Kubudak90/openduck-tr/docs/workflow/openduck-tr/review-komut.md

# Review: Spec eki K (sesli komut katmanı)

Codex MCP bu oturumda bağlı değil. İnceleme, ana spec incelemesindeki yöntemle aynı bağlam paketi kullanılarak üç
bağımsız inceleyiciyle yapıldı:
- donanım, elektrik, akustik ve BOM;
- RL ve simülasyon;
- kapsam, kabul ve firmware devri.

Format zorunluydu: `[SEV] itiraz + somut senaryo + öneri`. Ham itirazlar: `research/review-komut-r1.json`.

## Tur 1: 43 itiraz (2 critical, 30 major, 11 minor) → kararlar

| İtiraz | SEV | Özet | Karar | Ek v2'ye etkisi / gerekçe |
|---|---|---|---|---|
| R1 | critical | K6.1 adds the gestures to the HEAD_RANDOM sampling, so they become head_target and pass through the existing first-order head filter (filter_tau 0.5 s at 50 Hz: TASK.md main step 2, and the tr35 HEAD_RANDOM in the core config). Th… | **Kabul** | K6.1: filtreyi atlayan jest kanalı, yükseltilmiş kosinüs zarf, slew assert, rastgele hedef jestte 0. |
| R2 | major | K6.2 runs the supervisor inside main training, and main is trained on MJX/Brax (P7/P9). K5 defines rl/commands.py as a firmware-copied state machine (queue, timers, IMU yaw integral, random word and latency draws) with CPU-only un… | **Kabul** | K6.2: denetleyici bölümleri kaldırıldı; xp-genel komut atomları sample_segment içinde; commands.py numpy (eval/play/firmware). |
| R3 | major | S1 chains a seated stand-up, about 35 s of walking and turning, and a sit, yet it has the same threshold as one A5 transition (point ≥ 95 %, W-lower ≥ 90 %). S2 allows only 2 falls in 256 episodes of 20 random words. A policy that… | **Kabul** | K7: S1 eşiği bileşenlerden türetildi (nokta ≥ %85, W-alt ≥ %80). |
| R4 | major | "main kalkış/oturuş bitince" and "rampa bitince" are undefined. Read as the reference ramp (alpha reaching 0 or 1, h_ref reaching h_cmd), they finish on the command side in 2.83 s or 0.66 s whatever the body does. S1's "every step… | **Kabul** | K5 T1/T2: IMU ile fiziksel tamamlanma, A5 pencereleri, bir yeniden deneme, sonra DÜŞMÜŞ. |
| R5 | major | The fall detector ("same threshold as TERMINATION_MAX_GRAVITY_Z, from the IMU observation") is a third definition, next to C.SUPERVISOR (fall_gz −0.6, fall_steps 6 in tr35) and play.Supervisor. A6's handover is measured with play.… | **Kabul** | K5: play.Supervisor mantığı commands.py'ye; C.SUPERVISOR debounce; oturuşta duruşa göre eğim. |
| R6 | major | A10 needs the getup handover in the same rollout. The existing handover eval (tr35_handover) does this by running main on the getup model variant, where the EXTRA leg boxes collide with the floor (contype 0, conaffinity 1). main w… | **Kabul** | K6.4: A10 main varyantında, düşmede tr35_handover ile getup varyantına; EXTRA temas kararı P5b'de, P7'den önce. |
| R7 | major | The module's location and mass go into the MJCF. The addendum leaves placement to P2d without ordering it against G-CAD, P5b and P7, and it lets G-SES (a bench gate that runs after G-CAD) move the module ("first try placement and … | **Kabul** | K3/K9: P2d G-CAD'den önce; kütle şimdi kafaya yazılır; G-CAD sonrası yer değişmez. |
| R8 | minor | The claim is false. The main actor observation (53 values) holds only the head joint q/qd measured by the pots, not the targets. The beak is neither measured nor observed: sensors.py says "Gaga olculmez (gozlemde de yok)", and P5a… | **Kabul** | K6.1: gözlem değişmez; jest pot q/qd ve IMU ile hissedilir, gaga gözlenmez. |
| R9 | minor | The wake tick fires on every "ördek", and vak is allowed in every state except DÜŞMÜŞ. Training moves the beak only in stand and walk segments (K6.1), and getup never sees beak motion. | **Kabul** | K4/K5: uyanma işareti LED; vak M'de ≤ 15°, O/K/F'de red; gaga şablonu oturuş segmentlerinde de; A8 A10'a eklendi. |
| R10 | minor | "h changes with main's existing 2.83 s ramp" is wrong. 2.83 s is SIT/STAND_RAMP_S, the ramp for alpha. h_ref follows the command at H_RATE = 0.02 m/s, which tr35_constants does not rescale. One ΔH step is also about as large as th… | **Kabul** | K4: H_RATE ile; ΔH = (H_HOME − H_MIN_WALK)/2; S1 ölçütü ≥ 0.5·ΔH. |
| R11 | minor | A single p90 inside [0.7, 1.3] does not bound the low tail. The addendum also does not say when the turn error is measured, or whether "distance" means path length or displacement. | **Kabul** | K7: başlangıç yönünde yer değiştirme, p10 ≥ 0.7 ve p90 ≤ 1.3; dönüş hatası bitişten 1 s sonra. |
| R12 | minor | Recognition latency only shifts when a command is applied. The policy never observes it, and no A10 metric depends on it: gel is timed and the turn ends on the IMU, both from the moment of application. So the DR tests nothing, yet… | **Kabul** | K6.3: gecikme DR'ı yalnız eval; yeni ölçüm yeniden eğitim gerektirmez; dur duruş mesafesi ölçütü. |
| R13 | minor | The turn stops on the integral of the sensor-model gyro, whose bias is U(±0.01 rad/s) after power-on calibration. On the robot the IMU sits 1.8 mm in front of the buck (P2b) and warms up after boot, so the bias the sim validates i… | **Kabul** | K5: sıfır hız bias güncellemesi; A10 duyarlılık koşusu ±0.04 rad/s. |
| S1 | major | Jest şablonları 'HEAD_RANDOM örneklemesine' eklenirse kafa hedefi env'deki birinci derece filtreden geçer (spec 3.2.5 ve tr35_constants: filter_tau 0.5 s; env_cpu: head_offset += (target − offset)·CTRL_DT/τ). Ayrık filtrenin kazan… | **Kabul** | R1 ile aynı karar; gaga ayrı kanal. |
| S2 | major | Durum × komut tablosu eksik ve deterministik değil. - Kural 2 yalnız OTURMUŞ'u kapsıyor. OTURUYOR ve KALKIYOR'da gelen kalk, otur, gel, dön ve dur için davranış tanımsız: komut yok mu sayılır, kuyruğa mı girer, rampayı ters mi çev… | **Kabul** | K5: 8 durum × 13 olay tablosu; birim testler satır satır. |
| S3 | major | Düşme algılayıcısında dört sorun var.  1. **Ayrı ve debounce'suz tanım.** 'TERMINATION_MAX_GRAVITY_Z ile aynı eşik' deniyor, ama ardışık adım beklemesi (debounce) yok. Mevcut çalışma zamanı süpervizörü (play.py Supervisor, meta["s… | **Kabul** | K5: tek düşme kaynağı; getup 2 deneme sonra BEKLE; dur getup'ı keser. |
| S4 | major | S2'nin düşme eşiği (W-üst ≤ %3, N = 256) maruziyete göre A4 ve A5 ile çelişiyor. - **A4:** N = 512 ve 20 s'lik bölümlerde W-üst ≤ %3, en çok 7 düşmeye izin verir (bölüm başına %1.37). - **S2:** N = 256'da W-üst ≤ %3 ancak en çok 2… | **Kabul** | K7 S2: düşme 20 s maruziyete normalize; geçiş düşmeleri A5 eşiğiyle; ayrı devir kategorisi. |
| S5 | major | S1 ölçütleri test edilemez ya da tekrarlanamaz.  (a) **Zaman çizelgesi yok.** Kelimeler arası süre yazılmamış; yalnız 'gel (8 s)' var. Sonraki kelime önceki adım bitince mi, sabit aralıkla mı verilir? 8 s kelimeden mi, uygulamadan… | **Kabul** | K7: zaman çizelgesi (tamamlanmadan 1.0 s sonra), gel/dönüş tanımları. |
| S6 | major | commands.py hem eğitime hem firmware'e 'tek tanım' olacak, ama ikisi için de eksik tanımlanmış.  **Eğitim tarafı.** K6.2 denetleyiciyi main eğitimine sokuyor; P7/P9 eğitimi MJX + Brax PPO ile jit/vmap altında RunPod'da koşuyor. Py… | **Kısmen** | Altın izler ve yalnız firmware sinyalleri kabul. Denetleyici eğitime girmediği için (R2) xp-genel/MJX sürümü gerekmez. |
| S7 | major | **Ana spec ile çelişki.** Ana spec §2 'Kafa elektroniği (kamera, hoparlör, ToF)' öğesini kapsam dışı sayıyor. DF2301Q kafa kubbesine konursa kafa elektroniği olur, üstelik kartta bir hoparlör taşır. Ekin kendi kuralı 'Çelişki çıka… | **Kabul (kafa)** | §2 istisnası yazıldı. Varsayılan trunk önerisi H3 kanıtıyla reddedildi: trunk'ta yer yok. |
| S8 | major | **Robot kütlesinin sert sınırı hesaba katılmamış.** - P2c raporunda robot toplamı 1845.4 g (×1.05 = 1938 g). acik-konular.md'de 1847.9 g → 1940 g, 'sınırın 10 g altında'. - Modül 12 g, teller yaklaşık 2.5 g eklerse: (1845.4 + 14.5… | **Kabul** | K3.1: modül aşağıdan yukarı kütlede; G-CAD ≤ 1950 g, aşarsa merdiven. |
| S9 | major | G-SES denemesi gerçek kullanımı temsil etmiyor.  (a) **Yanlış servolar test ediliyor.** Yük testi '6 DS servo' ile yapılıyor. Oysa mikrofona en yakın gürültü kaynakları head linkindeki head_roll MG90S ve gaga SG90 ile head_turn'de… | **Kabul** | K8: gürültüde MG90S + SG90 + DS; protokol ördek → LED → komut; 1.3/1.8 m. |
| S10 | major | G-SES kapısının eşikleri istatistik olarak zayıf ve tehlikeli karışmaları görmüyor.  (a) **Kelime başına mı, havuzda mı?** '≥ %90' belirsiz. Havuzda 216/240 geçerken tek bir kelime 15/20 = %75'te kalabilir; bu kelime dur olabilir.… | **Kabul** | K8: kelime başına ve havuz eşikleri, karışma çiftleri, 30 dk uyanık test, Poisson sınırı. |
| S11 | major | Plan etkisinde sıra ve bağımlılık eksik.  (a) **P2d tamamlanmış P2c'yi yeniden açıyor.** P2c bitti (200.2 g, tests/cad 88/88, check.py 0); P2d kafa kubbesini yeniden açar. P2d hem G-CAD'deki kütle/COM dondurmasından hem P5b türetm… | **Kabul** | K9: P5k şimdi; P2d → P3 → G-CAD; ölçümler Adım 0 alımında. |
| S12 | major | Kullanıcıya dönük davranışta dört boşluk var.  (a) **Yok sayılan komut sessiz.** Hoparlör kapalı, modülün mavi LED'i kabuğun içinde. Kullanıcı OTURMUŞ'ta 'evet' ya da dönüşte 'eğil' dediğinde, komutun tanınmadığını mı yoksa redded… | **Kabul** | K5: red işareti (LED + çift tık), pencere bitişi LED; sim uyanma modeli; gel zaman aşımı 10 s. |
| S13 | minor | Kural 5'teki 'h, main'in mevcut 2.83 s rampasıyla değişir' ifadesi yanlış. 2.83 s, alpha'nın SIT_RAMP_S/STAND_RAMP_S rampası. h_ref ise h_cmd'yi H_RATE = 0.02 m/s hızıyla izler (posture_step); bu hız tr35'te ölçeklenmiyor. Stub de… | **Kabul** | R10 ile aynı. |
| S14 | minor | (a) **Jestler gereksiz yere walk'a ekleniyor.** K6.1 jestleri walk politikasına da ekliyor. Denetleyicinin çıktısı yalnız main / getup; walk sesli katmanda hiç kullanılmıyor. Bu değişiklik walk'ın A4 ölçütlerini, 'main takip ödülü… | **Kabul** | K6.1: jestler yalnız main; vak M'de ≤ 15°, gaga şablonu oturuşta; jaw çifti P5b listesinde. |
| S15 | minor | ID'ler K4'te sabit 5–16 olarak kabul ediliyor. Oysa DF2301Q ID'leri öğrenme sırasına göre veriyor. Yeniden öğrenme akışı ('önce sil') doğrulanmamış (voice-research 1.1). Sabit ID tablosu da cihaz cihaz değişmiş (DFRobot forum 4018… | **Kabul** | K4: kimlik tablosu yapılandırma dosyası, beyaz liste, doğrulama adımı. |
| H1 | critical | Ek 1.171,86 TL'lik yeni zorunlu satır ekliyor, ama bugünkü BOM toplamını ve kalan payı vermiyor. Son hesaplanan toplamlarla iki tavan da aşılıyor. "Bütçe tavanı değişmez, P3 yeniden hesaplar" ifadesi A2'nin düşmesini P3'e erteliyo… | **Kullanıcıya** | Bütçe kararı kullanıcının (K10). |
| H2 | major | Tercih edilen kafa yerleşiminin ilk koşulu ("kafa kütle bütçesi ... modülle birlikte tutmalı") yapısı gereği tutmaz. P2c kafası 202,0 g bütçeye karşı 200,2 g, yani pay 1,8 g. P2d tercih edilen yeri bir bütçe kaydı yüzünden reddede… | **Kabul** | K3.1: trunk'tan kafaya 20 g (202 → 222 g); MG90S ≤ 0.5·stall. |
| H3 | major | Yedek yer olan "trunk arka üstü" donmuş K_T içinde yok. K_T dışında ise kafanın süpürme bölgesinde kalıyor. K_T'yi değiştirmek bir arayüz değişikliğidir (ICR), P2d'nin kendi kararı değil. | **Kabul** | K3: trunk seçeneği kaldırıldı; tek yer kafa. |
| H4 | major | Kafa kubbesi "bacak servolarından uzak" olduğu için seçiliyor; oysa mikrofona en yakın gürültü kaynakları kafanın kendi servoları. Kabuk açıklığı için sızdırmazlık ve titreşim yalıtımı tanımlanmamış. | **Kabul** | K3.3: conta, beşik/gromet, köpük kart çevresine, mesafe raporu; G-SES'te kafa servoları. |
| H5 | major | G-SES Adım 0'da yürütülemez; yürütülse bile gerçek yerleşimi temsil etmez. "DF2301Q kalır" kararı, P2d CAD'inden önce ve temsil gücü olmayan bir testle verilmiş oluyor. | **Kısmen** | G-SES a/b ayrımı kabul. Hoparlörden kayıtlı gürültü yerine Adım 0'ın gerçek MG90S/SG90/DS'si kullanılır (daha temsilî). |
| H6 | major | Yanlış tetik ölçümü yalnız uyku durumunu kapsıyor; asıl tehlikeli olan, uyanık pencerede servo gürültüsünün ürettiği yanlış komut ölçülmüyor. ≤ 1/10 dk ölçütü istatistik olarak zayıf. Uyandırma + komut zinciri ve uzun süreli çalış… | **Kabul** | K8: uyanık pencerede 30 dk, zincir ölçütü, Poisson. Pil süresi koşusu G-SES-b'ye kaldı. |
| H7 | major | Öğrenilmiş Türkçe kelimelerde karışma riski en yüksek olan çiftler zıt hareketler. Kapı ölçütünün toplam mı kelime başına mı olduğu belli değil; karışma matrisi ve konuşmacı bağımlılığı ele alınmıyor; boş 5 slot kullanılmıyor. | **Kısmen** | Kelime başına ve karışma kabul; boş kimliklere ikinci şablon kabul. N kelime başına 20 (kullanıcı süresi ~1.5 sa); 40 yerine Wilson havuz eşiği. |
| H8 | major | Uyandırma akışının zamanlaması doğrulanmamış davranışlara dayanıyor. "ördek, gel" tek nefeste söylenirse komut modül uyanmadan gelir. Onay tıkı tam komut penceresinde gürültü üretir. 15 s pencerenin geçerli komutla yenilenip yenil… | **Kabul** | K4/K8: LED birincil işaret; aralıksız ve işaretli biçim; pencere yenilenmesi, NOTIFY ve kalıcılık ölçülür. |
| H9 | major | Modül kafadaysa 4 tel yalnız boyun geçişinden değil, dört eklem geçişinden geçer. Demet çapları donmuş arayüzdür; ek bunu P2d'nin yerel güncellemesi gibi yazıyor. | **Kabul** | K3.6: dört geçişin yeni çapları ICR olarak; 30 AWG, bükülü çift, burulma taraması. |
| H10 | major | Revizyon ve ölçüler doğrulanmadan CAD donuyor. P2d yerleşimi ve kabuk deliklerini P3'ten önce yapıyor, oysa ek kütle ve yüksekliğin "P3'te tartılıp ölçüleceğini" söylüyor. Delik deseni V1.1'e sabitlenmiş, yedek kaynağın görseli is… | **Kabul** | K3: modül şimdi alınır, ölçülür; beşik iki revizyona uygun; ölçü yoksa muhafazakâr zarf. |
| H11 | major | ID → komut haritası rl/commands.py'de sabit (5 = gel … 16 = vak). Oysa kimlikler öğrenme sırasıyla atanıyor ve tek bir kelime yeniden öğretilince hangi kimliği alacağı bilinmiyor. 12 komut dışındaki kimliklerin nasıl işleneceği de… | **Kabul** | K4: kimlik tablosu, beyaz liste, 200–208 uyarısı. |
| H12 | major | 3,3 V / 5 V kararı ölçüm yapılmadan P3'e bırakılmış ve 3,3 V ray bütçesi yazılmamış. 5 V için öngörülen TX bölücüsü, TX zaten 3,3 V ise bağlantıyı bozar. Modülün RX eşiği hiç ele alınmamış. "(hoparlör açık)" niteliği kaynakta yok. | **Kabul** | K3: 5 V ayrı dal; seviye ölçülen TX'e göre; akım ve RX ölçümü G-SES-a'da. |
| H13 | major | "ESP32-S3'ün boş bir UART'ı" pin atamasını vermiyor. Çevre birimi olarak UART1/2 boş, ama robot pin haritasında çakışmasız boş pin neredeyse yok ve kayış (strapping) pinleri dışlanmamış. | **Kısmen** | Kısıtlar kabul (kayış pinleri ve 43/44 yasak, 1 kΩ). Pin seçimi P6 ekinde pin haritasıyla birlikte; tezgâh aynı pinleri kullanır. |
| H14 | minor | Dönüş, gyro z integraliyle ölçülüyor. Simdeki gyro bias DR'ı, açılış kalibrasyonundan sonra ±0,01 rad/s; ama IMU buck'a 1,8 mm uzakta ve ısınıyor. Donanımdaki sapma simdekinin birkaç katı olabilir ve A10 S1 bunu göstermez. | **Kabul** | R13 ile aynı. |
| H15 | minor | Ana spec §2 "Kafa elektroniği (kamera, hoparlör, ToF)" maddesini kapsam dışı sayıyor. Ekin tercih ettiği yer, hoparlörü kartta kalan bir elektronik modülü kafaya koyuyor. Ekin kendi öncelik kuralına göre ("çelişki çıkarsa ana spec… | **Kabul** | S7 ile aynı. |

## Tur 2 (son tur): 27 itiraz (critical yok, 17 major, 10 minor) → kararlar

Yeni critical itiraz çıkmadığı için aşama bitti. Tur 1 kararlarından v2'de eksik uygulanmış bulunanlar v3'te
tamamlandı: LED, P6 eki ön koşulu, jaw çifti, G-SES-b, R1 sönümleme, R4 gerçek durum puanlaması, R5 eğitim
sonlandırması, R12 kelime bitişinden ölçüm, bias eşiği, Ö durumu ve B tanımı. Ham liste:
`research/review-komut-r2.json`.

Eksik uygulanan tur 1 kararları:
- R12 (Kabul: 'dur duruş mesafesi ölçütü'). K7 measures the dur stopping distance 'uygulamadan duruşa' (from application). R12 asked for 'from the end of the spoken word to standstill', so the latency is part of what is measured. Every other A10 metric (gel rati…
- S14 (Kabul: 'jaw çifti P5b listesinde'). The K9 P5b item only says 'P5k on the final MJCF; move A10 to the final model'. It does not add P2c's jaw–neck contact pair (the open ICR) to the P5b self-collision pair list. Meanwhile K5 still allows vak in OTURMUŞ (≤…
- R9 (Kabul: 'gaga şablonu oturuş segmentlerinde de'). K6.1 says this, but the same bullet list says 'Alpha kapısı rastgele ofsetle aynıdır' (alpha < ALPHA_STAND_MAX = 0.01). If that gate also covers the mouth channel, the beak is zeroed in every sit segment (al…
- S12 + H8 (R9'daki uyanma işareti de buna bağlı). Karar şuydu: red işareti LED + çift tık, pencere bitişi LED, LED birincil işaret (H8'in önerisi ESP32'nin sürdüğü bir LED idi). v2 K3.5 bunu modülün kendi mavi durum LED'iyle yapıyor ve 'ek parça gerekmez' diyor…
- H5 (kısmen) / S9. Karar, G-SES-a gürültüsünü Adım 0'ın gerçek MG90S + SG90 + DS'siyle üretmekti. tools/bench/bench/bench_main.cpp yalnız tek bir PCA kanalı sürüyor (C.ch). K9'daki P6 eki yalnız şunları ekliyor: UART okuma, kimlik zaman damgası, senkron tık ve …
- S14. Karar metni 'jaw çifti P5b listesinde' diyor. v2'de bunun karşılığı hiçbir yerde yok (K6, K9'daki P5b satırı): ne jaw–neck / jaw–trunk temas çifti (P2c ICR'si) ne de 'head_pitch > 50° iken mouth ≤ 25°' kilidi.…
- H6. Karar, pil süresi koşusunu ve koşu sonu canlılık kontrolünü G-SES-b'ye bıraktı. v2 K2, G-SES-b'yi yalnız 'robot üstünde son yerleşimle tanıma testi' olarak tanımlıyor. Ertelenen koşu ekte hiçbir yere yazılmamış, bu yüzden kaybolur.…
- R1: v2 still does not say how a running gesture stops without a position step. The table only says dur 'jest kesilir', and otur and a fall act through the alpha gate. This is the gap R1 raised. The S1 amplitude measure also lost R1's 'pot q peak-to-peak vs tem…
- R4: A10 scores each step with the controller's own IMU completion (K7: 'K5'in fiziksel ölçütleriyle'). R4 proposed A5's true-state success rules (standup_z, stand_gz, windows). The T2 condition gz_obs < seat_gz (−0.245 on the stub) is met by almost any pose th…
- R5: the note to P5b is missing. Main's training termination still uses the fixed gz > −0.6 rule. A seated stub has gz −0.643, and the seated bank's ±5° tilt crosses −0.6. v2 changes only the runtime detector.…
- R12: K7 measures the dur stopping distance from application. R12 proposed measuring from the end of the spoken word. The latency part that motivated R12 (up to 1.5 s × 0.136 m/s = 0.20 m) is therefore excluded, while the 0.3 m threshold stayed.…
- R13/H14: the zero-velocity bias update uses |gyro| < 0.02 rad/s, which equals sensors.IMU gyro_sigma (0.02 per axis, uniform ±0.035). It essentially never fires in sim, so the accepted fix does not work (see 2S5).…
- S2: the exact S2 case, a word arriving during the 'dur + 1.0 s' settle before sitting, still has no column. The O→M completion cell does not say what happens to a command queued in O (see 2S6).…
- S3: item 4 (commands that arrive during handoff_zero_cmd_s after the handover) is not addressed: F→A accepts them at once. BEKLE's output 'tut' is left undefined, although S3 asked for a defined hold (HOME hold or torque off) (see 2S9).…
- S11(e): K9 does not make the P6 bench-script addendum a prerequisite of Adım 0 / G-SES-a, although K8 needs it.…
- S14(c): the decision table says 'jaw çifti P5b listesinde', but v2 has no jaw–neck or jaw–trunk contact-pair item for P5b.…
- H6(c): v2 has no firmware liveness check for a silent module ('stops working after a few minutes'; begin() returns true with no module attached).…
- H8: H8 asked for an ESP32-driven LED visible through the shell. v2 (K3.5) uses the module's own status LED, which no known API lets the host blink. The K5 red blink and the 'LED durumu' output therefore cannot be implemented (see 2S8).…

| İtiraz | SEV | Özet | Karar ve ek v3'e etkisi |
|---|---|---|---|
| 2R1 | major | T1 (kalkış tamamlandı) cannot complete inside its own 3.4 s window. alpha reaches 0 only at the end of the stand ramp: tr35 STAND_RAMP_S = 2.5·√1.282 = 2.83 s, which is 142 control steps or 2.84 s bec… | Kabul: T1 ilk sağlanma ≤ 3.4 s + ready_hold_s, sert sınır ≈ 3.9 s; S1 otur/kalk A5 gerçek durum kurallarıyla. |
| 2R2 | major | The zero-velocity gyro-bias update is gated on '/gyro/ < 0.02 rad/s for ≥ 1 s'. That threshold is at or below the sensor model's own noise floor, so in simulation the update never fires. This is worst… | Kabul: bias güncellemesi dağılım ölçütüyle (std < 2σ, bacak qd, sıfır komut); gerçek sensör modeliyle test. |
| 2R3 | major | In KALKIYOR the new fall rule ('tilt > 35° from pitch_ref(alpha)') fires on the main stand-up failure mode, which R4 described as rocking back onto the seat. That happens before the timeout-and-retry … | Kabul: O/K/M'de düşme, hem pitch_ref hem oturuş pozundan > 35°; oturuşla uyumlu duruş başarısız kalkış. |
| 2R4 | major | The gesture channel has no smooth stop, and its gate is self-contradictory. K4/K5 say 'dur … jest kesilir' (immediately), and K6.1 gives gestures 'the same alpha gate as the random offset'. Because th… | Kabul: tek xp-genel jest fonksiyonu; kapı yalnız başlangıçta; 0.25 s sönümleme; hız toplam çıktıda. |
| 2R5 | major | 'Her oturuştan önce ≥ 1 s ayakta segment' makes every trained sit start from h = H_HOME. The stand segment sets h = H_HOME (TASK.md, sample_segment), and a sit keeps the previous h. The pre-v2 sampler… | Kabul: "tut" segmenti önceki h ile; çömel → otur korunur; otur A'da 1.0 s kuralını bekler; uniform kullanımı yazıldı. |
| 2R6 | minor | The S1 gesture and height criteria are not well defined. A raised-cosine envelope over the whole 2-cycle gesture means the commanded peaks are only 0.146, 0.854, 0.854 and 0.146 of the table amplitude… | Kabul: Tukey zarf; ölçüt ortadaki çevrimin tepeden tepeye oranı, p10; eğil/yüksel 1 s sonra, p10. |
| 2R7 | minor | A6's handover and A10's handover now run different contact setups. K5 says 'A6 devri bu IMU tabanlı algılayıcıyla yeniden koşulur'. But the existing tr35_handover (P5a deploy branch rl/eval_tasks.py ~… | Kabul: A6 devri A10 düzeneğinde yeniden; kopya anı EXTRA–zemin girişimi kaydı. |
| 2H1 | major | v2 kullanıcıya verilen bütün görsel geri bildirimi modülün kendi mavi LED'ine bağlıyor: uyanık pencere, red ve pencere bitişi. Ayrıca 'ek parça gerekmez' diyor. ESP32 bu LED'i süremez, çünkü DF2301Q'n… | Kabul: ESP32 sürümlü kafa LED'i (5. iletken); modül LED'i ikincil. |
| 2H2 | major | 30 dk'lık uyanık pencere yanlış komut testi, modülün gerçekten uyanık kaldığını ölçmüyor. 'Pencere 255' ayarı en çok 255 s sürer. Pencerenin yenilenmesi tek bir forum anekdotuna dayanıyor: UART'tan he… | Kabul: uyanık süre doğrulanır (NOTIFY ya da fototransistör), canlılık kontrolleri, "ölçülemedi" sonucu. |
| 2H3 | major | Hoparlör hem setMuteMode(1) ile hem de SPK anahtarıyla susturuluyor: anahtar SPK2'ye alınıyor ve oraya hoparlör bağlı değil. Ayrıca sökülmesinin kazancı tartılıyor. DF2301Q'da öğrenme ve silme akışı s… | Kabul: hoparlör kartta, SPK1 sabit, yazılımla susturma; öğrenme modu; istem duyulabilirliği testi. |
| 2H4 | major | ICR neck demetini d 5 → 6 mm yapıyor ama donmuş geçiş noktasını (33.33, −34.4, 41.54) değiştirmiyor. Bu durumda demet boyun U-link'inin A kolunun dış yüzüne 0 mm açıklıkla dayanır. P2c'de A kolunun dı… | Kabul: çap gerçek iletken listesinden, ≥ 0.4 mm açıklık, gerekirse geçiş noktası kaydırılır; P2d'ye dosya yetkisi. |
| 2H5 | minor | Mikrofon contası 'TPU' olarak tanımlanmış; projede kullanılan TPU 95A (spec §3.1). 95A TPU akustik frekanslarda neredeyse rijittir. Conta, kartı servoları taşıyan kabuğa tam kapsülün yanında bağlar ve… | Kabul: yumuşak conta (PORON / ≤ 40A silikon), beşik f_n ≤ 100 Hz. |
| 2H6 | minor | Trunk'tan aktarılan 20 g, v2'nin kendi eklediği parçalar sayılınca neredeyse sıfır paya iniyor. Ayrıca zarf, konnektör fişini ve kablo çıkışını içermiyor. | Kabul: aktarım 30 g (kafa 232 g); yan kalemler ayrı satır; fiş yer ayırma kutusu ya da doğrudan lehim. |
| 2H7 | minor | BOM satırı yalnız modülü ve kargoyu sayıyor. v2 yeni zorunlu kalemler ekliyor ama bunları listelemiyor: - 30 AWG silikon tel. Mevcut BOM'daki 30 AWG tel potlar için alınan Kynar wire-wrap'tır ve head_… | Kabul: BOM yan kalemleri K3 tablosunda; tam fark K10 tavanına sığmalı. |
| 2S1 | major | The controller, which firmware copies verbatim, itself drops commands outside '15 s after ördek, not renewed'. That rule is the sim's conservative model of the module. Placed in commands.py, it makes … | Kabul: pencere filtresi denetleyiciden çıkarıldı, yalnız A10 modül modelinde; dur asla düşmez. |
| 2S2 | major | T1 cannot finish inside its own window, and the retry does nothing. With tr35 constants the alpha ramp needs ceil(2.83/0.02) = 142 steps (2.84 s). T.hold_timer then needs 29 more steps for ready_hold_… | Kabul: T1/T2 yeniden tanımlandı; yeniden deneme gerçek eylem (oturuşa dönüş → yeniden kalk). |
| 2S3 | major | The recovery path that v2 introduces starts getup from seated and half-seated poses. Getup never trained on them, and neither A6 nor A10 measures them. The path is: a T1/T2 failure, or a tilt of more … | Kabul: geçiş hataları getup başlatmaz; oturuşa dönüş, sonra B ve red. |
| 2S4 | major | 'Alpha kapısı rastgele ofsetle aynıdır' works for the random offset only because that gate is applied before the τ = 0.5 s filter. The gesture skips the filter, so the same gate becomes a hard step. v… | Kabul: 2R4 ile aynı; gaga alpha = 1'de ≤ 15° ile izinli. |
| 2S5 | major | The stillness test (/gyro/ < 0.02 rad/s for at least 1 s) sits at the sensor model's own noise level, so the accepted bias update essentially never runs. sensors.IMU gyro_sigma is 0.02 rad/s per axis,… | Kabul: 2R2 ile aynı. |
| 2S6 | major | Two stateful gaps remain in the table. (a) Queue lifetime: a command queued in O is never consumed. O's completion cell is only '→M', M's is '—', and only dur clears the queue. So the command survives… | Kabul: Ö sütunu; O→M bekleyen kuralı; kuyruk temizleme olayları; değişmez. |
| 2S7 | major | Each S2 word comes U(1, 6) s after the previous command completes, so no word is ever spoken while a command is running. Every S2 word lands in A or M (or F/B after a fall), and gel always runs to its… | Kabul: S2 kelimeleri uygulamadan U(1,6) s; başlangıç 50/50; hücre kapsaması ≥ 20. |
| 2S8 | major | v2 dropped H8's ESP32-driven LED in favour of the module's own blue status LED ('ek parça gerekmez'). No known DF2301Q host API drives that LED; voice-research lists getCMDID, playByCMDID, setWakeTime… | Kabul: 2H1 ile aynı. |
| 2S9 | minor | The getup states lack entry and exit actions. (a) BEKLE's output 'tut' is undefined: last getup ctrl, HOME, tuck, or PWM off. (b) On F→A (devir) the controller does not reset its own h_cmd, sit or pen… | Kabul: B tanımlandı; F→A giriş eylemi; devir süresince kelimeler kuyrukta. |
| 2S10 | minor | The golden traces are 'olay dizisi → çıktı dizisi', but half of the transitions depend on per-step sensor inputs: T1/T2, the fall debounce, the gyro integral, the bias window and the timers. A trace o… | Kabul: adım adım altın izler, float32, ayrık birebir / sürekli 1e-6. |
| 2S11 | minor | A two-cycle raised-cosine gesture never reaches the table amplitude. Its trajectory peaks at 0.870·A (nod 0.174 of 0.2 rad, shake 0.348 of 0.4 rad), its full peak-to-peak is 1.74·A, and the 2nd-cycle … | Kabul: 2R6 ile aynı. |
| 2S12 | minor | 'Gerektiğinde ördek yeniden söylenir' gives no rule. In S1, 'dur' is spoken about 13.5–16 s after the first ördek is recognized (kalk latency + 3.42 s T1 + 1 s + gel latency + 8 s), right at the edge … | Kabul: yeniden uyandırma kuralı; dur öncesi uyanma; gel zaman aşımı 12 s. |
| 2S13 | minor | The ICR changes the frozen params.harness diameters that the finished P2b and P2c geometry and tests depend on, yet K9 gives P2d only the head dome. With neck d 5 → 6 mm, the neck entry tube reaches y… | Kabul: 2H4 ile aynı. |

## Kullanıcı kararı

H1 (bütçe): tavan yükseltildi, zorunlu ≤ 25.800 TL ve yedeklerle ≤ 28.800 TL (2026-10-24, ek K10).
