Kubudak90/openduck-tr/docs/workflow/openduck-tr/research/review-r2-objections.md

## Role: fresh

Overall: Son tur incelemesi: 10 itiraz çıktı (1 critical, 7 major, 2 minor). Kullanıcı kararlarına itiraz etmedim. Repoya dokunmadım. Hesap betikleri /private/tmp/claude-501/-Users-huseyinarslan-Desktop-ads-z-klas-r-2/8217cd75-2c54-4fa4-b47f-57c38ee96c2b/scratchpad/s10/final-reviewer/ klasöründe:
- bom_v2.py: iki DS adayı için BOM toplamı
- gate_v2.py: κ kapısı, kabul DR'ı, diz ısıl tahmini
- wilson.py: Wilson eşikleri
- stab.py: sert servo kararlılığı

**Sorun bulmadığım alanlar:**
- **κ kapısı:** Artık kendi içinde tutarlı. Blue 1.95 kg'da κ 0.5 için ω0 ≥ 4.98 istiyor, 5.72 geçiyor. Kapının sınırında kabul DR'ının (±%15) yalnız %0.3–0.4'ü u > 1 veriyor.
- **main zaman pencereleri:** 2.5 × 1.132 = 2.83 s rampa; pencereler 3.40 → 3.7 s ve 3.96 → 4.0 s.
- **hip_pitch sınırı:** −70…+90, bir diş ofsetiyle 5° payı koruyor.
- **Sert kp kararlılığı:** 5 ms adım ve örtük sönümle DR köşelerinde de kararlı.
- **Sigorta ve XT30 akımı:** ~10.7 A, sorun yok.

**Planı en çok tehdit eden üç nokta:**
1. **Diz ısıl ölçütü (F1):** Research'e göre A1'in izin verdiği her kütlede diz RMS 1.05–1.11 N·m, eşikler ise 0.78–1.02. İki aday da düşüyor. Listelenen çıkışlardan Red stokta doğrulanmadı; 'daha az büken HOME' ise donmuş CAD'i bozuyor. Kabul eğitiminden önce bunu yakalayan bir kapı yok.
2. **Kütle (F2):** Aşağıdan yukarı tahmin ≈ 2.0–2.1 kg, 1.95 sert sınırının üstünde. Sınır aşılırsa ne yapılacağı tanımlı değil; G-CAD bloke olur.
3. **Bütçe (F3):** Zorunlu toplam 23.835 TL (DS3225) / 23.971 TL (Direnc), 23.5k sınırının üstünde. Yedeklerle 26–27k. Yedek listesi ve Adım 0 hesabı tanımsız, birkaç satırın stok kaynağı yok.

**Kabul ölçütlerindeki diğer açıklar:**
- Wilson karşılaştırıcısı ve A5/A6 bölüm sayısı tanımsız (F4).
- Getup kapısı karar verilebilir değil (F5).
- Limit torku metriği boşluk eklemi ve build_spec'in range sıfırlamasıyla çakışıyor (F6).
- Eğitimde öz-çarpışma yok ama A8 ölçüyor (F7).
- Ray akımı modeli duty çarpanını atlıyor ve akımı fazla tahmin ediyor (F8).

**Minor:**
- A7'nin büyük aktör dalı tanım gereği düşüyor (F9).
- Gerekli aralık tablosunda hip_roll ve boyun eksik ya da belirsiz; hip_yaw içe dönme sınırı main ile çelişiyor (F10).

- [SEV: critical] **fresh/F1** (§6 A4 (diz ısıl), §6 A1 (kütle ≤ 1.95), §5.1, §7 karar tablosu (Isınma, Kazanan DS)) A4'teki 'diz τ_net RMS ≤ ısıl eşik (varsayılan stall/3)' maddesi, A1'in izin verdiği her kütlede ve iki DS adayının ikisinde de research sayılarına göre geçmiyor. Listelenen çıkış yolları ya stokta yok ya da donmuş CAD'i bozuyor, ve kabul eğitiminden önce bunu yakalayacak bir kontrol yok. Karar tablosu eşiği yalnız aşağı çekebiliyor (60 °C üstü → düşür); yukarı çekmeye izin veren bir satır yok.
  Somut senaryo: Diz RMS tahmini 0.30 N·m (27 cm walk-DR) × k, k = (m/0.676)·1.282. Bu, 1.85 kg'da 1.05 N·m, 1.95 kg'da 1.11 N·m eder. Eşikler (stall/3): DS3230 Blue 0.96, Direnc metni 1.02, Robocombo DS3225MG 0.90 (DSSERVO 2.69 N·m), Robocombo metni 0.78. Tork-gereksinim çalışmasında 'lean walk' diz RMS'ini 0.28'de bıraktı, yani tork cezası yükü düşürmüyor. Komut aralığı da RMS'i ancak 0.25→0.31 arasında oynatıyor. Adım 0 DS3225'i seçerse (en ucuzu, en çok stoklu ve κ 0.72 veren aday) A4 en az %17 farkla düşer. DS3230 seçilse de 1.85 kg'da %3–10 farkla düşer. Çıkışlardan 'DS3230 Red' Türkiye'de stokta doğrulanmadı (§4'ü çiğner). 'Dizi daha az büken HOME' ise stand keyframe'ini değiştirir. Bu hem 350 ± 5 mm kafa üstü (A1) koşulunu, hem de G-CAD'den türetilen H_HOME, F tablosu, SEAT ve poz bankalarını geçersiz kılar. Sonuç: walk, main ve getup kabul eğitimleri koşulur, A4 düşer, CAD yeniden dondurulur, üç eğitim baştan yapılır.
  Öneri: G-CAD ile kabul eğitimi arasına bir G-ISIL kapısı koyun. Boru hattı denemesindeki walk/main'in TR-35 diz τ_net RMS'ini ölçün; Adım 0'ın ölçtüğü τs ve gerçek CAD kütlesiyle ölçekleyin. Eşik aşılıyorsa HOME/H_HOME değişikliğini (A1 yükseklik toleransıyla birlikte) kabul eğitiminden önce yapın. Kazanan DS'yi kurala bağlayın: bir aday ancak ölçülen stall/3 ≥ tahmini diz RMS ise seçilebilsin. Eşik formülünü açık yazın: ısınma testi eşiği yukarı da aşağı da taşıyabilsin. Red'i stok doğrulanana kadar çıkış listesinden çıkarın.

- [SEV: major] **fresh/F2** (§4 Kütle, §6 A1, §3.3 G-CAD) 1.95 kg sert sınır, research'ün aşağıdan yukarı tahminiyle v2 eklerinin toplamının altında kalıyor. Sınır aşılırsa ne yapılacağı tanımlı değil; oysa G-CAD 'A1 geçer' şartına bağlı olduğundan RL tamamen kilitlenir. Ayrıca κ kapısı ve ısıl ölçütler 'ölçülen kütle' istiyor, ama bu turda robot üretilmiyor.
  Somut senaryo: R12'de toplam 1.75–1.89 kg; boyun o hesapta ES3054. v2 bunun üstüne şunları ekliyor: boyun DS (+45 g), DS beşik ve U-link braketleri (O6, eklem başına ~+20 g, toplam +180 g), iki hip_yaw döner tablası (4 × 608ZZ ≈ 48 g, mil ve yuvalarla birlikte +40–60 g), ikinci ADS1115, alarm, TVS ve kapasitörler (~15 g), kafa tamponu ve O5'in istediği büyümüş trunk (≈ 495 cm³). Toplam ≈ 2.0–2.1 kg. CAD 2.03 kg çıkar, A1 düşer, G-CAD geçmez. Spec'te önceden belirlenmiş bir kütle azaltma merdiveni ya da 'spec'e dön' kuralı yok. Uygulayıcı ya kütleyi sessizce gevşetir (F1 ısıl sorunu derinleşir: 2.05 kg'da diz RMS 1.17 N·m), ya da plan durur.
  Öneri: Gram değerleriyle bir kütle merdiveni yazın: sabit etli kabuklar, iskeletli U-link, uzatma yerine doğrudan lehim (−20 g), 608ZZ yerine ince kesitli 68xx, dolgu/et parametreleri. Merdivenden sonra hâlâ > 1.95 kg ise RL'den önce spec'e dönülsün. 'Kütle'yi bu tur için 'CAD aşağıdan yukarı kütle × (1 + pay)' olarak tanımlayın ve κ kapısı ile ısıl ölçütler bunu kullansın.

- [SEV: major] **fresh/F3** (§6 A2, §3.1 Güç/Mekanik, §4, §7 Alınacaklar) A2 spec'in kendi parça listesiyle iki DS adayında da tutmuyor ve bugünkü haliyle karara bağlanamıyor. Yedek listesi tanımsız, Adım 0 harcamasının ~25k tavana girip girmediği yazmıyor, birkaç zorunlu satırın da Türkiye'de doğrulanmış stoğu yok.
  Somut senaryo: Research fiyatlarıyla DS dışı zorunlu kalemler ≈ 14.556 TL. Bu toplamın içinde 2 × ADS1115 (619,54), alarm (115), iMAX B6AC (1.797), 9 × Motorobit 25T kol (682), 9 × F623ZZ (682), 4 döner tabla rulmanı (~300, doğrulanmadı) ve PLA (~650, doğrulanmadı) var. Robocombo DS3225MG ile zorunlu toplam 23.835 TL, Direnc DS3230 ile 23.971 TL; ikisi de 23.500 sınırının üstünde. Tipik bir yedek setiyle (1 DS + ES3054 + MG90S + SG90 + 2 kol + 1 rulman ≈ 2,2k) 26,0–26,1k TL çıkıyor; 25k sınırı aşılıyor. Adım 0'da kaybeden DS (~1.03k) hiçbir toplamda yok. Geçmek ancak spec'te yazmayan seçimlerle mümkün: Motorobit kolunu çıkarıp servodan çıkan alüminyum kolu kullanmak (Direnc kutusunun içeriği bilinmiyor) ya da daha ucuz bir şarj cihazı almak. Ayrıca TVS için power-electronics 'stokta bulunamadı' diyor, 16,8 V DC'ye uygun anahtarın (KCD1 12 V) ve 608ZZ'nin doğrulanmış kaynağı yok. Bu yüzden A2'nin 'her satırda mağaza ve stok' şartı da sağlanamıyor (hesap: scratchpad/s10/final-reviewer/bom_v2.py).
  Öneri: Yedek listesini adet adet spec'e yazın. Adım 0 harcamasının (kaybeden DS dahil) tavana girip girmediğini belirtin. Kesintileri önceden seçin: servodan çıkan Al kol; şarj cihazı seçeneği. TVS, anahtar ve döner tabla rulmanı için ya stokta doğrulanmış bir kaynak gösterin ya da alternatif yazın (örneğin zener + MOSFET kırpıcı).

- [SEV: major] **fresh/F4** (§6 A4, A5, A6 (Wilson)) Kabul eşiklerinin Wilson nokta tahminine mi, alt/üst sınıra mı uygulandığı yazmıyor. A5 ve A6 için bölüm sayısı da yok. Aynı politika için iki uygulayıcı zıt hüküm verebilir; ayrıca eşikler N'ye göre yapısal olarak değişiyor.
  Somut senaryo: A4, n = 256: 'Wilson üst ≤ %3' en fazla 2 düşmeye (%0,78) izin verir; 'nokta ≤ %3' ise 7 düşmeye. Arada 3,5 kat fark var. A6, N = 256 ve 27 cm bankasının mod payları (yüz %25, yan %40, sırt %35) ile: 'yüz Wilson alt ≥ %80' için p̂ ≥ 0,906, 'sırt alt ≥ %50' için p̂ ≥ 0,611 gerekir; nokta kuralında bunlar 0,80 ve 0,50. A5 '≥ %95' Wilson alt sınırla okunursa n = 256'da p̂ ≥ 0,98 ister. A4'teki 'dönüş ±%20' maddesinde wz komut değerleri ve ölçüm penceresi hâlâ yok (SC-2). Örnek: A6 getup yüz modunda %88 ile 'geçti' de denebilir, 'kaldı' da (hesap: scratchpad/s10/final-reviewer/wilson.py).
  Öneri: Her madde için karşılaştırılan sınırı açıkça yazın ('Wilson %95 üst ≤ x' ya da 'alt ≥ y'). A5 için N'yi ve A6 için mod başına N'yi verin (mod başına sabit sayıda tabakalı örnekleme). Dönüş için sabit komutlar (ör. wz ∈ {±0.5·wz_max}) ve kararlı durum penceresi tanımlayın.

- [SEV: major] **fresh/F5** (§3.4 Kalkma yapılabilirlik kapısı, §3.3 sıralama) Getup yapılabilirlik kapısı, en pahalı ve en riskli eğitimi koruyan tek adım olduğu hâlde karar verilebilir biçimde tanımlanmamış. 'Kısa koşu'nun bütçesi yok. Kısa koşunun sonucu, tam eğitim için konmuş taban (%50) ile karşılaştırılıyor. Yüz ve yan modları için karar yok. (i) ile (ii)'nin karşılaştırılmasından hangi kararın çıkacağı yazmıyor. Kapının G-BENCH'ten önce mi sonra mı koşulacağı da belli değil.
  Somut senaryo: Yeni strateji 27 cm'de bile hiç eğitilmedi. Örneğin %10 bütçeli bir kısa koşuda sırt %35 çıkar ('tabanın altında') ve spec'e dönülür. Oysa tam eğitim %55'e ulaşabilirdi; bu, yanlış bir durdurma olur. Tersi de mümkün: kapı Blue varsayılanlarıyla ve geniş DR ile G-BENCH'ten önce koşulur, Adım 0'da DS3225 seçilince sonuç geçersizleşir. Yüz modu kapıda %40 çıkar ama kural olmadığı için tam getup eğitimi koşulur ve A6'da düşer. Kafa sabit koşusu iyi, kafa serbest koşusu kötü çıkarsa tam eğitimin hangi konfigürasyonla yapılacağı yazmıyor.
  Öneri: Kapıyı sayılarla tanımlayın: adım bütçesi (ör. tam bütçenin %30'u), G-BENCH sonrası parametreler, mod başına eşik (ör. ≥ 0,6 × A6 tabanı ve öğrenme eğrisinin eğimi > 0). Karar kurallarını yazın: hangi mod düşerse ne yapılır; (i) ile (ii) arasında daha iyi olan tam eğitimin konfigürasyonu olur.

- [SEV: major] **fresh/F6** (§3.2.2 (range = ctrlrange + 3°), §3.2.3 (boşluk eklemi), §3.2.5 (limit cezası), §6 A4–A6 (limit torku p99 ≤ 0.1·τs)) Limit kısıt torku metriği ve cezası, spec'in kendi seçtiği iki mekanizmayla çakışıyor. (a) Kabul koşusunda açık olan seri boşluk ekleminin ±b/2 LIMIT_JOINT satırları, boşluk kapandığı her an iletilen torkun tamamını taşır. (b) rl/robot_model.py, main ve getup varyantlarında diz, boyun ve hip_yaw için eklem range'ini yeniden ctrlrange'e eşitliyor (_limit_knees, _limit_neck, _limit_hip_yaw, satır 31–68). Bu, '+3°' kuralını tam da getup için kritik eklemlerde siliyor.
  Somut senaryo: Uygulayıcı limit torkunu efc_type == LIMIT_JOINT satırlarının toplamı olarak yazar. Boşluk açıkken diz boşluk ekleminin limit kuvveti yürüyüşte ~1 N·m olur; A4'teki 'p99 ≤ 0.29 N·m' her politikada düşer, ödüldeki limit cezası da normal yük taşımayı cezalandırır ve walk eğitimi bozulur. Ayrıca main varyantında diz range'i KNEE_LIMIT'te ctrlrange'e eşit olduğu için oturma ya da derin çömelme pozunda küçük yükler bile limit satırına biner; A5 'limit ölçütleri burada da geçer' maddesinde düşer. getup'ta ise diz ve boyun sınırı yine sonsuz güçlü dayanak olur (O2 geri gelir).
  Öneri: Metriği yalnız aktüatörlü eklemin (rotor/pot tarafı) limit satırları olarak tanımlayın; boşluk eklemi satırlarını açıkça dışarıda bırakın. 'range = ctrlrange + 3°' kuralını build_spec'teki bütün varyant sınırlamalarından sonra uygulanan bir değişmez yapın ve bunun için test yazın. Pot gözleminin boşluk ekleminin hangi tarafını okuduğunu da belirtin.

- [SEV: major] **fresh/F7** (§3.2.5 getup, §6 A8, A6) Eğitim modelinde ayaklar arası çarpışma dışında öz-çarpışma yok. Getup'ın EXTRA_COLLISION kutuları yalnız zeminle çarpışıyor; trunk ve head kutuları (contype 0) bacak kutularıyla temas üretmiyor. Buna karşın A8, main ve getup rollout'larında görsel mesh girişimini ≤ 1 mm³ ile sınırlıyor. 'Güçlü boyun + bacaklar' stratejisi derin katlanmalarla öğreneceği için politika fiziksel olarak imkânsız içinden geçmeleri serbestçe kullanabilir.
  Somut senaryo: Yüzüstü kalkmada politika boynu −90°'ye, hip_pitch'i +90°'ye ve dizi tam büküme getirir. Sim'de bunu engelleyen bir temas yoksa uyluk trunk kabuğunun, gaga da shin'in içinden geçer. Kalkma simde %80'in üstünde başarılı görünür. Ardından eval_tasks, sim/collision_check ile cm³ mertebesinde girişim ölçer ve A8 düşer. Ücretli getup eğitimi boşa gider ve öz-çarpışma eklenip tekrarlanması gerekir. A1'in komşu eklem taraması bu komşu olmayan çiftleri (uyluk-trunk, kafa-shin, ayak-kafa) kapsamıyor.
  Öneri: getup ve main varyantlarına seçilmiş öz-çarpışma çiftleri ekleyin (MJCF <pair> ya da contype/conaffinity ile uyluk/shin ↔ trunk/head/jaw). Çiftlerin MJX maliyetini A3'te ölçün. Getup kapısının (§3.4) kısa koşularında A8'i de raporlayın.

- [SEV: major] **fresh/F8** (§3.2.3 paylaşımlı ray modeli, §6 A4 (Ray p99 ≤ 16 A), §3.2.8 sysID) Ray akımı modeli I_rail = Σ I_stall·|τ_net|/τs motor akımını veriyor, besleme akımını değil. PWM H-köprüsünde besleme akımı yaklaşık d·I_motor'dur (d = τ_act/τs). Bu yüzden model, kısmi duty'de akımı 1/d kat fazla tahmin ediyor. Bu tahmin hem cezayı, hem CC forcerange ölçeklemesini, hem de A4'ün ray ölçütünü belirliyor. sysID listesinde bu modeli Adım 0'daki INA226 logundan uyduracak bir adım yok.
  Somut senaryo: Dizin 1.0 N·m tuttuğunu düşünün (d ≈ 0.35, I_stall ≈ 3.63 A): model 1.26 A verir, gerçek besleme ≈ 0.44 A. 9 DS benzer duty'de çalışırken model yürüyüşte ~11–13 A, p99'da > 16 A gösterir; gerçek ~4–6 A'dır. Sonuçta sim yürüyüşte CC ölçeklemesine girer ve politika gereksiz yere zayıf servoyla eğitilir. A4'teki 'ray p99 ≤ 16 A, > 15 A süre ≤ %2' sahte biçimde düşer ve kimse 'bacak başı ayrı buck' donanım değişikliğine yönelir. Kalkmada (d ≈ 1) iki tahmin aynı olduğundan hata yalnız yürüyüş ve main'de ortaya çıkar.
  Öneri: Akımı I_supply ≈ I_stall·|τ_act|·|τ_net|/τs² (+ boşta akım) olarak modelleyin. Adım 0'da INA226 ile sabit yük, farklı duty ve hız noktalarında akımı ölçüp modeli uydurun; bu adımı tools/sysid'e ekleyin. A4 metriğinin ölçekleme öncesi talep akımı mı, ölçekleme sonrası mı olduğunu da yazın; ölçekleme sonrasıysa ≤ 16 A kendiliğinden sağlanır.

- [SEV: minor] **fresh/F9** (§3.2.6, §6 A7) A7 kendi geri dönüş yolunda kendisiyle çelişiyor. 'Aktör 256-128-64' kabul maddesi, ama §3.2.6 küçük aktör A4–A6'yı tutmazsa 512-256-128 + int8 tahmini kullanılacağını söylüyor. O dalda A7 tanım gereği düşer; yani hiçbir dalda tur kabul edilemez.
  Somut senaryo: Repodaki getup TaskSpec'i 512-256-128 ve eğitilmiş tek politika da 512-256-128. Getup 256-128-64 ile A6'da sırt modunda %45'te kalır, 512-256-128 ile %60'a çıkar. A6 geçer ama A7'nin ilk maddesi düşer. 'Gerekirse büyük aktör + int8 tahmini' ise yalnız bir rapor maddesi; geçme koşulu yok. rl-map'e göre 512-256-128 float32 PSRAM'den 9–19 ms sürüyor, < 2 ms hedefini aşıyor.
  Öneri: A7'yi iki dallı yazın. Ya 256-128-64 ve ≤ 1e-5 eşitlik; ya da büyük aktör veya damıtılmış öğrenci için int8 dışa aktarma, int8 ile float arasında A4–A6 farkı ≤ x ve tahmini süre < 2 ms. Damıtmaya (RL-9) açıkça izin verin.

- [SEV: minor] **fresh/F10** (§3.1 Görevlerin gerektirdiği eklem aralıkları, §6 A1, A4 (main takip)) Gerekli aralık tablosu A1'i kısmen test edilemez bırakıyor. hip_roll tabloda hiç yok. Boyun için 'ileri −90'a kadar istenir, servo aralığı izin verdiği kadar' sayısal değil. hip_yaw'ın −21° (sol işaretinde içe dönme) ihtiyacı, main/getup varyantındaki içe dönme sınırıyla (HIP_YAW_INWARD_MAX, 27 cm'de 8°, rl/robot_model.py) çelişiyor.
  Somut senaryo: CAD taraması hip_roll'u ±12°'ye kısar. A1 yine geçer, çünkü hip_roll için gerekli aralık yazılmamış. Ama getup'ın yana dönme hareketi ve geniş duruşta tek ayak desteği bu aralığa ihtiyaç duyar; sorun ancak A6'da ortaya çıkar. Boyun CAD'de −60°'de kafa-trunk çakışmasıyla sınırlanır; '−90 isteniyor' cümlesine göre A1 hem 'geçti' hem 'kaldı' okunabilir. main, hip_yaw içe dönmesi 8° ile sınırlıyken walk 21° kullanır; 'main takip ≥ walk'ın %90'ı' ve dönüş ±%20 main'de yapısal olarak zorlaşır. 27 cm'de o sınırı doğuran bacak-bacak çakışmasını A1'in komşu eklem taraması yakalamaz.
  Öneri: hip_roll ve boyun için sayısal gerekli aralık yazın; boyun için örneğin −90…+40 ve buna göre seçilmiş bir diş ofseti. TR-35'te HIP_YAW_INWARD_MAX'ın CAD'den yeniden türetileceğini ve ≥ 21° olması gerektiğini yazın, ya da walk komut aralığını buna göre daraltın. Bacak-bacak çiftini A1 taramasına ekleyin.

## Role: resolution

Overall: Rol: çözüm denetçisi. review.md'de Kabul ya da Kısmen kabul işaretli bütün tur-1 itirazlarını spec v2 ile tek tek karşılaştırdım.

**Kontrol edilen ID'ler:**
- mekanik/elektrik/BOM: O1–O12
- RL/sim: RL-1…RL-10
- kapsam/kabul: SC-1…SC-12 (SC-1/2/3/5/10/11 kendi eşlerine bağlı)

**Tutarlı uygulananlar:**
- O3: I_CC 16 A §3.1, §3.2.3 ve A4'te aynı (metrik tanımı için R2-7'ye bakın).
- O4, O5, O6 (kütle sınırları §4 ve A1'de aynı), O7 (tezgâh tarafında açık var, R2-5), O8 (hip_pitch −70…+90; 5° pay ve +3° range servo aralığına sığıyor), O11, O12.
- RL-1a/c: κ = 0,5 → 1,10 Hz. Kapının ±%15 dar DR'da sağlam olduğunu da kontrol ettim; u > 1 oranı yalnız %0,3–0,4.
- RL-2, RL-3 (kapı eşiği için R2-7), RL-5, RL-6, RL-7 (rampa 2,83 s ve otur 4,0 s tutarlı), RL-9, SC-8, SC-9, SC-10, SC-11, SC-12.
- ADC sayıları tutarlı: ADC1'de 10 kanal, ADS1115 #1'de boyun + 3 kafa = 4 kanal, ADS1115 #2'de 2 NTC + 2 boş. 15 eklemin 14'ü ölçülüyor; I2C adresleri çakışmıyor.

**Açık kalanlar ve yeni çelişkiler:**
- O1/SC-1 (R2-1): BOM'un yeniden hesabı yapılmamış. v2'nin eklediği kalemlerle zorunlu toplam ≈ 24,2k TL, yedeklerle ≈ 27,4k TL.
- RL-4 × O2 (R2-2): seri boşluk eklemi yükü kendi limit kısıtından taşıdığı için limit torku ölçütüyle çelişiyor.
- O2 (R2-3): +3° kuralı yalnız dışa aktarımda; robot_model main/getup limitleyicileri onu eziyor ve §3.1 gerekli aralıkların altında kesiyor.
- SC-4 (R2-4): ısıl kalibrasyon tek yönlü; DS3230 Red'in Türkiye kaynağı yok; en ucuz aday DS3225'in eşiği 0,78–0,90 N·m, diz RMS tahmini ise 1,05–1,11 N·m.
- O7 × SC-6 (R2-5): şöntsüz INA226 ile tezgâhta stall akımı ölçülemiyor.
- SC-11/RL-8 (R2-6): HEAD_RANDOM daraltılmamış; kafa için limit istisnası düşmüş.
- RL-8/RL-3/SC-2 (R2-7): Wilson yönü ve N tanımsız, ray metriği kendiliğinden sağlanabiliyor, dönüş komutu tanımsız.
- O9 (R2-8), SC-6/O10/RL-10 (R2-9), RL-7/SC-7 (R2-10): küçük eksikler.

**Hesap betikleri** (/private/tmp/claude-501/-Users-huseyinarslan-Desktop-ads-z-klas-r-2/8217cd75-2c54-4fa4-b47f-57c38ee96c2b/scratchpad/s10/resolution/):
- bom_v2.py: BOM toplamı
- wilson.py: kabul istatistikleri
- gate_dr.py: dar DR'da κ kapısı ve diz ısıl tahmini

Repoya dokunulmadı.

- [SEV: critical] **resolution/R2-1** (§6 A2, §1, §7 (Alınacaklar)) O1/SC-1 kararında "BOM satır satır yeniden hesaplanır" deniyordu, ama bu hesap spec v2'ye taşınmamış. A2 eşikleri (zorunlu ≤ 23.500 TL, yedeklerle ≤ 25.000 TL) research fiyatlarıyla tutmuyor. Üstelik v2'nin kendi kararları, hiçbir toplamda yer almayan yeni zorunlu kalemler ekledi.
  Somut senaryo: DS'ler en ucuz kaynaktan alındığında tur-1 BOM betiği (scratchpad/s9/mech-power-bom/bom.py) zorunlu toplamı 23.397 TL (Direnc DS3230) ve 23.261 TL (Robocombo DS3225) veriyor. Yani 23.500 sınırına yalnız 100–240 TL pay kalıyor. v2'nin eklediği ve hiçbir toplamda bulunmayan kalemler: ikinci ADS1115 (309,77 TL), LiPo voltaj alarmı (~115 TL), döner tabla rulmanları (R14: 407–758 TL, hâlâ dahil değil), KCD1 (18 TL) yerine 16,8 V DC'ye uygun anahtar, TVS ve ek kapasitör, alüminyum 25T kol (stok ve fiyatı doğrulanmadı). Bu kalemler alt sınırlarıyla alınsa bile zorunlu toplam ≈ 24,2–24,3k TL, yani > 23,5k. Tur-1 yedek seti (2 DS, ES3054, MG90S, SG90, kol, rulman ≈ 3,2k TL) eklenince toplam ≈ 27,4–27,5k TL oluyor. Şarj cihazı çıkarılsa bile ≈ 25,6k TL, yani > 25k. Sonuç: A2 ilk BOM dışa aktarımında düşer ve kullanıcının ~25k tavanı yedekli konfigürasyonda aşılır. Ayrıca §7'deki Adım 0 alımının (research fiyatlarıyla ≈ 3,74k TL, spec "~3,6k" diyor) tavana dahil olup olmadığı belirsiz, ve kaybeden DS adayı (~1,03k TL) robotta kullanılmıyor. Hesap: scratchpad/s10/resolution/bom_v2.py.
  Öneri: Spec'e her iki DS adayı için satır satır zorunlu toplamı yaz. Yedek setini tavana sığacak kadar daralt (ör. 1 DS + 1 MG90S) ya da tavanın yedekleri kapsayıp kapsamadığını kullanıcıyla netleştir. Adım 0 harcamasının ve kaybeden DS'nin tavana dahil olup olmadığını yaz. Kullanıcıda şarj cihazı varsa onu opsiyonel satır yap.

- [SEV: major] **resolution/R2-2** (§3.2.3 (boşluk), §3.2.5 (cezalar), §6 A4–A6 (limit torku)) RL-4 kararı (seri boşluk eklemi, ±b/2) ile O2 kararı (limit kısıt torku ölçütü ve cezası) birbirini bozuyor. Sınırlı aralıklı bir seri boşluk ekleminde yük, tam olarak o eklemin limit kısıtı üzerinden iletilir. Spec, limit torku metriğinin ve cezasının hangi eklemlerin limit satırlarından hesaplanacağını söylemiyor.
  Somut senaryo: A4 "boşluk açık" koşulur. Diz ~1,0 N·m RMS taşırken boşluk eklemi sürekli ±b/2 dayanağında durur. Bu eklemdeki efc_force (LIMIT_JOINT) ≈ |τ_net| ≈ 1–2,5 N·m olur; bu, 0,1·τs = 0,29 N·m sınırının 3–8 katı. Metrik bütün limit satırlarını toplarsa A4, A5 ve A6 her politikada düşer. Ceza da yük taşımanın kendisini cezalandırır; politika çift destekte dizi boşaltmayı öğrenebilir. Spec'te üç şey daha eksik: (1) pot gözleminin boşluğun hangi tarafını okuduğu (servo mili mi, link mi); (2) boşluk ara gövdesinin kütle ve armature değeri (MJX'te ataleti ~0 olan ara gövde iki dayanak arasında çırpar); (3) kararda geçen 0–1° DR aralığı (§4'teki DR listesinde boşluk yok).
  Öneri: Limit metriği ve cezası yalnız ana eklemlerin (ctrlrange + 3° sınırı) LIMIT_JOINT satırlarından hesaplansın; boşluk eklemleri açıkça hariç tutulsun. Pot gözlemi servo tarafındaki açı olarak tanımlansın (pot çıkış milinde). Ara gövdeye armature ve solref değeri verilsin. 0–1° boşluk DR'ı §4'e eklensin.

- [SEV: major] **resolution/R2-3** (§3.2.2, §3.2.5, §3.1 (gerekli aralıklar), §6 A1) O2'nin "eklem range = ctrlrange + 3°" kuralı yalnız MJCF dışa aktarımına (§3.2.2) yazılmış. Oysa main ve getup modellerinde rl/robot_model.py'deki _limit_knees, _limit_neck ve _limit_hip_yaw, range'i ve ctrlrange'i aynı değere yeniden yazıyor. Bu yüzden kural tam da sınır dayanağının önemli olduğu görevlerde (çömelme, kalkma) eziliyor. Aynı limitleyiciler eklemleri §3.1'deki gerekli aralıkların altında kesiyor ve A1 bunları kontrol etmiyor.
  Somut senaryo: robot_model.py:31–68 main ve getup'ta şu değerleri hem j.range hem a.ctrlrange olarak yazıyor: sol diz üst sınırı KNEE_LIMIT_DEG = 65; neck_pitch NECK_PITCH_MAX_DEG = 36; sol hip_yaw alt sınırı −HIP_YAW_INWARD_MAX_DEG = −8. Derin çömelmede (gerekli diz açısı +62°) diz 65°'te simülasyonun dayanağına yaslanır. O2'nin "dizin sınırda çömelmesinde yükü sim taşır" senaryosu main ve getup'ta aynen sürüyor. Ayrıca §3.1 hip_yaw için −21…+4°, neck için 1…40° gerekli diyor; main varyantı bunları −8° ve 36°'de kesiyor. A1 yalnız CAD sınırlarına baktığı için yine geçer. Ama hip_yaw iç dönmesi 8°'de kesildiği için main'in yürüme ve dönüş takibi (A4: walk'ın ≥ %90'ı, dönüş ±%20) walk'ın sistematik olarak gerisinde kalabilir.
  Öneri: +3° kuralını robot_model.build_spec'e taşı; limitleyiciler dahil bütün varyantlarda range = yeni ctrlrange + 3° olsun. KNEE_LIMIT, NECK_PITCH_MAX ve HIP_YAW_INWARD'ı TR-35 için yeniden türetilen sabitler listesine ekle. A1 ya da A3'e "varyant sınırları ⊇ §3.1 gerekli aralıklar" kontrolü koy.

- [SEV: major] **resolution/R2-4** (§5.1, §7 karar tablosu (Isınma), §6 A4, §4) SC-4'ün çözümü tek yönlü ve çıkış yollarından biri tedarik edilemiyor. Isınma testi yalnız stall/3 yükünde yapılıyor ve karar tablosu eşiği yalnız düşürebiliyor. Spec'in kendi tahminine göre A1'in izin verdiği her kütlede diz τ_net RMS varsayılan eşiğin üstünde kalıyor. Kütle tavanı 1,90'dan 1,95 kg'a çıkınca açık daha da büyüdü.
  Somut senaryo: Research ölçeğiyle (0,30 N·m × k(m)) diz RMS 1,85 / 1,90 / 1,95 kg'da 1,05 / 1,08 / 1,11 N·m çıkıyor. Eşikler: Blue 0,96; DS3225 (DSSERVO, 6,5 V) 0,90; DS3225 (Robocombo metni) 0,78 N·m. Bütçe en ucuz adaya, Robocombo DS3225'e dayanıyor; o kazanırsa açık %17–42 olur. Isınma testi stall/3'te örneğin 52 °C verirse tablo hiçbir eylem tanımlamıyor; eşik 0,96'da kalır ve A4'ün diz kriteri düşer. Çıkış yolu olarak yazılan DS3230 Red'in research'te Türkiye kaynağı yok: R3 yalnız 180° DS3230MG'yi doğruladı, Motorobit ve Direnc'in sattığı varyant belirsiz (servo-mechanics'te açık soru). A2'de Red için bir toplam yok ve bu seçenek §4'teki "bütün parçalar Türkiye'de stokta" kuralına aykırı. Kalan iki yol (dizi daha az büken HOME, diz tork cezası) kanıtsız; research diz RMS'inin kütleyle belirlendiğini söylüyor. Ayrıca bu turda robot basılmadığı için §4'teki ve RL-1a'daki "ölçülen kütle" tanımsız.
  Öneri: Isınma testini 2–3 yük seviyesinde yap (ör. 0,9 / 1,05 / 1,15 N·m RMS). Eşik, kasa sıcaklığını ortam payıyla ≤ 60 °C tutan en yüksek RMS olsun; böylece eşik yukarı da çıkabilsin. Red'i Türkiye kaynağı ve fiyatıyla doğrula ya da çıkış listesinden kaldır. DS seçim satırına "diz RMS tahmini ≤ eşik" koşulunu ekle. "Ölçülen kütle" yerine "G-CAD kütlesi (aşağıdan yukarı)" yaz.

- [SEV: major] **resolution/R2-5** (§3.1 Elektronik (INA226 yalnız VBUS), §7 Ölçümler, §3.2.3 (ray modeli), §3.2.8) O7 kararıyla INA226 şöntsüz, yalnız VBUS ölçen bir sensör olarak tanımlandı. Oysa §7'deki tezgâh testi stall akımını INA ile kaydediyor ve ray modelinin I_stall katsayısı bu ölçümden geliyor. Tezgâhta akımın hangi yolla (hangi şöntle) ölçüleceği tanımsız.
  Somut senaryo: Hazır INA226 modülleri R100 (0,1 Ω) şöntle gelir. INA226'nın şönt girişi ±81,92 mV olduğu için tam ölçek 0,82 A'dır. DS3230'un 6,5 V'taki stall akımı ≈ 3,63 A; ölçüm 0,82 A'da doyar. Şönt 0,36 V düşürür; servo 6,14 V görür ve τs ~%5 düşük ölçülür. Şönt de 1,3 W ile ısınır. Sonuçta tools/sysid I_stall'ı 0,82 A bulur. Ray modeli (I_rail = Σ I_stall·|τ_net|/τs) akımı ~4,4 kat düşük tahmin eder, CC ölçeklemesi hiç devreye girmez ve A4–A6'nın ray ölçütleri yanlış biçimde geçer.
  Öneri: Tezgâh için şönt değerini yaz: ör. 2–10 mΩ 2512 direnç ya da power-electronics'teki 16 AWG dönüş şöntü (kalibrasyonla). Alternatif olarak akımı laboratuvar güç kaynağından oku. sysID'de I_stall'ın kaynağını ve bir doğrulama ölçütünü belirt (ör. iki yöntem arasındaki fark ≤ %10).

- [SEV: major] **resolution/R2-6** (§3.2.5, §6 A4/A6, §3.1 Mekanik (kafa tamponu)) SC-11 ve RL-8 ile eklenen MG90S tork ölçütleri walk ve main'de politikanın değil, env'in kafa hareketinin sonucu olacak, çünkü HEAD_RANDOM daraltılmamış. Review'daki kafa için limit istisnası (≤ MG90S stall) spec'e geçmemiş. Tamponun yük yolunun simde temsil edilmesi (boyun gövdesinde bir çarpışma geomu) de zorunlu tutulmamış.
  Somut senaryo: config.py:94'teki HEAD_RANDOM (prob 0,5; head_pitch 0,3 rad; head_yaw 0,6 rad; filtre 0,3 s) değişmeden kalırsa rl-map'e göre kafa tepe torku 0,33 N·m olur, yani MG90S stall'ının 1,5 katı. Kafa eklemleri aksiyon uzayında olmadığından A4'ün "MG90S p99 ≤ 1,0, RMS ≤ stall/3 (0,072 N·m)" ölçütü her walk ve main politikasında düşer. A4'ün limit torku eşiği (p99 ≤ 0,1·τs) kafa için 0,022 N·m ediyor. Env kafayı ctrlrange ucuna sürerken stall'ın %48'i kadar yerçekimi yükü ve 1–8° P-bandı 0,5–3,8° sapma verir; 3°'lik payı aşan örneklerde kafa limite dayanır. A6'da kafa-zemin teması kafa gövdesindeki head_collision geomuna düşerse yük yine kafa eklemlerinden geçer ve 0,1·τs eşiği her temas anında aşılır. CAD'deki tampon simde yoksa ölçüt yanlış yük yolunu ölçer.
  Öneri: HEAD_RANDOM'un aralığını ve dönüş hızını MG90S'e göre yeniden türet (rl-map daraltmayı ve slew sınırını zorunlu sayıyor) ve spec'e yaz. A4'ün MG90S ölçütlerini bu kafa hareketi profili altında tanımla. Kafa için limit eşiğini review kararıyla hizala (≤ MG90S stall) ya da 0,1·τs'yi gerekçesiyle bilerek seç. Çene/alın tamponunu MJCF'de boyun gövdesine bağlı bir çarpışma geomu olarak zorunlu kıl.

- [SEV: major] **resolution/R2-7** (§6 A4–A6, §3.4) Kabul istatistikleri hâlâ aynı politika için iki uygulayıcıya zıt hüküm verdirebilir. Eksikler: (1) "Wilson %95" ifadesinin yönü (üst sınır mı, alt sınır mı, yoksa nokta tahmini artı aralık raporu mu); (2) A5, A6 ve devir senaryosu için bölüm sayısı; (3) ray ölçütünün forcerange ölçeklemesinden önce mi sonra mı hesaplandığı; (4) §3.4'teki kısa koşuların geçme eşiği; (5) SC-2'nin istediği dönüş komutları ve ölçüm penceresi.
  Somut senaryo: A4, 256 bölümde: "Wilson üst sınırı ≤ %3" okunursa en fazla 2 düşmeye (p̂ = %0,8) izin verir; nokta tahmini ≤ %3 okunursa 7 düşmeye. A6 bankası (yüz %25, yan %40, sırt %35) 256 bölümle koşulursa yüz modunda n ≈ 64 olur: nokta tahmini ≥ %80 için 52 başarı, Wilson alt sınırı ≥ %80 için 58 başarı (%90,6) gerekir; sırtta bu sayılar 45'e karşı 55. A5'in "≥ %95" ölçütü Wilson alt sınırı olarak okunursa 64 bölümde hiç sağlanamaz, 256 bölümde 251 başarı ister. Ray: forcerange I_CC/I_rail ile ölçeklendikten sonra hesaplanan I_rail ~16 A'yı aşamaz, dolayısıyla "p99 ≤ 16 A" kendiliğinden sağlanır; ölçekleme öncesi talep ise anlamlı bir ölçüttür. §3.4: kısa koşudaki sırt başarısının A6 tabanıyla (%50) mı karşılaştırılacağı, hangi koşunun (i ya da ii) esas alınacağı ve kaç adım koşulacağı yazmıyor. Kısa bir koşu tam eğitimin gerisinde kalacağı için "spec'e dön" yanlışlıkla tetiklenebilir. Hesap: scratchpad/s10/resolution/wilson.py.
  Öneri: Her oran ölçütü için N'yi ve kuralı yaz: ör. "düşme: Wilson üst ≤ %3, N = 512"; "mod başarısı: Wilson alt ≥ taban, mod başına N ≥ 128"; A5 ve devir senaryosu için de N ve kural. I_rail metriğini ölçekleme öncesi talep olarak tanımla. §3.4 kapısına adım bütçesi ve eşik koy (ör. kısa koşuda sırt ≥ %30). Dönüş ölçütü için sabit wz komutları (ör. ±0,3 / ±0,5 rad/s) ve kararlı durum penceresi tanımla.

- [SEV: minor] **resolution/R2-8** (§3.1 Geri bildirim, §3.2.1 (işaret kuralı), §3.2.4) O9 kararı ("ADS1115 yolu, işaret kuralı ve BOM satırı spec'te") eksik uygulanmış. ADS1115 girişlerinin bölücüsü ve VDD'si, ayrıca ADS yolunun RC değeri yok. Boyun servosunun gövdesi trunk'a alındığında işaretin nasıl korunacağı da yazmıyor.
  Somut senaryo: Boyun potu 6,5 V raydan, kafa potları 6,0 V raydan beslenirse wiper gerilimi ~6 V'a çıkar. ADS1115'in analog giriş sınırı VDD + 0,3 V'tur (VDD 3,3 V ise 3,6 V). Bölücü yazılmadığı için BOM ve CAD bölücüsüz çıkar; girişler ESD diyotlarından akım çeker, okumalar kırpılır ya da çip bozulur. Sensör modelinde ADC1 yolu için RC 3,2 ms tanımlı, ADS yolu için yok; firmware'in birebir kopyalayacağı tanım eksik kalıyor. Mikroda boyun servosunun gövdesi child link'teydi. Gövde trunk'a alınıp horn yönü korunursa servo işareti −1 olur; "işaret kuralı korunur" iddiası boyun için kendiliğinden doğru değil.
  Öneri: ADS1115'in VDD'sini (3,3 V) ve kanal başına bölücüyü yaz; ADC1 ile aynı 100k/47k + 100 nF kullanılırsa τ 3,2 ms olur. PGA aralığını belirt. CAD'de boyun horn'unun yönünü sabitle (−y) ve bir işaret testini A9 birim testlerine ekle.

- [SEV: minor] **resolution/R2-9** (§7 (ölçümler ve karar tablosu)) SC-6 kararı her ölçüm için "eşik → eylem" istiyordu. §7'de ölçülen birkaç kalemin karar satırı yok ve bazı ölçüm koşulları ray gerilimleriyle tutarsız.
  Somut senaryo: (a) Yavaşlamada ray aşımı ölçülüyor, ama ≤ 6,8 V kapısı ve aşılırsa yapılacak eylem (kırpıcı ya da fren direnci, bkz. O10) yok. (b) PCA9685'in 3,3 V darbelerini servo reddederse ne yapılacağı yok (seviye çevirici gerekir; BOM ve CAD değişir). (c) Pot raydan besleniyorsa ortak-mod hatanın büyüklüğü ve düzeltmesi (oranlı okuma, boş ADS kanalı) için satır yok. (d) ES3054 300 Hz'i kabul ederse hip_yaw'ı 0x40 kartına taşıma satırı yok (gecikme U{0..4}'ten U{0..2}'ye iner). (e) Ölçümler "6,5 V; MG90S 6,0 V" diyor; ama ES3054 robotta 6,0 V rayında çalışıyor. 6,5 V'ta ölçülürse τs ve ω0 robottakinden yüksek çıkar, üretici aralığı da aşılabilir. (f) RL-10 kararı MG90S ve SG90'ın 50 Hz davranışının test edilmesini istiyor; oysa SG90 Alınacaklar listesinde yok ve MG90S için yük altında tutma testi açıkça listelenmemiş.
  Öneri: Bu kalemler için eşik ve eylem satırları ekle. ES3054'ü 6,0 V'ta ölç. Alınacaklar'a SG90 ekle ya da kararı yalnız MG90S ile sınırla.

- [SEV: minor] **resolution/R2-10** (§3.2.5 (main pencereleri), §3.1 (gerekli aralıklar), §6 A1/A5) Küçük sayısal ve tablo tutarsızlıkları var. (1) Kalkış penceresi 3,7 s, §3.2.5'te iddia edilen λ_t = √s türetmesiyle uyuşmuyor: 3,0 × 1,132 = 3,40 s (rl-map de 3,4 s diyor). (2) Gerekli aralıklar tablosunda hip_roll ve head_roll yok. (3) Neck için "−90'a kadar istenir, servo aralığı izin verdiği kadar" gibi yumuşak bir girdi var; bu, A1'in "⊆" kontrolünü belirsiz bırakıyor. SC-7 kararı görev başına bir tablo istiyordu.
  Somut senaryo: Kodlayıcı standup_window_s = 3,0·√s = 3,40 yazar, A5 ise ≤ 3,7 s ile ölçer (ya da tersi); ödül penceresi ile kabul eşiği birbirinden ayrılır. A1 kontrolcüsü hip_roll için gerekli aralık bulamaz; oysa RL-3'e göre ±20° kalkmada kritik. Neck alt sınırını −60°'ta bırakan bir CAD de "servo izin verdiği kadar" diye geçer; ardından sırttan kalkma kapısı bu yüzden düşer.
  Öneri: 3,7 s'yi açıkça "3,40 + 0,3 pay" olarak yaz ya da 3,4 s'ye çek. Tabloyu görev başına (walk/main/getup) ve 15 eklemin hepsi için ver. Neck için sayısal bir hedef koy (ör. −90…+40°, nötr −25°; servo-mechanics).
