Kubudak90/openduck-tr/docs/workflow/openduck-tr/research/review-r1-objections.md

## Lens: mech-elec-bom

Overall: Durum: spec'i mekanik, elektronik, güç ve BOM açısından inceledim; 12 itiraz çıktı: 2 critical, 5 major, 5 minor. Kullanıcı kararlarına itiraz etmedim.

En önemli iki sorun:
- A2 bütçesi (≤ 20.000 TL) spec'in kendi seçimleriyle tutmuyor. Servolar tek başına 19,3k TL. Zorunlu toplam DS'ler Motorobit'ten alınırsa ≈ 31,4k TL, en ucuz kaynak Direnc'ten alınırsa ≈ 23,4k TL. Bütçe sınırı kullanıcıya yeniden sorulmalı ya da kaynak stratejisi değişmeli.
- Simdeki eklem sınırları sonsuz güçlü dayanak gibi çalışıyor. Bu yüzden güçlü boyunlu kalkma, yükü üç MG90S'lik kafa zincirine bindirerek simde başarılı görünebilir. Gerçek robotta kafa zinciri ~2–4 N taşıyabilir; dişliler kırılır.

Major itirazlar:
- 9 DS aynı anda doyduğunda bacak rayı 20 A'yı aşıyor; sim bunu modellemiyor.
- ES3054 hip_yaw'ın yapısal yük yolu (eğilme ve eksenel yük) tanımsız.
- Gövde içine konacak parçalar ≈ 495 cm³, ölçeklenmiş torso iç hacmi ≈ 371 cm³; hava akışı bütçesi de yok.
- Braketlerle birlikte tahmini kütle ≈ 1,98 kg, A1'deki 1,90 kg sınırının üstünde.
- BMS'siz LiPo için bu turda donanımsal düşük gerilim koruması yok.

Sorun bulmadığım alanlar:
- PCA9685 frekans planı (0x40'ta 9 DS ≈ 300 Hz, 0x41'de 50 Hz).
- ADC1'deki GPIO1–10 ataması (GPIO3 strapping pini, varsayılan eFuse'larla sorun değil).
- 15 A sigorta: 20 A bacak + 5 A yardımcı rayda batarya akımı en fazla ≈ 12,8 A.
- 256 mm tabla.
- Stok: Motorobit'te 48 DS var. ADS1115 Direnc'te 317 adet stokta.

Hesaplar ve kanıtlar:
- /private/tmp/claude-501/-Users-huseyinarslan-Desktop-ads-z-klas-r-2/8217cd75-2c54-4fa4-b47f-57c38ee96c2b/scratchpad/s9/mech-power-bom/calc.py: paketleme, ray akımı, hip_yaw momenti, kafa kaldıracı.
- /private/tmp/claude-501/-Users-huseyinarslan-Desktop-ads-z-klas-r-2/8217cd75-2c54-4fa4-b47f-57c38ee96c2b/scratchpad/s9/mech-power-bom/bom.py: BOM toplamı.
- Direnc ADS1115 ve 608ZZ arama çıktıları ile Motorobit LiPo alarm sayfası aynı klasörde.

Repoya dokunmadım.

- [SEV: critical] **mech-elec-bom/O1** (§6 A2, §4 (Motorobit varsayılan kaynak)) A2 bütçesi (zorunlu ≤ 20.000 TL, yedeklerle ≤ 24.000 TL) spec'in kendi kaynak seçimiyle hiçbir şekilde tutmuyor. R14'teki 18.65k toplamı 8 DS'nin Direnc fiyatından (1.046 TL) ve kaynaklı 4S1P paketten hesaplanmıştı. Spec bu toplamı Motorobit DS + 9. DS + hazır LiPo varsayımıyla yeniden hesaplamadan aynen almış.
  Somut senaryo: Motorobit DS3230MG 1.939,20 TL × 9 = 17.452,80 TL. Bunun üstüne 2 × ES3054 1.471 TL, 3 × MG90S 324 TL ve SG90 54 TL eklenince servolar tek başına 19.301,80 TL ediyor; bu, 20k sınırının %96'sı. Araştırma dosyalarındaki fiyatlarla kalan zorunlu kalemler şunlar: Profuse LiPo 2.528,23; şarj cihazı 1.797,09; ESP32 + 2 × PCA9685 + MPU6500 1.032,97; güç ve geri besleme hattı ~2.080; PETG 600 + CR-TPU 1.072,50 + kabuk PLA'sı ~650 (hiçbir BOM'da yok); M3 seti 469,50; 11 × F623ZZ 833,25; 9 × 25T kol 681,75; ADS1115 309,77 (Direnc, 317 stok); XT60→XT30 adaptör 54. Zorunlu toplam ≈ 31.435 TL, yedeklerle ≈ 36.400 TL. DS'ler en ucuz kaynaktan (Direnc) alınsa bile ≈ 23.400 TL tutuyor; şarj cihazı çıkarılsa da ≈ 21.600 TL. Yani A2 her durumda başarısız (hesap: scratchpad/s9/mech-power-bom/bom.py).
  Öneri: BOM toplamını spec içinde satır satır yeniden hesapla ve A2 eşiğini kullanıcıya yeniden onaylat (Motorobit ile ≈31k, Direnc ile ≈23k). Ya da kaynak stratejisini açıkça değiştir: örneğin 9 DS Direnc'ten, yedekler Motorobit'ten. DS3225 (Robocombo, 1.031 TL) seçilirse actuators.py varsayılanları ve κ kapısı da değişir; bunu da yaz.

- [SEV: critical] **mech-elec-bom/O2** (§3.2.3 / §5.4 / §6 A6; CAD eklem sınırları; kafa zinciri) Simülasyonda eklem sınırları sonsuz güçlü bir dayanak gibi davranıyor: robot_model eklem range = ctrlrange yapıyor ve MuJoCo limit kısıtı sınırsız tork veriyor. Donanımda ise sınırı yalnız servo tutuyor; CAD'de baskı mekanik dayanak yok, çünkü sınırlar 'servo aralığı ∩ çarpışmasız tarama'dan geliyor. En kötü durum güçlü boyunla kalkmada ortaya çıkıyor: kafa-zemin teması üç MG90S'lik kafa zincirinden geçiyor ve sim bu yükü bedavaya taşıyor.
  Somut senaryo: A6'da yüzüstü yatan robot, DS boyunla kafayı yere bastırıp gövdeyi kaldırmayı öğrenir (güçlü boyun kararının amacı da budur). Bu sırada head_pitch −30° sınırına dayanır ve yükü MuJoCo'nun limit kısıtı taşır. Gerçek yük yolu ise trunk → neck_pitch (DS) → head_pitch → head_yaw → head_roll; son üçü MG90S (0,216 N·m, plastik iç dişli). 50–100 mm kaldıraçta bu zincir yalnız 2,2–4,3 N temas kuvveti taşır. Gövdenin önünü kaldırmak ise ~9 N ister (robot ağırlığı 18,6 N). Sonuç: MG90S geri sürülür, dişliler sıyrılır. A6 simde '%80 başarı' ile geçer ama bu hatayı göremez. Aynı açık DS eklemlerinde de var: örneğin dizin sınırda çömelmesinde yükü sim taşır, gerçekte servo taşır.
  Öneri: (a) A4–A6'ya limit kısıt torku ölçütü ekle (efc_force'un limit satırlarından): eklem başına p99 ≤ 0,1·τs, kafa eklemlerinde ≤ MG90S stall. Ödülde de cezalandır. (b) CAD'de kafa temasını boyun U-link'ine aktaran bir alın/çene tamponu tasarla, böylece kafa eklemleri yük yolunun dışında kalır. Gerekli yerlerde baskı mekanik dayanak koy. MJCF eklem range'ini ctrlrange'ten ~3° dışarı al ki politika sınırı 'bedava destek' olarak kullanamasın.

- [SEV: major] **mech-elec-bom/O3** (§3.1 Güç (a), §3.2.3 aktüatör modeli, §6 A6) 9 DS'lik bacak rayının akım bütçesi yeniden hesaplanmamış ve CC ayarı yazılmamış. Simülasyon her DS'e aynı anda tam τs veriyor; ama 9 DS tek bir 20 A buck'ı paylaşıyor.
  Somut senaryo: Araştırmanın ~18 A tepe tahmini 8 DS ve yürüme içindi. DS3230 stall akımı 6,5 V'ta ≈ 3,63 A. Kalkmada diz, bilek, hip_pitch ve boyun birlikte doyar (torque-needs: back get-up'ta knee/ankle/neck aynı anda clip'te). 5 DS doyarsa 18,2 A çekilir (modülün önerilen değeri 15 A), 6 DS'de 21,8 A (20 A maksimumun üstü), 9 DS'de 32,7 A. CC devreye girince ray çöker; 9 DS birden tork kaybeder ya da 4,8 V altında MCU'ları resetlenir ve robot kalkmanın ortasında düşer. Sim forcerange'i sabit tuttuğu için politika elektriksel olarak imkânsız çok eklemli doymalar öğrenir.
  Öneri: env'e paylaşımlı ray modeli ekle: I_rail = Σ I_stall,i·|τ_i|/τs,i (+ boşta akım). I_rail, I_CC'yi (≈16 A) aşarsa tüm DS forcerange'lerini I_CC/I_rail oranıyla ölçekle. A4–A6'da p99 I_rail ve 15 A üstünde geçen süreyi raporla ve eşik koy. CC set noktasını spec'e yaz. Tutmazsa bacak başına ayrı buck seçeneğini aç.

- [SEV: major] **mech-elec-bom/O4** (§3.1 tablo hip_yaw 'idler + baskı halkası (G3)'; §6 A1) hip_yaw'ın yapısal yük yolu tanımsız: bütün bacak 17–20 g'lık ES3054'e asılı. A1'de yapısal kontrol yok; A4'teki 0,11 N·m RMS sınırı yalnız torku kapsıyor, eğilme ve eksenel yükü değil.
  Somut senaryo: Tek ayak desteğinde 1,90 kg·g'lik zemin tepkisi, ayak merkezinden hip_yaw eksenine 56–64 mm yanal kolla etki eder (geniş duruş dahil). Bu, 1,0–1,2 N·m statik roll momenti demek; adım darbesinde 2–3 katı. 'Idler' 31 mm'lik servo gövdesini saran bir U-link ise ES3054'ün tek çıkış rulmanı ve 23T Ø5,9 mili 33–47 N statik, ~100 N dinamik radyal yük alır. Plastik kasalı uçak servosu bunun için tasarlanmamıştır: kasa çatlar, dişli kaçırır, yaw'da boşluk büyür. Düşüşlerde ilk kırılan parça bu olur.
  Öneri: Yük yolunu servodan ayır. Kalça braketi gövdeye ≥ 20 mm aralıklı iki rulmanla oturan bir döner tablaya bağlansın (örneğin M8 mil üstünde 2 × 608ZZ ya da ince kesitli 68xx; 608ZZ Direnc'te stokta yok, başka mağazada doğrulanmalı). ES3054 pim/yarık kaplinle yalnız tork iletsin. A1'e 'servo miline eğilme/eksenel yük aktarılmaz' kuralını ve buna dair bir el hesabını ekle.

- [SEV: major] **mech-elec-bom/O5** (§3.1 Mekanik / Elektronik; §6 A1) Gövde için paketleme ve hava akışı bütçesi yok. Ölçeklenmiş torso hacmi elektroniği, LiPo'yu, boyun DS'ini ve hip_yaw'ları almıyor; A1 bunu yakalamayabilir.
  Somut senaryo: Mikro torso kutusu s = 1,282 ile 103,7 × 82,6 × 53,5 mm oluyor; 2,5 mm et kalınlığıyla iç hacim ≈ 371 cm³. Sığması gerekenler: LiPo 78×40×30 (94 cm³), 300 W buck 60×53×27 (86), boyun DS + beşik + idler (~80), 2 × ES3054 + idler (~49), DevKitC (24), 2 × PCA9685 (38), 70×90 hub (~95), XL4015 (21), INA226/ADS1115/IMU (~9). Toplam ≈ 495 cm³, kablolar ve hava payı hariç. Trunk büyümek zorunda. MJCF'te trunk_collision tüm trunk öğelerinin AABB'si olduğu için kalkma dinamiği, COM ve atalet değişir; poz bankaları ve eğitim bundan önce yapılırsa tekrarlanması gerekir. Buna ek olarak buck 6 A'da 4–5 W, kalkmada daha fazla ısı üretiyor ve kabuklar PLA (~55–60 °C'de yumuşar).
  Öneri: Satın alınan her elektronik parçayı CAD'de gerçek zarfıyla katı olarak modelle; A1'deki 'aynı link içi 0 çakışma' kontrolü bunları da kapsasın. Spec'e trunk iç hacim bütçesi, buck için havalandırma alanı, PETG montaj ve PLA'ya ≥ 5 mm hava boşluğu kuralı ekle. MJCF ve poz bankasını trunk boyutları dondurulduktan sonra üret.

- [SEV: major] **mech-elec-bom/O6** (§4 kütle bütçesi; §6 A1, A4) 'Baskı ~500 g' tahmini düşük kalıyor: mikro baskı setinin s² ile ölçeklenmiş hali (288 g × 1,64 = 474 g). DS beşik ve U-link braketlerinin XL330 braketlerinden çok daha ağır olduğu hesaba katılmamış. 1,90 kg sınırına ancak ~96 g pay kalıyor.
  Somut senaryo: Mikro braketler eklem başına ~6,4 g. Bir DS eklemi için beşik (40,3×20,3 cep, 3 mm duvar, idler yuvalı 5 mm taban) ve U-link (4 mm bacaklar, ~60 mm açıklık) ≈ 29 cm³, yani PETG'de ≈ 30 g. Ölçeklenmiş mikro braketin üstüne eklem başına ~+20 g; 9 eklemde ≈ +180 g. Trunk büyümesi (O5) bunun üstüne ekleniyor. Toplam ≈ 1,80 + 0,18 ≈ 1,98 kg, A1'deki 1,90 kg sınırının üstünde. A4'teki diz termal ölçütü (RMS ≤ stall/3 = 0,96 N·m, Blue) kütleyle doğrusal artıyor; R12'ye göre eski politika 1,80 kg'da zaten 1,02 N·m veriyor.
  Öneri: Eklem başına braket kütlesini servo zarfından aşağıdan yukarı hesapla. Baskı ayarlarını (duvar sayısı, dolgu → efektif yoğunluk) config parametresi yap. Kütle azaltma seçeneklerini önceden listele: uzatma kablosu yerine doğrudan lehim (−20 g), iskeletli U-link, ince kabuk.

- [SEV: major] **mech-elec-bom/O7** (§3.1 Güç (LiPo, sigorta, anahtar, INA226, LVC)) BMS'siz RC LiPo kullanılıyor ve düşük gerilim kesmesi firmware turuna bırakılmış. Bu turda donanımsal hiçbir koruma yok.
  Somut senaryo: Profuse 4S paket BMS içermiyor; 4S1P tasarımındaki 2,5 V BMS de artık yok. Bu turda firmware yok, kullanıcı Adım 0'ı paralel yürütüyor. Anahtar açık unutulursa ESP32 (~50–100 mA), buck'ların boşta akımı, 9 DS (4–5 mA'şar) ve MG90S'ler sürekli akım çeker; OE'yi high yapmak bunu kesmez. 1500 mAh paket bir gecede 3,0 V/hücrenin altına iner: şişme ve sonraki şarjda yangın riski. Ek tuzaklar: hazır INA226 modülleri genelde 0,1 Ω şönt taşır; 'INA226 (pil)' ana hatta seri bağlanırsa 10 A'da 1 V düşüm ve 10 W ısı çıkar. KCD1 anahtar 12 V/20 A için derecelendirilmiş ama 16,8 V ve kapasitif yük altında arklanır.
  Öneri: BOM'a denge soketine takılan bir LiPo voltaj alarmı ekle (Motorobit 'Lipo Seviye Ölçer ve Alarm Modülü', 95,95 TL + KDV, 100+ stok). INA226'yı yalnız VBUS ölçümü (ya da harici 2 mΩ şönt) olarak spec'le. Firmware'in gücü gerçekten kesebileceği bir MOSFET/latch için CAD'de yer ayır. Ana kesme için XT30 bağlantısını ikinci yol olarak belirt.

- [SEV: minor] **mech-elec-bom/O8** (§3.1 Mekanik (hip_pitch −75…+90), §4 (5° pay)) hip_pitch'in −75° alt sınırı spec'in kendi '5° pay' kuralını çiğniyor.
  Somut senaryo: Bir diş (+14,4°) kaydırılmış 180°'lik servo −75,6…+104,4° aralığını kapsar; −75° bu ucun yalnız 0,6° içinde. cad-map'in önerdiği `_joint` iddiası ([lower, upper] ⊂ nötr ± travel/2 ∓ 5°) build'i durdurur. Durdurmazsa, birim farkıyla hareket aralığı ~175° olan bir servo −75 komutunda iç dayanağa sürülür ve sürekli stall'da ısınır; özellikle kalkma tüm aralığı kullanabilir.
  Öneri: Sınırı −70/+90 yap (sağ bacakta aynalı). Yürüyüşün −52°'si ve oturmanın +90°'si yine bu aralıkta kalır. Spec'e eklem başına nötr açı ve diş ofseti tablosu ekle; diz −90 gerekiyorsa onun için de bir diş kaydırma gerekir.

- [SEV: minor] **mech-elec-bom/O9** (§3.1 Geri bildirim (ADS1115), §3.2.1 işaret kuralı, §3.2.4 sensör modeli) Boyun DS'inin entegrasyonunda üç açık uç var: ölçüm yolu, işaret kuralı ve BOM.
  Somut senaryo: (a) Boyun q'su ADS1115'ten geliyor: 16 bit, 8–860 SPS, multiplex, I2C hattı PCA9685 yazmalarıyla paylaşılıyor. Oysa tek sensör tanımı '12 bit, RC 3,2 ms, 1 alt-adım gecikme' diyor, dolayısıyla firmware bu tanımı birebir kopyalayamaz. Silecek gerilimi (6,5 V) ADS1115'in VDD+0,3 V sınırını aşıyor ve bölücü belirtilmemiş. (b) Mikroda neck_pitch servo gövdesi child link'teydi (neck). Gövde trunk'a alınıp horn yönü korunursa servo işareti −1 olur; 'işaret kuralı micro ile aynı' ifadesi ve eksen/horn iddiası bozulur. (c) ADS1115 ve NTC'ler doğrulanmış hiçbir BOM satırında yok (Direnc'te ADS1115 309,77 TL, 317 stok buldum).
  Öneri: sensors.py'de kaynak kanal başına parametrelensin (esp_adc1 / ads1115). Boyun için bölücüyü ve SPS'i spec'e yaz. ADS1115'in boş 4. kanalıyla boyunu diferansiyel oku (silecek − pot-low); toprak düşümü hatası ortadan kalkar. CAD'de boyun horn'unu −y yönüne sabitle. ADS1115 ve NTC'yi BOM'a ekle.

- [SEV: minor] **mech-elec-bom/O10** (§3.1 Güç (kapasitör), §7 Adım 0) Bacak rayında rejeneratif aşım payı çok dar ve Adım 0'da ölçülmüyor.
  Somut senaryo: 300 W modül muhtemelen senkron değil (araştırmada açık soru), yani geri gelen akımı ememez. DS'ler hızlı ters dönüşte enerjiyi raya geri basar. Set noktası 6,50 V, DSSERVO maksimumu 6,8 V: pay 0,3 V. Spec 'her rayda 2200 µF' diyor; araştırma ise bacak barasına 2 × 2200 µF önermiş, TVS de stokta yok. Adım 0 listesinde ray aşımı ölçümü yok. Bu yüzden aşım ilk kez 9 servolu robotta, düşüş ya da kalkma sırasında görülür.
  Öneri: Bacak barası için ≥ 2 × 2200 µF dağıtık, düşük ESR kapasitans yaz. Adım 0'a 'hızlı ters dönüşte ray tepe gerilimi' ölçümünü ekle ve ≤ 6,8 V'u kapı yap. Aşarsa zener+MOSFET kırpıcı ya da fren direnci kullan.

- [SEV: minor] **mech-elec-bom/O11** (§5.3 ve §5.6 (kablo kanalları, yıldız toprak)) İletken planı seçilmemiş. Yıldız toprak, eklemlerden kalın bir demet geçmesi demek; demet çapı ve bükülme yarıçapı CAD parametresi değil.
  Somut senaryo: Yıldız topraklama her DS için ayrı 20 AWG +/− ister. hip_yaw ve hip_roll geçişinden bacak başına 8 × 20 AWG (OD 1,8 mm), 4 sinyal, 4 silecek ve 2 NTC teli geçer: ≈ 25 mm², yaklaşık Ø7,3 mm demet; diz geçişinde ≈ Ø5,2 mm. 165°'lik hip_pitch'te servis halkası ≥ ~20 mm bükülme yarıçapı ister. Kanallar statik modellenirse çarpışma taraması demetin süpürdüğü hacmi görmez; gerçekte demet eklemi frenler ve teller yorulur.
  Öneri: Spec bir plan seçsin: ya yıldız toprak (demet çapı CAD parametresi olur), ya bacak başına ortak 16 AWG güç ve servo başına ince bir pot-low duyu teli. Demetin süpürülen hacmini minimum bükülme yarıçapıyla çarpışma taramasına ekle.

- [SEV: minor] **mech-elec-bom/O12** (§3.1 Mekanik (25T kol)) Spec '25T alüminyum/plastik kol' diyerek 3 N·m'lik eklemlerde plastik horn'a izin veriyor.
  Somut senaryo: Motorobit'in 25T kol sayfası malzemeyi belirtmiyor ('MG995, MG946R, MG996R, MG945, S3003 ile uyumlu servo kolu', 75,75 TL, 100+ stok). Dizde stall'a yakın yükte (~2,9 N·m) plastik kol kayar ya da sünerek boşluk üretir. Pot servo milinde olduğu için bu boşluk ölçülmez ve DR'deki 0–1,5° boşluğun üstüne biner.
  Öneri: DS eklemlerinde yalnız metal 25T kol kullanılsın; malzemeyi satıcıdan doğrula ya da DS kutusundan çıkan alüminyum kolu kullan. BOM satırında 'alüminyum: doğrulandı/doğrulanmadı' işaretini zorunlu tut.

## Lens: rl-sim

Overall: Durum (RL/sim lensi): Spec'in iskeleti doğru, ama kabul ölçütleri kendi varsayılanlarıyla tutmuyor. Eğitim parasından önce bunların düzeltilmesi gerekiyor. 10 itiraz var: 1 kritik, 7 büyük, 2 küçük.

Sağlam olan kısımlar:
- Aktüatör modeli fiziksel olarak tutarlı: sınıf başına position aktüatörü, kp = τs/P-bandı, forcerange = τs, b = τs/ω0. Gerçekte duty·τs − bω DC motor modeline denk.
- MJX maliyeti ve kararlılığı sorun değil. Alt-adım ctrl şekillendirme ve sensör durumu ucuz. walk-mjx-v2 200M adımı ~239k sps ile 17.5 dakikada eğitti. Sert kp, implicitfast'ın örtük sönümüyle kararlı (rl-map taraması). Bu alanda itirazım yok.

Asıl sorunlar:
1. A4 (yürüme), κ ve DR ile çelişiyor (kritik):
   - Varsayılan Blue servo (ω0 5.72) spec'in kendi κ 0.6 kapısını geçmiyor; kapı 1.80 kg ile hesaplanmış, oysa bütçe 1.90 kg.
   - DR kutusunun ~%20'sinde u > 1, yani servo gaiti takip edemiyor.
   - Diz RMS ≤ stall/3 nominalde bile kalıyor (1.08 vs 0.96). §5.1'deki çareler (κ'yı düşürmek, DS3225) bunu düzeltmiyor.
2. 'Tork' tanımı belirsiz (actuator_force mı τ_net mi; b·qd stall'ın %87'sine kadar fark yaratıyor). Kodda kalan 0.864 N·m skaler doygunluk eşiği, dört servo sınıfıyla anlamsız hale geliyor.
3. Getup'ın yapılabilirliğine dair kanıt yok:
   - main/getup 27 cm robotta bile hiç eğitilmemiş.
   - MG90S head_pitch, güçlü boynun arkasında seri bağlı. Gövde yatayken stall'ının %48–69'unu tutuyor, eski strateji ailesinin istediği torkun ancak 0.32–0.45 katını verebiliyor.
   - A6 'genel ≥ %80' ölçütü, sırt başarısı %43'te kalsa bile geçiyor (bankada sırt payı %35).
4. Sensör modeli üç yerde eksik:
   - IMU / tutum filtresi hiç modellenmemiş.
   - Boşluk, dinamik yerine gözlem gürültüsü olarak konmuş.
   - Pot modelinde ray çökmesinden gelen ortak-mod hata, ADC beyaz gürültüsü ve boyunun ADS1115 yolu yok.
5. Ölçülebilirlik:
   - κ main'e de uygulanırsa A5 pencereleri referans rampasından kısa kalıyor.
   - A4–A6'yı ölçmek için yeni eval kodu gerekiyor ama §4 bunu kapsam dışında bırakıyor.
   - 64 bölümde 'düşme ≤ %3' bir yazı-tura kadar güvenilir.

Önerilen sıra:
1. A4/A5/A6 tanımlarını ve tork alanlarını düzelt.
2. Kapıyı (τs, ω0, kütle) ile yeniden kur, gait frekansını gözleme ekle.
3. Sensör modelini tamamla: IMU, boşluk, ray/gürültü.
4. Getup'tan önce ucuz bir yapılabilirlik kapısı koy ve main'i önce eğit.

Hesap betikleri: /private/tmp/claude-501/-Users-huseyinarslan-Desktop-ads-z-klas-r-2/8217cd75-2c54-4fa4-b47f-57c38ee96c2b/scratchpad/s9/rl/
- gate.py: u-fit, DR oranları, b·qd
- head.py, hold.py: kafa alt ağacı ve MG90S tutma torku
- bank.py: düşmüş bankada mod payları
- acc.py: MJX accelerometer kontrolü

Repo değişmedi. bank.py çalışırken -I bayrağı yüzünden yanlışlıkla bir rl/__pycache__ oluştu; onu sildim. Önceden var olan cad/__pycache__ yerinde duruyor, git status temiz.

- [SEV: critical] **rl-sim/RL-1** (§3.2.5 (κ), §4 (DR), §5.1, §6 A4, §7 (kapı)) A4 yürüme kabulü spec'in kendi varsayılanlarıyla çelişiyor. Varsayılan servo κ=0.6 kapısını geçmiyor. Geniş DR kutusunun yaklaşık beşte birinde diz servosu gaiti fiziksel olarak takip edemiyor. 'Diz RMS ≤ stall/3' ölçütü nominal değerlerde bile kalıyor, §5.1'de önerilen çareler (κ'yı düşürmek, DS3225) de bunu düzeltmiyor.
  Somut senaryo: D1 varsayılanı DS3230MG Blue, ω0 = 5.72 rad/s. §7 kapısı κ 0.6 için ≥ 5.87 rad/s istiyor; kapı 1.80 kg ile hesaplanmış, spec'in 1.90 kg bütçesinde eşikler 7.13/5.94/4.95. Yani kapı κ=0.5 diyor, eğitim ise κ=0.6 ile başlıyor. parts-research u-fit'iyle (κ 0.6, 1.90 kg, nominal) u = 0.876; bu p99.9 değeri A4'ün 'diz p99 ≤ 0.85' sınırının zaten üstünde. Spec'in DR'ı (tork ×0.7–1.15, ω0 ×0.75–1.4, kütle ×0.9–1.15) ile 200k örnekte u > 0.85 oranı %54.5, u > 1.0 (servo gaiti hiç takip edemiyor) oranı %19.6; κ 0.5'te bu oranlar %30.9 ve %0.9. A4 'DR + itme, düşme ≤ %3' bu dağılımla ölçülürse politika servo hızını gözleyemez; zayıf köşede ya düşer ya da faz saatini bozar. Termal: eski politikada diz RMS 0.30 N·m × k(1.90) = 1.08 N·m, Blue stall/3 ise 0.96 (§5.1 bunu kabul ediyor). Komut 0'dan 0.30 m/s ve 1 rad/s'ye çıkarken RMS yalnız 0.25 → 0.31 değişiyor (torque-needs tablosu); yani κ'yı düşürmek RMS'i belirgin indirmez. §5.1'deki DS3225 alternatifinde stall/3 = 0.90, yani daha kötü. RMS bölüm başına örneklenen stall'a göre ölçülürse DR bölümlerinin %85–93'ü sınırı aşıyor. Hesaplar: scratchpad/s9/rl/gate.py (u-fit eski politikanın izlerinden türetildi; kanıt değil, gösterge).
  Öneri: (a) Kapıyı yalnız ω0 ile değil, ölçülen (τs, ω0, kütle) üçlüsüyle u ≤ 0.85 olarak tanımla ve 1.90 kg'da yeniden hesapla. Varsayılan Blue olduğu sürece κ=0.5 ile başla. (b) Gait frekansını bölüm başına örnekleyip gözleme ekle (ya da DR'da örneklenen ω0'ı kapı fonksiyonuyla κ'ya bağla). Böylece tek bir eğitim Adım 0'ın her sonucunu kapsar ve 'yavaş servo + hızlı gait' köşesi oluşmaz. (c) A4'ü Adım 0 sonrası daraltılmış DR ile ölç. Termal ölçütü τ_net RMS / nominal stall olarak tanımla. Tutmazsa tek yükseltme yolu olarak DS3230 Red'i (stall/3 = 1.10) yaz, DS3225'i listeden çıkar.

- [SEV: major] **rl-sim/RL-2** (§3.2.3, §3.2.5 (tork cezası), §6 A4/A5/A6) 'Tork' tanımı belirsiz: ceza ve A4 eşikleri actuator_force (≈ duty·τs) üzerinden mi, yoksa τ_net = actuator_force − b·qd (≈ motor akımı) üzerinden mi? Stall nominal mi, bölüm başına DR'dan örneklenen mi? Kodda 0.96 N·m'lik skaler sınır dört ayrı yerde duruyor.
  Somut senaryo: env_mjx.py:188 ve env_cpu s['torque'] alanına yalnız actuator_force koyuyor. b = τs/ω0 = 0.50 iken dizde 3–5 rad/s hızda b·qd = 1.5–2.5 N·m, yani stall'ın %52–87'si. Aynı yürüyüşte 'diz |τ|/stall p99 ≤ 0.85', actuator_force ile ölçülürse fiilen bir hız (duty) sınırı, τ_net ile ölçülürse bir akım sınırı olur; iki ölçüm stall'ın %87'sine kadar farklı çıkar. Ceza actuator_force² üzerine kurulursa politika ısınmayı değil hızı cezalandırmayı öğrenir. SAT = 0.9·0.96 = 0.864 N·m (eval_tasks.py:60, task_math.py:509/654, play TORQUE_LIMIT): DS diz servosunun normal ~1 N·m yükünde her adım 'doygun' sayılır. Bu yüzden tork-doygunluğu < %1 kontrolü kendiliğinden kalır, getup'taki torque_sat ödülü de DS eklemlerini stall'ın %30'unda cezalandırır. MG90S/SG90/ES3054 ise (forcerange 0.216/0.177/0.343 N·m) hiçbir zaman doygun sayılmaz. Ceza 14 OBS ekleminin hepsi üzerinden toplandığı için walk'ta ortamın kendi sürdüğü kafa eklemleri de normalize cezaya giriyor.
  Öneri: Durum sözlüğüne iki ayrı alan koy: torque_act (duty·τs) ve torque_net. Termal ceza ve RMS ölçütleri τ_net/τs_nominal ile, doygunluk |actuator_force|/forcerange_bölüm ile hesaplansın. torque_sat ve SAT eklem başına (0.9·forcerange) olsun. Ceza yalnız aksiyon eklemlerinden toplansın. Bunları rl/TASK.md sözleşmesine yaz.

- [SEV: major] **rl-sim/RL-3** (§3.2.5 getup, §3.2.4 (kafa q = komut), §6 A6) Yeni kalkma stratejisinin yapılabilir olduğuna dair ne bir kanıt ne de bir ara kapı var. A6 ölçütü sırt düşüşünü fiilen kapsamıyor. Güçlü DS boyun, MG90S head_pitch ile seri bağlı; kafa q'nun 'komut edilen' olarak gözlenmesi tam da kalkma sırasında yanlış oluyor.
  Somut senaryo: (1) Repoda main ve getup için hiç eğitilmiş politika yok: runs/ altında yalnız walk-mjx-v1/v2 var, sit-stand-getup plan.md'deki S5 eğitim adımı koşulmamış. RL ile kalkma 27 cm/XL330'da bile gösterilmedi. Tek kanıt betikli keyframe kalkmaları (DR ile %85/85/75); bunlar head_yaw'ı ±170° savuruyor (artık ±80°) ve hip_pitch −90° kullanıyor (artık −75°). Sırtüstü düşüşten yana dönmeyi sağlayan mekanizma ortadan kalkıyor: hip_roll ±20°, hip_yaw ES3054 0.343 N·m. (2) head_tilt alt ağacı 0.21 kg, kütle merkezi head_pitch ekseninden 37.7 mm uzakta (27 cm). 35 cm'de bu yaklaşık 0.22 kg × 48 mm eder. Gövde yatayken ve kafa yerden kalkıkken head_pitch tutma torku ~0.103 N·m: MG90S stall'ının %48'i, DR ×0.7'de %69'u, stall/3'ün 1.4 katı (scratchpad/s9/rl/hold.py). torque-needs'e göre eski kalkma ailesi kafa grubunda 0.35 N·m (27 cm) × k_head 1.37–1.91 = 0.48–0.67 N·m istiyor; MG90S bunun ancak 0.32–0.45 katını veriyor. Boyun hızlı savrulduğunda head_pitch geri sürülüyor; bu anlarda 'kafa q = komut' gözlemi yanlış oluyor ve plastik iç dişliler darbe alıyor. (3) 27 cm modelden üretilen düşmüş bankada (n=512) sırt %35, yüz %25, yan %40 (scratchpad/s9/rl/bank.py). Diğer modlar %100 olsa, sırt başarısı %43'te kalsa bile A6 'genel ≥ %80' geçiyor. Eski eval mod başına ≥ %85 istiyordu; spec bunu kaldırıyor.
  Öneri: Tam eğitimden önce ucuz bir yapılabilirlik kapısı koy: (a) Kafa eklemleri sabit, toplanmış pozda (aksiyon dışı) iken, kafa torku sınırlı ve sınırsız iki kısa getup koşusu yap; başarıyı mod başına raporla. (b) A6'yı mod başına raporla (Wilson %95). Sırt için ya ayrı bir taban koy ya da açıkça 'v1'de sırttan kalkma yok' kararı yaz. (c) A6'ya MG90S |τ|/stall p95 ve doygun adım oranını ekle. (d) head_pitch MG90S wiper'ını ADS1115'in boş 4. kanalına alıp pot olarak gözleme koy, ya da getup'ta kafa eklemlerini aksiyon uzayından çıkar. (e) main'i getup'tan önce eğit; onun da bir referans sonucu yok.

- [SEV: major] **rl-sim/RL-4** (§3.2.3 (boşluk), §3.2.4 (bias)) Boşluk (0–1.5°) 'konum gürültüsü' olarak modellenmiş. Oysa fiziksel etkisi dinamikte: yük yön değiştirdiğinde eklemin sertliği sıfır olan bir bant oluşur. Pot ise çıkış milini ölçer. Komut→açı eşleme hatası da yalnız bir gözlem biası olarak temsil ediliyor.
  Somut senaryo: Gürültü adım başına bağımsız ±0.75° ise, 200 Hz fark + IIR(α 0.47) sonrası σ_qd ≈ 1.18 rad/s yapay hız gürültüsü çıkar (mevcut OBS_NOISE joint_vel ±0.5'in ~4 katı). Gerçek pot çıkış milinde olduğu için gerçekte böyle bir gürültü yok; politika qd'yi yok saymayı öğrenir. Gürültü bölüm başına sabitse ±1.5° pot biasının kopyası olur. Her iki durumda da yük dönüşümünde (diz: basma↔salınım geçişi; hip_roll'da çift destekte ~0 yük) eklemin serbest kaldığı bant simde yok. Seçilen montaj (25T kol, 0.2 mm boşluklu baskı cebinde, r = 20 mm) tek başına pot dışında 0.57° boşluk veriyor. Komut tarafında: firmware kalibrasyonu pot okumasını doğru kabul ettiği için gerçekte gözlem = komut, gerçek açı = komut − bias. Simde ise gerçek açı = komut, gözlem = komut + bias. Politika 'gözlem tutarlı ama poz yanlış' durumunu hiç görmüyor. Potsuz kafa eklemlerinde (MG90S birim başına kalibre ediliyor) 'gerçek açı ≠ komut = gözlem' durumu hiç modellenmiyor.
  Öneri: (a) İç dişli boşluğunu mevcut ölü bant şekillendirmesine ekle: e' = sign(e)·max(|e| − (db + bl_in)/2, 0). MJX'te ek maliyeti yok, play eklemine gerek kalmaz. (b) Pot dışındaki horn/link boşluğunu tork yönüne bağlı bir gözlem ofseti olarak ekle: q_obs = q + (bl_out/2)·tanh(τ_net/τ0). Bağımsız konum gürültüsünü kaldır. (c) Pot biasından bağımsız, eklem başına bir komut ofseti DR'ı (bacak ±1°, kafa ±3°) gerçek hedefe uygula. (d) Adım 0'da 100 mm kolla iki yönlü boşluk ölçümü zaten listede; sonucu bl_in/bl_out değerlerine yaz.

- [SEV: major] **rl-sim/RL-5** (§3.2.4 sensör modeli, §2) Sensör modeli IMU'yu ve tutum filtresini kapsamıyor; politika gerçek kuaterniyon artı bağımsız gürültüyle eğitiliyor. 'sensors.py firmware'in birebir kopyalayacağı tek tanım' iddiası IMU olmadan eksik kalıyor.
  Somut senaryo: Spec'te IMU ya da tutum modeli için tek satır yok; yalnız §2 'gömülü uygulamayı' kapsam dışı bırakıyor. Gerçek robotta izdüşümlü yerçekimi bir Mahony veya tamamlayıcı filtreden gelecek. 0.1 s'lik 0.25 m/s itme yaklaşık 2.5 m/s² yatay ivme demek; ivmeölçerde atan(2.5/9.81) ≈ 14° eğim hatası doğar, filtre sonrası bu birkaç derece ve yüzlerce ms süren ilişkili bir hataya dönüşür. Düşme ve kalkma darbelerinde ivme 2–5 g'ye çıkar. Sim yalnız ±0.05 (±2.9°) beyaz gürültü veriyor. Getup'ın düşme modunu anlaması ve süpervizör geçişi (gz > −0.6, 5 adım) aynı tahmine dayanıyor. Filtre bir sonraki turda tanımlandığında tüm politikalar yeniden eğitilmek zorunda kalır.
  Öneri: sensors.py'ye sabit kazançlı bir Mahony filtresini şimdi ekle. MJCF'de gyro ve accelerometer zaten var (openduck.xml:270–271); MJX accelerometer'ı C ile aynı hesaplıyor (scratchpad/s9/rl/acc.py). Filtre durumunu 200 Hz alt adımda taşı. DR: gyro bias ±0.01 rad/s, montaj hatası ±2°, ivme gürültüsü. Filtre kazançlarını policy_meta'ya yaz.

- [SEV: major] **rl-sim/RL-6** (§3.2.4 (pot modeli), §7 Adım 0) Pot modelinde üç şey eksik: ray çökmesinden gelen ortak-mod hata, ADC beyaz gürültüsü ve boyunun ADS1115 yolunun farklı dinamiği.
  Somut senaryo: (a) Pot servo rayından besleniyorsa okunan wiper = x·V_servo olur. 9 DS'nin paylaştığı 6.5 V rayda 18 A tepe / 6.2 A RMS akımla 50–150 mV çökme, orta konumda (x≈0.5) ve 19.4 mV/° ile 1.3–3.9° hata verir. Bu hata tüm bacak ve boyun potlarında aynı anda, konuma ve öbür eklemlerin akımına bağlı olarak oluşur. Spec'in eklem başına 'toprak düşümü biası' bunu temsil edemez; hata ±1.5° bias bütçesini de aşar. Adım 0 yalnız wiper aralığını ve monotonluğu ölçüyor; pot beslemesinin raydan mı iç regülatörden mi geldiğini ölçmüyor. (b) Güç raporu ham ADC gürültüsünü 2–6 LSB RMS (motor PWM kuplajı hariç) tahmin ediyor; spec'te yalnız 12-bit kuantalama var. Bu durumda simde σ_qd ~0.1 rad/s, gerçekte ~0.6 rad/s'ye kadar çıkabilir. (c) Boyun potu ADS1115 üzerinden okunuyor (16-bit, 860 SPS'yi 2 NTC ile paylaşıyor, I²C dönüşüm ve okuma gecikmesi var), ama spec ona da ESP32 ADC modelini (12-bit, RC 3.2 ms, 1 alt adım) uyguluyor.
  Öneri: Adım 0'a 'sabit açıda wiper gerilimini 6.0/6.5/6.8 V'ta ölç' adımını ekle. Pot raydan besleniyorsa ray gerilimini boş ADS1115 kanalına (ya da 0x49'da ikinci bir ADS1115'e) al, firmware'de oranlı düzeltme yap ve sensör modeline toplam akıma bağlı ortak-mod terimiyle DR ekle. Beyaz gürültü N(0, σ) ekle; σ'yı Adım 0'da yüklü servodan kaydedilen ham ADC verisinden al. Boyun için ayrı bir kanal modeli kur (çözünürlük, örnekleme anı, gecikme).

- [SEV: major] **rl-sim/RL-7** (§3.2.5 (zaman ölçekleri), §6 A5) 'Zaman ölçekleri Froude (√s) × κ' kuralı main görevine de uygulanırsa A5 pencereleri yapısal olarak tutmaz; spec kuralın main için geçerli olup olmadığını söylemiyor.
  Somut senaryo: Bugün STAND_RAMP_S = SIT_RAMP_S = 2.5 s, kalkış penceresi 3.0 s, oturuş penceresi 3.5 s. ×√s/κ ile: κ 0.6'da rampa 4.72 s, pencereler 5.66/6.60 s; κ 0.5'te rampa 5.66 s. A5'in 'kalk ≤ 4.0 s' sınırı referans rampanın kendisinden kısa kalıyor; politika rampadan hızlı kalkmadıkça başarı %0 olur. κ = 1 ile (rl-map önerisi) rampa 2.83 s, pencereler 3.40/3.96 s çıkıyor ve A5 ile uyumlu.
  Öneri: κ'nın yalnız yürüyüş için (GAIT_FREQ, komut aralıkları, AIR_TIME_TARGET) geçerli olduğunu, main rampaları ve pencereleri için λ_t = √s (κ=1) kullanıldığını açıkça yaz. A5 eşiklerini bu türetmeden ver; örneğin kalkış için 3.4 s artı bir pay.

- [SEV: major] **rl-sim/RL-8** (§4 ('değişiklikler sabit/model/aktüatör/sensör katmanında'), §6 A4–A6) A4–A6 mevcut eval_tasks ile ölçülemiyor, eval değişiklikleri de iş planında yok. A4'ün istatistiği de zayıf.
  Somut senaryo: eval_tasks.py'de şunlar yok: dönüş takibi (±%20) metriği; eklem başına τ RMS/p99 (yalnız max|τ| > 0.864 N·m olan adımların oranı var); hip_yaw RMS. Getup değerlendirme süresi A4_S = 6.0 s olarak sabit, A6 ise 12 s istiyor. A4'ün hangi politikayla (walk mı, robotta koşacak main mi) ölçüleceği belirsiz; eski A1 main'in yürüyüşünü walk'a karşı ölçüyordu. §4 ise değişikliklerin sabit/model/aktüatör/sensör katmanıyla sınırlı olduğunu söylüyor, yani eval kodu planlanmamış. İstatistik: 64 bölümde 'düşme ≤ %3' en fazla 1 düşme demek. Gerçek düşme oranı %3 olan bir politika %42, %5 olan %16 olasılıkla geçer; %1 olan ise %13.5 olasılıkla kalır. A5'in ≥ %95 eşiği için bölüm sayısı hiç verilmemiş.
  Öneri: İş listesine eval_tasks için A4/A5/A6 bölümlerini ekle: dönüş oranı, eklem sınıfı başına τ_net ve duty istatistikleri, hip_yaw RMS, 12 s getup, mod başına oranlar. Düşme için ≥ 512 bölüm kullan ve kabulü Wilson üst sınırı ≤ %3 olarak tanımla (wilson() kodda hazır). A4'ü main politikasının yürüyüş segmentinde de koş. A5 için N'yi yaz.

- [SEV: minor] **rl-sim/RL-9** (§3.2.6, §6 A7) 256-128-64 aktör her görev için zorunlu tutulmuş, ama bunun yeteceğine dair kanıt yok. Repoda eğitilmiş tek politika 512-256-128 swish ile eğitildi; getup TaskSpec'i de (512, 256, 128).
  Somut senaryo: Getup ya da main 256-128-64 ile A5/A6'yı tutturamazsa sorunun ağ kapasitesinden mi fizikten mi kaynaklandığı ayrılamaz. A6'nın 'neden + tek donanım değişikliği' raporu da yanlışlıkla donanımı suçlayabilir.
  Öneri: Ayrıcalıklı bir 512-256-128 öğretmenden 256-128-64 öğrenciye damıtmaya (DAgger/BC) izin ver; A7 öğrenciye uygulansın. Ucuz bir karşılaştırma da yap: walk-mjx-v2 logu 200M adımın ~239k sps ile 17.5 dakikada bittiğini gösteriyor, yani 27 cm walk'ı 256-128-64 ile koşmak yaklaşık 20 dakika sürer.

- [SEV: minor] **rl-sim/RL-10** (§3.2.3 (ölü bant), §4 DR, §7) 'Ölü bant 3–10 µs' bütün sınıflar için tek aralık olarak verilmiş. Analog MG90S/SG90'ın 50 Hz'deki davranışı DS ile aynı P-band modeliyle temsil ediliyor ve Adım 0'da test edilmiyor; oysa kafa gözlemi tamamen bu modele bağlı.
  Somut senaryo: 3–10 µs; DS için 0.27–0.9°, MG90S/SG90 için (1000–2000 µs = 180° varsayımıyla 0.18°/µs) 0.54–1.8° eder. Analog servolar 50 Hz'de motoru darbe başına sürer (Pololu), bu yüzden küçük hatadaki torkları P-band modelinin verdiğinden düşüktür. Etkin ölü bant 1.8° ve P-bandı 8° iken %48'lik yerçekimi yükü kafayı komuttan 4–6° saptırır ve bu sapma gözlemde görünmez. Adım 0 yalnız DS3230, DS3225 ve ES3054'ü kapsıyor.
  Öneri: Ölü bandı sınıf başına µs × °/µs olarak ver. Analog sınıflar için P-band DR'ını 15°'ye kadar genişlet. Adım 0'a bir MG90S için basamak ve yük altında tutma testi ekle (pot, kalibrasyon için geçici olarak okunabilir).

## Lens: scope-acceptance

Overall: Spec'i kapsam, sıralama ve kabul kriterleri açısından inceledim: 1 kritik, 10 major ve 1 minor itiraz çıktı. Kabul kriterlerinin birkaçı spec'in kendi varsayılanlarıyla ve research sayılarıyla tutarsız; bunlar düzeltilmeden tur kabul edilemez ya da ilk RunPod eğitimi boşa gider.

En önemli bulgular:
- **A2 (bütçe):** Varsayılan DS kaynağı Motorobit olduğu için 20k TL tavanı yapısal olarak aşılıyor. Zorunlu liste yaklaşık 29.9k TL tutuyor; yalnız servolar, kartlar ve LiPo bile 22.9k TL.
- **A4 (tork metriği):** τ'nun actuator_force mu τ_net mi olduğu tanımsız. Harfiyen okunursa P-bandı 3° olan servoda p99 ≈ 1.0 çıkar ve kriter iyi bir politikada bile düşer.
- **κ başlangıcı:** Spec eğitime κ 0.6 ile başlıyor; kendi kapısı varsayılan Blue servo (5.72 rad/s) için κ 0.5 diyor. Geniş DR köşesinde u = 1.18.
- **A1 kütle ile A4 ısıl kriteri:** 1.80–1.90 kg'da diz RMS'i 1.02–1.08 N·m, Blue için stall/3 ise 0.96. Spec'in önerdiği çıkış yolları (κ'yı düşürmek, DS3225) ısıl sorunu çözmüyor.
- **A6 (kalkma):** Kafa servolarına binen yük sınırlanmıyor. Simde bu yükü eklem-sınırı kısıtı taşıyor; güçlü boyunlu strateji MG90S'leri stall'larının birkaç katıyla yükleyebilir ve böyle bir politika yine de geçer.
- **Adım 0:** Ölçümler varsayılanları çürütürse izlenecek yol yazılmamış (ω0 < 4.89, pot başarısız, 300 Hz ya da 3.3 V reddi, DS3225 seçimi). sysID aracı kapsamda değil ve kabul eğitiminin Adım-0 öncesi mi sonrası mı olduğu belirsiz.
- **A1 eklem sınırları:** Kriter totolojik; görev aralıklarını kapsama şartı yok. hip_pitch'in −75° alt sınırı servo ucuna yalnız 0.6° pay bırakıyor, §4'teki 5° kuralıyla çelişiyor.
- **Sıralama:** CAD ile RL arasında dondurma kapısı tanımlı değil. §4 RL değişikliklerini yalnız sabit, model, aktüatör ve sensör katmanında gösteriyor; oysa iş backend alt-adım döngülerine dokunuyor.
- **XL330 profilinin kaldırılması:** Refactor'u doğrulayacak golden snapshot ve walk regresyon testleri kayboluyor.
- **Tutum filtresi:** sensors.py'de yok, gravity gözlemi bir sonraki turun firmware kararına sessizce bağlanıyor.
- **Eksik kriterler:** main'in yürümesi, MG90S torku, getup'ta mod başına başarı ve görev devri ölçülmüyor; önceki spec'teki bazı kriterler sessizce düşmüş.

Spec'teki hiçbir kabul kriteri gerçek robot gerektirmiyor; sorun test edilebilirlik değil, tanım belirsizliği ve sayıların tutarsızlığı.

Hesap betikleri şu klasörde: /private/tmp/claude-501/-Users-huseyinarslan-Desktop-ads-z-klas-r-2/8217cd75-2c54-4fa4-b47f-57c38ee96c2b/scratchpad/s9/scope/
- calc.py: u kapısı, DR köşesi ve diz ısıl hesabı.
- bom.py: zorunlu BOM toplamı.

Repo'ya dokunulmadı.

- [SEV: critical] **scope-acceptance/SC-1** (§4 (kaynak seçimi) + §6 A2) A2'deki bütçe tavanı, spec'in kendi seçtiği varsayılan kaynakla tutturulamıyor. §4, DS servolar için varsayılan kaynağı Motorobit yapıyor (1.939,20 TL/adet, KDV dahil, 48 stok). A2 ise zorunlu toplamın ≤ 20.000 TL, yedeklerle ≤ 24.000 TL olmasını istiyor. Yalnız 9 DS 17.452,80 TL tutuyor. Buna ES3054×2, MG90S×3 ve SG90 (1.849 TL), ESP32-S3 + 2×PCA9685 + MPU6500 (1.032,97 TL) ve Profuse LiPo (2.528,23 TL) eklenince 22.863 TL oluyor. Bu rakama şarj cihazı, güç ve kablo hattı, filament, F623ZZ rulmanlar ve ADS1115 dahil değil. Research fiyatlarıyla tam zorunlu liste yaklaşık 29.860 TL (şarj cihazı hariç 28.064 TL), yedeklerle yaklaşık 33.740 TL. Direnc ile (1.046,12 TL, yalnız 15 stok) bile yaklaşık 21.823 TL ediyor. Hesap: scratchpad/s9/scope/bom.py.
  Somut senaryo: export.py BOM'u spec'teki kaynakla üretir ve A2 kontrolü ilk build'de yaklaşık 10k TL farkla düşer. Sonrasında ya kriter sessizce gevşetilir ya da BOM Direnc'e çevrilir. Direnc'e geçmek §4'ün Motorobit'i seçme gerekçesini bozar: stok 15, marka ve sürüm belirsiz, 180°/270° bilgisi yok.
  Öneri: Tavanı research toplamından türetin (ör. zorunlu ≤ 31k, yedeklerle ≤ 35k TL) ya da kullanıcıdan açık bir tavan alın. BOM'da DS için iki kaynak sütunu ve her kaynağa göre ayrı toplam olsun.

- [SEV: major] **scope-acceptance/SC-2** (§3.2.5, §3.2.3, §6 A4) A4'teki tork metrikleri tanımlı değil ve harfiyen okunursa sert P-bantlı servoda sağlanamaz. 'diz |τ|/stall p99 ≤ 0.85' ve 'RMS ≤ stall/3' maddelerinde τ'nun actuator_force mu, yoksa rl-map'in τ_net = actuator_force − b·qd tanımı mı (akımla orantılı gerçek motor torku) olduğu yazmıyor. 'stall'ın nominal mi DR-örneklenmiş mi olduğu da yazmıyor. kp = τs/3° olduğundan 3°'yi aşan her izleme hatası actuator_force'u kırpılma sınırına götürür. 1.32 Hz yürüyüşte diz 40–60°'yi yaklaşık 0.3 s'de katediyor; hedefler de adım başına birkaç derece sıçrıyor. Bu yüzden hata rutin olarak 3°'yi aşar ve actuator_force p99/τs ≈ 1.0 olur. Oran DR-örneklenmiş forcerange'e bölünürse yapısal olarak ≤ 1 kalır ve doygunluk 1.0'da birikir. 'Dönüş komutunu ±%20 izler' maddesinde de hangi wz değerlerinin ve hangi ölçüm penceresinin kullanılacağı belli değil.
  Somut senaryo: eval_tasks'ta A4 actuator_force ile yazılırsa iyi bir politikada bile p99 = 1.00 raporlanır ve kriter düşer. τ_net ile yazılırsa geçer. İki uygulayıcı aynı politika için zıt hüküm verir, kabul kararı uygulama ayrıntısına kalır.
  Öneri: Metriği τ_net (akım vekili) ve nominal τs üzerinden tanımlayın. p99 yerine 'doygun adım oranı < %x' koyun ya da kontak darbelerini hariç tutun. Dönüş için sabit komutlar (ör. wz ∈ {±0.3, ±0.5} rad/s) ve kararlı durum penceresi belirtin.

- [SEV: major] **scope-acceptance/SC-3** (§3.2.5, §4 (DR), §7 kapı, §6 A4) Başlangıç κ değeri spec'in kendi Adım-0 kapısıyla çelişiyor; kabulde hangi DR'nin kullanılacağı da belirsiz. Varsayılan servo DSSERVO Blue, ω0 = 5.72 rad/s. §7 kapısında bu değer < 5.87 olduğu için κ 0.5 satırına düşer, oysa spec eğitime κ 0.6 ile başlıyor. Kapının formülüyle (u ≤ 0.85, 2.88 N·m) Blue ve κ 0.6 için u = 0.867 (1.80 kg) ile 0.876 (1.90 kg) arasında çıkıyor. Kapı eşikleri 1.80 kg için hesaplanmış, A1 ise 1.90 kg'a izin veriyor; aynı eşikler 1.90 kg'da u = 0.858 verir. §4'teki DR'nin köşesinde (tork ×0.7 ile ω0 ×0.75 aynı anda) u = 1.18: diz komutu fiziksel olarak takip edemez. A4 'DR + itme açık' diyor ama Adım-0 öncesi geniş DR mi, sysID sonrası dar DR mi kastedildiği yazmıyor. Hesap: scratchpad/s9/scope/calc.py.
  Somut senaryo: walk ve main RunPod'da κ 0.6 ile eğitilir. A4 geniş DR ile ölçülür, köşe örneklerde diz doygun kalır, düşme > %3 ve p99 > 0.85 çıkar. Adım 0 Blue hızını doğrularsa kapı κ 0.5 der ve ilk eğitim turunun tamamı (GPU maliyeti dahil) boşa gider.
  Öneri: Varsayılanı kapıyla tutarlı yapın: Blue için κ 0.5, ya da kapı eşiklerini 1.90 kg için yeniden hesaplayın. Kabul için ayrı bir DR tablosu tanımlayın (ör. sysID sonrası ±%15). Geniş Adım-0 öncesi DR yalnız sağlamlık raporu olsun.

- [SEV: major] **scope-acceptance/SC-4** (§4 kütle bütçesi, §5.1, §6 A1/A4) Research sayılarına göre A1'in kütle tavanı ile A4'ün diz ısıl kriteri birlikte sağlanamıyor; spec'in önerdiği çıkış yolları da yanlış. R12 ve torque-needs, yürüyüş-DR'de diz RMS'ini 0.30 N·m × k ile ölçekliyor: 1.80 / 1.85 / 1.90 kg için 1.02 / 1.05 / 1.08 N·m. Blue için stall/3 = 0.96 N·m olduğundan A4'ün 'RMS ≤ stall/3' maddesi A1'in izin verdiği her kütlede düşüyor. Critic 1.85 kg tasarım hedefi ve k = 3.5 önermişti; spec tavanı 1.90 kg'a çıkarmış. §5.1'deki çıkış yolları şunlar: (a) κ'yı düşürmek. Ancak research dizin hızla sınırlı olduğunu, RMS'in kütleye bağlı olduğunu ve 'lean walk'ta RMS'in değişmediğini söylüyor. (b) DS3225'e geçmek. Onun stall/3 değeri 0.90, yani daha kötü; R12'ye göre 1.65 kg'da bile düşüyor. Yalnız DS3230 Red (1.10) 1.90 kg'da sınırda geçiyor.
  Somut senaryo: CAD 1.88 kg çıkar ve A1 geçer. Tork cezasına rağmen walk politikası dizde yaklaşık 1.0 N·m RMS verir ve A4 düşer. Spec'in dediği gibi κ düşürülüp yeniden eğitilir, RMS neredeyse değişmez. DS3225'e geçilirse kriter daha da uzaklaşır.
  Öneri: A1 tavanını 1.80–1.85 kg'a çekin ya da ısıl kriteri kütleye bağlayın. §5.1'deki çıkış yollarını düzeltin: dizi daha az büken bir HOME/H_HOME, DS3230 Red, diz tork cezasının ağırlığı. DS3225'i ısıl yedek listesinden çıkarın.

- [SEV: major] **scope-acceptance/SC-5** (§3.2.5 getup, §5.5, §6 A6) A6, kafa servolarına binen yükü sınırlamıyor; simde bu yükü eklem-sınırı kısıtı taşıyor. Yeni kalkma stratejisi 'güçlü boyun + bacaklar'. Temas noktası kafa olduğunda boyun DS'in torku, MG90S head_pitch, head_roll ve head_yaw eklemleri üzerinden akar (stall 0.216 N·m, iç dişliler plastik). Kaba geometri şöyle: head_pitch ekseni neck_pitch'in yaklaşık 64 mm üstünde, kafa ucu ya da gaga head_pitch'ten yaklaşık 90 mm uzakta. Bu durumda head_pitch'e binen moment ≈ 0.58·τ_neck; τ_neck = 1 N·m'de bu yaklaşık 0.58 N·m, yani MG90S stall'ının 2.7 katı. Politika head_pitch'i sınırına komutlarsa ctrl = sınır olur, aktüatör kuvveti ≈ 0 kalır ve torque_sat cezası çıkmaz; yükü MuJoCo'nun eklem-sınırı kısıtı taşır. Gerçek robotta aynı yük MG90S dişlisine biner. A6 kafa-zemin kuvvetinin yalnız medyanını 'raporluyor', eşik koymuyor; önceki spec < 20 N istiyordu.
  Somut senaryo: Getup politikası kafayı sınırda kilitleyip üçüncü bir bacak gibi kullanmayı öğrenir ve %85 başarıyla A6'yı geçer. Sonraki turda ilk gerçek kalkmada head_pitch MG90S'in dişlisi sıyrılır.
  Öneri: A6'ya şu kriteri ekleyin: MG90S ve ES3054 eklemlerinde |aktüatör torku + qfrc_constraint (sınır)| p99 ≤ 1.0·τs. Kafa-zemin tepe kuvvetine de bir eşik koyun (ölçekli yaklaşık 49 N ya da daha düşük). Ödüle sınır-kısıtı kuvveti için ceza terimi ekleyin.

- [SEV: major] **scope-acceptance/SC-6** (§7, §3.2.3, §3.2.4, §3.3) Adım 0 varsayılanları çürütürse ne yapılacağı tanımlı değil; bench verisini parametreye çevirecek sysID yolu da kapsamda yok. Ayrıntılar: (1) Kapı yalnız ω0'ı kapsıyor, < 4.89 rad/s için satırı yok. (2) Pot yoksa, monoton değilse ya da 1 V'tan dar çıkarsa B2 sensör modeli geçersiz kalıyor, ama ne yapılacağı yazmıyor. (3) §7'nin ölçüm listesinde 300 Hz çerçeve kabulü, 3.3 V darbe kabulü, pot beslemesi (ray mı iç regülatör mü; 0.9 ile 2.7°/A arası fark) ve stall torku yok (yalnız akım ölçülüyor). Hâlbuki aktüatör ve sensör modeli 300 Hz, 0.8 µs çözünürlük, U{0..2} gecikme ve toprak-düşümü eğimini sabit kabul ediyor. (4) DS3225 de tezgâhta ve kazanırsa 2.88 N·m için hesaplanmış kapı geçersiz olur, ısıl durum da kötüleşir. (5) 'Sonuçlar actuators.py'ye işlenir' deniyor ama P-bandı, armatür ve frictionloss'u log'dan çıkaracak tools/sysid kapsamda değil (rl-map D5'te 3–5 gün). (6) Kabul eğitiminin Adım-0 öncesi mi sonrası mı olduğu yazmıyor.
  Somut senaryo: Tezgâhta DS3230 300 Hz'i reddeder ve bacak kartı 50 Hz'e iner. Gecikme U{0..4} alt-adıma, çözünürlük 4.88 µs'ye çıkar. walk, main ve getup politikalarının üçü de yanlış gecikme ve çözünürlük modeliyle eğitilmiş olur, ama tur kabul edilmiş görünür.
  Öneri: §7'ye bir karar tablosu ekleyin: her ölçüm için eşik → parametre güncelle / yeniden eğit / spec'e dön. Eksik ölçümleri listeye ekleyin. ω0 < 4.89 ve pot başarısızlığı için 'dur, spec'e dön' yazın. tools/sysid'i kapsama alın ya da elle parametre uydurma prosedürünü tanımlayın. Turun A4–A6'sının Adım-0 parametreleriyle mi yoksa varsayılanlarla mı koşulacağını açıkça seçin.

- [SEV: major] **scope-acceptance/SC-7** (§3.1 Mekanik, §3.2.2, §4, §6 A1) A1'in eklem-sınırı kriteri totolojik, görev aralıklarını kapsama şartı yok; hip_pitch alt sınırı da §4'teki pay kuralını ihlal ediyor. Eklem sınırları 'servo aralığı ∩ çarpışmasız tarama' diye tanımlandığı için 'sınırlar içinde 0 çarpışma' kendiliğinden sağlanır. Asıl gereken, türetilen sınırların görev aralıklarını kapsamasıdır. R3'e göre bunlar: walk-DR'de hip_pitch −52; sit/stand'de +90 (SEAT_DEG 87.5°, crouch +81°); knee −37…+62; ankle −45…+57; neck 1…40. Yaklaşık 60 mm'lik DS yığını tarama sonucunda hip_pitch üst sınırını ör. +78°'ye düşürürse oturma pozuna ulaşılamaz, A1 yine de geçer. Ayrıca §3.1 hip_pitch için −75…+90 diyor. Bir diş (+14.4°) kaydırılmış 180° servo −75.6…+104.4 aralığını kapsar; alt uçta yalnız 0.6° pay kalır. Bu, §4'ün '5° pay' kuralıyla çelişir. cad-map'in önerdiği _joint assert'i ya build'i düşürür ya da sınırı sessizce −70.6°'ye çeker.
  Somut senaryo: check.py hip_pitch'i +80°'de LiPo ya da gövde kabuğuyla çakıştırır ve sınır +79° olur. crouch_family aracı farklı bir oturuş üretir ya da hiç bulamaz. Sorun ancak A5'te ya da pose bank üretiminde ortaya çıkar; o sırada CAD çoktan kabul edilmiştir.
  Öneri: A1'e 'türetilen sınırlar ⊇ gerekli aralık tablosu (+5° pay)' kriterini ekleyin ve tabloyu spec'e yazın. hip_pitch için ya eklem başına istisna tanımlayın ya da sınırı −70…+90 yapın; walk'un −52 ihtiyacına yeter.

- [SEV: major] **scope-acceptance/SC-8** (§3.2, §3.3, §4 ('değişiklikler sabit, model, aktüatör ve sensör katmanında')) Spec'te CAD ile RL arasında bir sıralama kapısı yok ve değişiklik kapsamı olduğundan küçük gösteriliyor. RL sabitleri son CAD'in kütlesine, COM'una ve geometrisine bağlı: H_HOME, crouch F tablosu ('COM ayak tabanı üstünde' kısıtıyla), SEAT/HEAD_SIT, EXTRA_COLLISION, FEET_MIN_DISTANCE ve pose bankları. Spec bir 'CAD dondurma' ölçütü tanımlamıyor. Efor tahminleri: cad-map 12–16.5 gün, rl-map 27–38 gün. cad-map tahmini DS boynu, G3 hip_yaw itme halkasını, G5 kablo kanallarını ve yaklaşık 550 sabit mm literalinin tam parametrik üreteçlere çevrilmesini içermiyor. §4 değişikliklerin yalnız 'sabit, model, aktüatör ve sensör katmanında' olduğunu söylüyor. Oysa env_mjx'teki fori_loop gövdesinin ve env_cpu'daki mj_step(m,d,4) çağrısının Python alt-adım döngüsüne dönüşmesi backend değişikliğidir (rl-map'e göre 7 gün + parity). TASK.md'nin '512 ortamda ≥ 12.000 env-step/s' CPU hedefi de bu döngüyle tehlikeye giriyor ve spec bunu ele almıyor.
  Somut senaryo: RL, pose banklarını ve crouch tablosunu CAD v1'den üretir ve eğitim başlar. Ardından kablo kanalları ve LiPo yeri için gövde değişir, COM 5–8 mm kayar. Tablolar ve banklar bayatlar, testler düşer, üç görev RunPod'da baştan eğitilir.
  Öneri: Spec'e üç kapı ekleyin. (a) CAD dondurma: kütle ±%3, COM ±3 mm, HOME z ve ayak kutusu sabit. (b) RL altyapısı geçici bir MJCF üzerinde (ölçekli micro + DS kütleleri) geliştirilir. (c) Kabul eğitimi yalnız (a) ve Adım-0 kapısından sonra koşulur. CPU throughput hedefini yeniden belirleyin.

- [SEV: major] **scope-acceptance/SC-9** (§2 (27 cm XL330 profili), §6 A3/A9) XL330 profilinin kaldırılması, refactor'u doğrulayacak tek regresyon referansını siliyor. cad-map'in P0/P1 güvenlik ağı, per-type servo refactor'unun xl330 config'iyle eski MJCF'yi, summary.json'u ve interference.txt'yi bayt-bayt yeniden üretmesiydi. RL tarafında test_walk_regression ve test_walk_meta_unchanged eski formüllerle bit-düzeyinde karşılaştırma yapıyor. Spec ikisini de kaldırıyor ve A9'u 'test takımları geçer' diye bırakıyor. Yeni testler yeni koda göre yazılacağı için bu kriter kendine referanslı olur. A3'teki 'CPU–MJX adım adım tutarlılık' için tolerans ve ufuk da tanımlı değil. Ölü bant ve µs kuantalaması (sign/max/round) float32 ile float64 arasındaki farkı eşik noktalarında büyütecek.
  Somut senaryo: _servo_canon ve SERVO_FRAMES yeniden yazılırken sağ bacakta hip_pitch horn ofsetinin işareti ya da bir inertia çerçevesi ters çevrilir. MJCF geçerli görünür ve A1–A3 geçer. Hata ancak eğitimde asimetrik bir yürüyüş olarak ortaya çıkar, yeniden eğitim günleri harcanır; kıyaslanacak bir referans model yoktur.
  Öneri: Profil kalıcı olmak zorunda değil. Ancak refactor'un ilk aşaması etiketli bir commit olsun: eski 27 cm config, yeni özellikler kapalıyken golden eşitliği geçsin (MJCF bayt-eşit, walk gözlem ve ödülleri bit-eşit). Ardından TR-35'e geçin. A3 parity için tolerans yazın (ör. aynı durumdan tek adım, atol 1e-5, N adım ufku).

- [SEV: major] **scope-acceptance/SC-10** (§2 (tutum filtresi kapsam dışı), §3.2.4) Tutum tahmini (gravity gözlemi) sensör modelinde yok; politikalar sessizce bir sonraki turun firmware kararına bağlanıyor. sensors.py 'firmware'in birebir kopyalayacağı tek tanım' olarak sunuluyor ama yalnız pot, qd, kafa komutu ve gecikmeyi içeriyor. Politika gözleminin ilk 3 elemanı projected gravity. Bunun için filtre (Mahony ya da tamamlayıcı; kazançlar, ivmeölçer reddi), IMU montaj hatası ve gyro biası tanımlı değil (critic G2, rl-map D3). Simde gerçek quaternion + gürültü kalıyor; filtrenin gömülü uygulaması ise bir sonraki tura bırakılmış.
  Somut senaryo: Getup ve SUPERVISOR'ın düşme algılaması (gz > −0.6, 5 adım) çarpmalarda birkaç g'lik ivme altında çalışır. Tamamlayıcı filtre yüzlerce milisaniye boyunca onlarca derece sapar; getup politikası yan yattığı hâlde sırtüstü düştüğünü sanır. Bu turda eğitilen üç politika, firmware turunda filtre eklenince yeniden eğitilmek zorunda kalır.
  Öneri: sensors.py'ye IMU ve tutum filtresini ekleyin (xp-generic, firmware ile aynı kazançlarla); gravity gözlemini filtre çıktısından üretin ve kazançları policy_meta'ya yazın. Bu yapılmayacaksa kapsam notu ekleyin: 'bu turun politikaları filtre eklenince yeniden eğitilecek'.

- [SEV: major] **scope-acceptance/SC-11** (§6 A4–A6 (önceki sit-stand-getup spec'i A1/A3/A4 ile karşılaştırma)) Robotta gerçekten çalışacak davranış için kabul kriterlerinde boşluklar var: main'in yürümesi, kafa servo torku, getup'ta mod başına başarı ve görev devri. A4 yalnız walk görevini ölçüyor; robotta çalışacak olan ise main (yürü + boy + otur), getup ve aradaki SUPERVISOR devri. Önceki spec'teki şu kriterler sessizce düşmüş: 'main takip ödülü ≥ walk'ın %90'ı', 'geçişlerde düşme < %5', 'tork satürasyonu < %1', 'getup her mod ≥ %85', 'kafa kuvveti medyanı < 20 N'. MG90S kafa servoları için hiç tork kriteri yok. rl-map'e göre rastgele-kafa DR'de kafa tepe torku MG90S stall'ının 1.5 katı. Derin çömelmede statik kafa torku yaklaşık 0.11 N·m (stall'ın ~0.5'i), bu da stall/3 = 0.072'nin üstünde. A5'in süreleri (otur 4.5 s, kalk 4.0 s) ne rl-map'in ölçekli pencerelerine (sitdown 4.0 s, standup 3.4 s) ne de config'teki MAIN pencerelerine bağlanmış. Boy RMS tavanı da ölçekli 1.3 cm yerine 1.5 cm.
  Somut senaryo: Getup genel %81 ile geçer: sırt ve yan %95, yüzüstü %40 (4 mod eşit ağırlıkta). main politikası yürürken diz RMS'i walk'tan yüksek çıkar ama bu ölçülmez. Kafa MG90S'leri uzun çömelmelerde ısınır.
  Öneri: A4'ün tork ve takip maddelerini main için de (h = H_HOME, sit = 0) uygulayın. MG90S ve ES3054 için RMS ≤ stall/3 ve p99 ≤ 1.0 kriterleri ekleyin. A6'ya mod başına alt sınır (≥ %60–70) ve tork doygunluk oranı ekleyin. Simde main→getup→main devri için bir senaryo testi yazın. A5 pencerelerini config sabitlerine bağlayın.

- [SEV: minor] **scope-acceptance/SC-12** (§3.1 Geri bildirim, §3.2.4) Boyun potu ADS1115 üzerinden okunuyor ama sensör modeli onu bacaklarla aynı sayıyor; bu, firmware zamanlamasına sessiz bir bağımlılık. §3.1'e göre neck_pitch potu ve iki diz NTC'si tek bir ADS1115'te. ADS1115 en fazla 860 SPS örnekliyor, kanallar mux'lı ve aynı I2C hattında 2×PCA9685 ile INA226 da var. §3.2.4 ise 'bacak + boyun' için tek model veriyor: 12-bit kuantalama, RC τ 3.2 ms, 200 Hz, 1 alt-adım gecikme. ADS1115 16-bit; kendi dönüşüm gecikmesi (1/DR) ve tarama sırası var. 3 kanal sırayla okunursa kanal başına yaklaşık 3.5 ms sürer; PCA yazımlarıyla çakışınca jitter oluşur. Bunların hepsi G1'deki firmware görev düzenine (200 Hz sensör, 50 Hz politika, I2C sırası) bağlı, ama spec bu düzeni sabit kabul ediyor.
  Somut senaryo: Firmware turunda ADS1115 ile PCA yazımları I2C'de çakışır ve boyun okuması 2–3 alt-adım gecikir. Boyun getup'ın ana aktüatörü ve bu turda 1 alt-adım gecikmeyle eğitilmiş olduğundan kalkma salınımlı olur; yeniden eğitim gerekir.
  Öneri: Boyun için ayrı bir sensör sınıfı tanımlayın: ADS1115 kuantalaması, dönüşüm gecikmesi, U{1..3} gecikme DR'si. Bunu policy_meta'ya yazın. '200 Hz örnekleme ve ADS tarama sırası' gereğini spec'e firmware arayüz sözleşmesi olarak not edin.
