Kubudak90/openduck-tr/docs/workflow/sit-stand-getup/research/phys-sit.md

# Can OpenDuck crouch, sit on the floor and stand back up within its servo limits?

Yes. Torque is not what limits these motions; balance and the robot's geometry are. Every path tested here, scripted with position control on the training model, stayed at or below 48% of the 0.96 N·m limit when stand-up took 2 s or more. Two results matter most for the spec:

1. **Getting up from a flat sit needs the head moved back.** If the robot sits with its trunk flat on the floor and the head stays at HOME, it cannot stand up. It always tips forward onto its head. Moving the head back fixes this.
2. **The current setup can't express these poses yet.** The policy's action range, the height termination and the height/orientation rewards all block them (§4).

Everything below comes from scripted position-control runs, not a trained policy. Low-height walking was checked kinematically only.

## 0. The model as measured (`rl.robot_model.build_model()`)

- **Timing and mass:** physics step 5 ms. Total mass 0.6746 kg; the neck subtree is 0.2454 kg (36.4%).
- **Actuators (all 15):** `openduck.xml:7-8` gives kp 1.100, no velocity gain, torque limit ±0.96 N·m. Joint damping is 0.053, armature 0.0018, friction 0.0048. There is no speed-dependent torque limit; damping is the only back-EMF model, so 4 rad/s costs 0.21 N·m. The torque limit is hit at 0.873 rad tracking error; steady sag is 5.2° per 0.1 N·m.
- **HOME:**
  - Geometry: the trunk origin is 0.1183 m above the sole and the trunk box clears the floor by 76.3 mm. The centre of mass (COM) sits 20 mm inside the foot support area (soles span x −20…+34 mm; COM x +0.2 mm).
  - Static torques: hip_roll 0.101 N·m (the largest static load in every standing pose) and knee 0.050.
  - In simulation, raw HOME targets settle at z 0.116, pitched 6–7° nose-down (knee sags about 4°).
- **Sign conventions (left leg):** positive hip_pitch moves the sole backward (−17 mm per +10°). Positive knee moves it forward and up (+10.5 / +5.3 mm). Feet stay flat when trunk pitch + hip_pitch − knee + ankle = −0.01°; positive trunk pitch is nose-down.
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
