Kubudak90/openduck-tr/build/docs/sheet_01_chassis.png

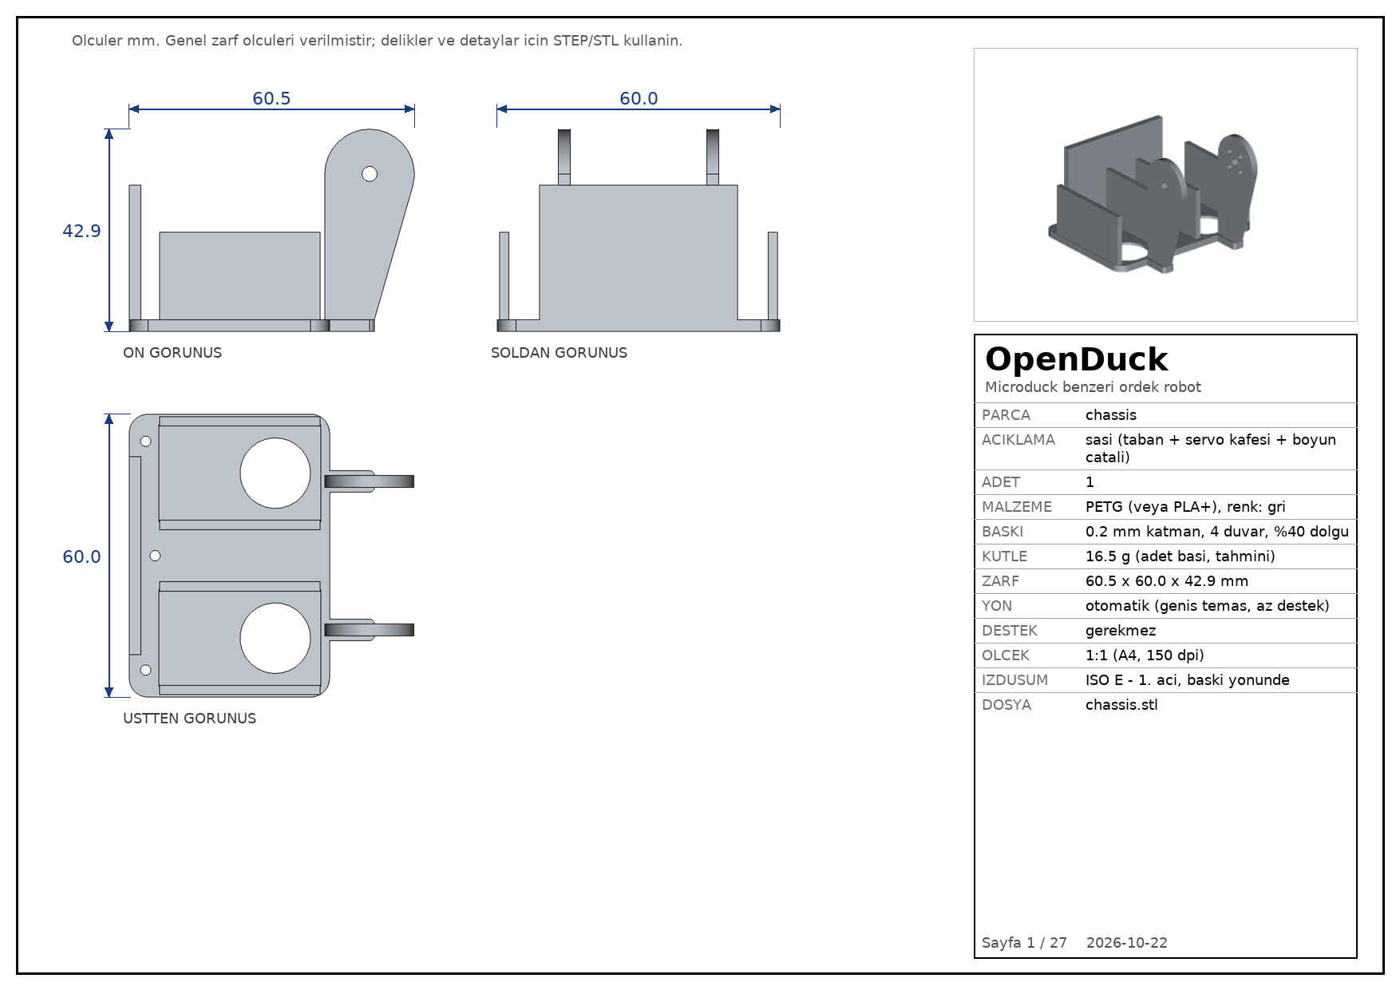
build/docs/sheet_01_chassis.png
