Kubudak90/openduck-tr/build/docs/parts_catalog_2.png

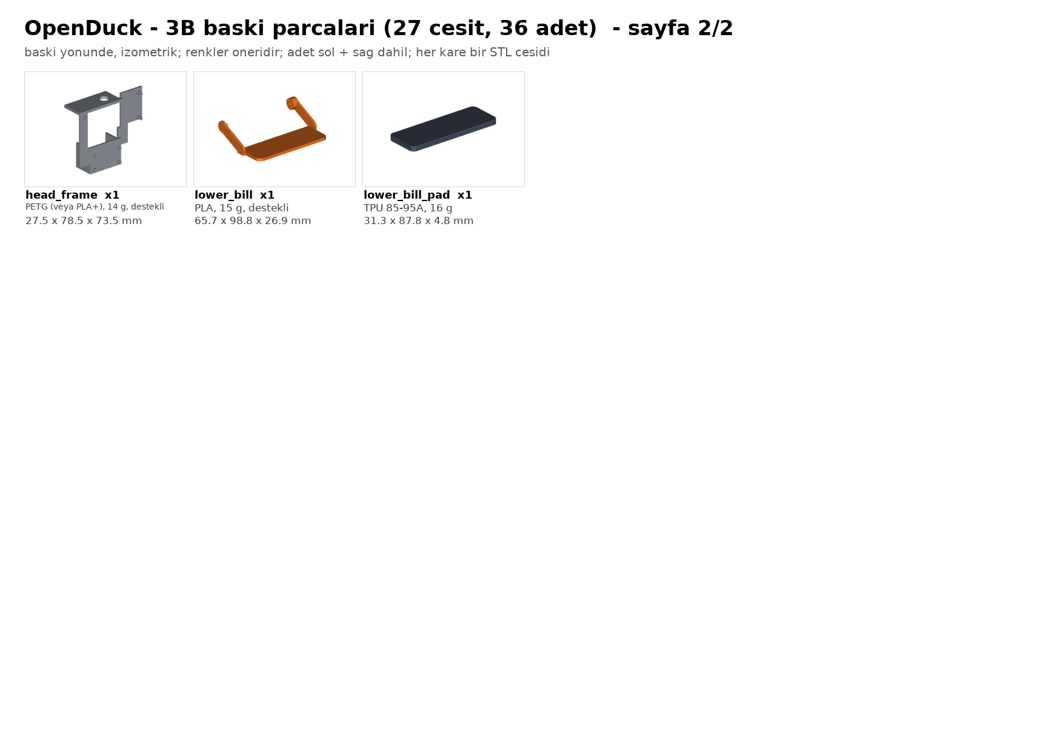
build/docs/parts_catalog_2.png
