Kubudak90/openduck-tr/build/sim/meshes/main_board.stl

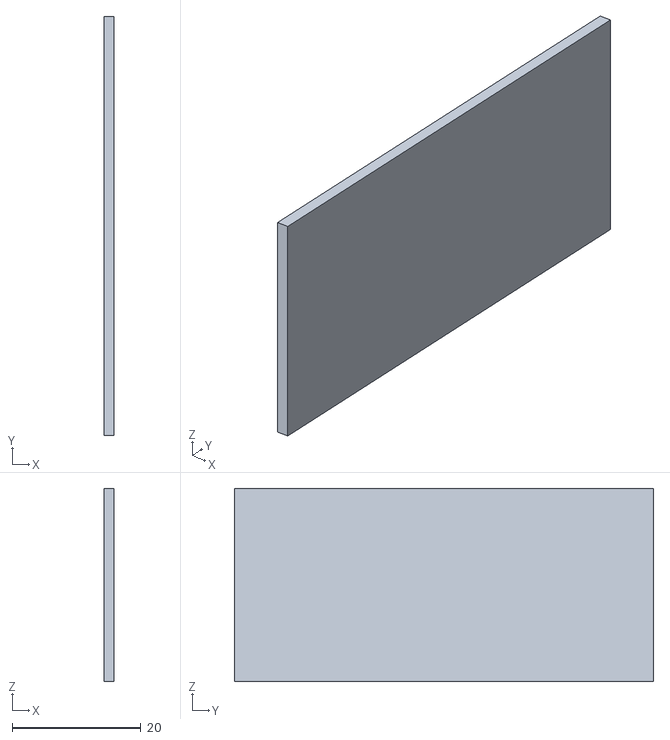
[picture p9: CAD file, 2026-10-23]
build/sim/meshes/main_board.stl
1.60 x 65.0 x 30.0
