Kubudak90/openduck-tr/build/tr35_b2/sim/meshes/main_switch.stl

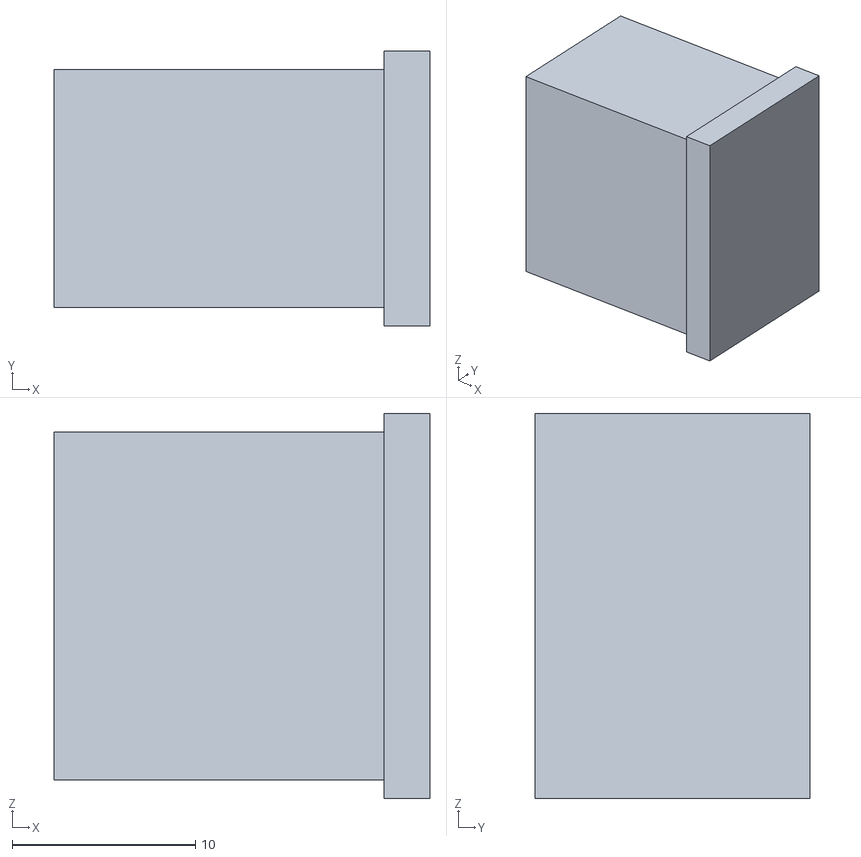
[picture p10: CAD file, 2026-10-24]
build/tr35_b2/sim/meshes/main_switch.stl
20.5 x 15.0 x 21.0
