Kubudak90/openduck-tr/build/openduck.step

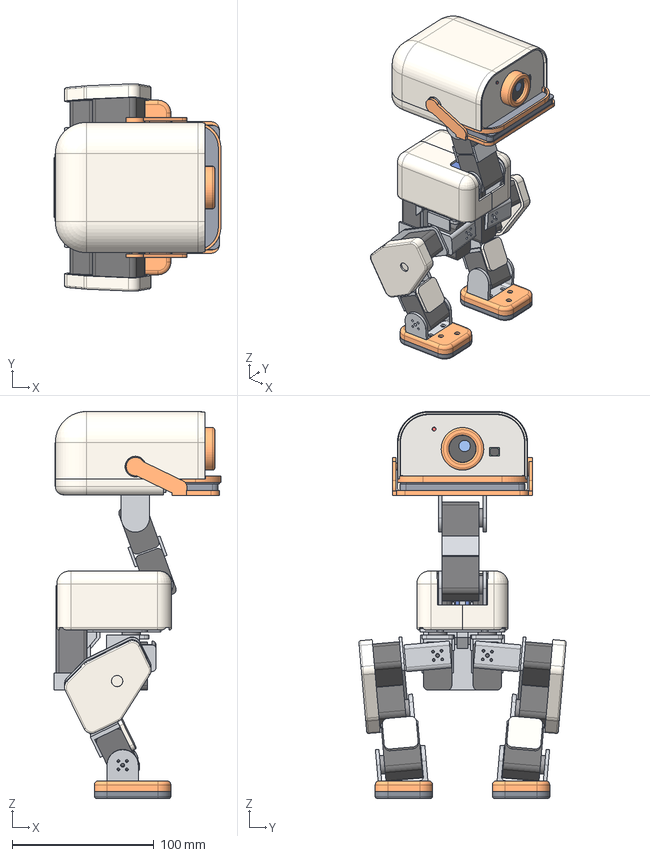
[picture p11: CAD file, 2026-10-23]
build/openduck.step
117.5 x 146.0 x 272.7 mm
chassis
battery_tray
torso_shell_left
torso_shell_right
battery_np_f550
imu_board
imu_chip
power_board
left_hip_yaw_servo
right_hip_yaw_servo
neck_pitch_horn
left_hip_yaw_horn
left_hip_bracket
left_hip_roll_servo
left_hip_roll_horn
left_hip_cradle_bracket
left_hip_pitch_servo
left_knee_servo
left_thigh_inner_plate
left_thigh_wing
left_knee_horn
left_shin_bracket
left_shin_pad
left_ankle_servo
left_ankle_horn
left_ankle_bracket
left_foot_body
left_sole
right_hip_yaw_horn
right_hip_bracket
right_hip_roll_servo
right_hip_roll_horn
right_hip_cradle_bracket
right_hip_pitch_servo
right_knee_servo
right_thigh_inner_plate
right_thigh_wing
right_knee_horn
right_shin_bracket
right_shin_pad
right_ankle_servo
right_ankle_horn
right_ankle_bracket
right_foot_body
right_sole
neck_pitch_servo
head_pitch_servo
neck_splice
head_pitch_horn
head_tilt_bracket
head_yaw_horn
head_yaw_servo
head_turn_bracket
head_roll_horn
head_hood
head_bottom_shell
upper_bill
upper_bill_pad
face_plate
eye_ring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
