Kubudak90/openduck-tr/build/print/stl/left_shin_pad.stl

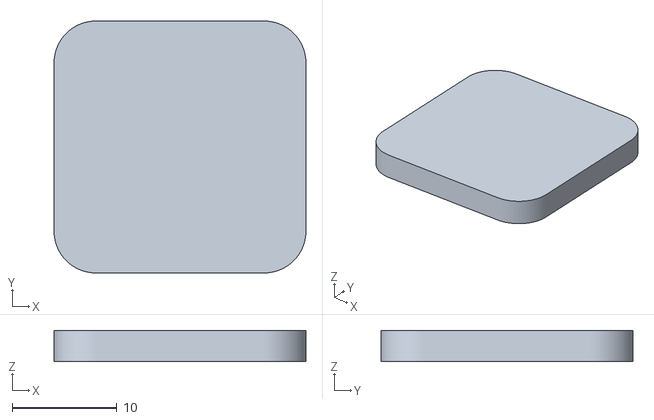
[picture p12: CAD file, 2026-10-23]
build/print/stl/left_shin_pad.stl
24.0 x 24.0 x 3.00
