Kubudak90/openduck-tr/build/sim/meshes/left_hip_roll_servo.stl

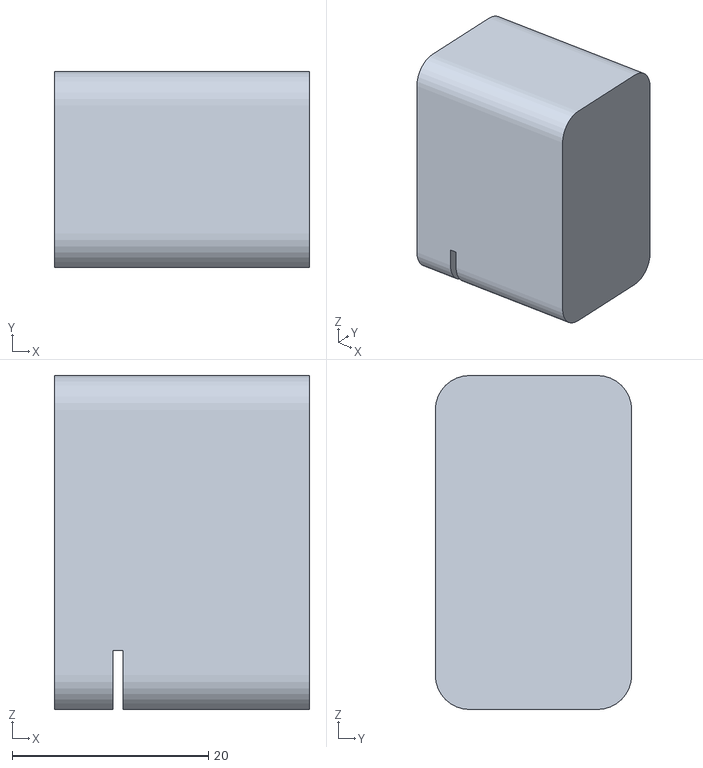
[picture p13: CAD file, 2026-10-23]
build/sim/meshes/left_hip_roll_servo.stl
26.0 x 20.0 x 34.0
