Kubudak90/openduck-tr/build/stl/head_turn_bracket.stl

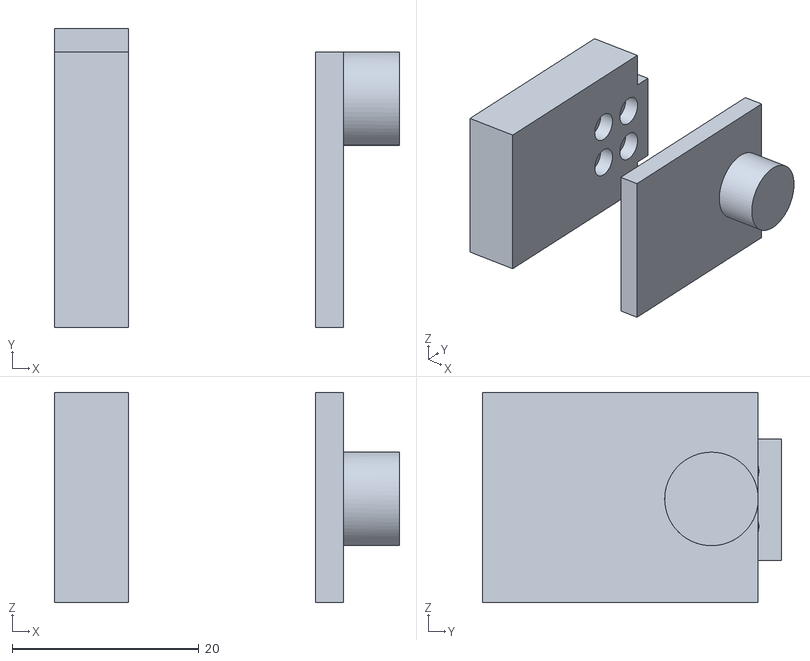
[picture p14: CAD file, 2026-10-23]
build/stl/head_turn_bracket.stl
36.9 x 32.0 x 22.5
