Kubudak90/openduck-tr/build/tr35_b2/sim/meshes/head_roll_servo.stl

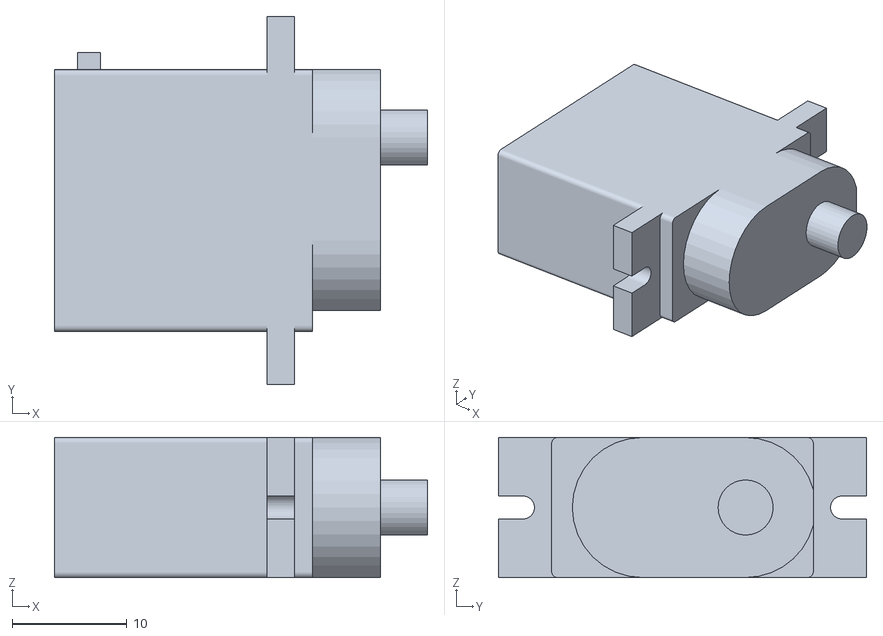
[picture p15: CAD file, 2026-10-24]
build/tr35_b2/sim/meshes/head_roll_servo.stl
32.5 x 32.1 x 12.2
