Kubudak90/openduck-tr/build/print/stl/head_frame.stl

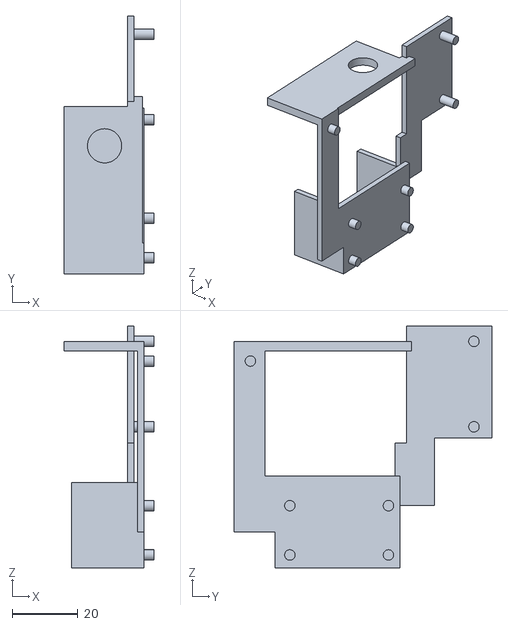
[picture p16: CAD file, 2026-10-23]
build/print/stl/head_frame.stl
27.5 x 78.5 x 73.5
