Kubudak90/openduck-tr/build/stl/neck_splice.stl

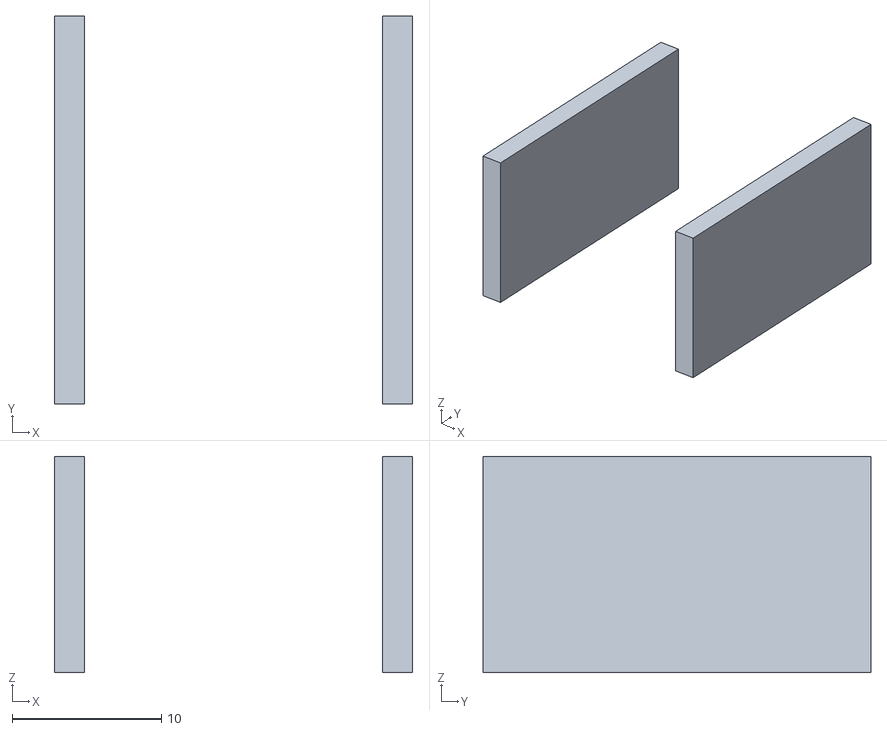
[picture p17: CAD file, 2026-10-23]
build/stl/neck_splice.stl
24.0 x 26.0 x 14.5
