Kubudak90/openduck-tr/build/print/stl/right_hip_cradle_bracket.stl

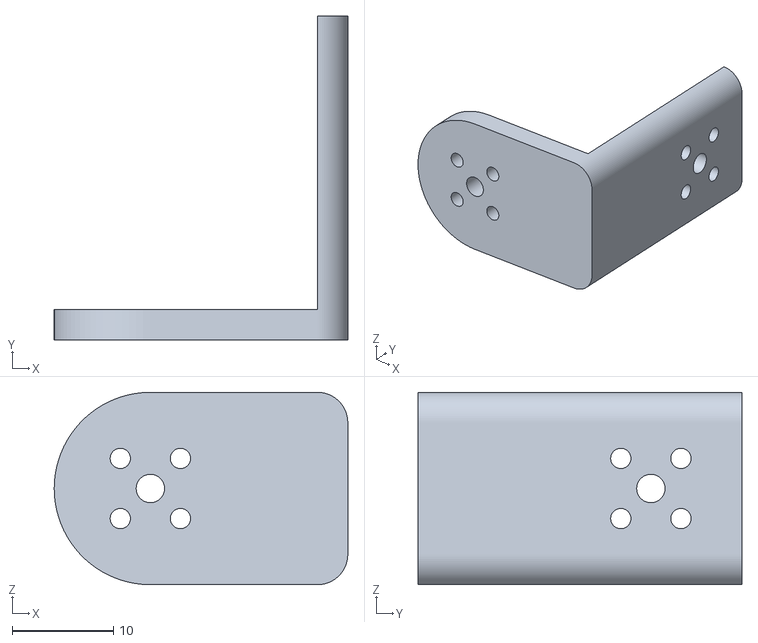
[picture p18: CAD file, 2026-10-23]
build/print/stl/right_hip_cradle_bracket.stl
29.0 x 32.0 x 19.0
