Kubudak90/openduck-tr/build/sim/meshes/head_bottom_shell.stl

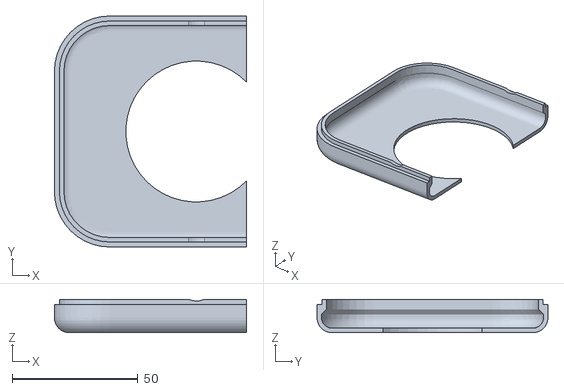
[picture p19: CAD file, 2026-10-23]
build/sim/meshes/head_bottom_shell.stl
76.4 x 91.8 x 13.3
