Kubudak90/openduck-tr/build/tr35_b2/sim/meshes/right_knee_idler_pin.stl

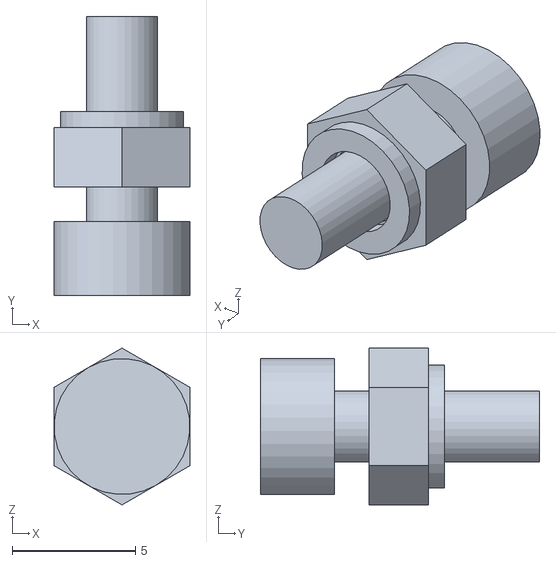
[picture p20: CAD file, 2026-10-24]
build/tr35_b2/sim/meshes/right_knee_idler_pin.stl
5.50 x 11.3 x 6.35
