Kubudak90/openduck-tr/build/print/stl/upper_bill.stl

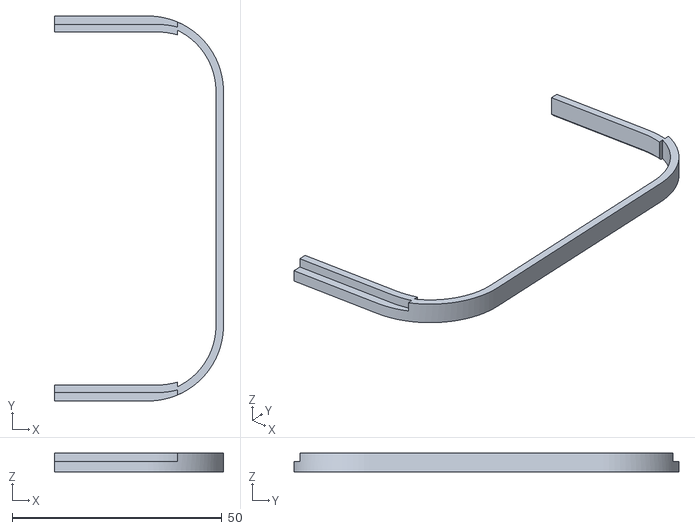
[picture p21: CAD file, 2026-10-23]
build/print/stl/upper_bill.stl
40.3 x 91.8 x 4.50
