Kubudak90/openduck-tr/build/tr35_b2/sim/meshes/neck_pitch_idler_bearing.stl

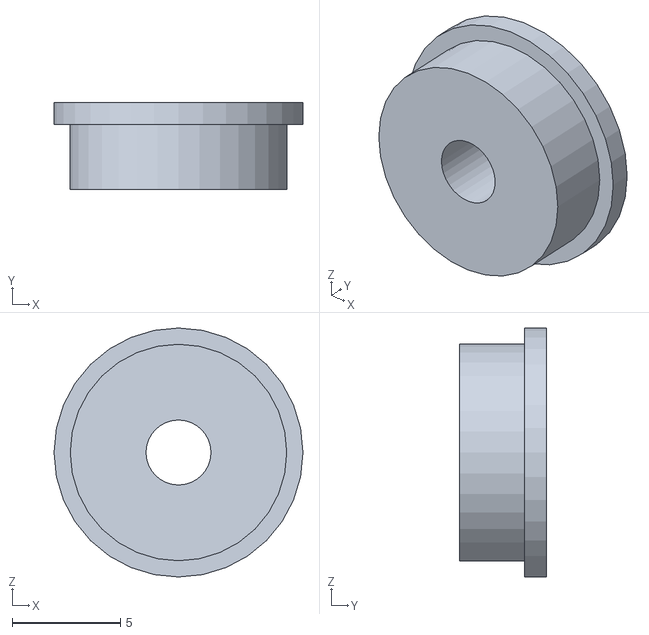
[picture p22: CAD file, 2026-10-24]
build/tr35_b2/sim/meshes/neck_pitch_idler_bearing.stl
11.5 x 4.00 x 11.5
