Kubudak90/openduck-tr/build/print/stl/neck_splice_2.stl

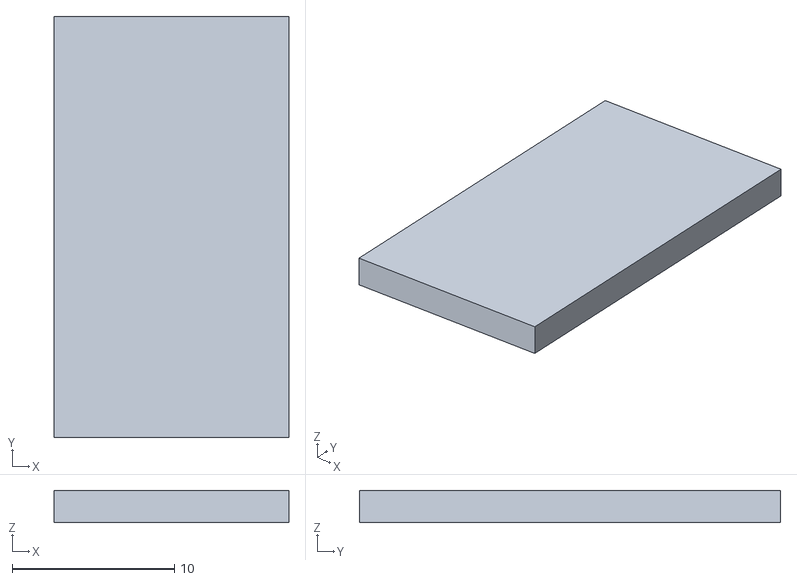
[picture p23: CAD file, 2026-10-23]
build/print/stl/neck_splice_2.stl
14.5 x 26.0 x 2.00
