Kubudak90/openduck-tr/build/sim/meshes/tof_sensor.stl

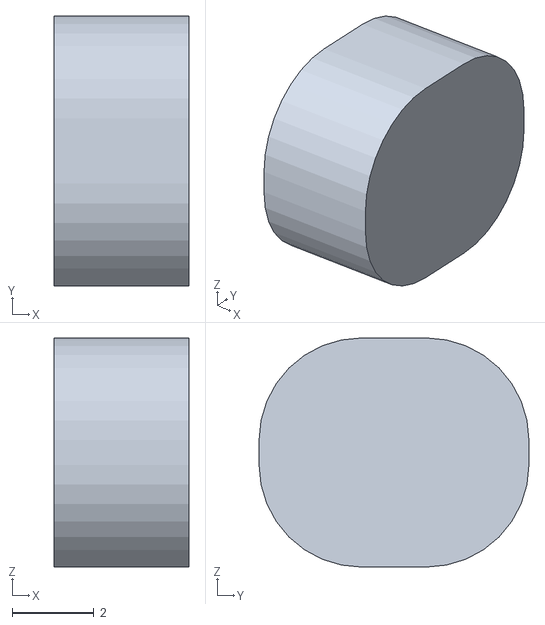
[picture p24: CAD file, 2026-10-23]
build/sim/meshes/tof_sensor.stl
3.30 x 6.60 x 5.60
