Kubudak90/openduck-tr/build/tr35_b2/sim/meshes/right_foot_bracket.stl

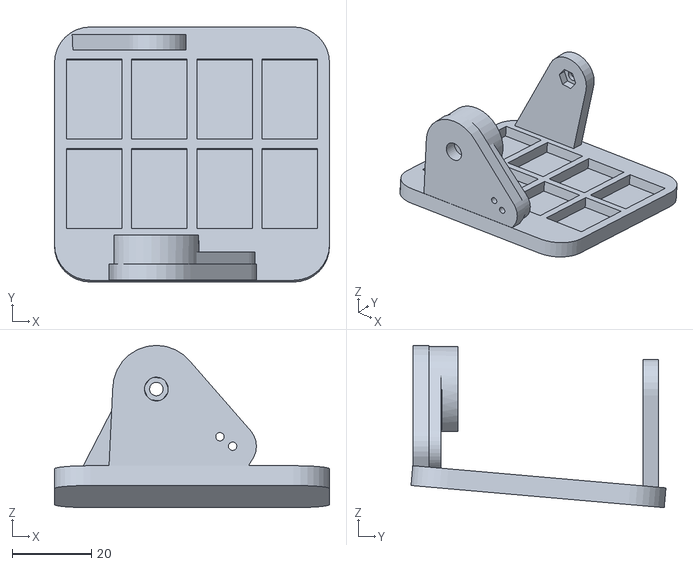
[picture p25: CAD file, 2026-10-24]
build/tr35_b2/sim/meshes/right_foot_bracket.stl
69.2 x 64.2 x 40.9
