Kubudak90/openduck-tr/build/print/stl/battery_tray.stl

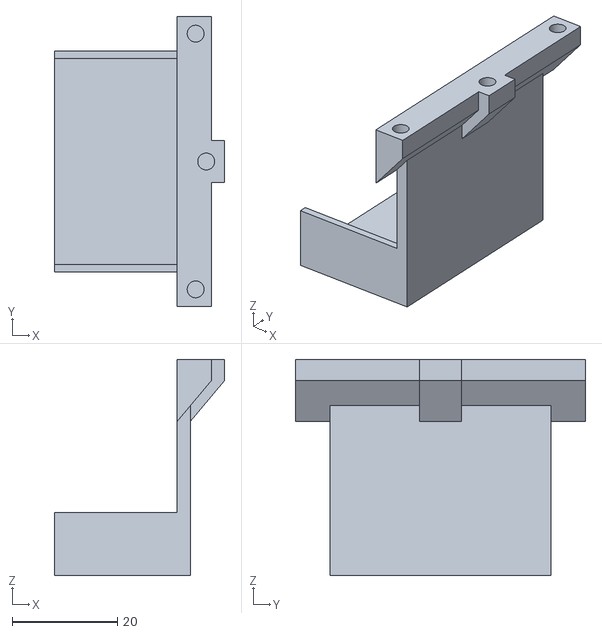
[picture p26: CAD file, 2026-10-23]
build/print/stl/battery_tray.stl
32.3 x 55.0 x 41.0
