Kubudak90/openduck-tr/build/sim/meshes/left_foot_body.stl

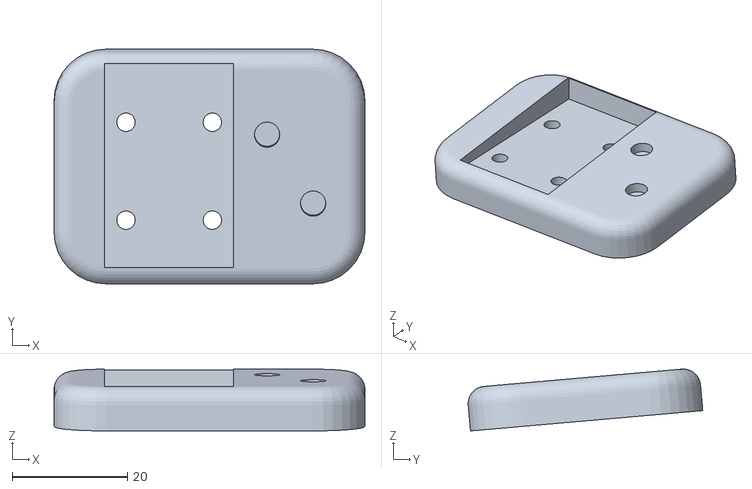
[picture p27: CAD file, 2026-10-23]
build/sim/meshes/left_foot_body.stl
54.0 x 40.7 x 10.7
