Kubudak90/openduck-tr/build/tr35_b2/sim/meshes/left_hip_yaw_servo.stl

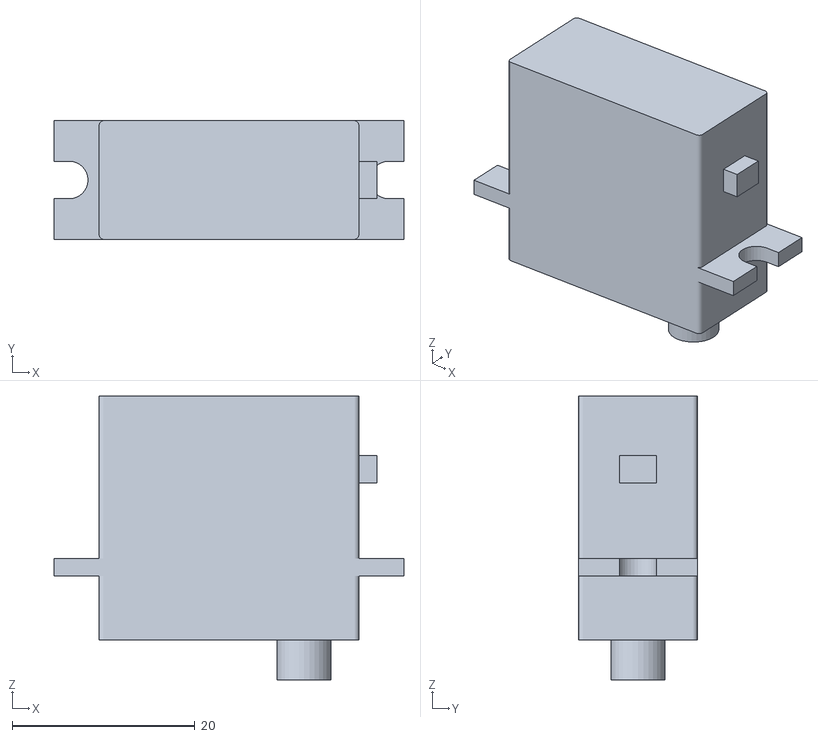
[picture p28: CAD file, 2026-10-24]
build/tr35_b2/sim/meshes/left_hip_yaw_servo.stl
38.4 x 13.0 x 31.1
