Kubudak90/openduck-tr/build/print/stl/eye_ring.stl

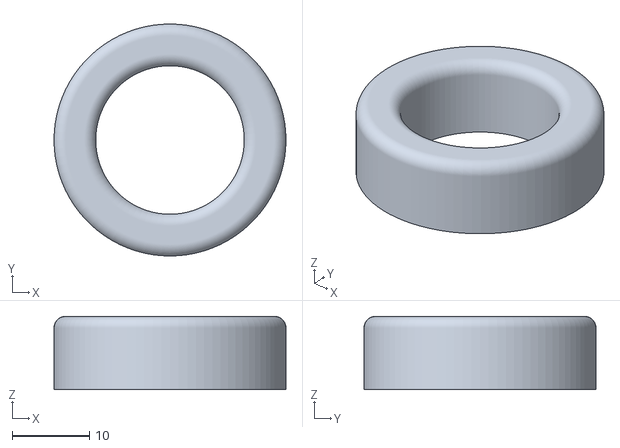
[picture p29: CAD file, 2026-10-23]
build/print/stl/eye_ring.stl
30.0 x 30.0 x 9.50
