Kubudak90/openduck-tr/build/sim/meshes/right_thigh_wing.stl

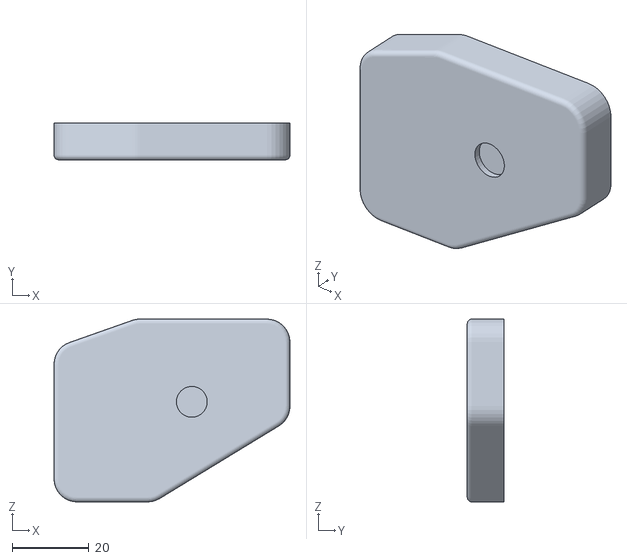
[picture p30: CAD file, 2026-10-23]
build/sim/meshes/right_thigh_wing.stl
61.3 x 9.50 x 47.5
