Kubudak90/openduck-tr/build/tr35_b2/sim/meshes/right_ankle_idler_pin.stl

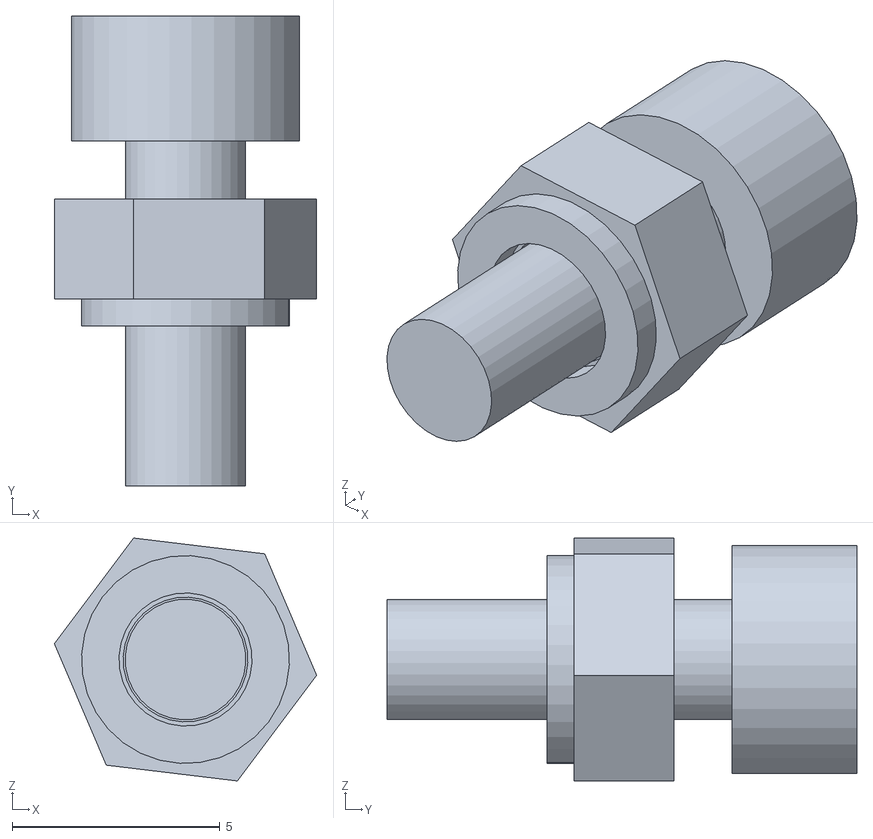
[picture p31: CAD file, 2026-10-24]
build/tr35_b2/sim/meshes/right_ankle_idler_pin.stl
6.31 x 11.3 x 5.84
