Kubudak90/openduck-tr/build/print/stl/right_hip_bracket.stl

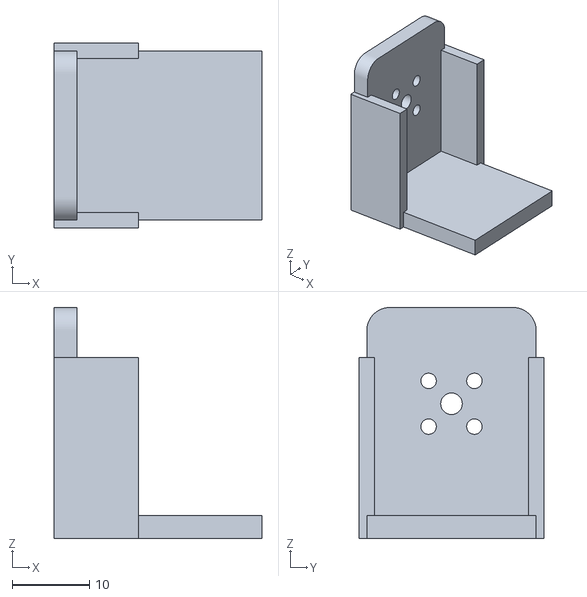
[picture p32: CAD file, 2026-10-23]
build/print/stl/right_hip_bracket.stl
27.0 x 24.0 x 30.0
