Kubudak90/openduck-tr/build/tr35_b2/sim/meshes/right_hip_cradle_bracket.stl

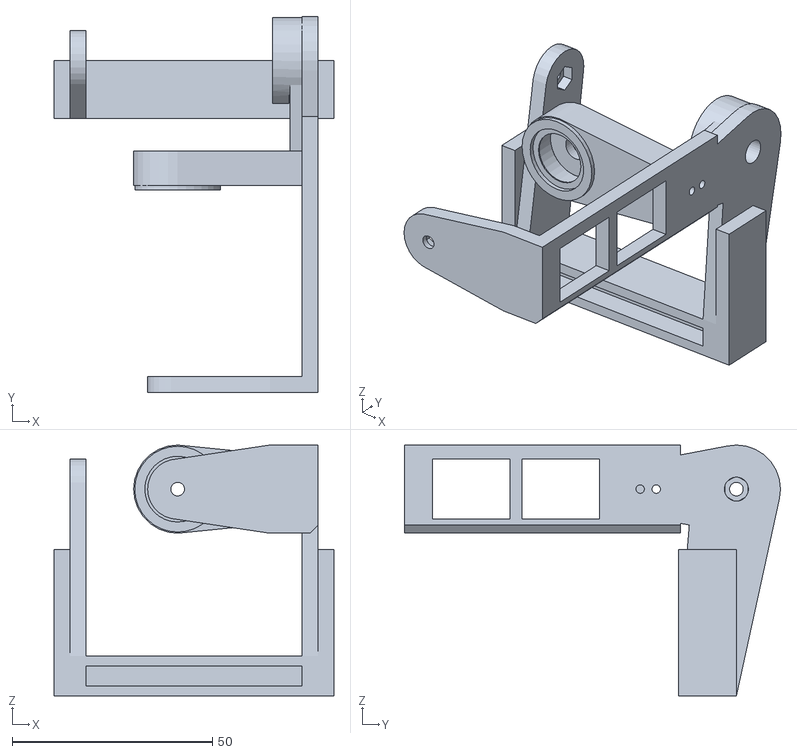
[picture p33: CAD file, 2026-10-24]
build/tr35_b2/sim/meshes/right_hip_cradle_bracket.stl
69.8 x 93.8 x 62.6
