Kubudak90/openduck-tr/build/print/stl/left_sole.stl

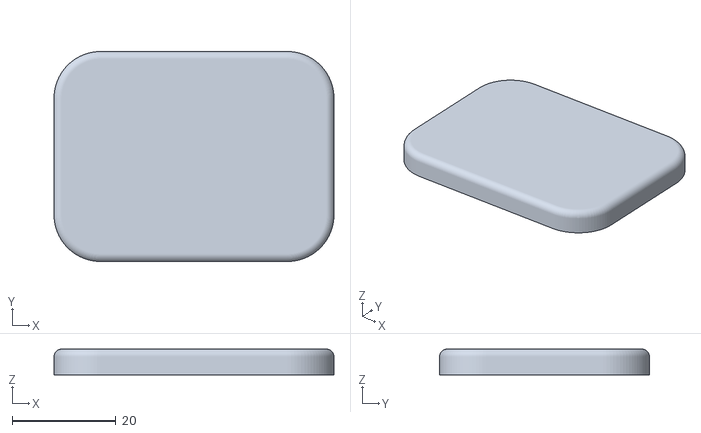
[picture p34: CAD file, 2026-10-23]
build/print/stl/left_sole.stl
54.0 x 40.5 x 5.00
