Kubudak90/openduck-tr/build/sim/meshes/head_hood.stl

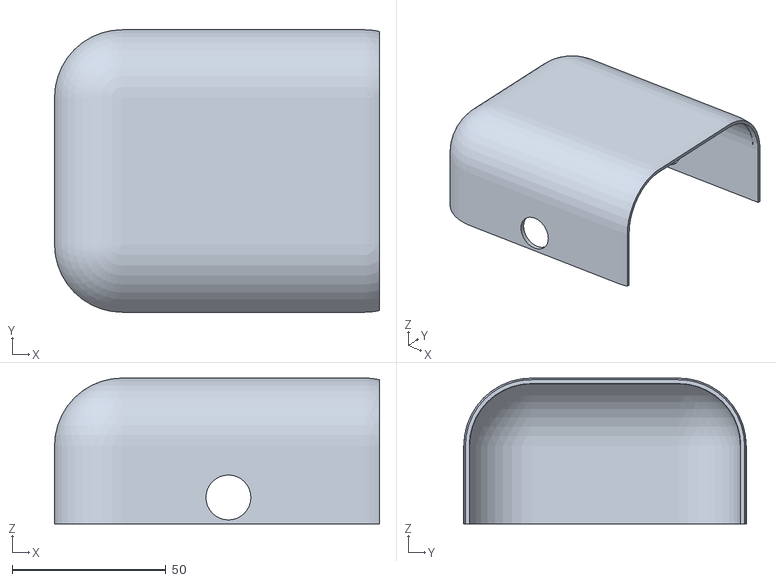
[picture p35: CAD file, 2026-10-23]
build/sim/meshes/head_hood.stl
105.6 x 91.8 x 47.4
