Kubudak90/openduck-tr/build/tr35_b2/sim/meshes/left_hip_yaw_bearing_hi.stl

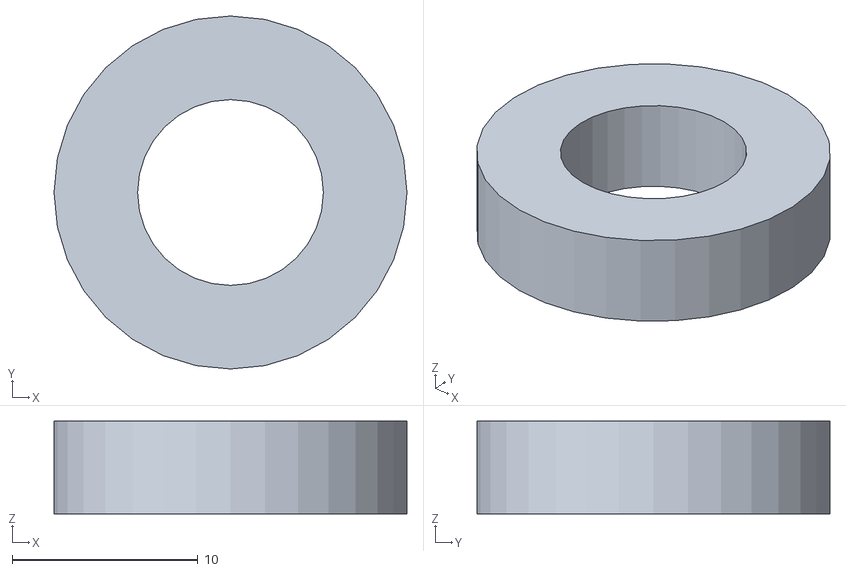
[picture p36: CAD file, 2026-10-24]
build/tr35_b2/sim/meshes/left_hip_yaw_bearing_hi.stl
19.0 x 19.0 x 5.00
