Kubudak90/openduck-tr/build/print/stl/upper_bill_pad.stl

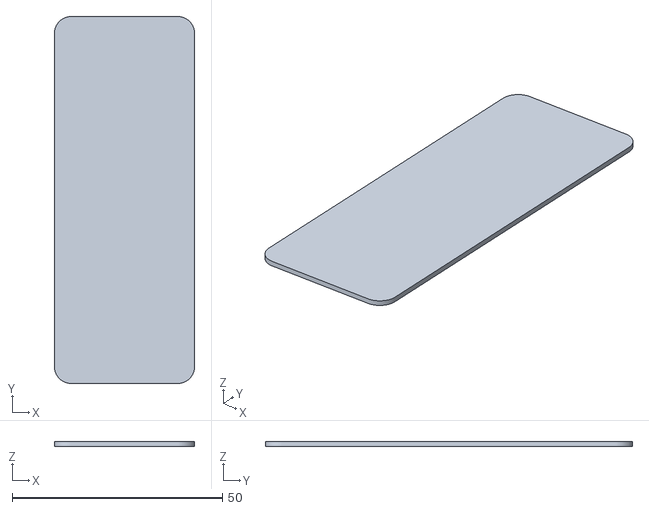
[picture p37: CAD file, 2026-10-23]
build/print/stl/upper_bill_pad.stl
33.3 x 87.2 x 1.10
