Kubudak90/openduck-tr/build/sim/meshes/right_thigh_inner_plate.stl

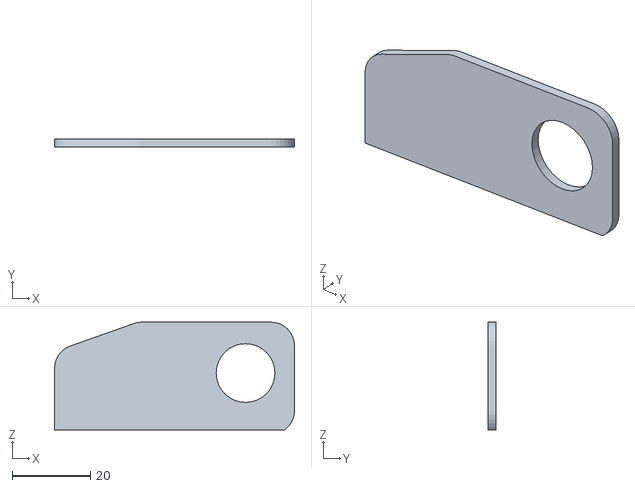
[picture p38: CAD file, 2026-10-23]
build/sim/meshes/right_thigh_inner_plate.stl
61.3 x 2.00 x 27.5
