Kubudak90/openduck-tr/build/tr35_b2/sim/meshes/leg_bus_cap_1.stl

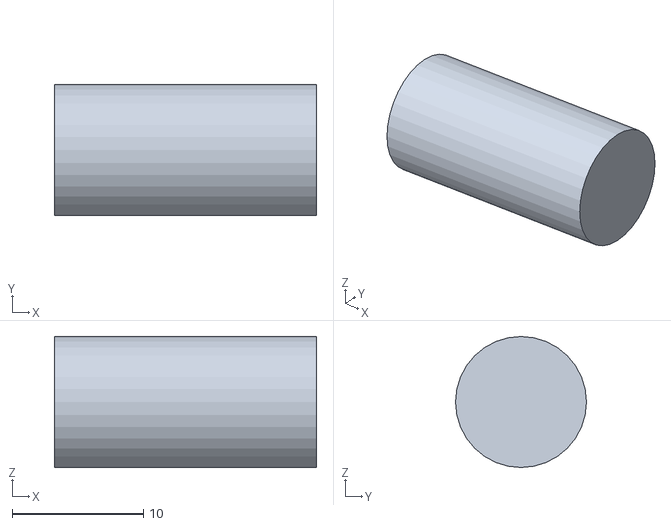
[picture p39: CAD file, 2026-10-24]
build/tr35_b2/sim/meshes/leg_bus_cap_1.stl
20.0 x 10.0 x 10.0
