Kubudak90/openduck-tr/build/print/stl/right_foot_body.stl

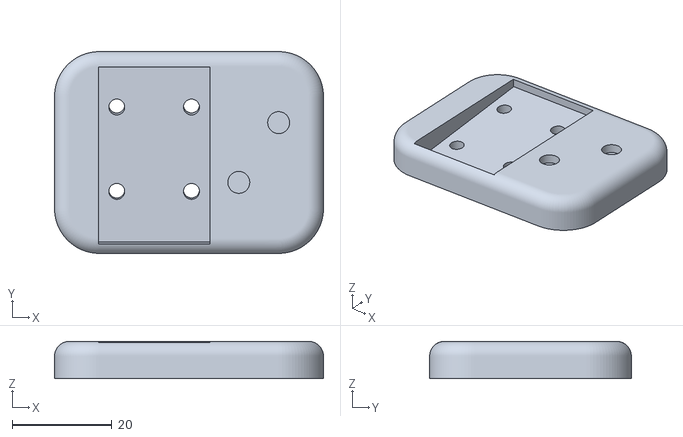
[picture p40: CAD file, 2026-10-23]
build/print/stl/right_foot_body.stl
54.0 x 40.5 x 7.50
