Kubudak90/openduck-tr/build/tr35_b2/sim/meshes/pca9685_2.stl

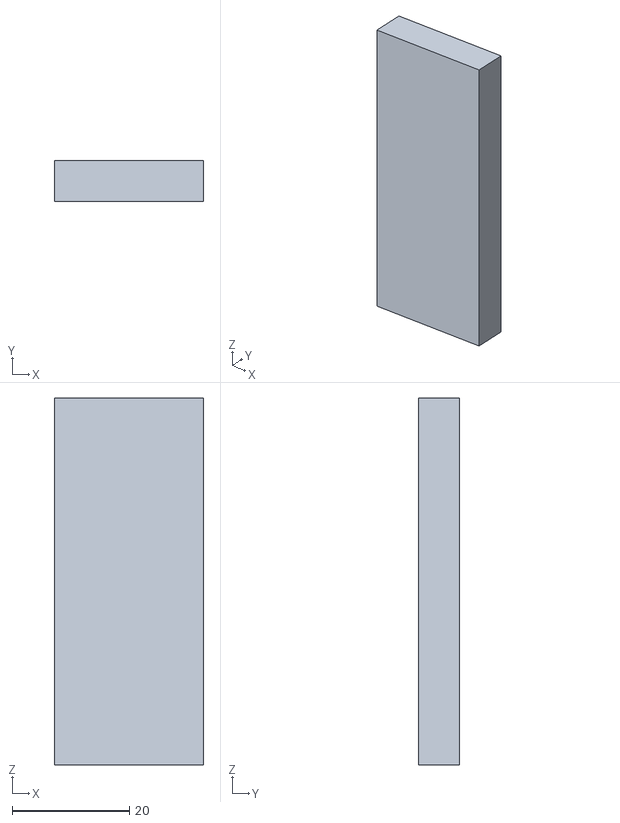
[picture p41: CAD file, 2026-10-24]
build/tr35_b2/sim/meshes/pca9685_2.stl
25.4 x 7.00 x 62.5
