Kubudak90/openduck-tr/build/tr35_b2/sim/meshes/left_hip_roll_idler_bearing.stl

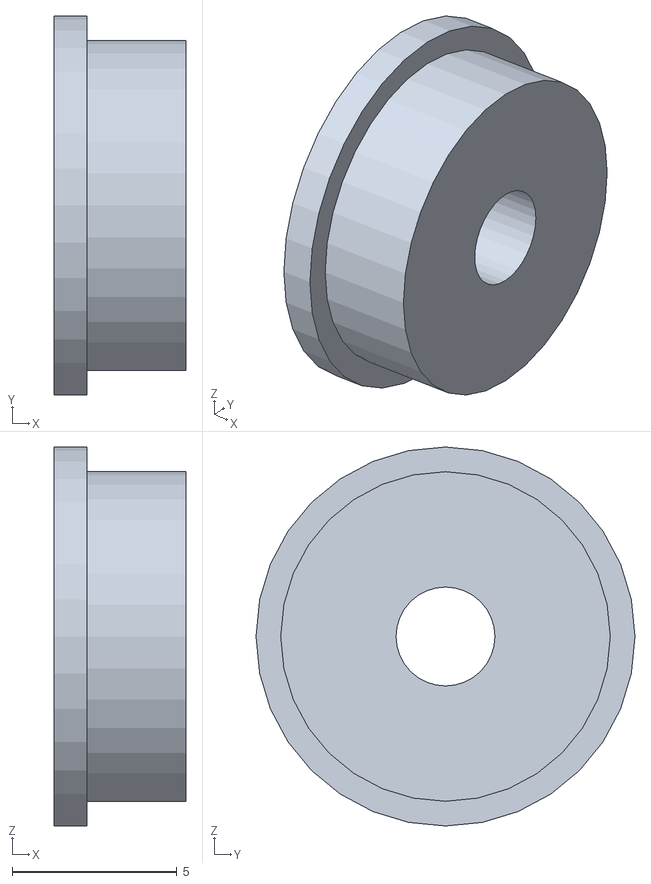
[picture p42: CAD file, 2026-10-24]
build/tr35_b2/sim/meshes/left_hip_roll_idler_bearing.stl
4.00 x 11.5 x 11.5
