Kubudak90/openduck-tr/build/sim/meshes/head_tilt_bracket.stl

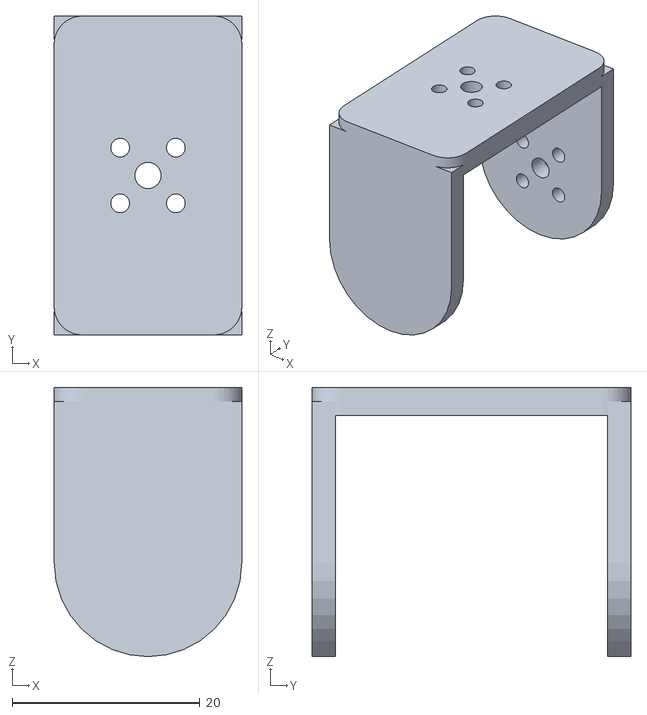
[picture p43: CAD file, 2026-10-23]
build/sim/meshes/head_tilt_bracket.stl
20.0 x 34.0 x 28.7
