Kubudak90/openduck-tr/build/tr35_b2/sim/meshes/ads1115_1.stl

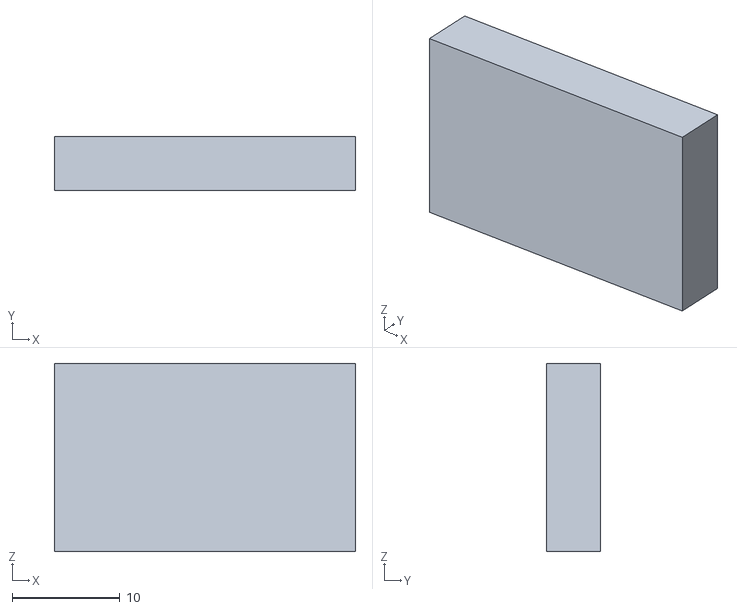
[picture p44: CAD file, 2026-10-24]
build/tr35_b2/sim/meshes/ads1115_1.stl
28.0 x 5.00 x 17.5
