Kubudak90/openduck-tr/build/print/stl/right_ankle_bracket.stl

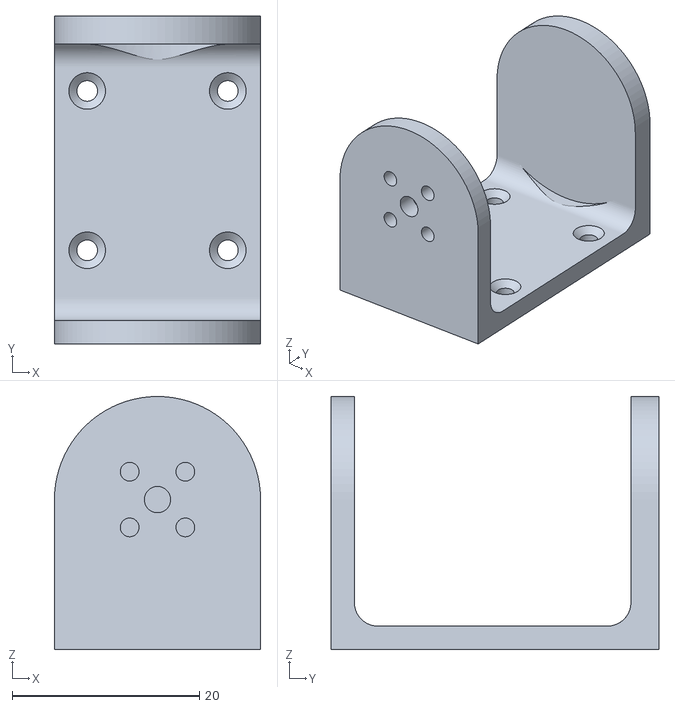
[picture p45: CAD file, 2026-10-23]
build/print/stl/right_ankle_bracket.stl
22.0 x 35.0 x 27.0
