Kubudak90/openduck-tr/build/sim/meshes/head_yaw_horn.stl

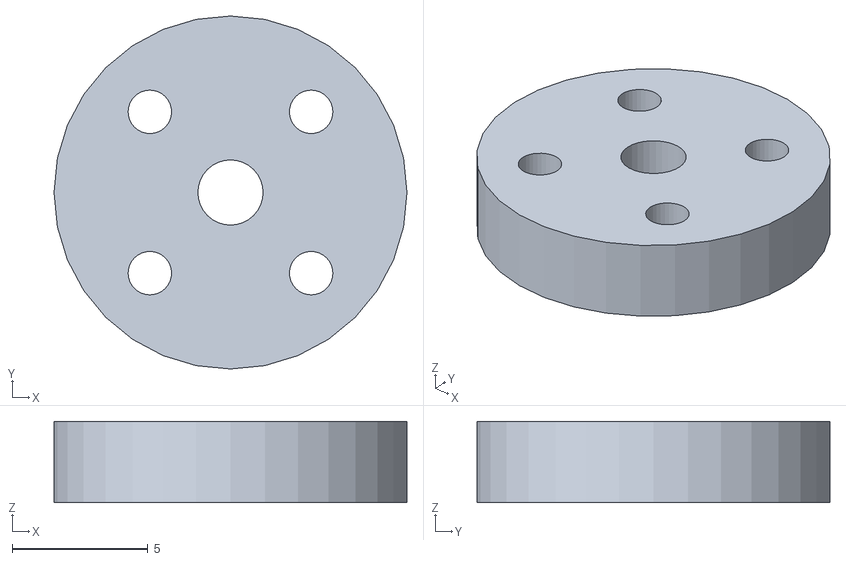
[picture p46: CAD file, 2026-10-23]
build/sim/meshes/head_yaw_horn.stl
13.0 x 13.0 x 3.00
