Kubudak90/openduck-tr/build/tr35_b2/sim/meshes/head_yaw_retainer_right.stl

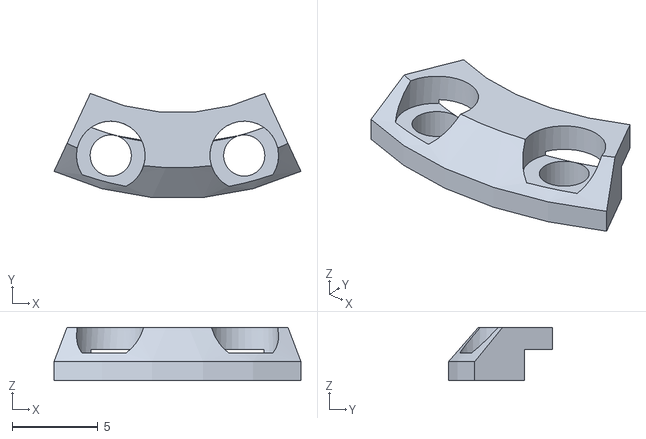
[picture p47: CAD file, 2026-10-24]
build/tr35_b2/sim/meshes/head_yaw_retainer_right.stl
14.4 x 6.06 x 3.10
