Kubudak90/openduck-tr/build/print/stl/head_turn_bracket_2.stl

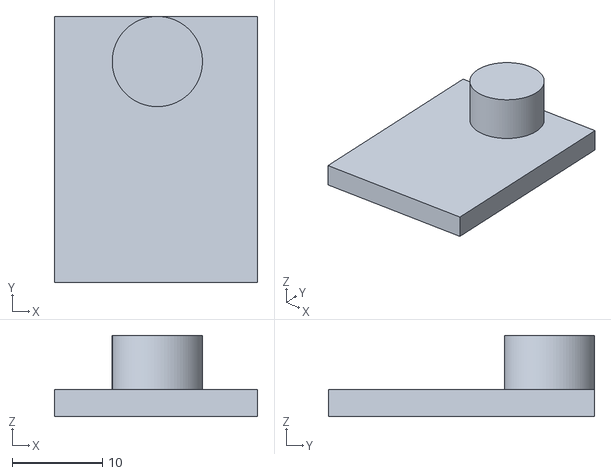
[picture p48: CAD file, 2026-10-23]
build/print/stl/head_turn_bracket_2.stl
22.5 x 29.5 x 9.00
