Kubudak90/openduck-tr/build/tr35_b2/sim/meshes/head_pitch_thrust_in.stl

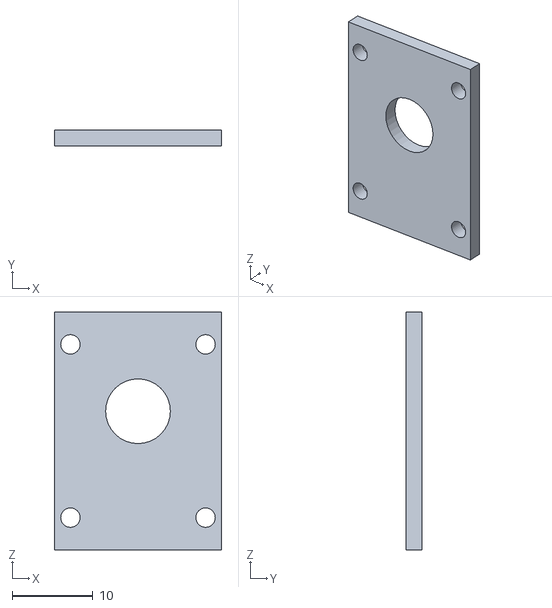
[picture p49: CAD file, 2026-10-24]
build/tr35_b2/sim/meshes/head_pitch_thrust_in.stl
20.7 x 2.00 x 29.4
