Kubudak90/openduck-tr/build/print/stl/chassis.stl

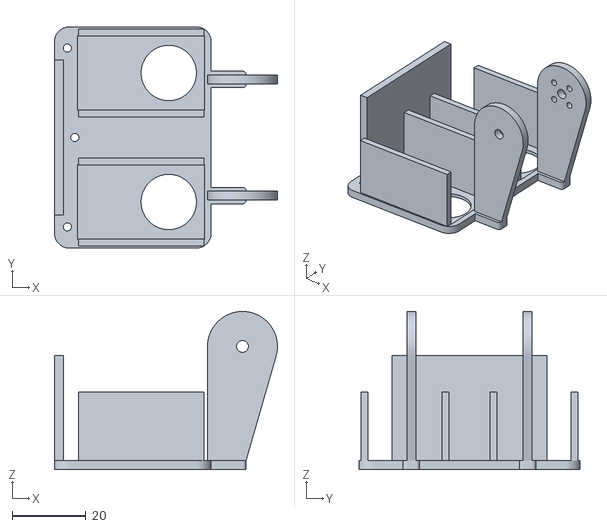
[picture p50: CAD file, 2026-10-23]
build/print/stl/chassis.stl
60.5 x 60.0 x 42.9
