Kubudak90/openduck-tr/build/sim/meshes/battery_np_f550.stl

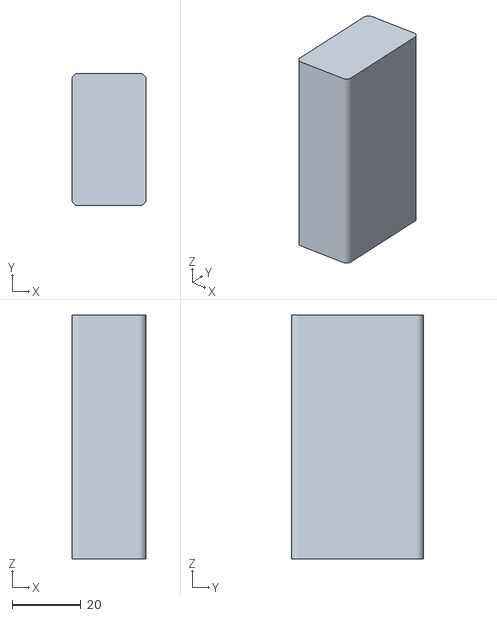
[picture p51: CAD file, 2026-10-23]
build/sim/meshes/battery_np_f550.stl
21.7 x 38.6 x 71.1
