Kubudak90/openduck-tr/build/tr35_b2/sim/meshes/head_roll_harness_in.stl

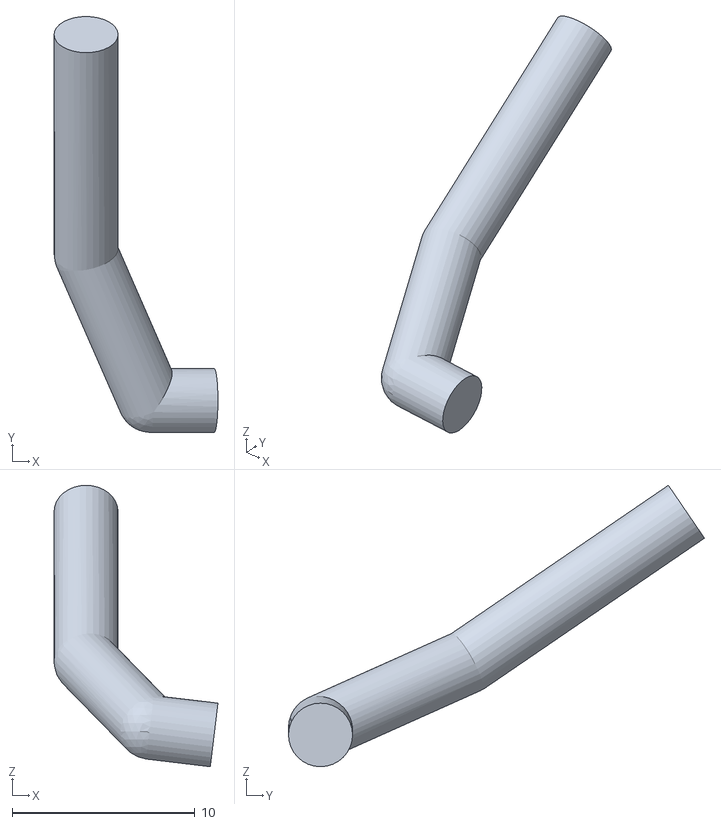
[picture p52: CAD file, 2026-10-24]
build/tr35_b2/sim/meshes/head_roll_harness_in.stl
8.96 x 22.7 x 15.4
