Kubudak90/openduck-tr/build/tr35_b2/sim/meshes/left_hip_pitch_horn.stl

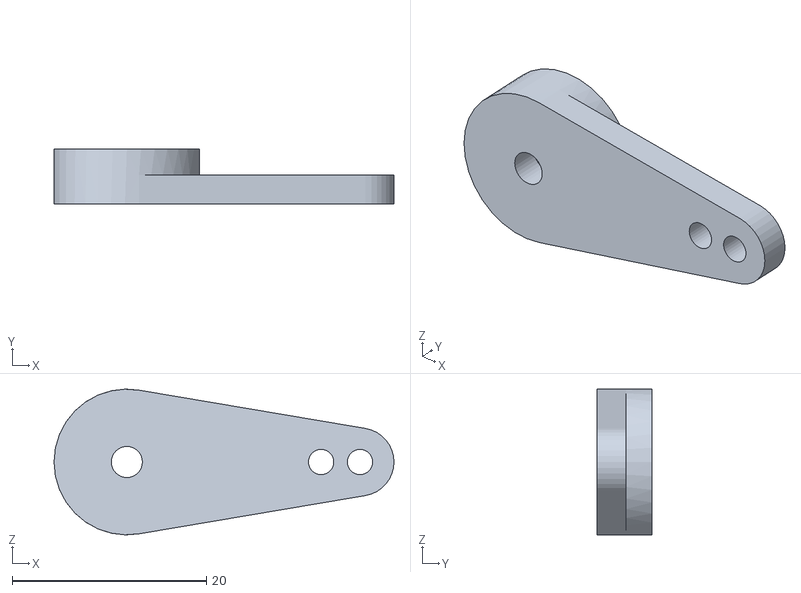
[picture p53: CAD file, 2026-10-24]
build/tr35_b2/sim/meshes/left_hip_pitch_horn.stl
35.0 x 5.70 x 15.0
