Kubudak90/openduck-tr/build/print/stl/lower_bill_pad.stl

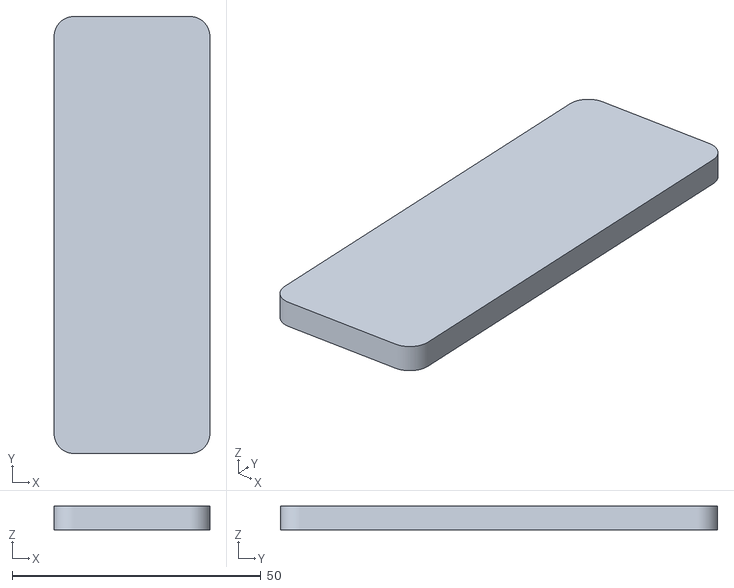
[picture p54: CAD file, 2026-10-23]
build/print/stl/lower_bill_pad.stl
31.3 x 87.8 x 4.80
