Kubudak90/openduck-tr/build/tr35_b2/sim/meshes/neck_power_wiring.stl

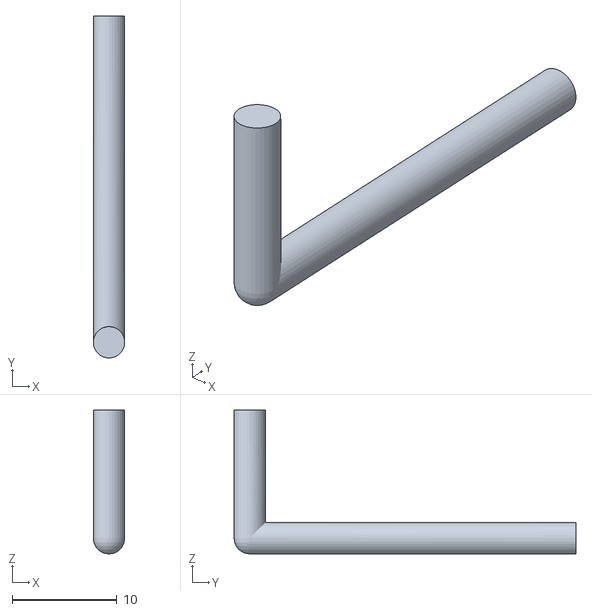
[picture p55: CAD file, 2026-10-24]
build/tr35_b2/sim/meshes/neck_power_wiring.stl
3.00 x 32.7 x 13.8
