Kubudak90/openduck-tr/build/sim/meshes/speaker.stl

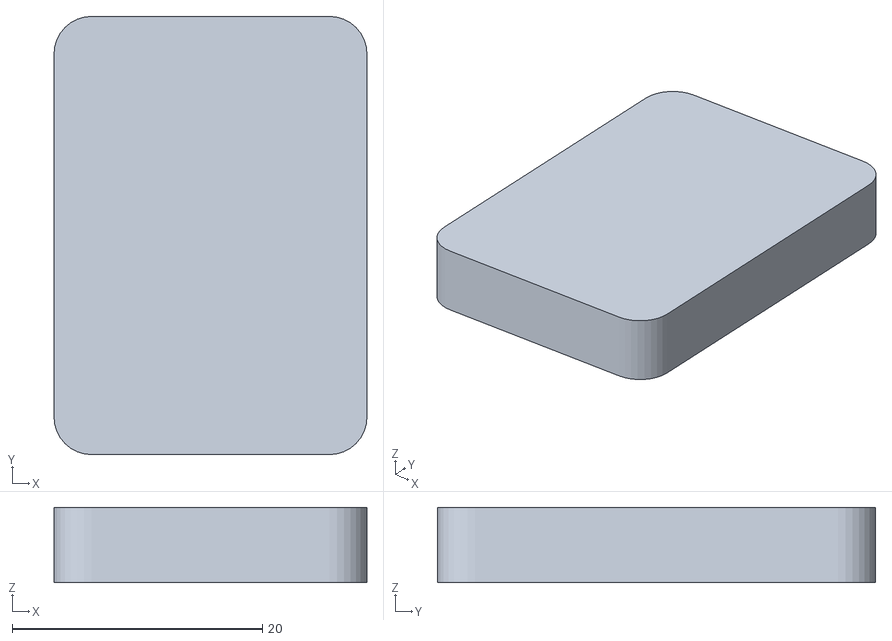
[picture p56: CAD file, 2026-10-23]
build/sim/meshes/speaker.stl
25.0 x 35.0 x 6.00
