Kubudak90/openduck-tr/build/tr35_b2/sim/meshes/power_latch.stl

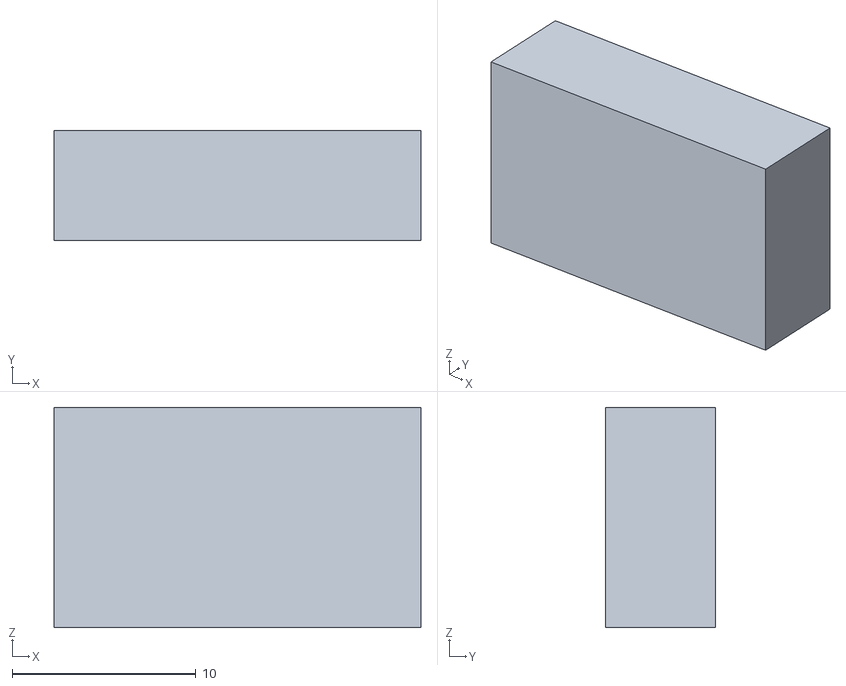
[picture p57: CAD file, 2026-10-24]
build/tr35_b2/sim/meshes/power_latch.stl
20.0 x 6.00 x 12.0
