Kubudak90/openduck-tr/build/print/stl/face_plate.stl

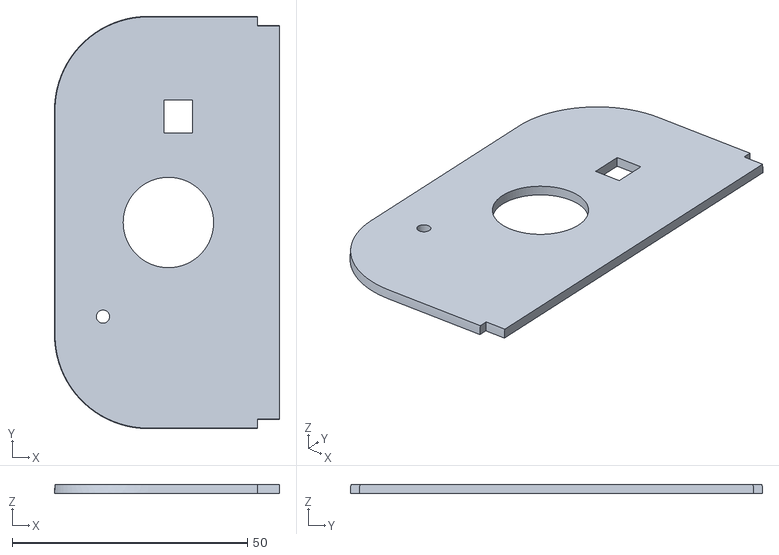
[picture p58: CAD file, 2026-10-23]
build/print/stl/face_plate.stl
47.8 x 87.6 x 2.00
