Kubudak90/openduck-tr/build/sim/meshes/left_sole.stl

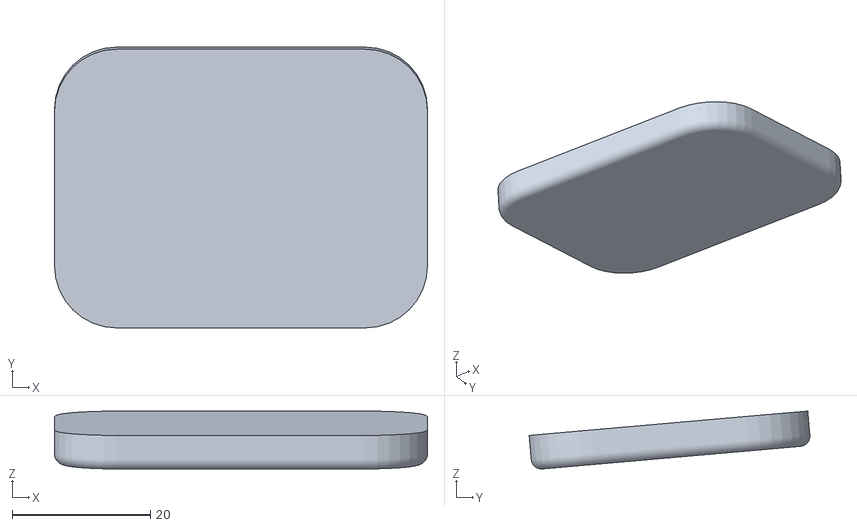
[picture p59: CAD file, 2026-10-23]
build/sim/meshes/left_sole.stl
54.0 x 40.7 x 8.38
