Kubudak90/openduck-tr/build/tr35_b2/sim/meshes/head_turn_bracket.stl

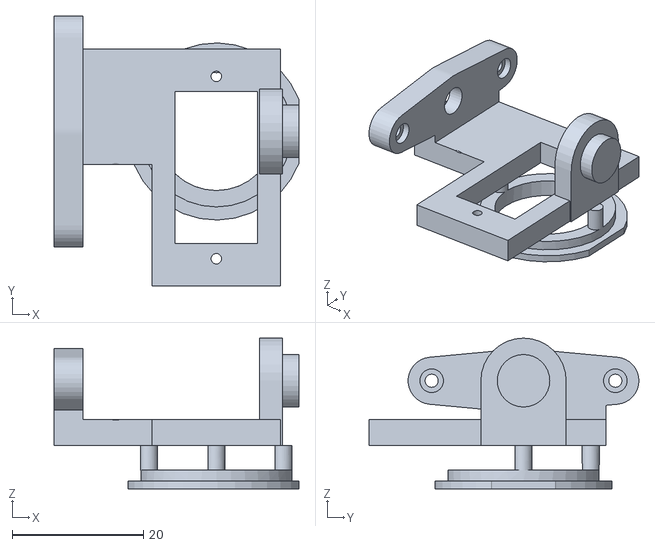
[picture p60: CAD file, 2026-10-24]
build/tr35_b2/sim/meshes/head_turn_bracket.stl
37.3 x 41.1 x 23.0
