Kubudak90/openduck-tr/build/print/stl/right_shin_bracket.stl

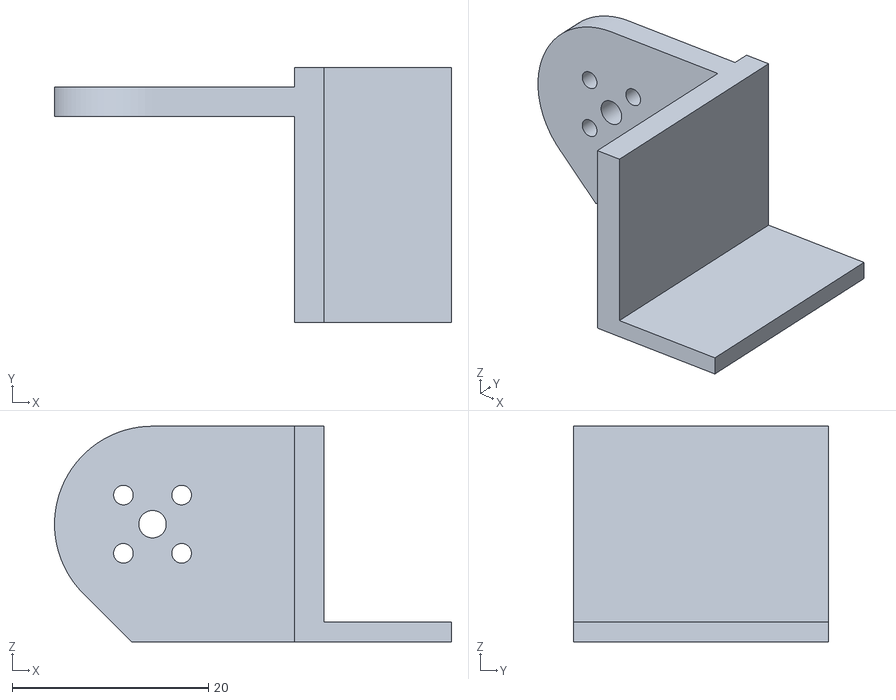
[picture p61: CAD file, 2026-10-23]
build/print/stl/right_shin_bracket.stl
40.5 x 26.0 x 22.0
