Kubudak90/openduck-tr/build/tr35_b2/sim/meshes/neck_signal_wiring.stl

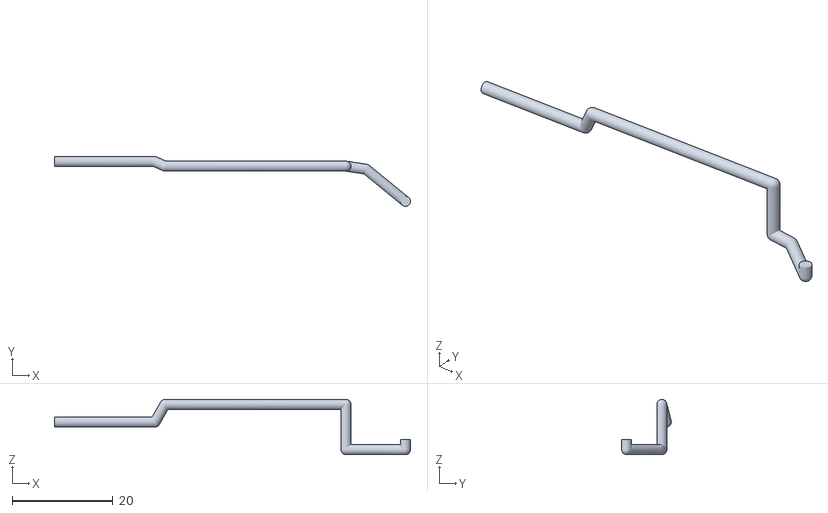
[picture p62: CAD file, 2026-10-24]
build/tr35_b2/sim/meshes/neck_signal_wiring.stl
70.8 x 9.90 x 11.0
