Kubudak90/openduck-tr/build/print/stl/lower_bill.stl

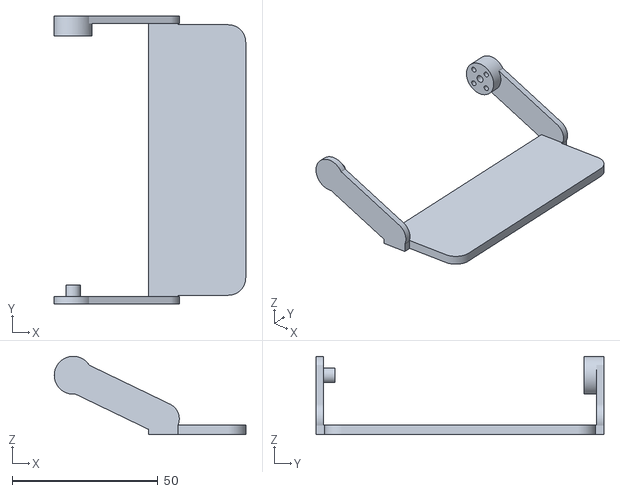
[picture p63: CAD file, 2026-10-23]
build/print/stl/lower_bill.stl
65.7 x 98.8 x 26.9
