Kubudak90/openduck-tr/build/tr35_b2/sim/meshes/battery_strap.stl

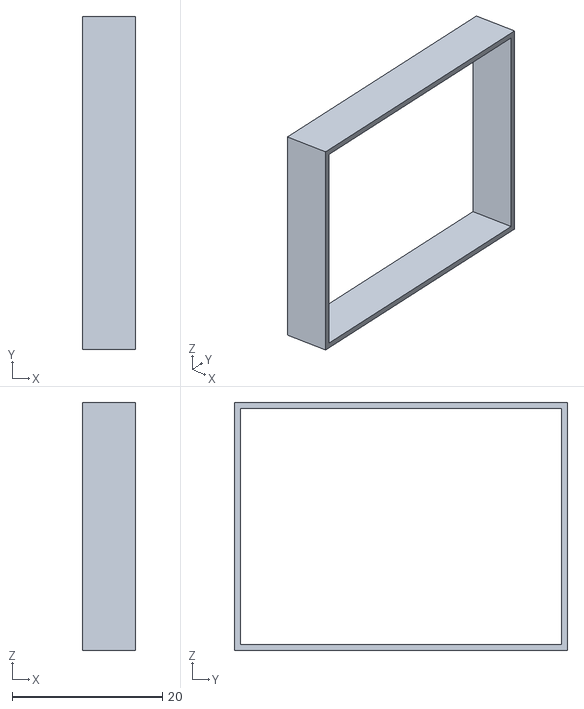
[picture p64: CAD file, 2026-10-24]
build/tr35_b2/sim/meshes/battery_strap.stl
7.00 x 44.4 x 33.1
