Kubudak90/openduck-tr/build/print/stl/torso_shell_left.stl

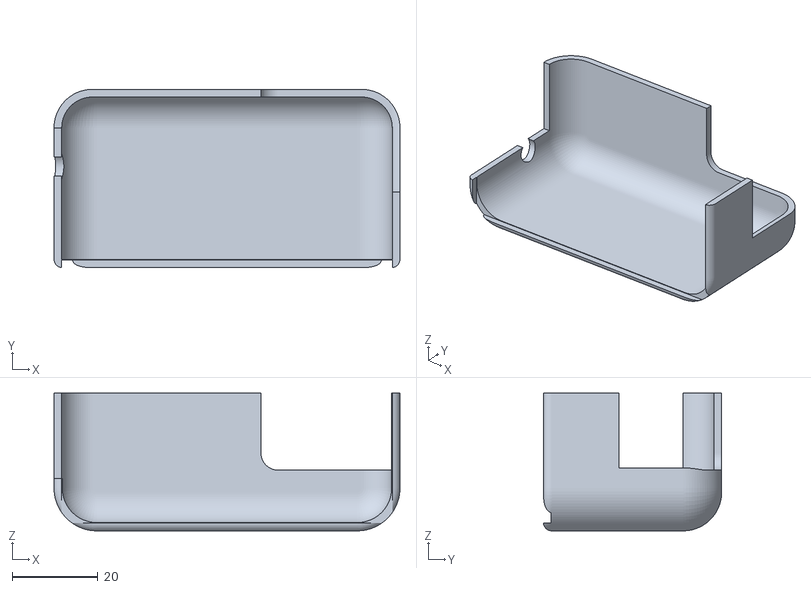
[picture p65: CAD file, 2026-10-23]
build/print/stl/torso_shell_left.stl
80.9 x 41.7 x 32.2
