Kubudak90/openduck-tr/build/tr35_b2/sim/meshes/head_yaw_horn.stl

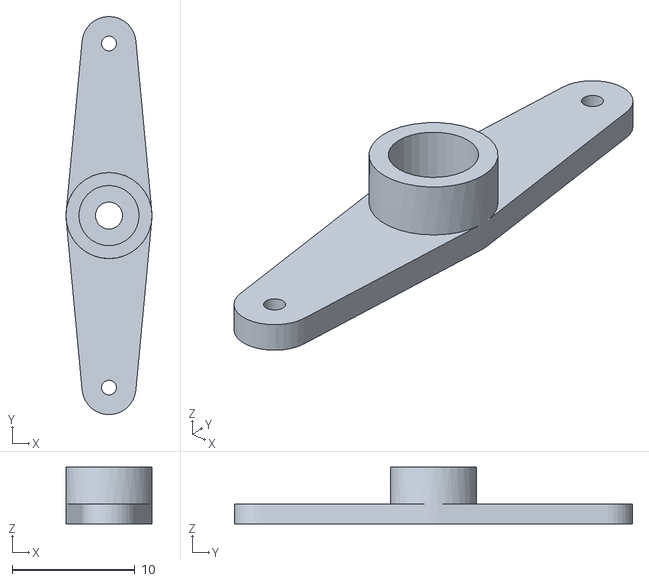
[picture p66: CAD file, 2026-10-24]
build/tr35_b2/sim/meshes/head_yaw_horn.stl
7.00 x 32.4 x 4.60
