Kubudak90/openduck-tr/build/sim/meshes/power_board.stl

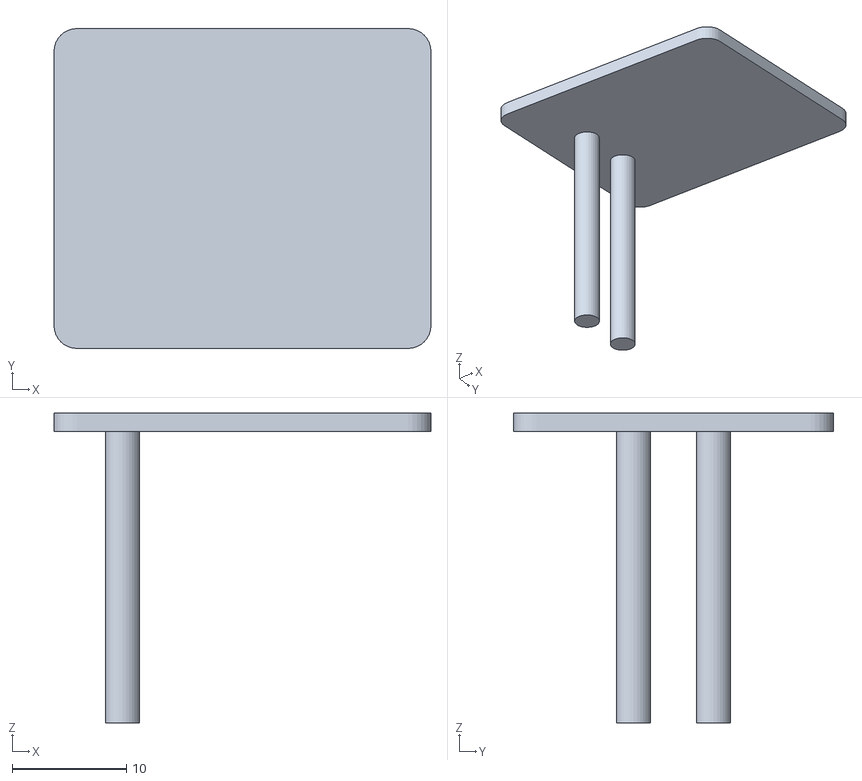
[picture p67: CAD file, 2026-10-23]
build/sim/meshes/power_board.stl
33.0 x 28.0 x 27.1
