Kubudak90/openduck-tr/build/tr35_b2/sim/meshes/left_ankle_horn.stl

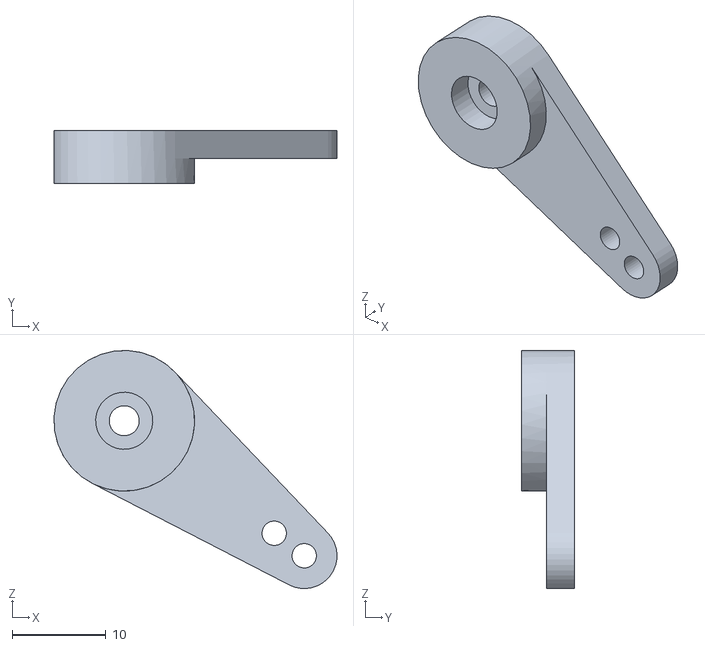
[picture p68: CAD file, 2026-10-24]
build/tr35_b2/sim/meshes/left_ankle_horn.stl
30.2 x 5.70 x 25.4
