Kubudak90/openduck-tr/build/print/stl/head_turn_bracket_1.stl

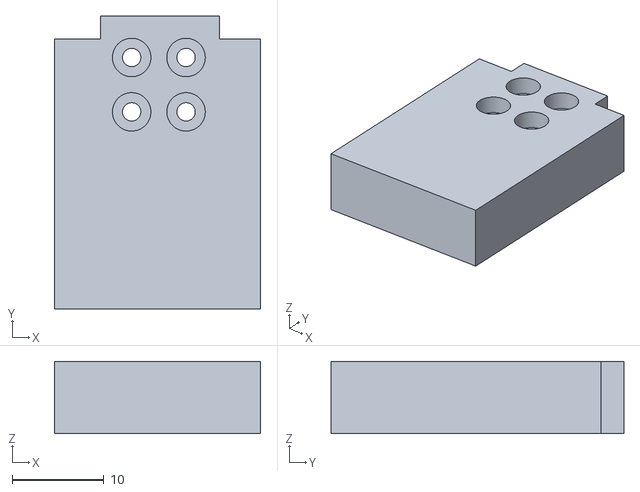
[picture p69: CAD file, 2026-10-23]
build/print/stl/head_turn_bracket_1.stl
22.5 x 32.0 x 7.90
