Kubudak90/openduck-tr/build/tr35_b2/sim/meshes/divider_board.stl

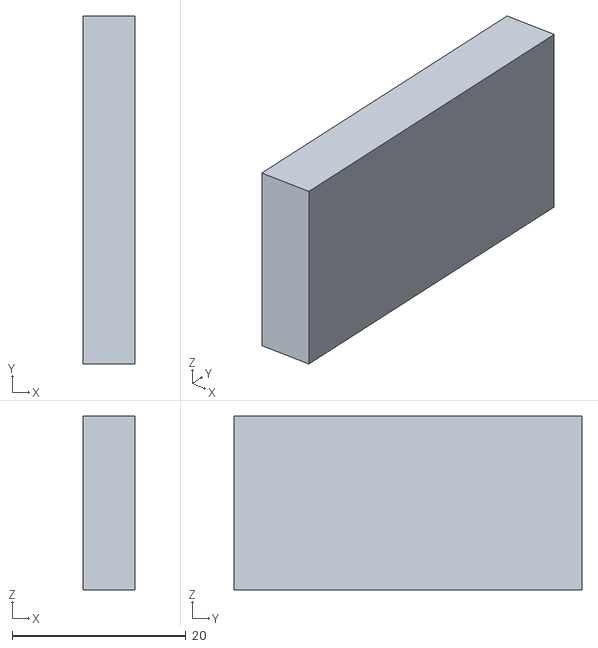
[picture p70: CAD file, 2026-10-24]
build/tr35_b2/sim/meshes/divider_board.stl
6.00 x 40.0 x 20.0
