Kubudak90/openduck-tr/build/tr35_b2/sim/meshes/battery_4s_lipo.stl

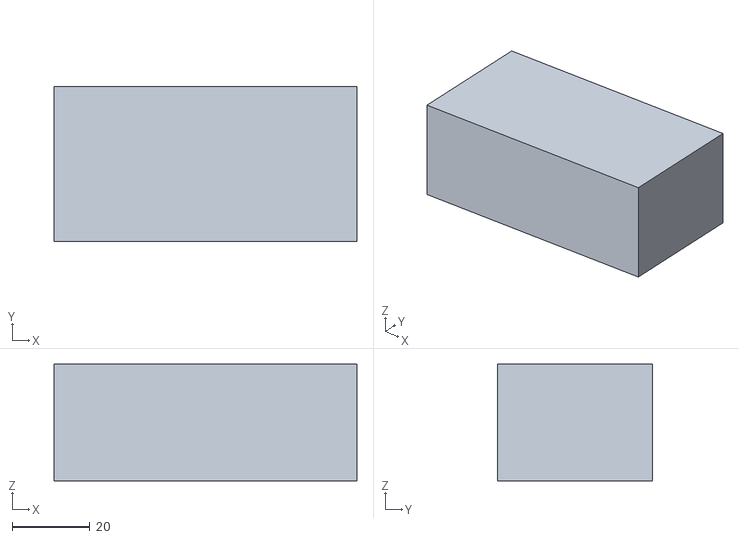
[picture p71: CAD file, 2026-10-24]
build/tr35_b2/sim/meshes/battery_4s_lipo.stl
78.0 x 40.0 x 30.0
