Kubudak90/openduck-tr/build/tr35_b2/sim/meshes/right_hip_roll_harness_in.stl

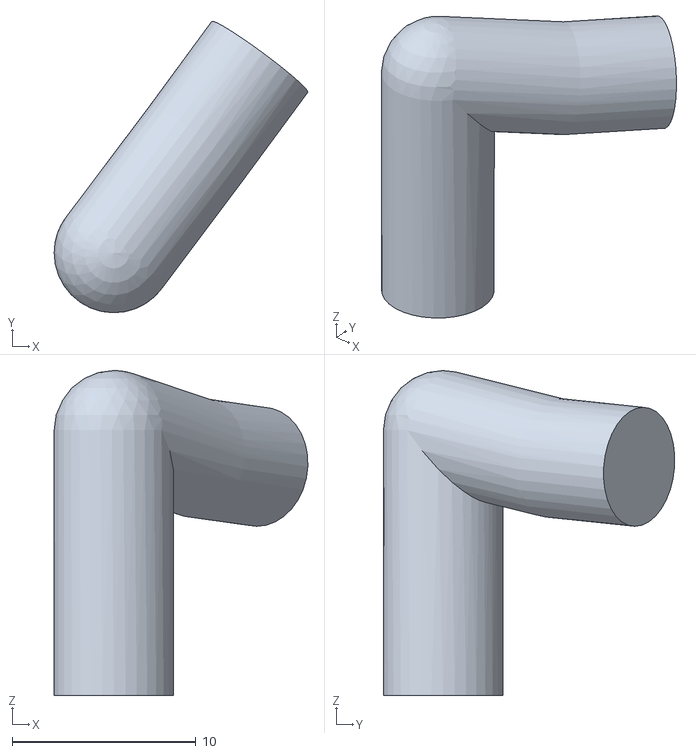
[picture p72: CAD file, 2026-10-24]
build/tr35_b2/sim/meshes/right_hip_roll_harness_in.stl
13.8 x 15.9 x 17.7
