Kubudak90/openduck-tr/build/tr35_b2/sim/meshes/neck_link.stl

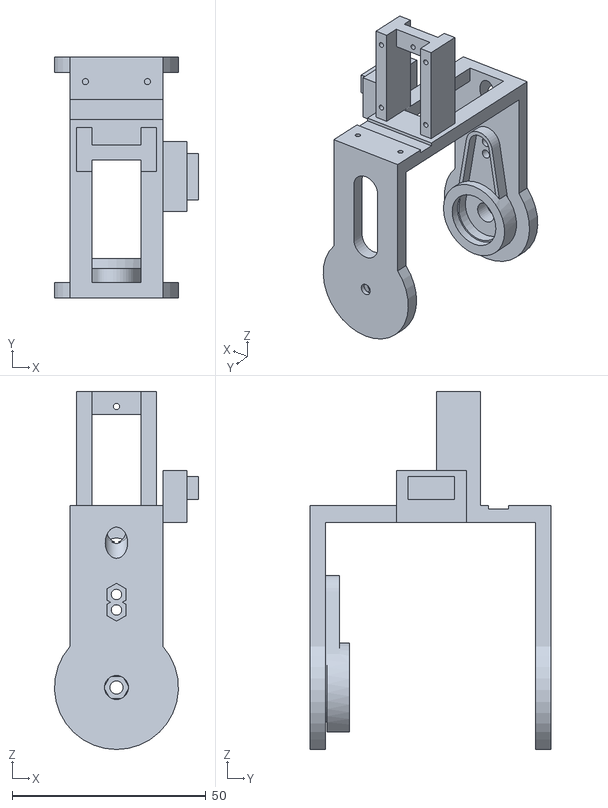
[picture p73: CAD file, 2026-10-24]
build/tr35_b2/sim/meshes/neck_link.stl
37.2 x 62.3 x 92.4
