Kubudak90/openduck-tr/build/sim/meshes/right_ankle_bearing.stl

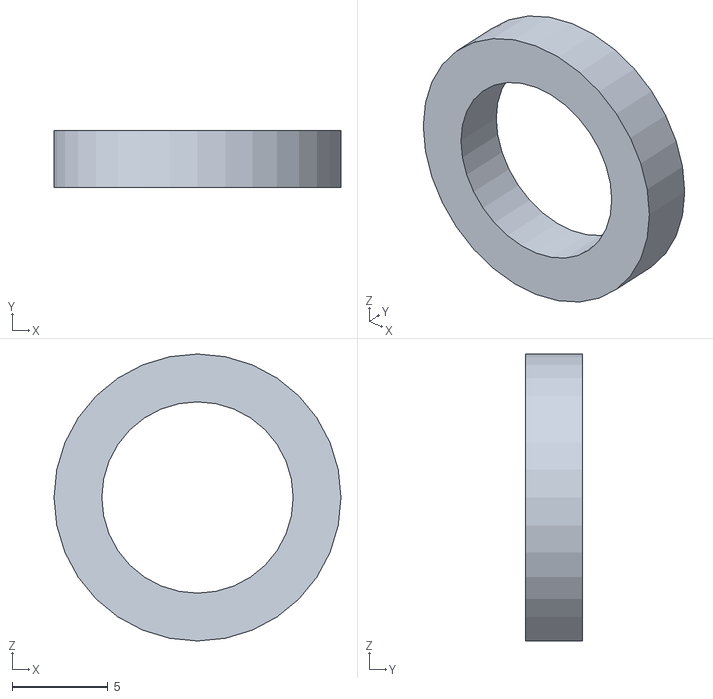
[picture p74: CAD file, 2026-10-23]
build/sim/meshes/right_ankle_bearing.stl
15.0 x 3.00 x 15.0
