Kubudak90/openduck-tr/build/tr35_b2/sim/meshes/torso_shell_left.stl

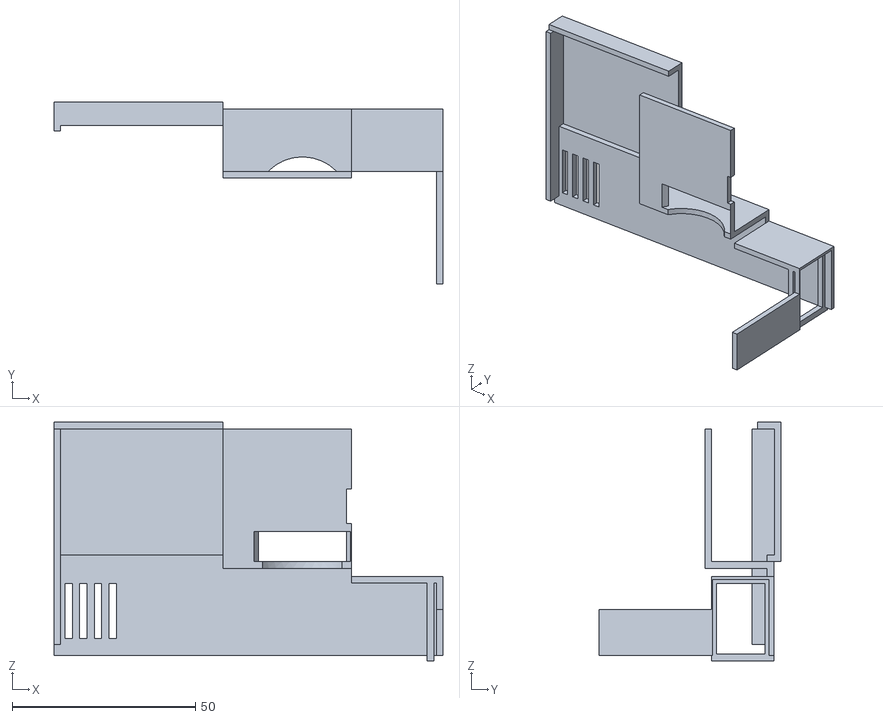
[picture p75: CAD file, 2026-10-24]
build/tr35_b2/sim/meshes/torso_shell_left.stl
106.0 x 49.7 x 65.0
