Kubudak90/openduck-tr/build/tr35_b2/sim/meshes/torso_top.stl

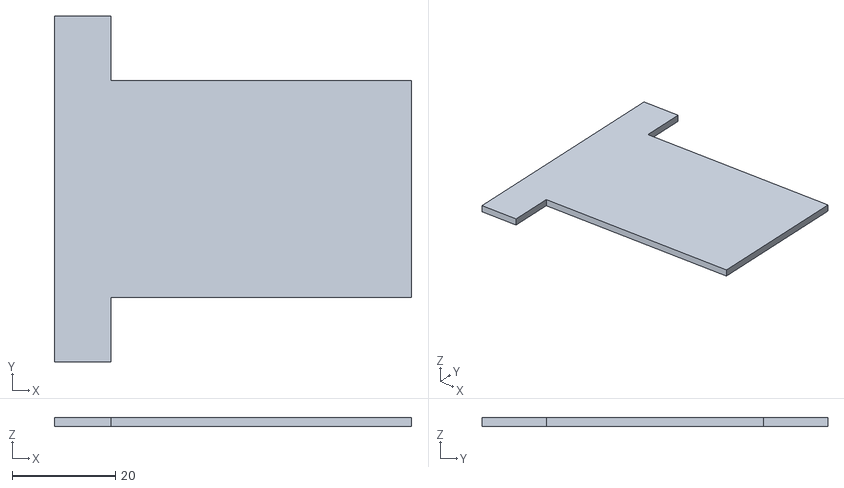
[picture p76: CAD file, 2026-10-24]
build/tr35_b2/sim/meshes/torso_top.stl
69.2 x 67.0 x 1.80
