Kubudak90/openduck-tr/build/tr35_b2/sim/meshes/left_knee_servo.stl

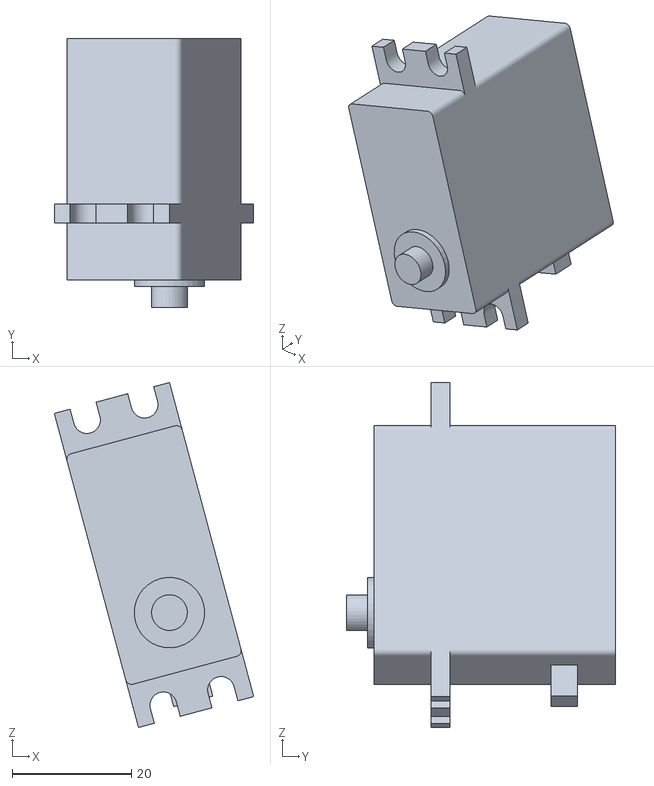
[picture p77: CAD file, 2026-10-24]
build/tr35_b2/sim/meshes/left_knee_servo.stl
33.4 x 45.0 x 57.8
