Kubudak90/openduck-tr/build/tr35_b2/sim/meshes/ina226.stl

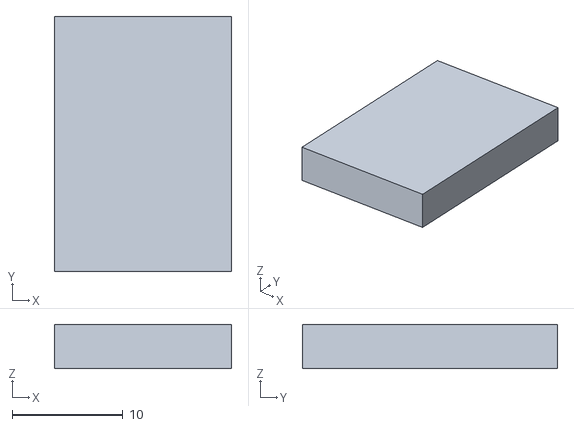
[picture p78: CAD file, 2026-10-24]
build/tr35_b2/sim/meshes/ina226.stl
16.0 x 23.0 x 4.00
