Kubudak90/openduck-tr/build/tr35_b2/sim/meshes/right_hip_yaw_shaft.stl

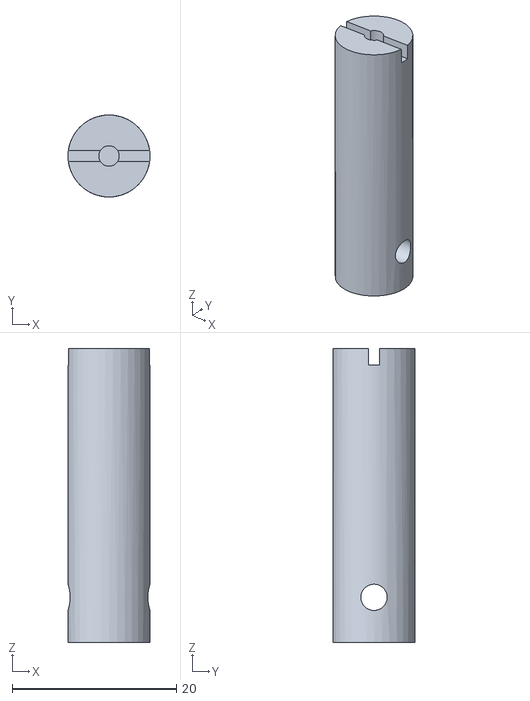
[picture p79: CAD file, 2026-10-24]
build/tr35_b2/sim/meshes/right_hip_yaw_shaft.stl
10.0 x 10.0 x 35.8
