Kubudak90/openduck-tr/build/tr35_b2/sim/meshes/left_hip_yaw_coupler.stl

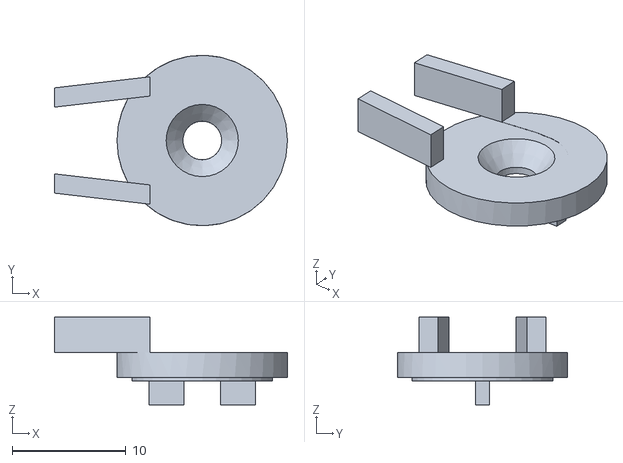
[picture p80: CAD file, 2026-10-24]
build/tr35_b2/sim/meshes/left_hip_yaw_coupler.stl
20.5 x 15.0 x 7.70
