Kubudak90/openduck-tr/build/sim/meshes/camera_holder.stl

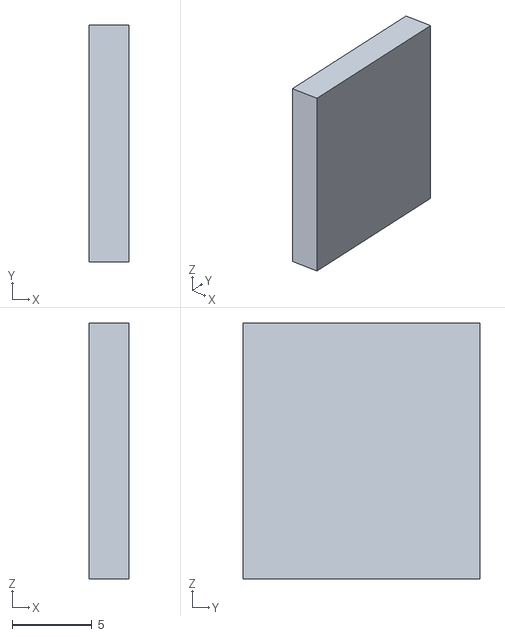
[picture p81: CAD file, 2026-10-23]
build/sim/meshes/camera_holder.stl
2.50 x 14.8 x 16.0
