Kubudak90/openduck-tr/build/tr35_b2/sim/meshes/xt30_pair.stl

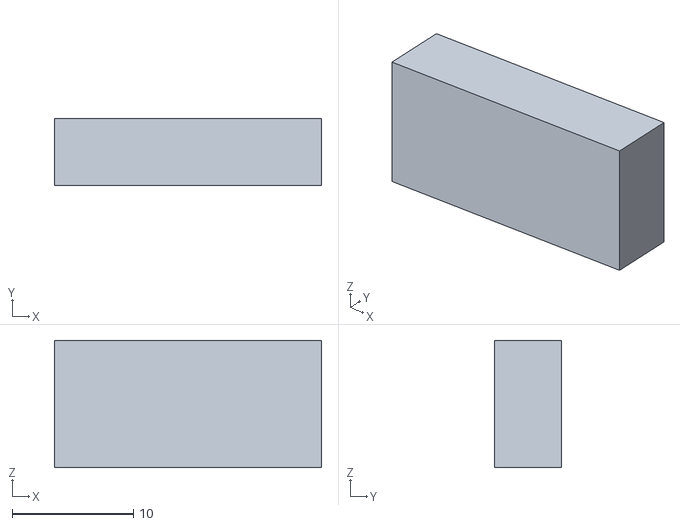
[picture p82: CAD file, 2026-10-24]
build/tr35_b2/sim/meshes/xt30_pair.stl
22.0 x 5.50 x 10.5
