Kubudak90/openduck-tr/build/sim/meshes/camera_glass.stl

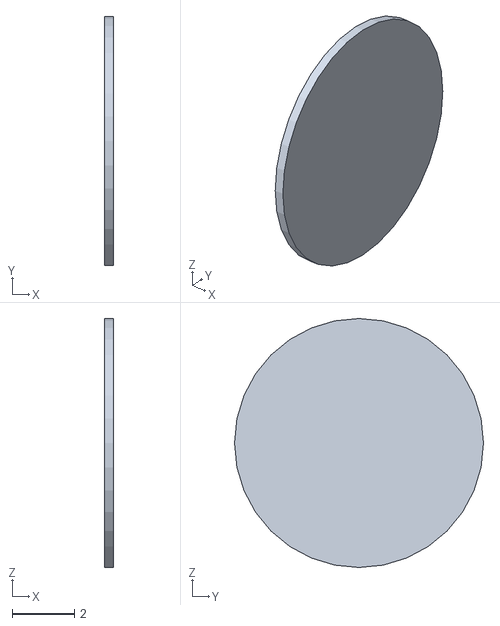
[picture p83: CAD file, 2026-10-23]
build/sim/meshes/camera_glass.stl
0.3 x 8.00 x 8.00
