Kubudak90/openduck-tr/build/tr35_b2/sim/meshes/servo_hub.stl

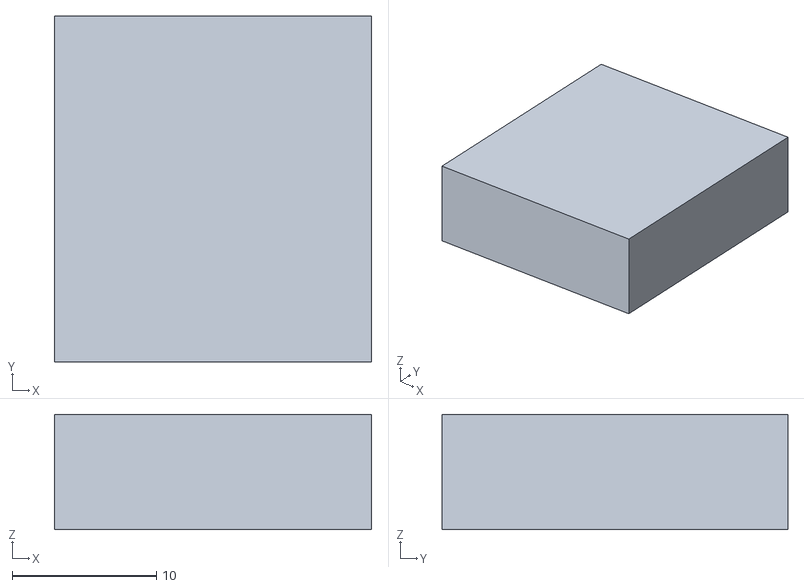
[picture p84: CAD file, 2026-10-24]
build/tr35_b2/sim/meshes/servo_hub.stl
22.0 x 24.0 x 8.00
