Kubudak90/openduck-tr/build/tr35_b2/sim/meshes/buck_hood.stl

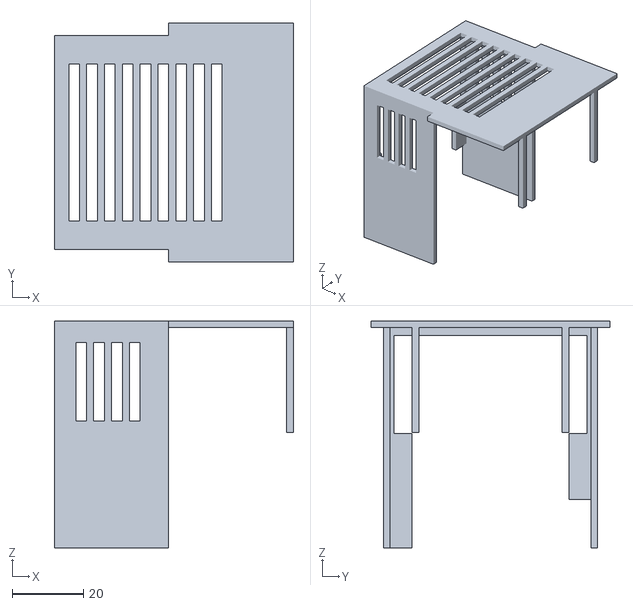
[picture p85: CAD file, 2026-10-24]
build/tr35_b2/sim/meshes/buck_hood.stl
67.0 x 67.0 x 63.5
