Kubudak90/openduck-tr/build/tr35_b2/sim/meshes/left_hip_pitch_harness_in.stl

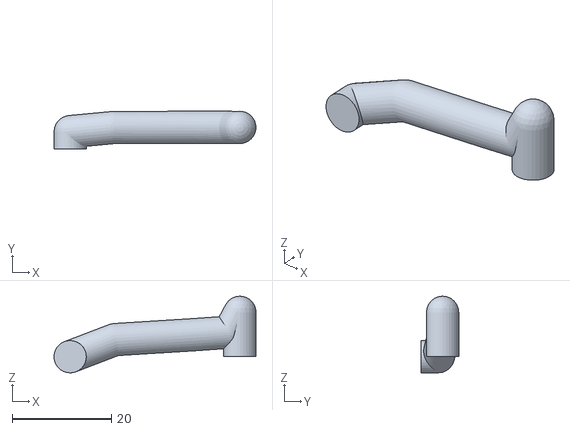
[picture p86: CAD file, 2026-10-24]
build/tr35_b2/sim/meshes/left_hip_pitch_harness_in.stl
40.6 x 7.55 x 15.4
