Kubudak90/openduck-tr/build/tr35_b2/sim/meshes/left_knee_harness_out.stl

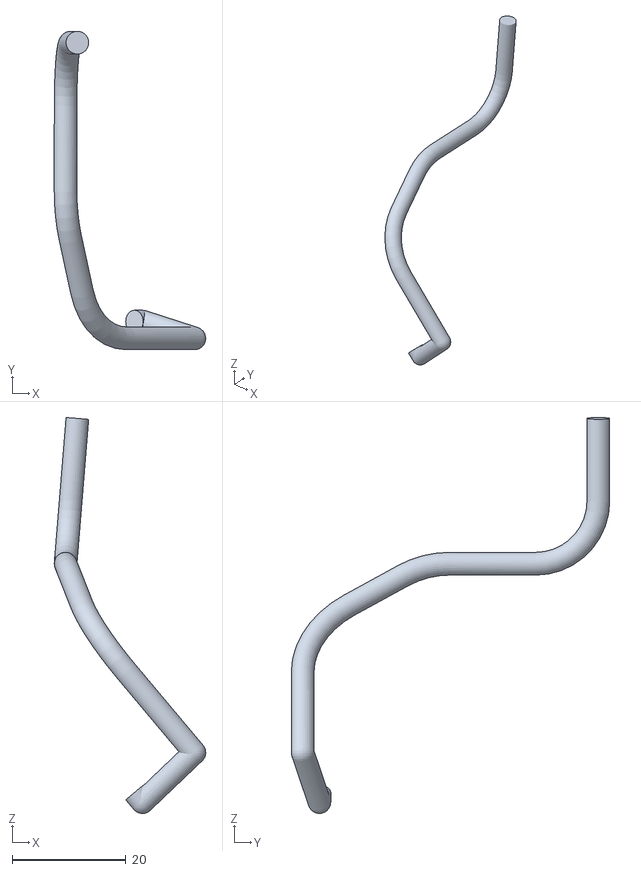
[picture p87: CAD file, 2026-10-24]
build/tr35_b2/sim/meshes/left_knee_harness_out.stl
26.7 x 56.0 x 69.6
