Kubudak90/openduck-tr/build/sim/meshes/camera_lens.stl

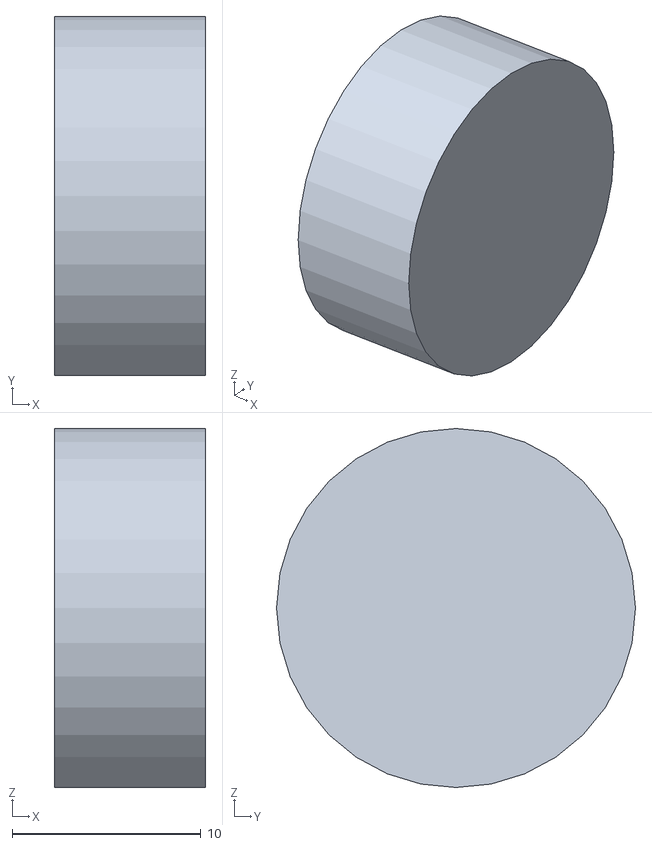
[picture p88: CAD file, 2026-10-23]
build/sim/meshes/camera_lens.stl
8.00 x 19.0 x 19.0
