Kubudak90/openduck-tr/build/tr35_b2/sim/meshes/battery_door.stl

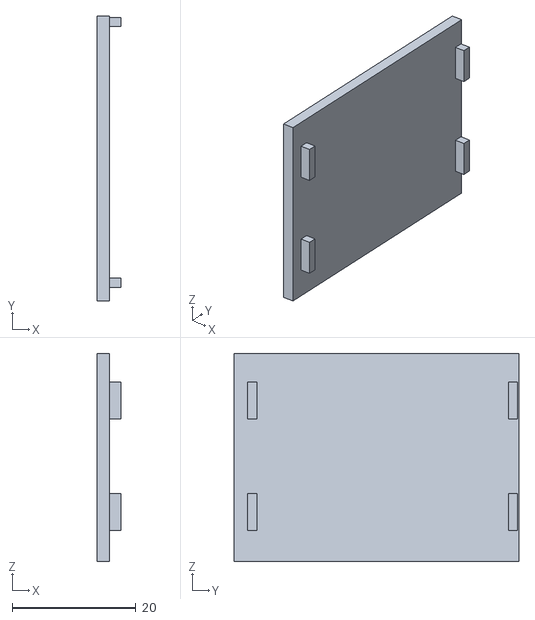
[picture p89: CAD file, 2026-10-24]
build/tr35_b2/sim/meshes/battery_door.stl
3.80 x 46.0 x 33.6
