Kubudak90/openduck-tr/build/tr35_b2/sim/meshes/left_ankle_servo.stl

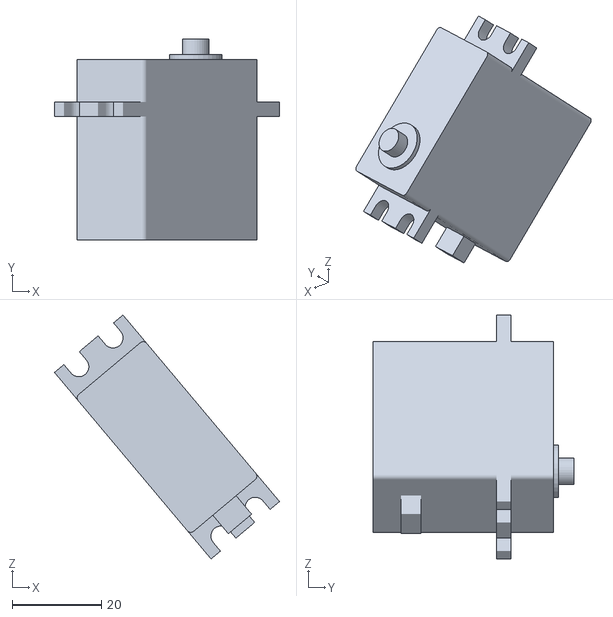
[picture p90: CAD file, 2026-10-24]
build/tr35_b2/sim/meshes/left_ankle_servo.stl
50.4 x 45.0 x 54.6
