Kubudak90/openduck-tr/build/tr35_b2/sim/meshes/jaw_hub.stl

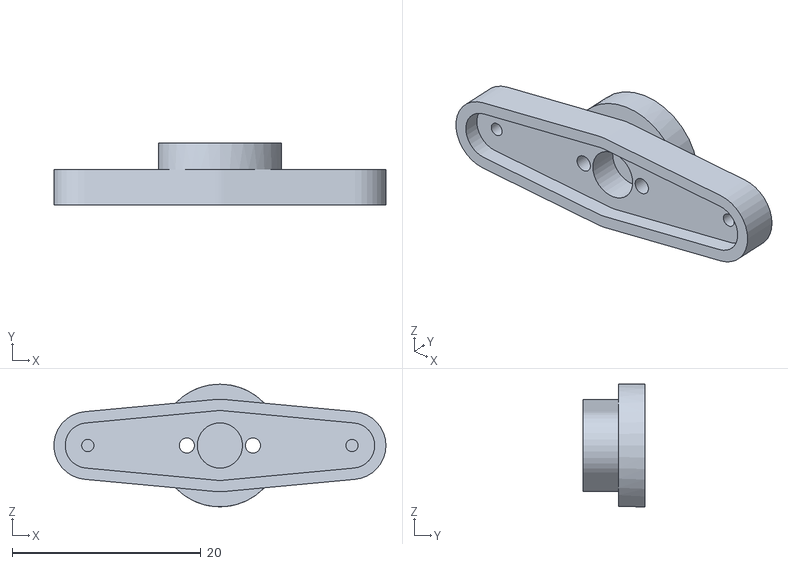
[picture p91: CAD file, 2026-10-24]
build/tr35_b2/sim/meshes/jaw_hub.stl
35.2 x 6.56 x 13.0
