Kubudak90/openduck-tr/build/sim/meshes/imu_chip.stl

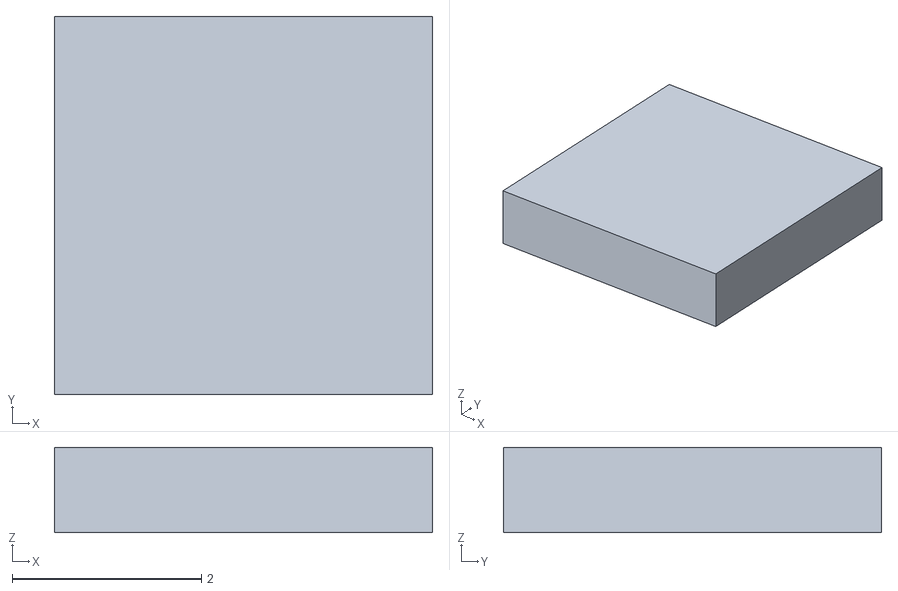
[picture p92: CAD file, 2026-10-23]
build/sim/meshes/imu_chip.stl
4.00 x 4.00 x 0.9
