Kubudak90/openduck-tr/build/tr35_b2/sim/meshes/left_knee_idler_bearing.stl

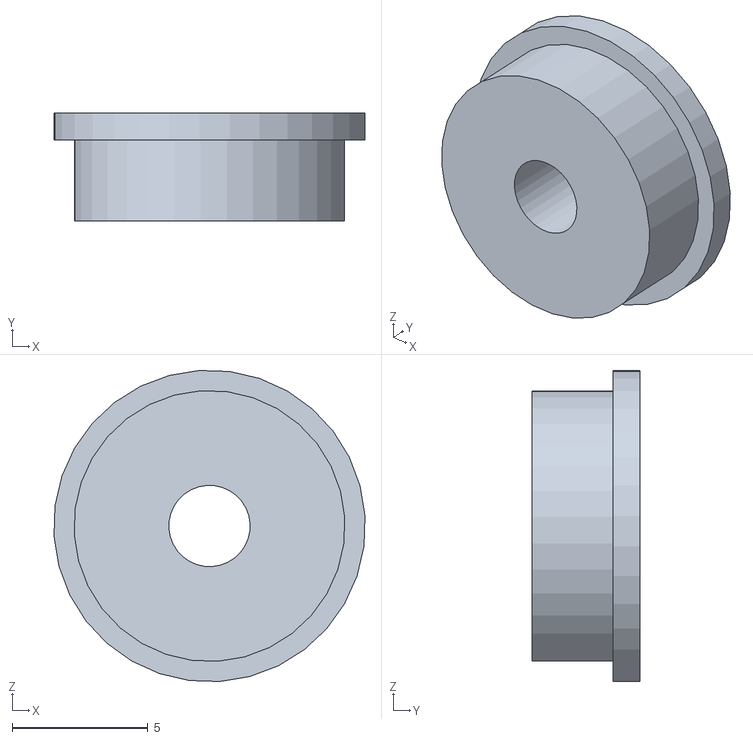
[picture p93: CAD file, 2026-10-24]
build/tr35_b2/sim/meshes/left_knee_idler_bearing.stl
11.5 x 4.00 x 11.5
