Kubudak90/openduck-tr/build/tr35_b2/sim/meshes/head_pitch_harness_in.stl

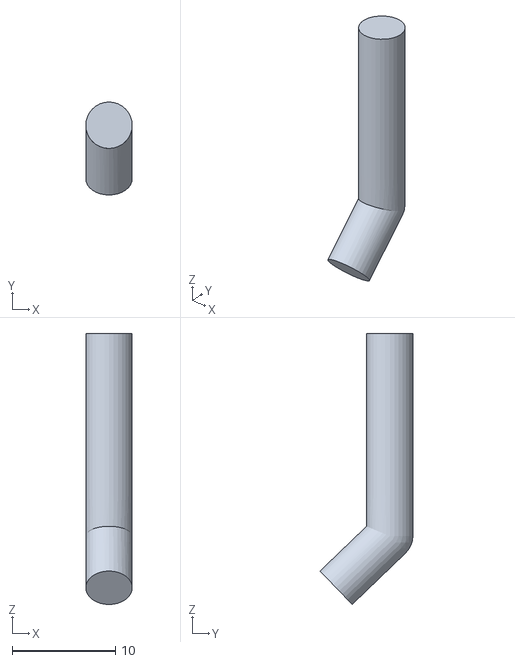
[picture p94: CAD file, 2026-10-24]
build/tr35_b2/sim/meshes/head_pitch_harness_in.stl
4.50 x 9.01 x 26.3
