Kubudak90/openduck-tr/build/tr35_b2/sim/meshes/right_hip_signal_wiring.stl

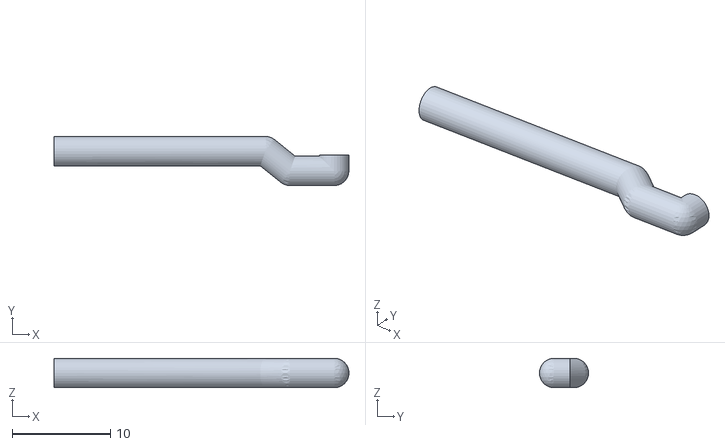
[picture p95: CAD file, 2026-10-24]
build/tr35_b2/sim/meshes/right_hip_signal_wiring.stl
30.0 x 5.00 x 3.00
