Kubudak90/openduck-tr/(list of files, cad)

Other CAD files:
build/sim/meshes/head_pitch_servo.stl
build/sim/meshes/head_frame.stl
build/sim/meshes/right_knee_servo.stl
build/tr35_b2/sim/meshes/left_foot_bracket.stl
build/print/stl/right_thigh_wing.stl
build/sim/meshes/left_hip_yaw_servo.stl
build/sim/meshes/upper_bill_pad.stl
build/print/stl/left_foot_body.stl
build/print/stl/neck_splice_1.stl
build/sim/meshes/head_roll_horn.stl
build/print/stl/left_hip_bracket.stl
build/sim/meshes/upper_bill.stl
build/print/stl/left_thigh_inner_plate.stl
build/sim/meshes/neck_pitch_horn.stl
build/print/stl/right_sole.stl
build/sim/meshes/robot_hat.stl
build/sim/meshes/right_hip_roll_horn.stl
build/sim/meshes/left_ankle_horn.stl
build/print/stl/head_bottom_shell.stl
build/print/stl/torso_shell_right.stl
build/sim/meshes/right_hip_pitch_servo.stl
build/sim/meshes/head_roll_servo.stl
build/print/stl/right_shin_pad.stl
build/sim/meshes/right_knee_horn.stl
build/print/stl/right_thigh_inner_plate.stl
build/sim/meshes/torso_shell_right.stl
build/print/stl/head_tilt_bracket.stl
build/sim/meshes/right_foot_body.stl
build/print/stl/left_hip_cradle_bracket.stl
build/sim/meshes/left_hip_cradle_bracket.stl
build/tr35_b2/sim/meshes/right_hip_pitch_idler_pin.stl
build/print/stl/left_ankle_bracket.stl
build/sim/meshes/right_hip_bracket.stl
build/print/stl/head_hood.stl
build/sim/meshes/right_sole.stl
build/print/stl/left_shin_bracket.stl
build/print/stl/left_thigh_wing.stl
build/sim/meshes/mouth_servo.stl
build/sim/meshes/left_thigh_inner_plate.stl
build/sim/meshes/right_ankle_horn.stl
build/sim/meshes/chassis.stl
build/sim/meshes/head_yaw_servo.stl
build/sim/meshes/left_hip_yaw_horn.stl
build/sim/meshes/left_thigh_wing.stl
build/tr35_b2/sim/meshes/right_ankle_horn.stl
build/sim/meshes/neck_pitch_servo.stl
build/tr35_b2/sim/meshes/neck_pitch_horn.stl
build/sim/meshes/left_hip_bracket.stl
build/sim/meshes/left_knee_horn.stl
build/sim/meshes/torso_shell_left.stl
build/sim/meshes/left_knee_servo.stl
build/tr35_b2/sim/meshes/left_hip_roll_horn.stl
build/sim/meshes/right_hip_yaw_servo.stl
build/tr35_b2/sim/meshes/left_hip_yaw_bearing_lo.stl
build/sim/meshes/right_hip_cradle_bracket.stl
build/sim/meshes/left_shin_pad.stl
build/sim/meshes/right_shin_pad.stl
build/sim/meshes/head_turn_bracket.stl
build/tr35_b2/sim/meshes/neck_pitch_idler_pin.stl
build/sim/meshes/left_ankle_bracket.stl
build/tr35_b2/sim/meshes/right_hip_pitch_idler_bearing.stl
build/sim/meshes/right_shin_bracket.stl
build/openduck.FCStd
build/sim/meshes/battery_tray.stl
build/sim/meshes/eye_ring.stl
build/sim/meshes/face_plate.stl
build/sim/meshes/head_pitch_horn.stl
build/sim/meshes/imu_board.stl
build/sim/meshes/left_ankle_bearing.stl
build/sim/meshes/left_ankle_servo.stl
build/sim/meshes/left_hip_pitch_servo.stl
build/sim/meshes/left_hip_roll_horn.stl
build/sim/meshes/left_shin_bracket.stl
build/sim/meshes/lower_bill.stl
build/sim/meshes/lower_bill_pad.stl
build/sim/meshes/mouth_horn.stl
build/sim/meshes/rec_led.stl
build/sim/meshes/right_ankle_bracket.stl
build/sim/meshes/right_ankle_servo.stl
build/sim/meshes/right_hip_roll_servo.stl
build/sim/meshes/right_hip_yaw_horn.stl
build/stl/battery_tray.stl
build/stl/chassis.stl
build/stl/eye_ring.stl
build/stl/face_plate.stl
build/stl/head_bottom_shell.stl
build/stl/head_frame.stl
build/stl/head_hood.stl
build/stl/head_tilt_bracket.stl
build/stl/left_ankle_bracket.stl
build/stl/left_foot_body.stl
build/stl/left_hip_bracket.stl
build/stl/left_hip_cradle_bracket.stl
build/stl/left_shin_bracket.stl
build/stl/left_shin_pad.stl
build/stl/left_sole.stl
build/stl/left_thigh_inner_plate.stl
build/stl/left_thigh_wing.stl
build/stl/lower_bill.stl
build/stl/lower_bill_pad.stl
build/stl/right_ankle_bracket.stl
build/stl/right_foot_body.stl
build/stl/right_hip_bracket.stl
build/stl/right_hip_cradle_bracket.stl
build/stl/right_shin_bracket.stl
build/stl/right_shin_pad.stl
build/stl/right_sole.stl
build/stl/right_thigh_inner_plate.stl
build/stl/right_thigh_wing.stl
build/stl/torso_shell_left.stl
build/stl/torso_shell_right.stl
build/stl/upper_bill.stl
build/stl/upper_bill_pad.stl
build/tr35_b2/sim/meshes/ads1115_2.stl
build/tr35_b2/sim/meshes/aux_bus_cap.stl
build/tr35_b2/sim/meshes/battery_lead_wiring.stl
build/tr35_b2/sim/meshes/belly_duct.stl
build/tr35_b2/sim/meshes/buck_20a.stl
build/tr35_b2/sim/meshes/deck_cover.stl
build/tr35_b2/sim/meshes/esp32_s3_devkitc.stl
build/tr35_b2/sim/meshes/fuse_15a.stl
build/tr35_b2/sim/meshes/head_frame.stl
build/tr35_b2/sim/meshes/head_frame_screws_left.stl
build/tr35_b2/sim/meshes/head_frame_screws_right.stl
build/tr35_b2/sim/meshes/head_hood.stl
build/tr35_b2/sim/meshes/head_pitch_harness_out.stl
build/tr35_b2/sim/meshes/head_pitch_horn.stl
build/tr35_b2/sim/meshes/head_pitch_servo.stl
build/tr35_b2/sim/meshes/head_pitch_tab_screws.stl
build/tr35_b2/sim/meshes/head_pitch_thrust_out.stl
build/tr35_b2/sim/meshes/head_pitch_thrust_out_screws.stl
build/tr35_b2/sim/meshes/head_pitch_thrust_screws.stl
build/tr35_b2/sim/meshes/head_roll_harness_out.stl
build/tr35_b2/sim/meshes/head_roll_horn.stl
build/tr35_b2/sim/meshes/head_tilt_bracket.stl
build/tr35_b2/sim/meshes/head_yaw_harness_in.stl
build/tr35_b2/sim/meshes/head_yaw_harness_out.stl
build/tr35_b2/sim/meshes/head_yaw_retainer_left.stl
build/tr35_b2/sim/meshes/head_yaw_retainer_screws.stl
build/tr35_b2/sim/meshes/head_yaw_servo.stl
build/tr35_b2/sim/meshes/imu_mpu6500.stl
build/tr35_b2/sim/meshes/jaw_hub_screws.stl
build/tr35_b2/sim/meshes/jaw_pin_bushing.stl
build/tr35_b2/sim/meshes/jaw_pin_bushing_screws.stl
build/tr35_b2/sim/meshes/left_ankle_idler_bearing.stl
build/tr35_b2/sim/meshes/left_ankle_idler_pin.stl
build/tr35_b2/sim/meshes/left_ankle_tab_screws.stl
build/tr35_b2/sim/meshes/left_hip_bracket.stl
build/tr35_b2/sim/meshes/left_hip_cradle_bracket.stl
build/tr35_b2/sim/meshes/left_hip_pitch_harness_out.stl
build/tr35_b2/sim/meshes/left_hip_pitch_idler_bearing.stl
build/tr35_b2/sim/meshes/left_hip_pitch_idler_pin.stl
build/tr35_b2/sim/meshes/left_hip_pitch_servo.stl
build/tr35_b2/sim/meshes/left_hip_pitch_tab_screws.stl
build/tr35_b2/sim/meshes/left_hip_power_wiring.stl
build/tr35_b2/sim/meshes/left_hip_roll_harness_in.stl
build/tr35_b2/sim/meshes/left_hip_roll_harness_out.stl
build/tr35_b2/sim/meshes/left_hip_roll_idler_pin.stl
build/tr35_b2/sim/meshes/left_hip_roll_servo.stl
build/tr35_b2/sim/meshes/left_hip_roll_tab_screws.stl
build/tr35_b2/sim/meshes/left_hip_signal_wiring.stl
build/tr35_b2/sim/meshes/left_hip_trunk_wiring.stl
build/tr35_b2/sim/meshes/left_hip_yaw_harness_in.stl
build/tr35_b2/sim/meshes/left_hip_yaw_harness_out.stl
build/tr35_b2/sim/meshes/left_hip_yaw_horn.stl
build/tr35_b2/sim/meshes/left_hip_yaw_screws.stl
build/tr35_b2/sim/meshes/left_hip_yaw_shaft.stl
build/tr35_b2/sim/meshes/left_knee_harness_in.stl
build/tr35_b2/sim/meshes/left_knee_horn.stl
build/tr35_b2/sim/meshes/left_knee_idler_pin.stl
build/tr35_b2/sim/meshes/left_knee_tab_screws.stl
build/tr35_b2/sim/meshes/left_shin_bracket.stl
build/tr35_b2/sim/meshes/left_sole.stl
build/tr35_b2/sim/meshes/left_thigh_bracket.stl
build/tr35_b2/sim/meshes/leg_bus_cap_2.stl
build/tr35_b2/sim/meshes/lipo_alarm.stl
build/tr35_b2/sim/meshes/lower_bill.stl
build/tr35_b2/sim/meshes/mouth_horn.stl
build/tr35_b2/sim/meshes/mouth_servo.stl
build/tr35_b2/sim/meshes/mp1584.stl
build/tr35_b2/sim/meshes/neck_arm_screws.stl
build/tr35_b2/sim/meshes/neck_bumper.stl
build/tr35_b2/sim/meshes/neck_pitch_harness_in.stl
build/tr35_b2/sim/meshes/neck_pitch_harness_out.stl
build/tr35_b2/sim/meshes/neck_pitch_idler_seat.stl
build/tr35_b2/sim/meshes/neck_pitch_servo.stl
build/tr35_b2/sim/meshes/neck_trunk_wiring.stl
build/tr35_b2/sim/meshes/overshoot_clamp.stl
build/tr35_b2/sim/meshes/pca9685_1.stl
build/tr35_b2/sim/meshes/right_ankle_idler_bearing.stl
build/tr35_b2/sim/meshes/right_ankle_servo.stl
build/tr35_b2/sim/meshes/right_ankle_tab_screws.stl
build/tr35_b2/sim/meshes/right_hip_bracket.stl
build/tr35_b2/sim/meshes/right_hip_pitch_harness_in.stl
build/tr35_b2/sim/meshes/right_hip_pitch_harness_out.stl
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
