Kubudak90/openduck-tr/build/docs/exploded_head_iso.png

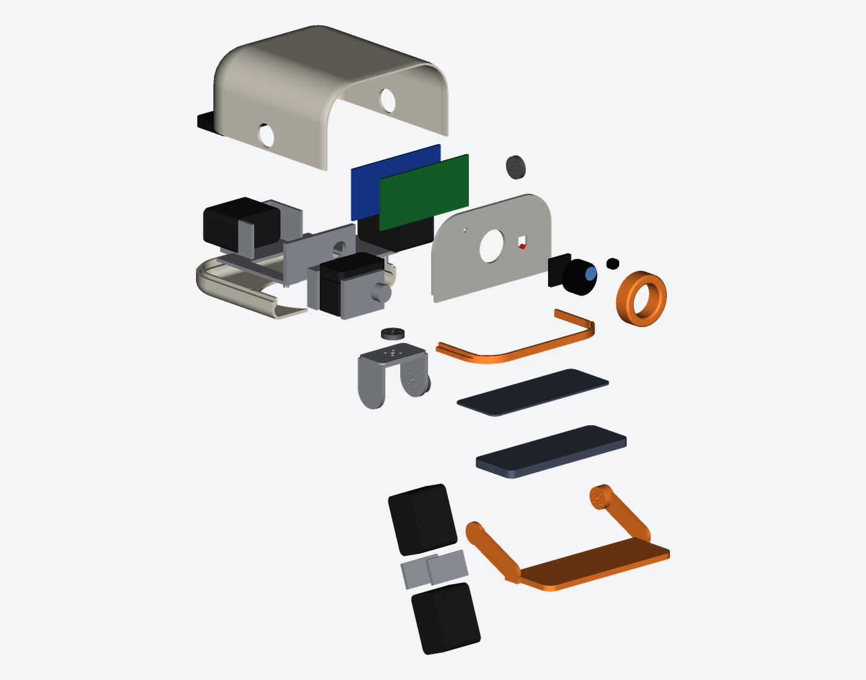
build/docs/exploded_head_iso.png
