Kubudak90/openduck-tr/build/docs/exploded_leg_iso.png

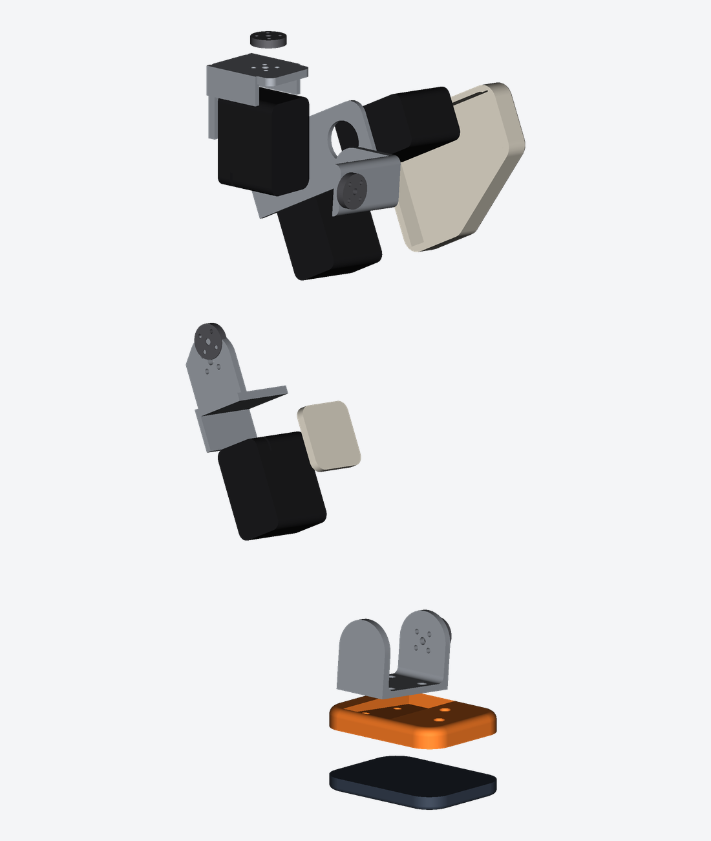
build/docs/exploded_leg_iso.png
