Kubudak90/openduck-tr/build/docs/exploded_side.png

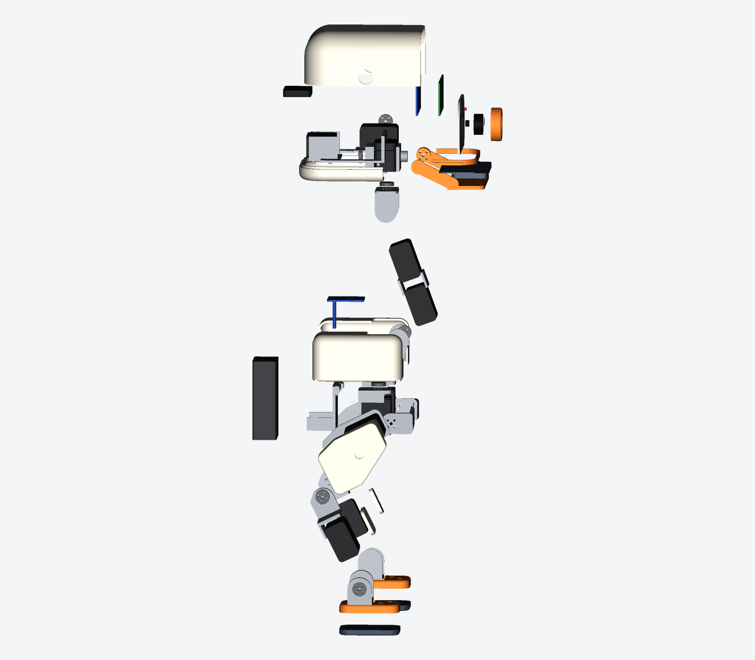
build/docs/exploded_side.png
