Kubudak90/openduck-tr/build/docs/sheet_02_battery_tray.png

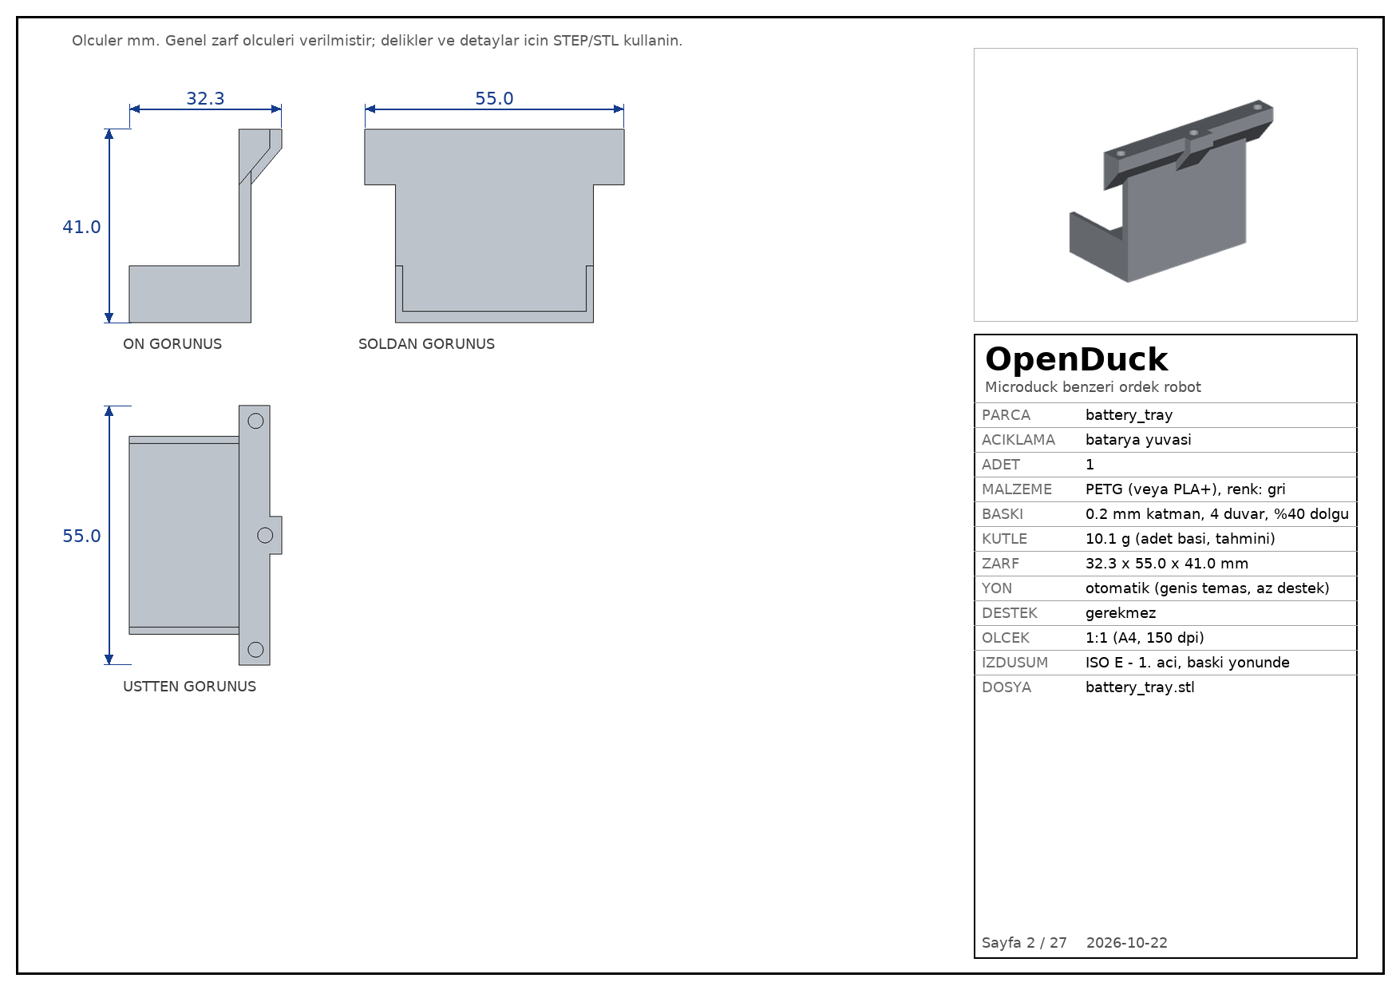
build/docs/sheet_02_battery_tray.png
