Kubudak90/openduck-tr/build/docs/sheet_03_torso_shell_left.png

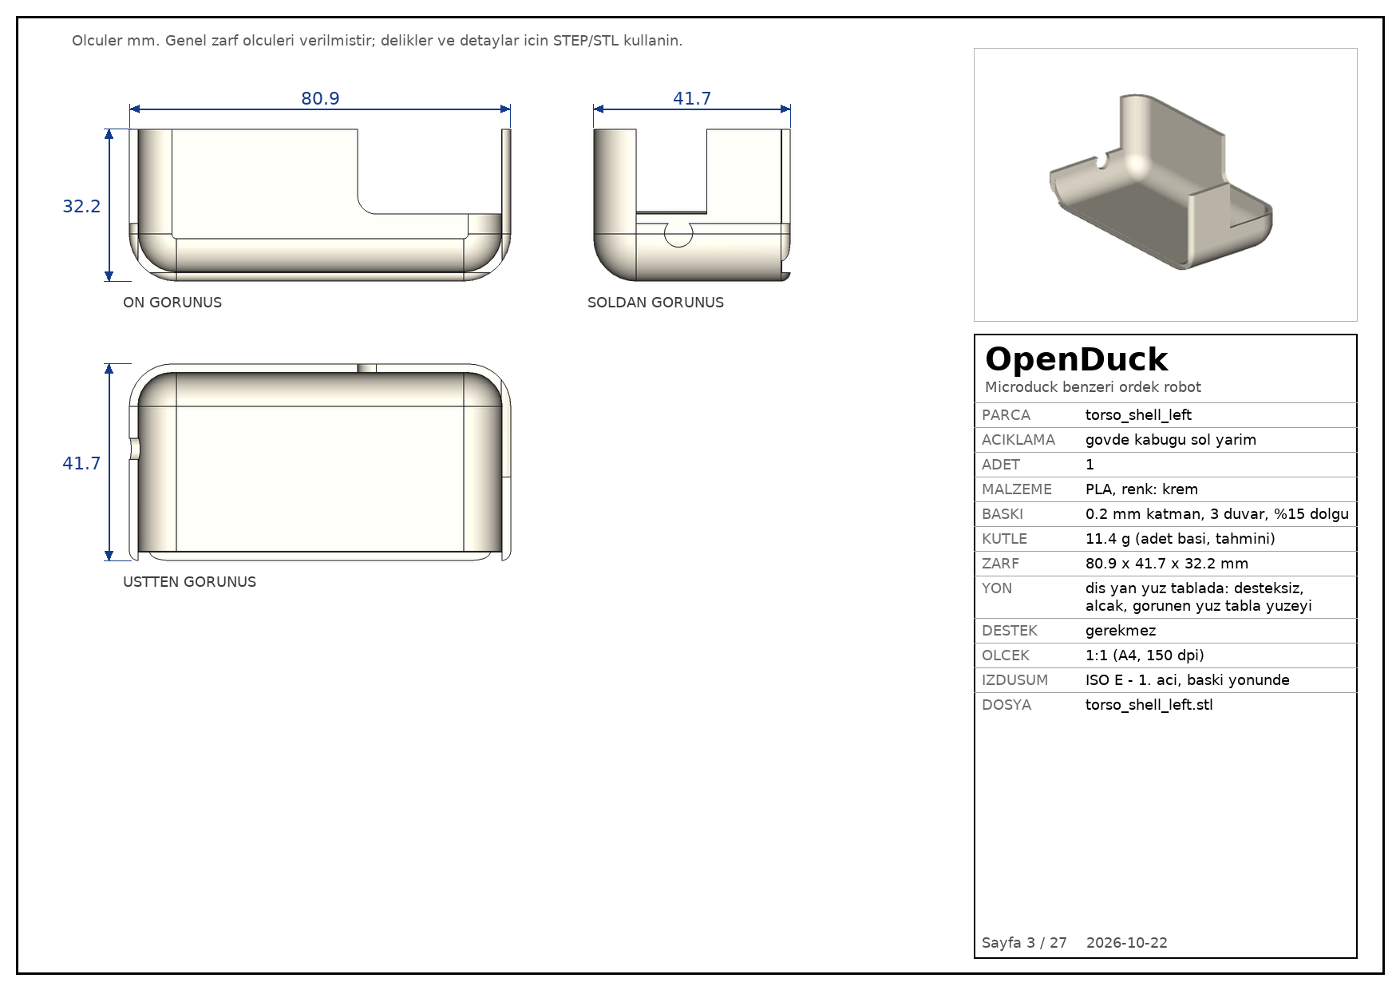
build/docs/sheet_03_torso_shell_left.png
