Kubudak90/openduck-tr/build/docs/sheet_04_torso_shell_right.png

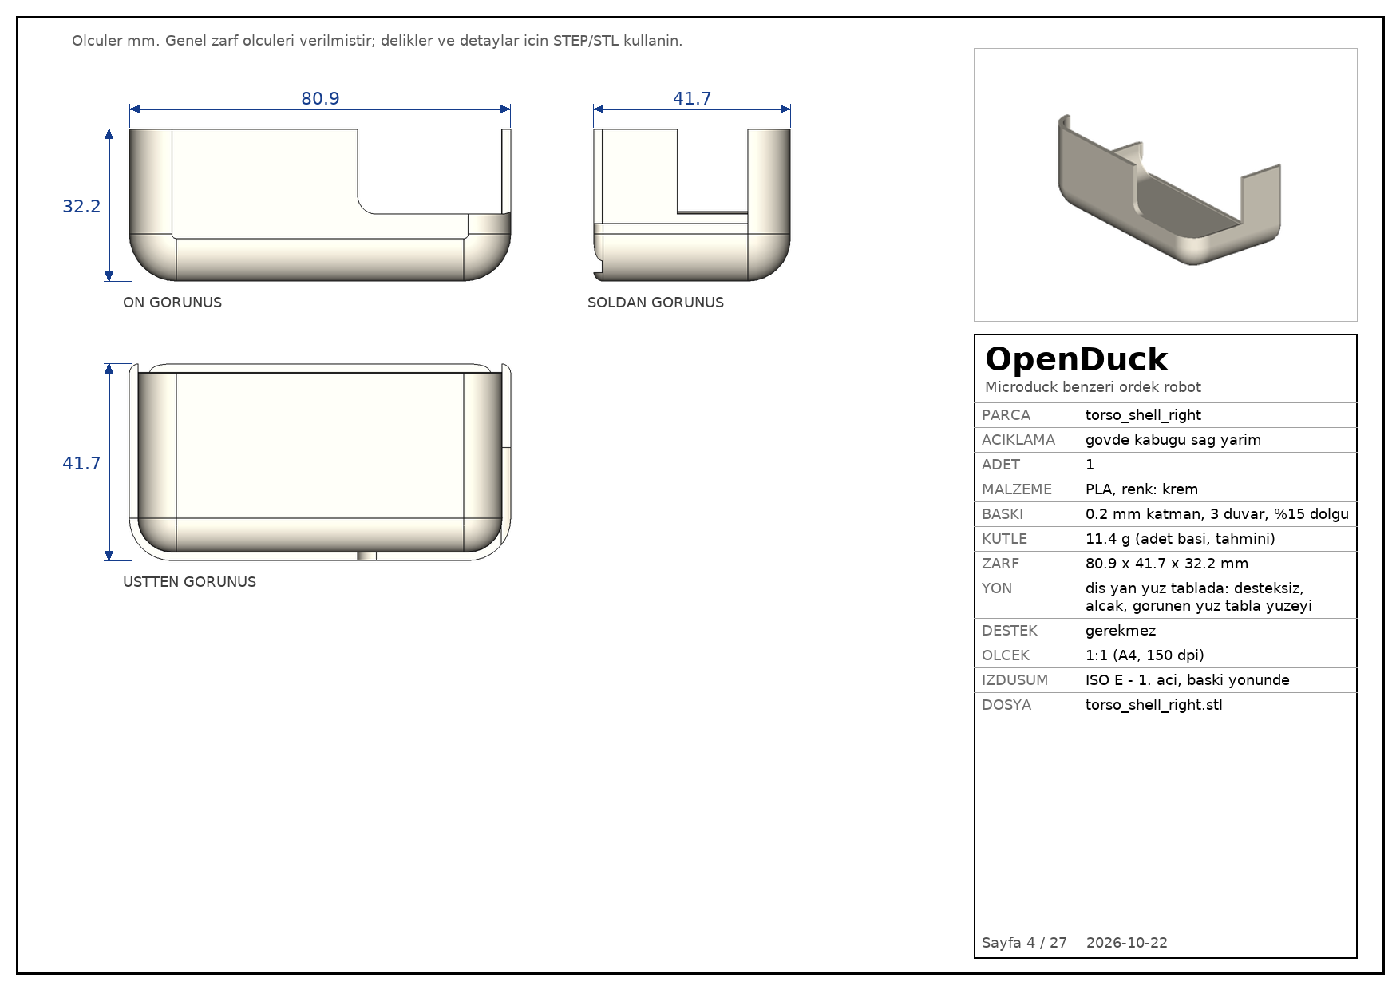
build/docs/sheet_04_torso_shell_right.png
