Kubudak90/openduck-tr/build/docs/sheet_05_hip_bracket.png

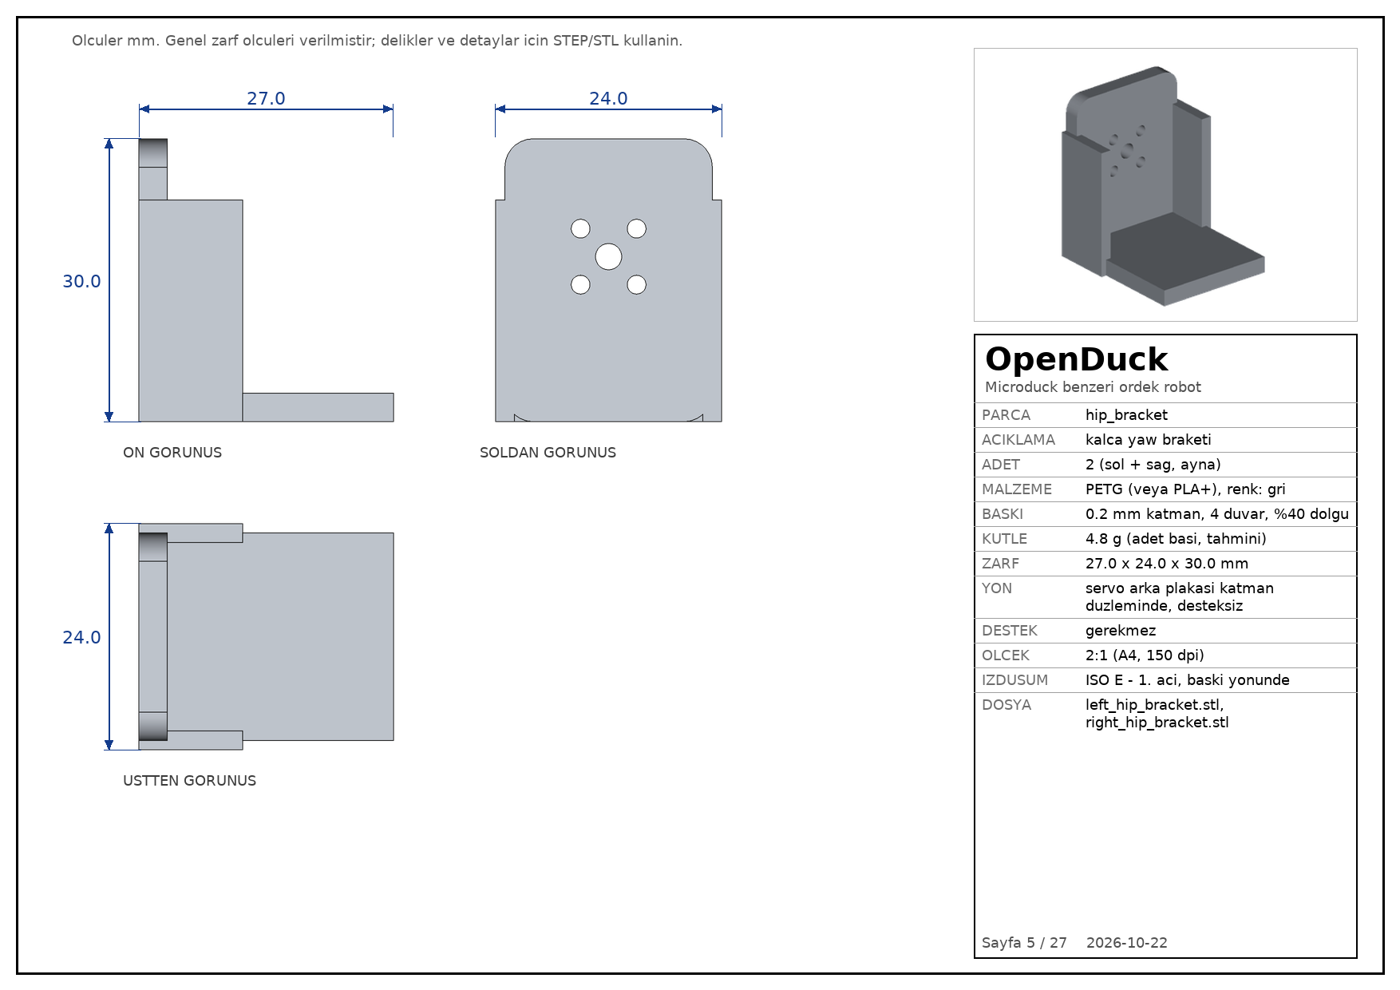
build/docs/sheet_05_hip_bracket.png
