Kubudak90/openduck-tr/build/docs/sheet_06_hip_cradle_bracket.png

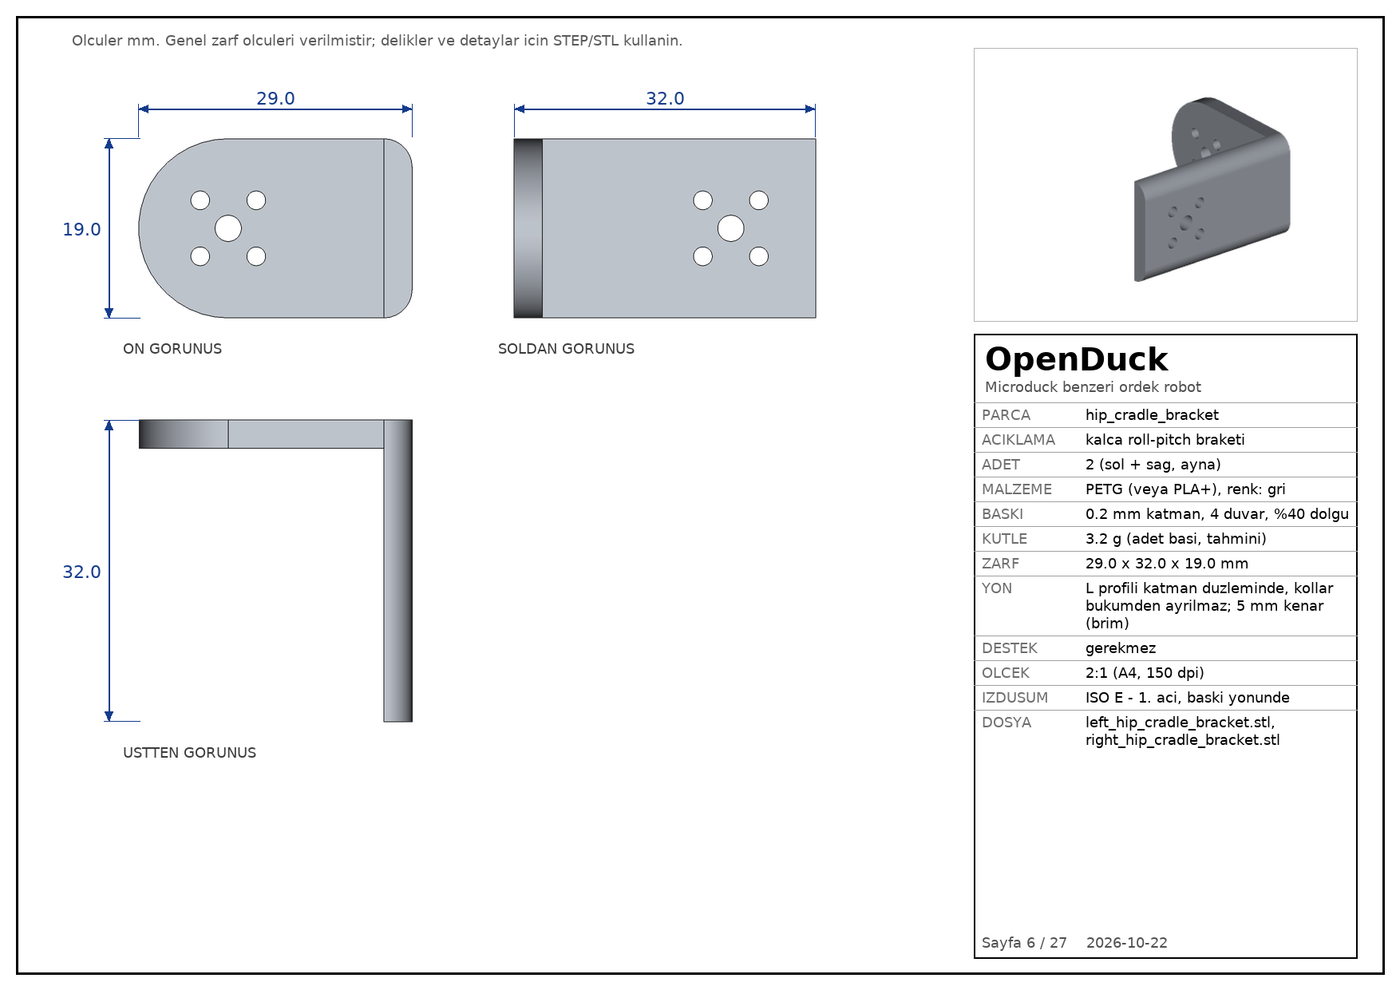
build/docs/sheet_06_hip_cradle_bracket.png
