Kubudak90/openduck-tr/build/docs/sheet_07_thigh_inner_plate.png

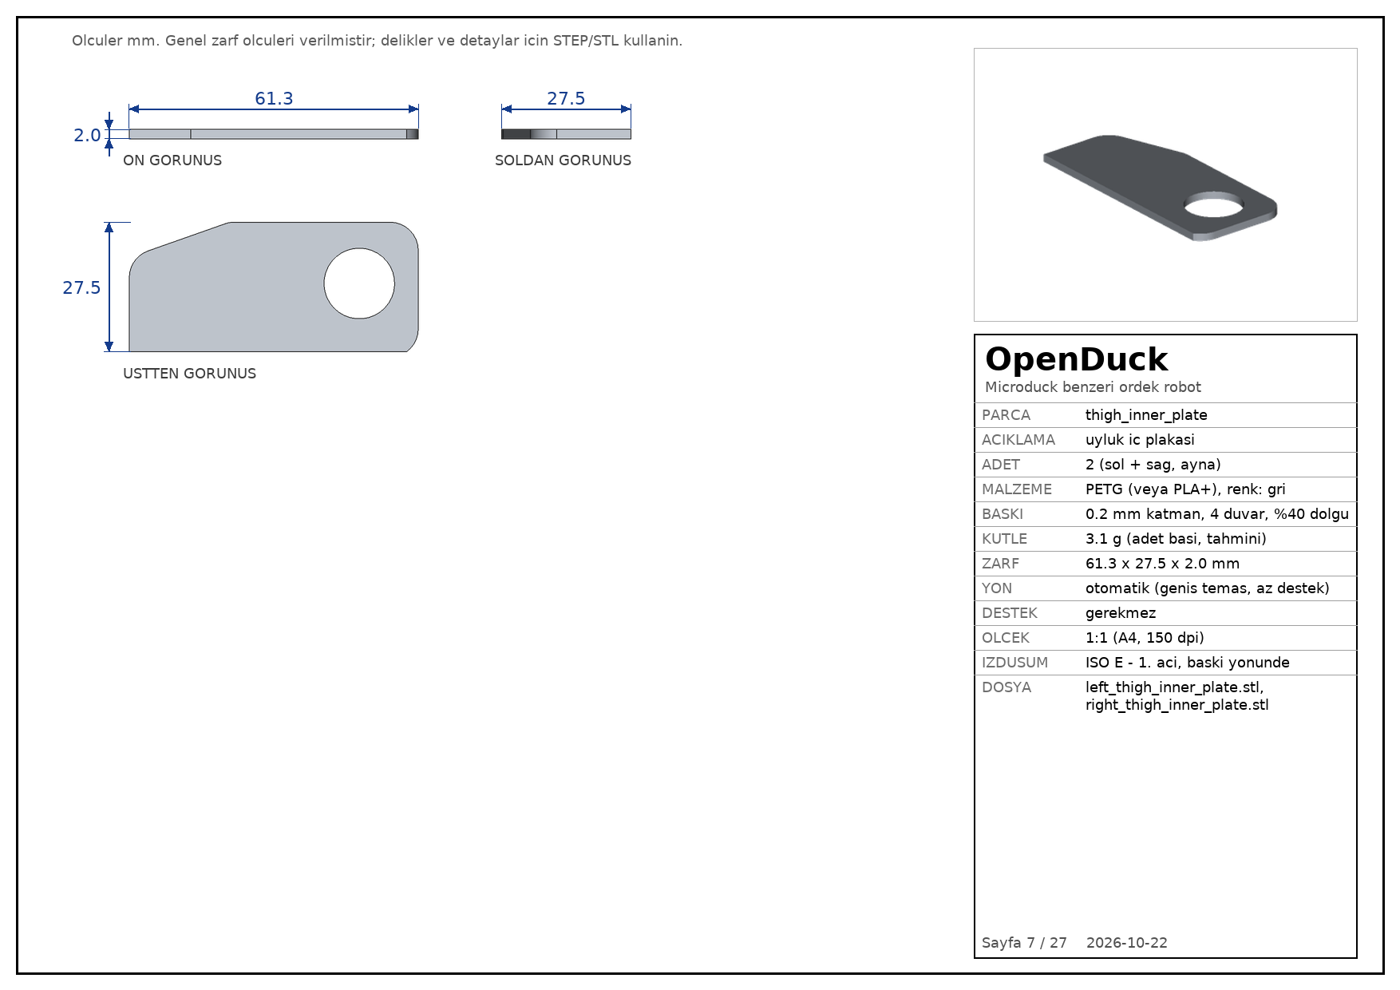
build/docs/sheet_07_thigh_inner_plate.png
