Kubudak90/openduck-tr/build/docs/sheet_08_thigh_wing.png

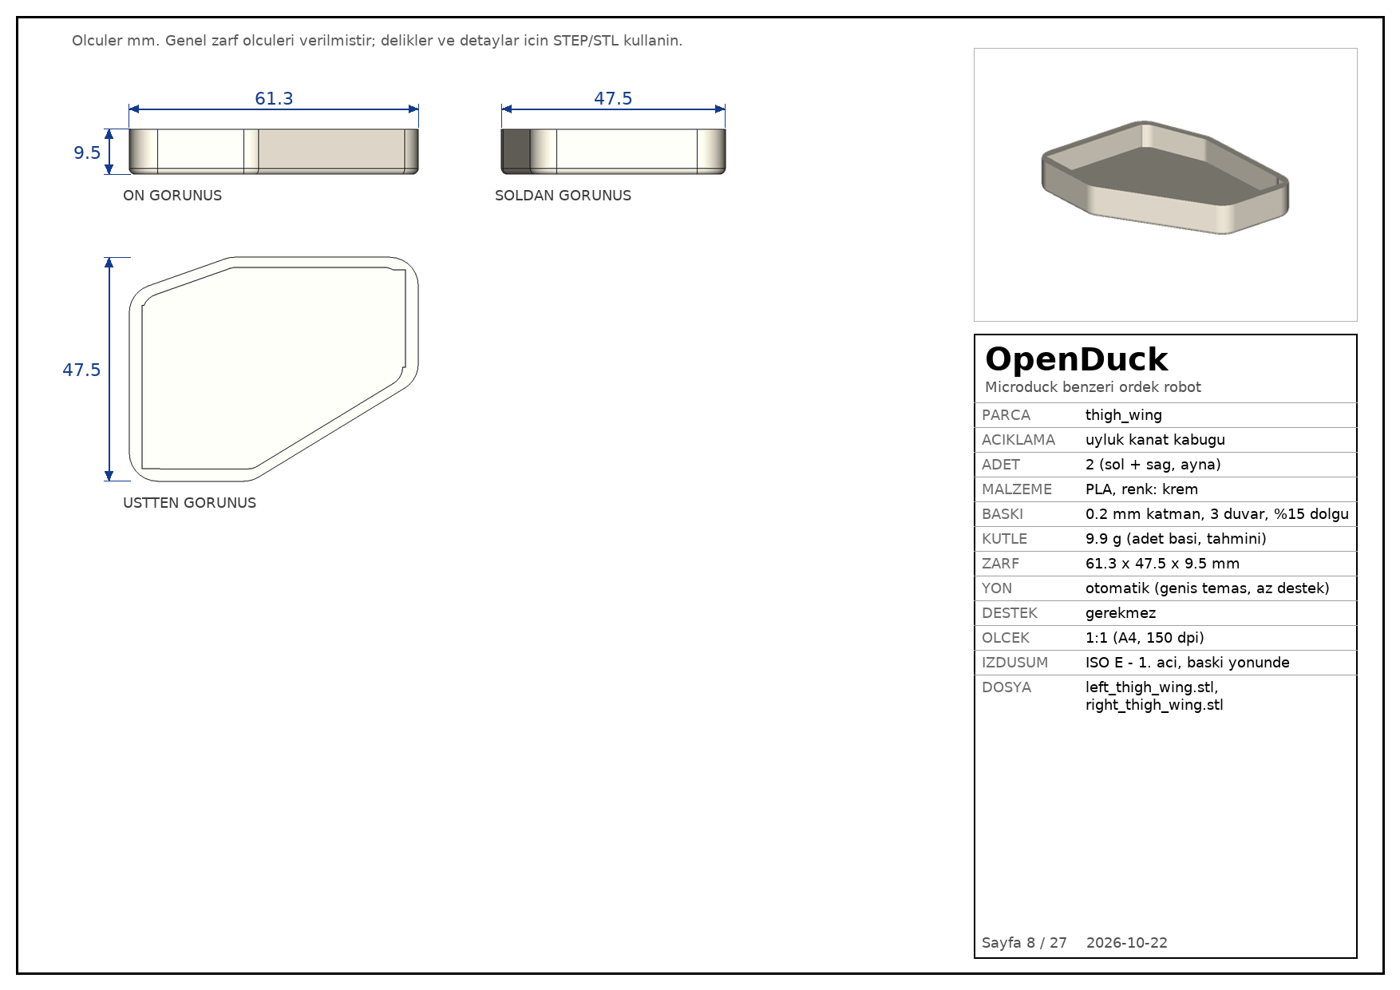
build/docs/sheet_08_thigh_wing.png
