Kubudak90/openduck-tr/build/docs/sheet_09_shin_bracket.png

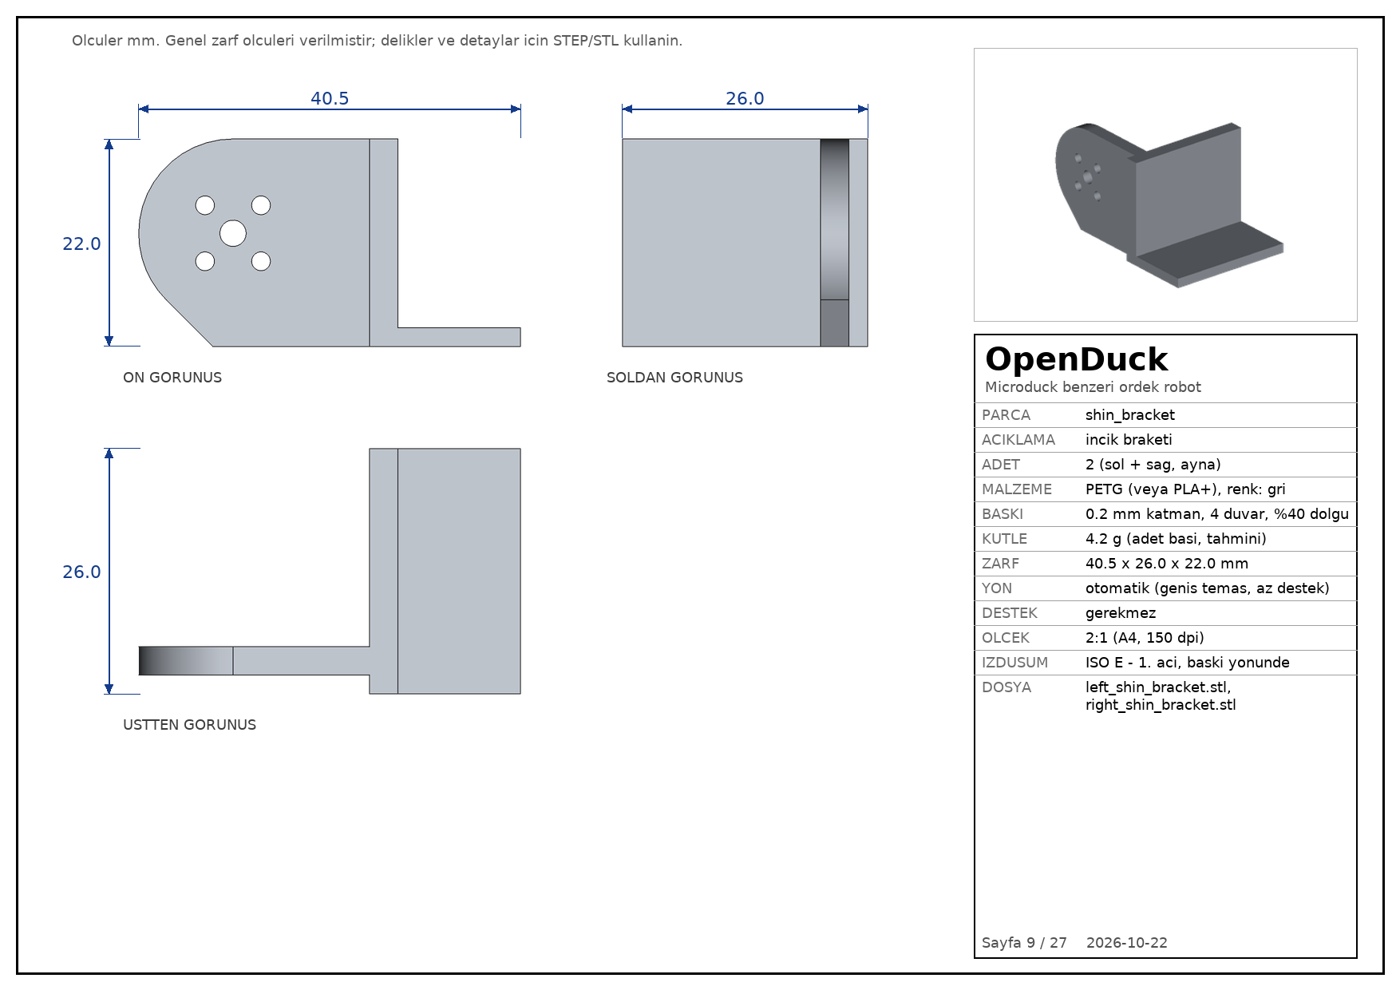
build/docs/sheet_09_shin_bracket.png
