Kubudak90/openduck-tr/build/docs/sheet_10_shin_pad.png

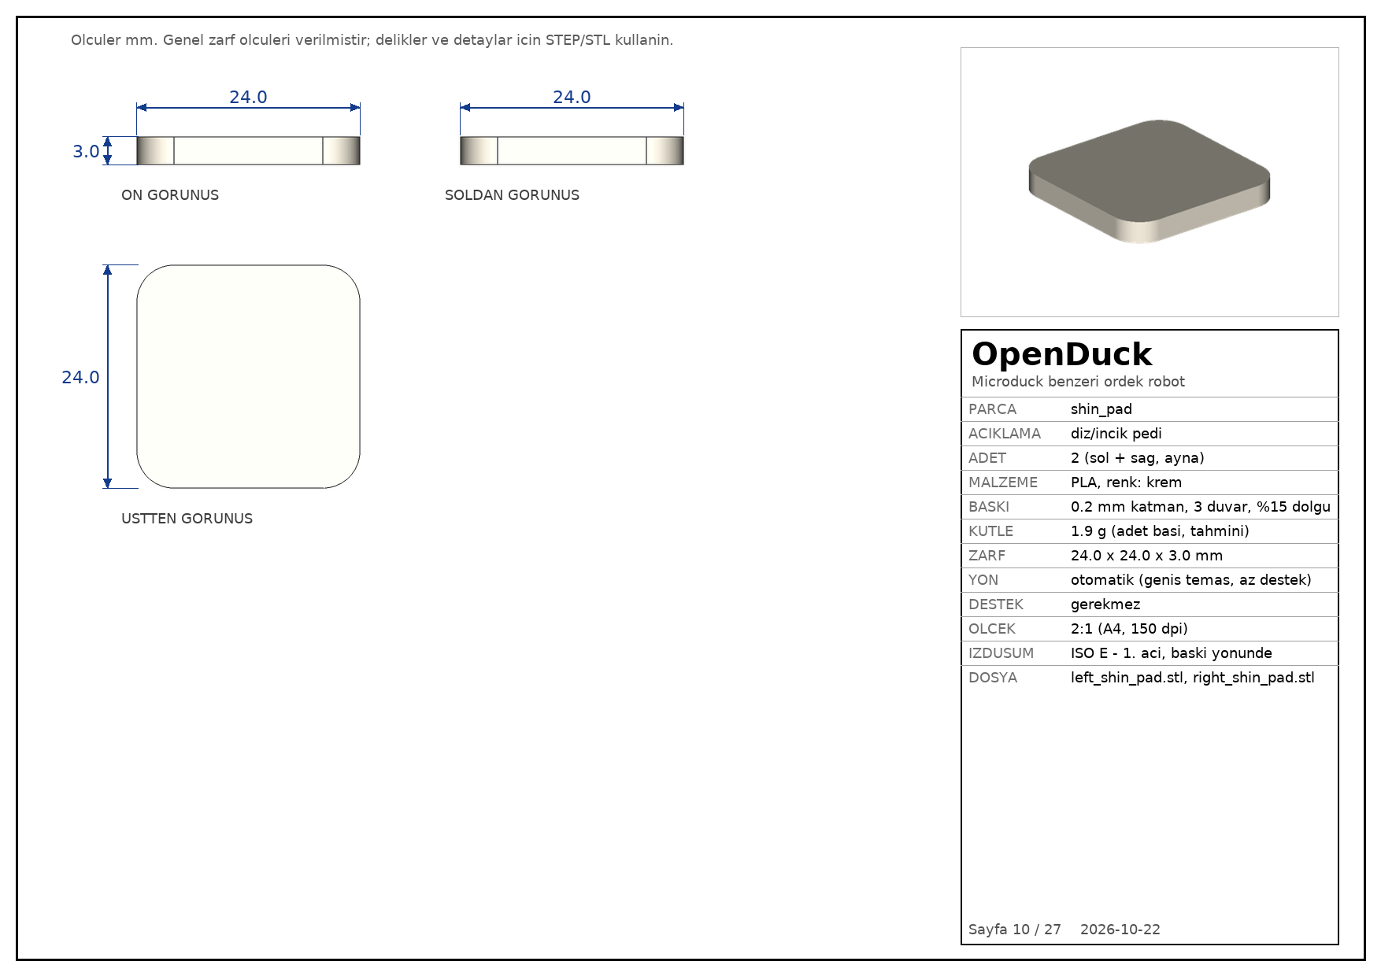
build/docs/sheet_10_shin_pad.png
