Kubudak90/openduck-tr/build/docs/sheet_11_ankle_bracket.png

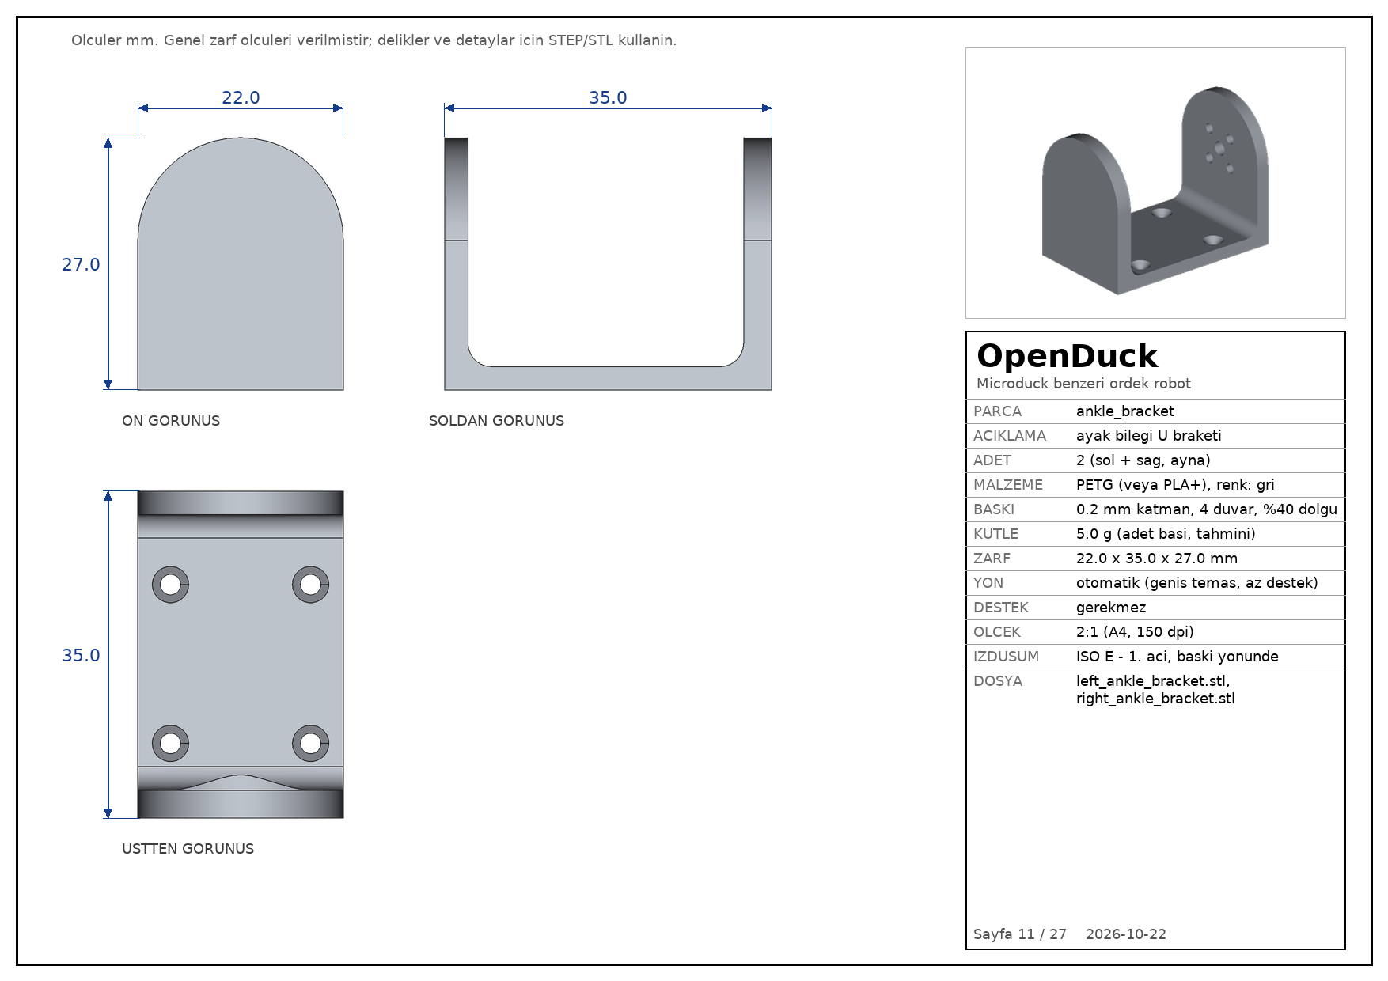
build/docs/sheet_11_ankle_bracket.png
