Kubudak90/openduck-tr/build/docs/sheet_14_neck_splice_1.png

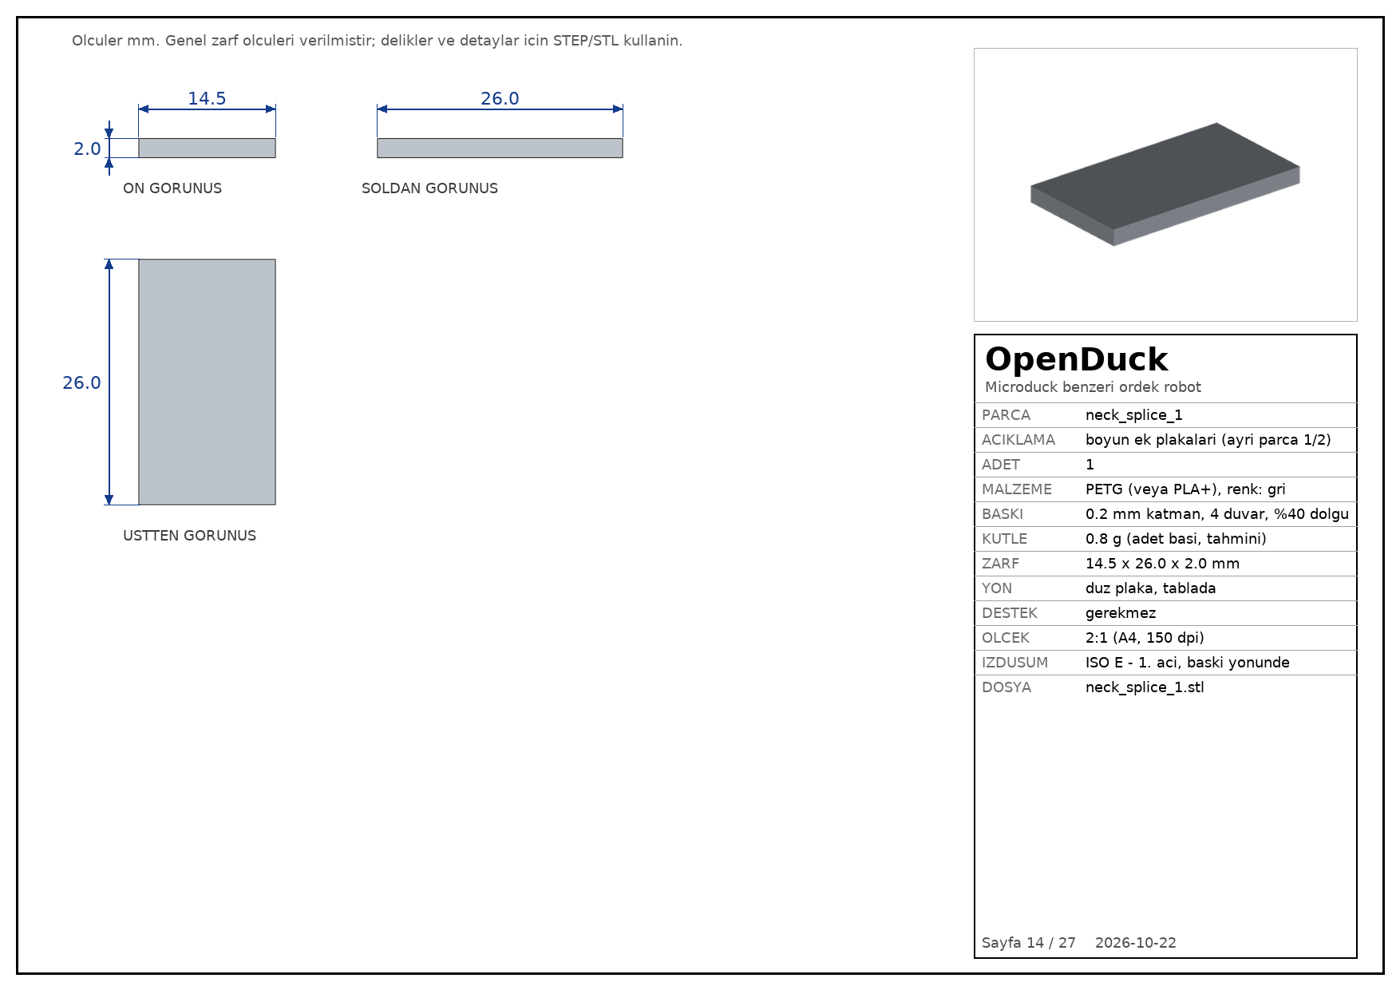
build/docs/sheet_14_neck_splice_1.png
