Kubudak90/openduck-tr/build/docs/sheet_16_head_tilt_bracket.png

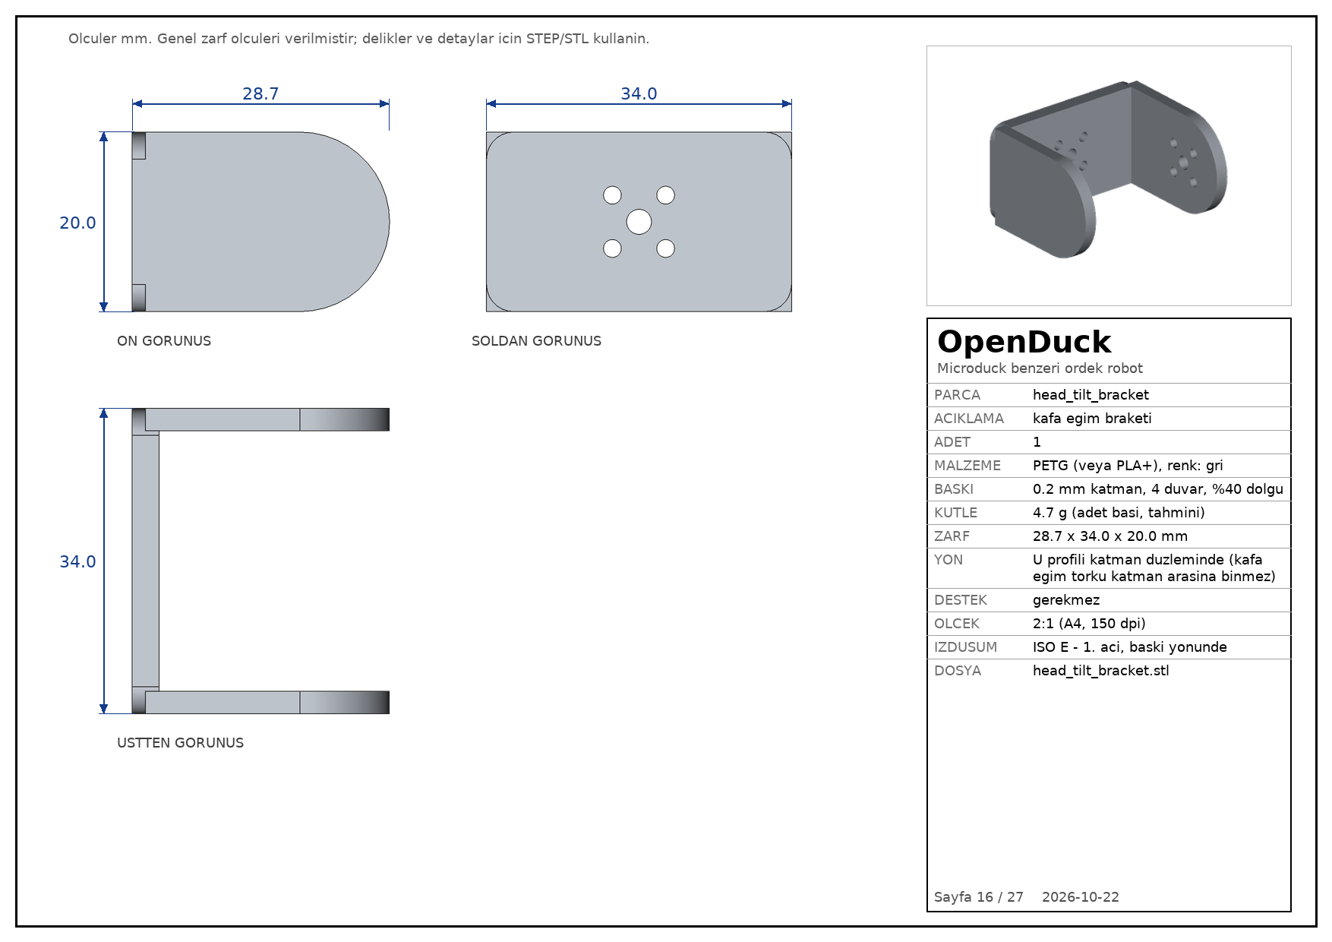
build/docs/sheet_16_head_tilt_bracket.png
