Kubudak90/openduck-tr/build/docs/sheet_17_head_turn_bracket_1.png

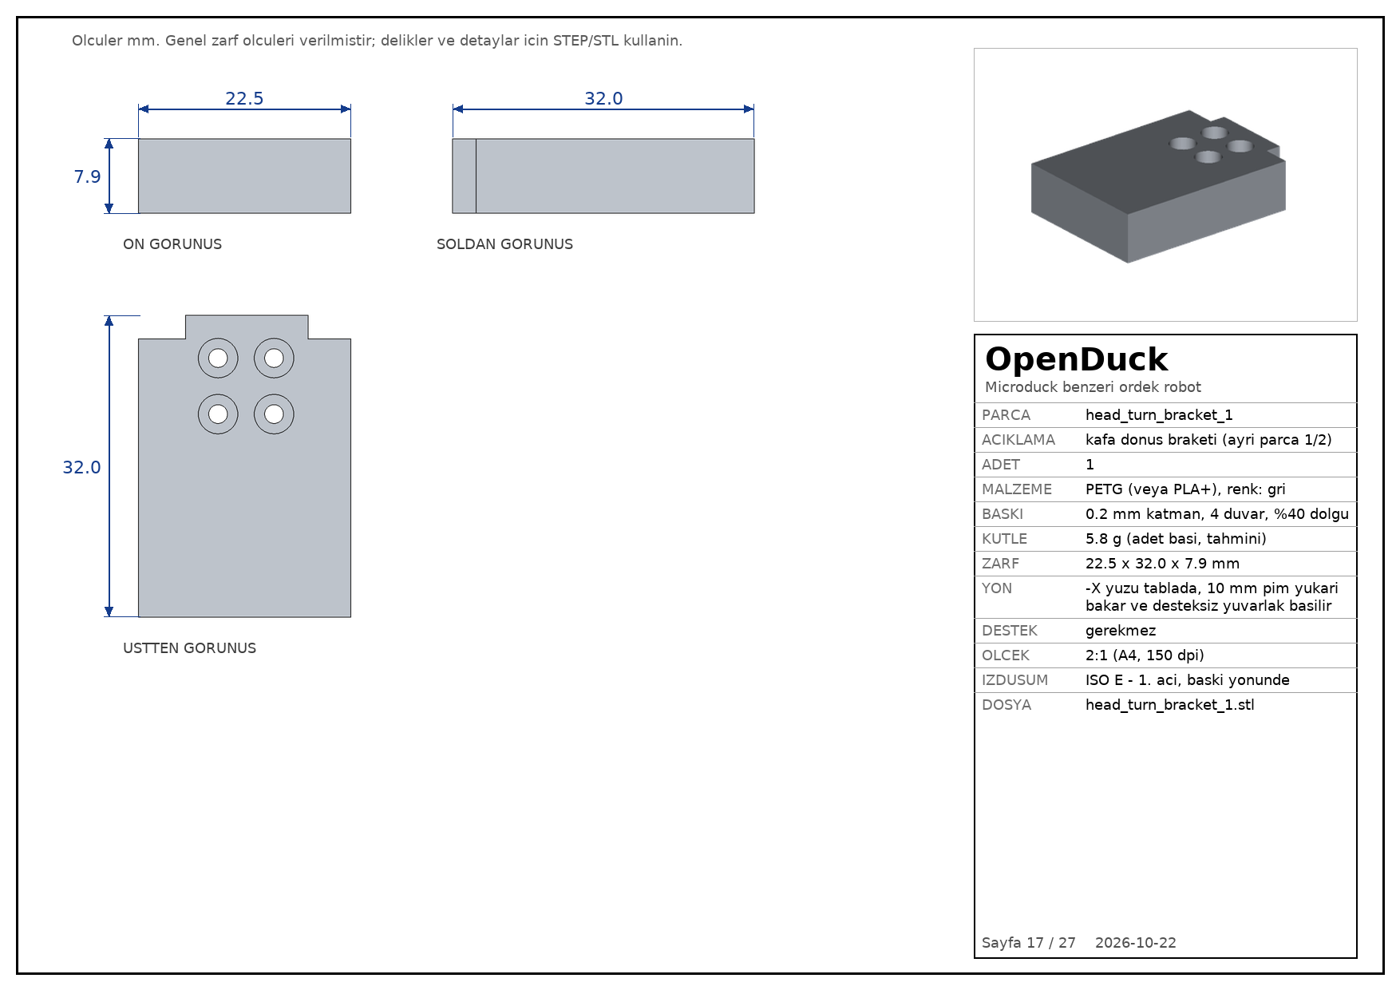
build/docs/sheet_17_head_turn_bracket_1.png
