Kubudak90/openduck-tr/build/docs/sheet_19_head_hood.png

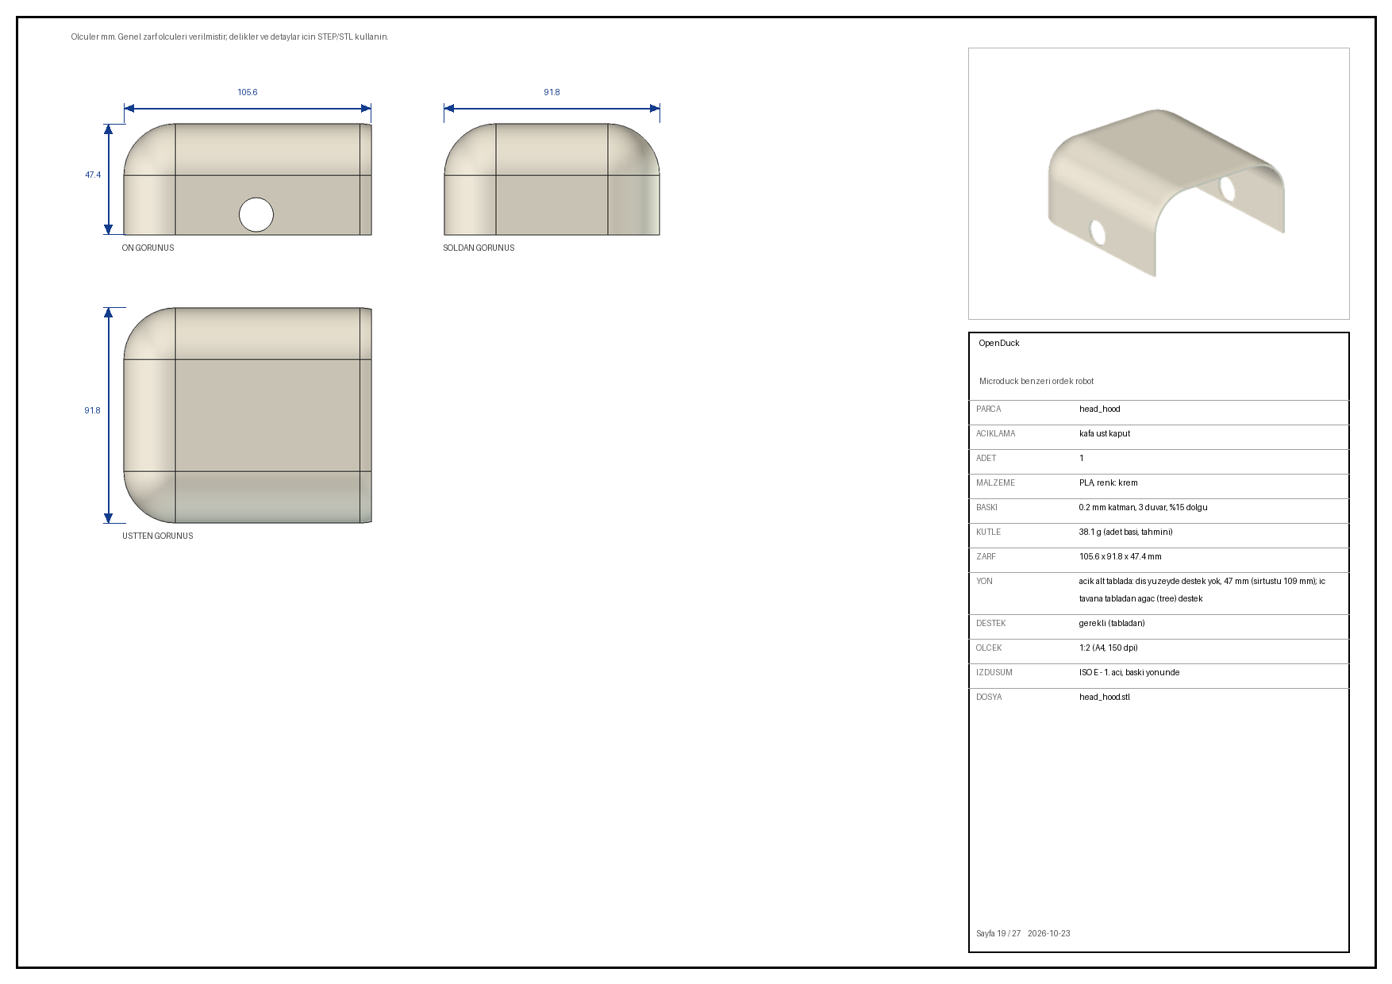
build/docs/sheet_19_head_hood.png
