Kubudak90/openduck-tr/build/docs/sheet_20_head_bottom_shell.png

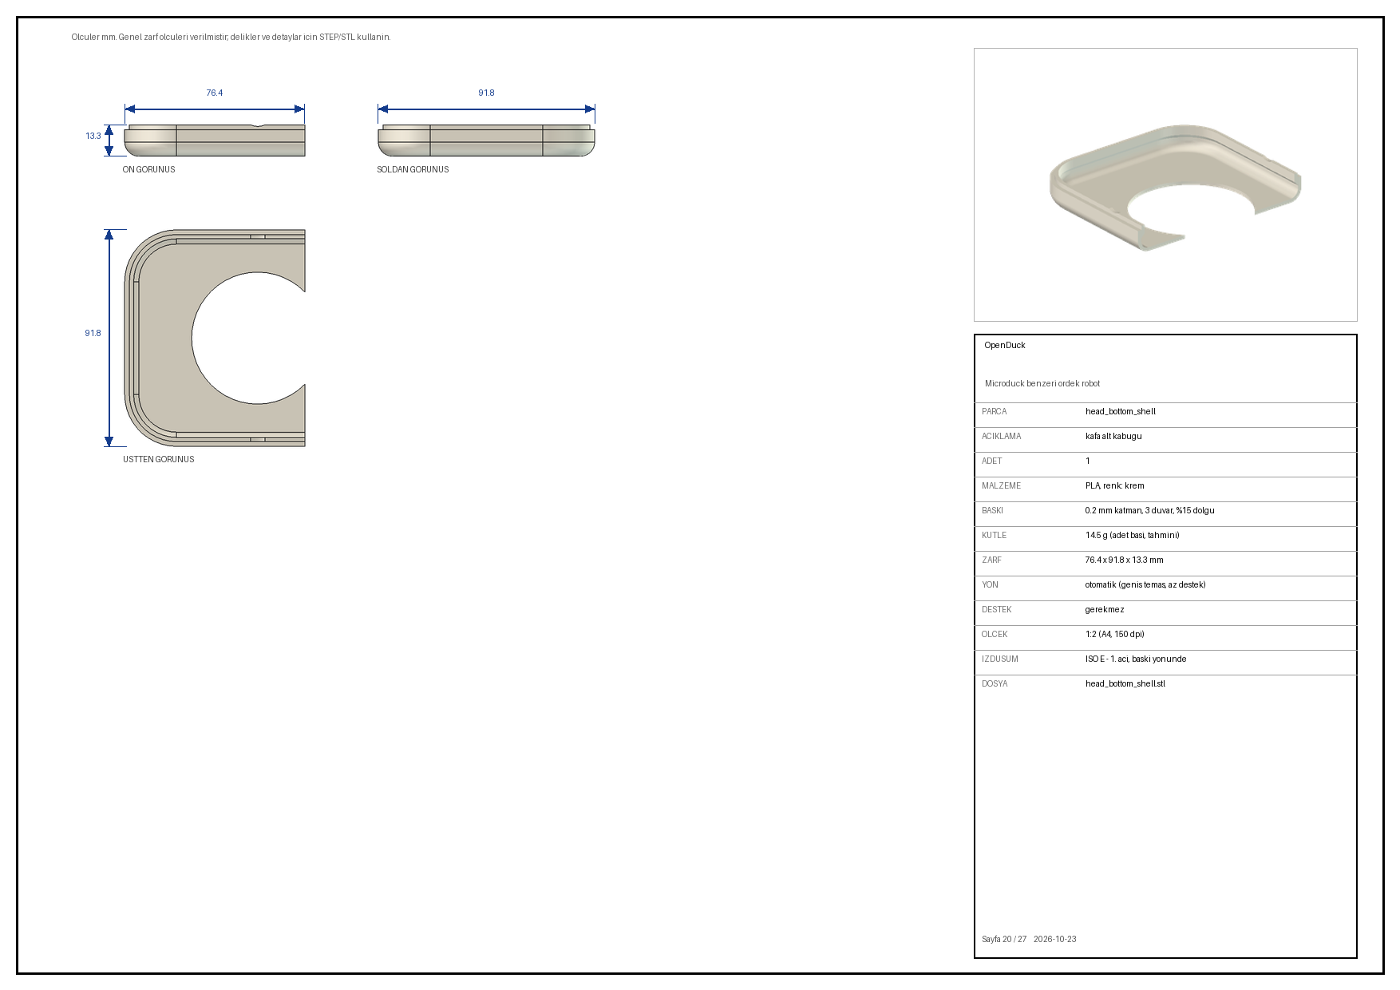
build/docs/sheet_20_head_bottom_shell.png
