Kubudak90/openduck-tr/build/docs/sheet_21_upper_bill.png

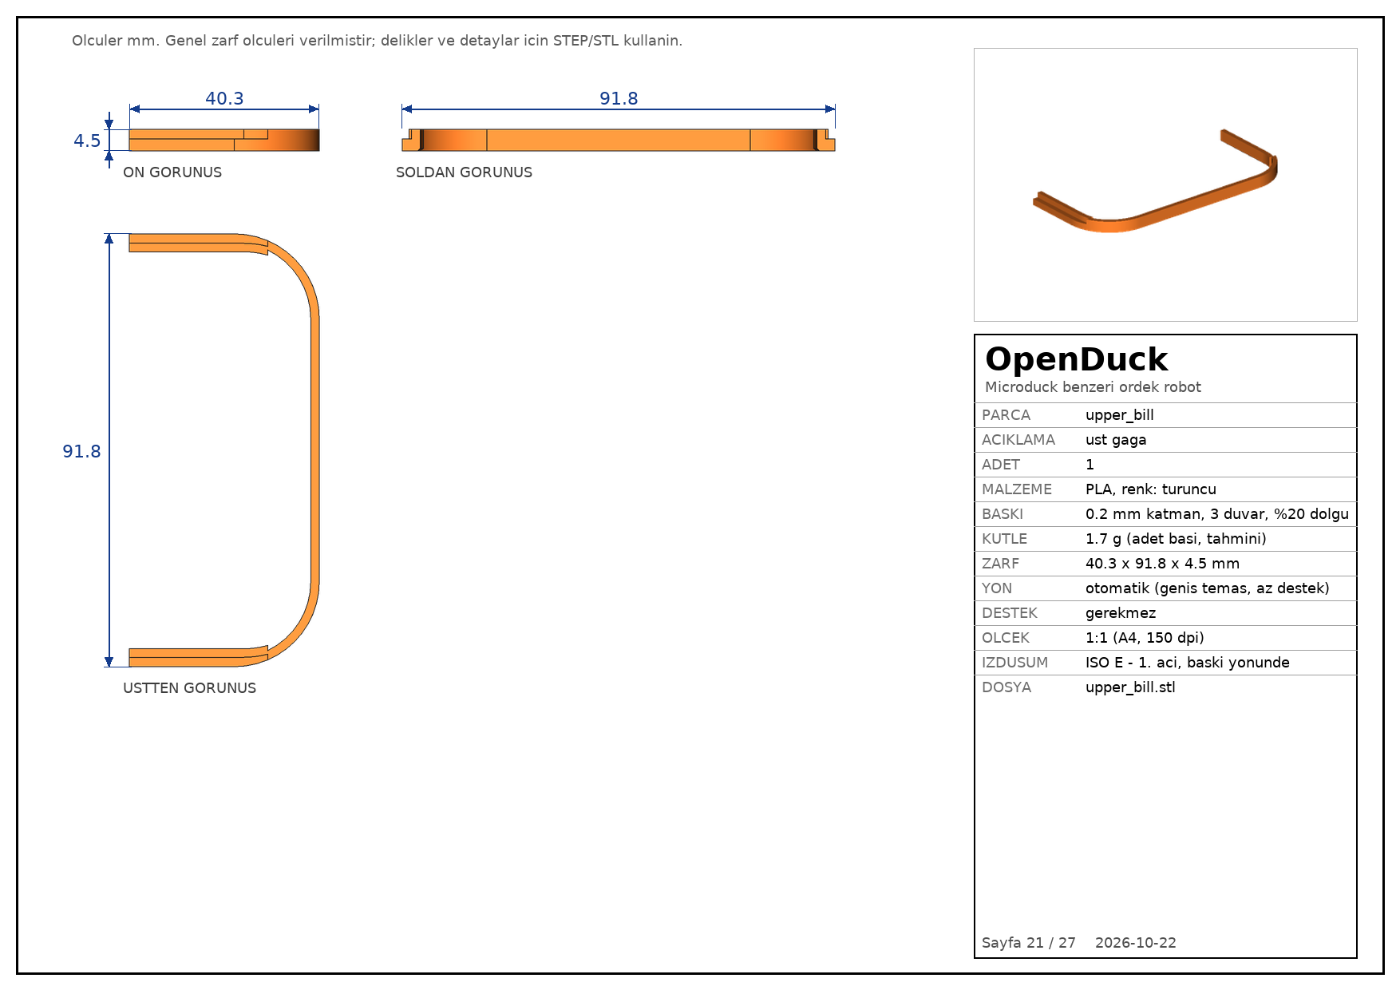
build/docs/sheet_21_upper_bill.png
