Kubudak90/openduck-tr/build/docs/sheet_23_face_plate.png

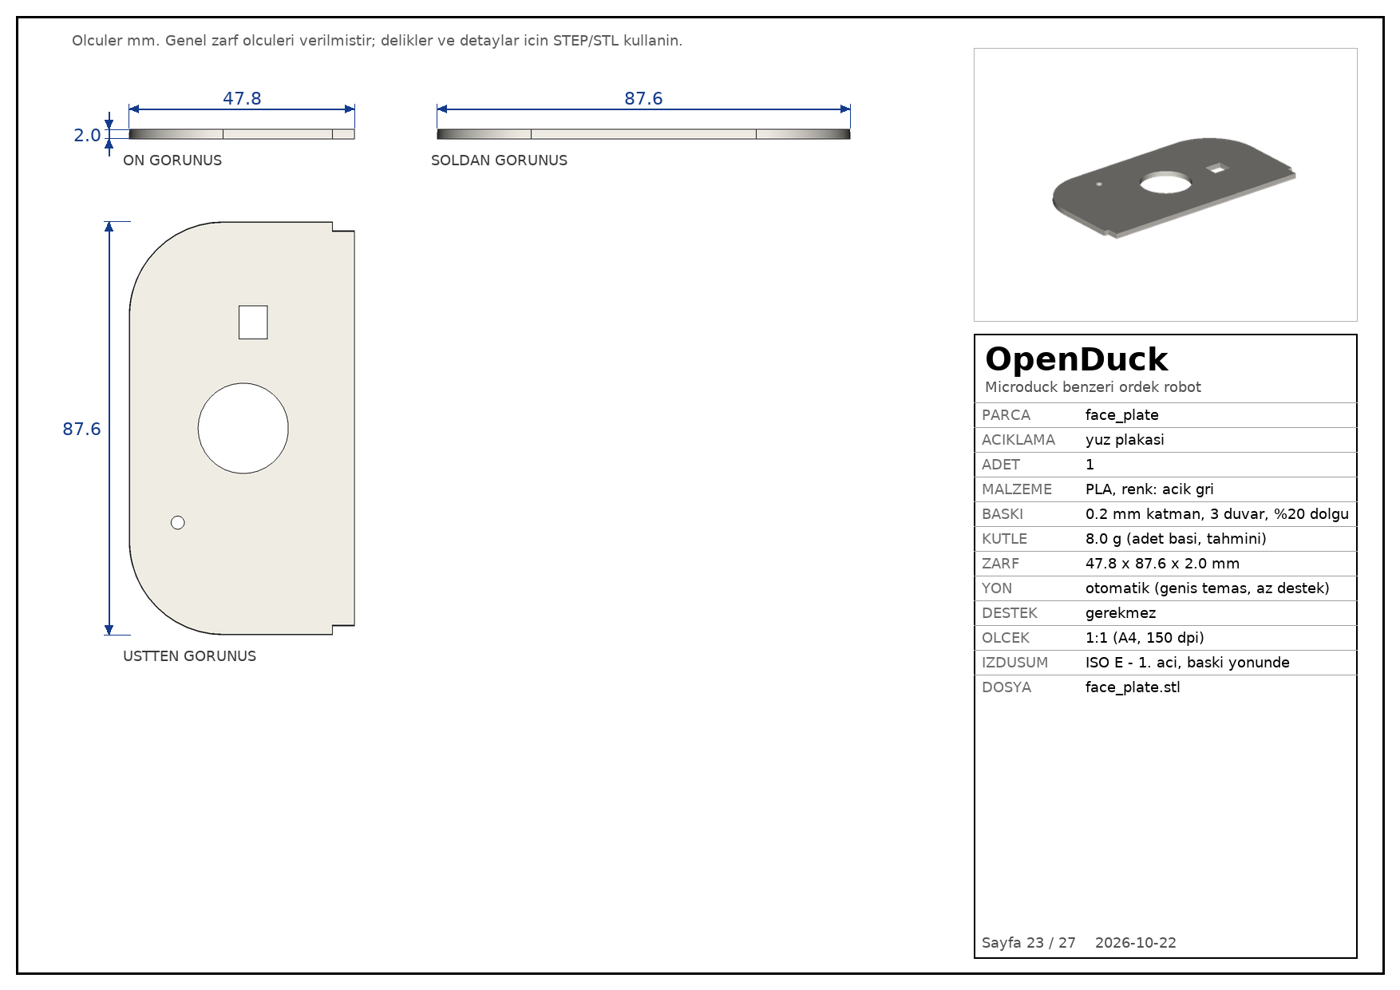
build/docs/sheet_23_face_plate.png
