Kubudak90/openduck-tr/build/docs/sheet_24_eye_ring.png

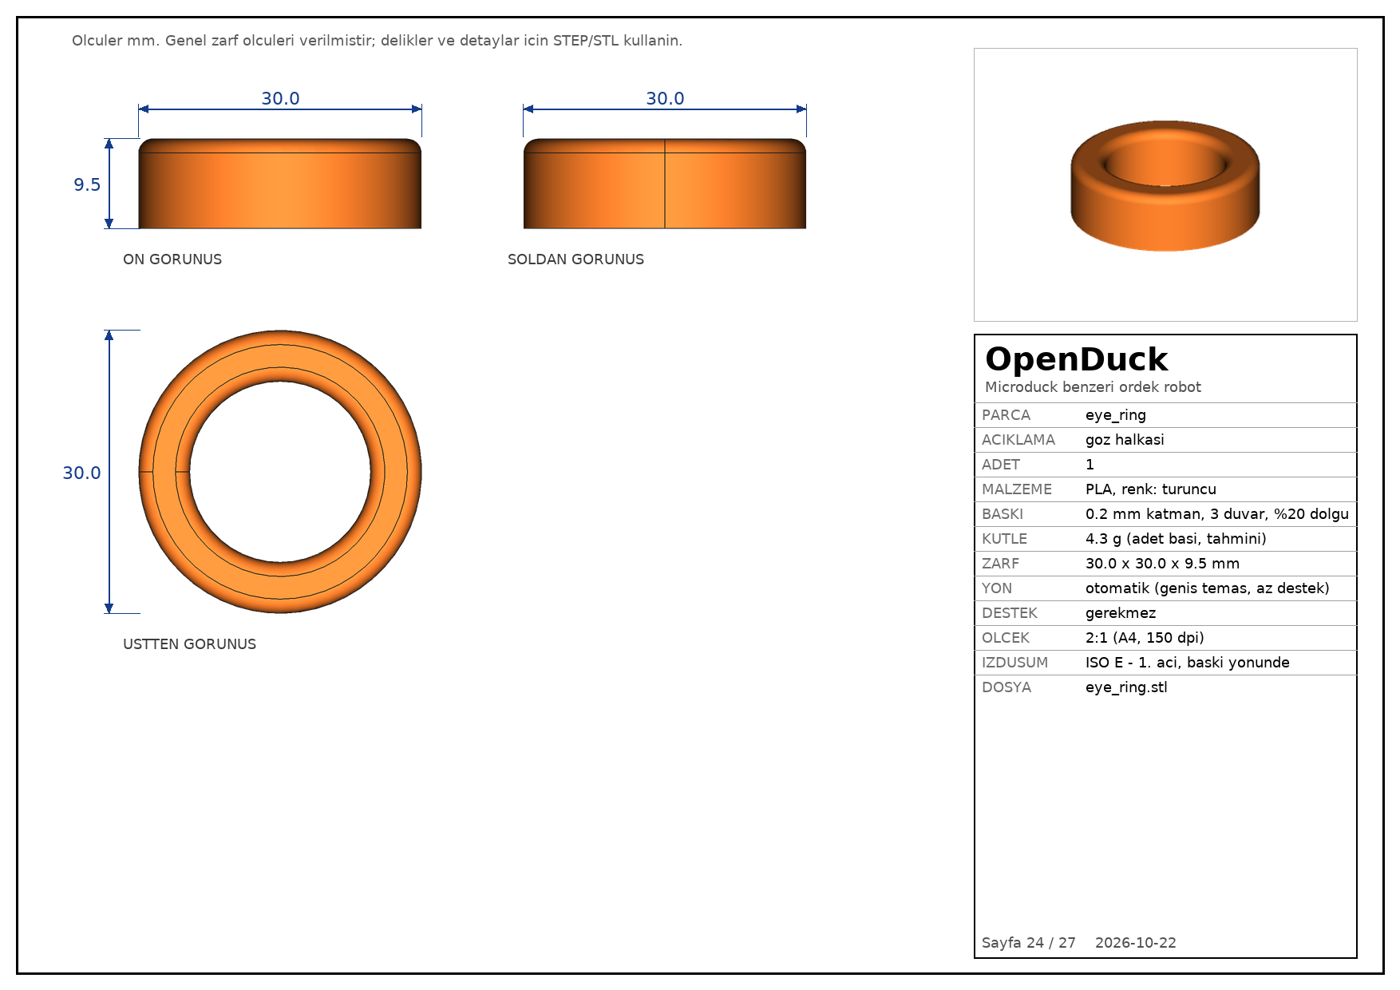
build/docs/sheet_24_eye_ring.png
