Kubudak90/openduck-tr/build/docs/sheet_25_head_frame.png

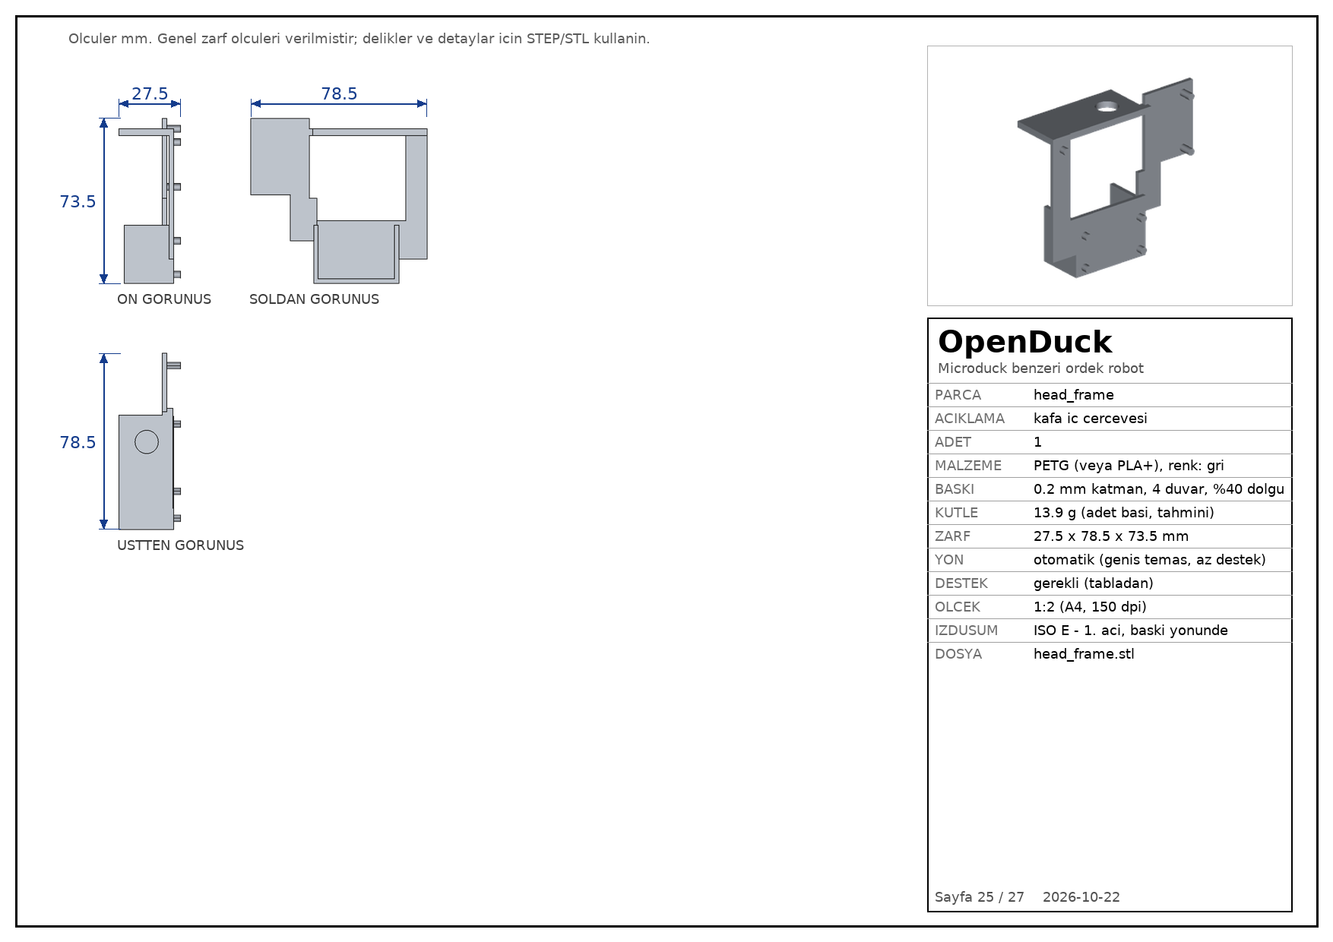
build/docs/sheet_25_head_frame.png
