Kubudak90/openduck-tr/build/docs/sheet_26_lower_bill.png

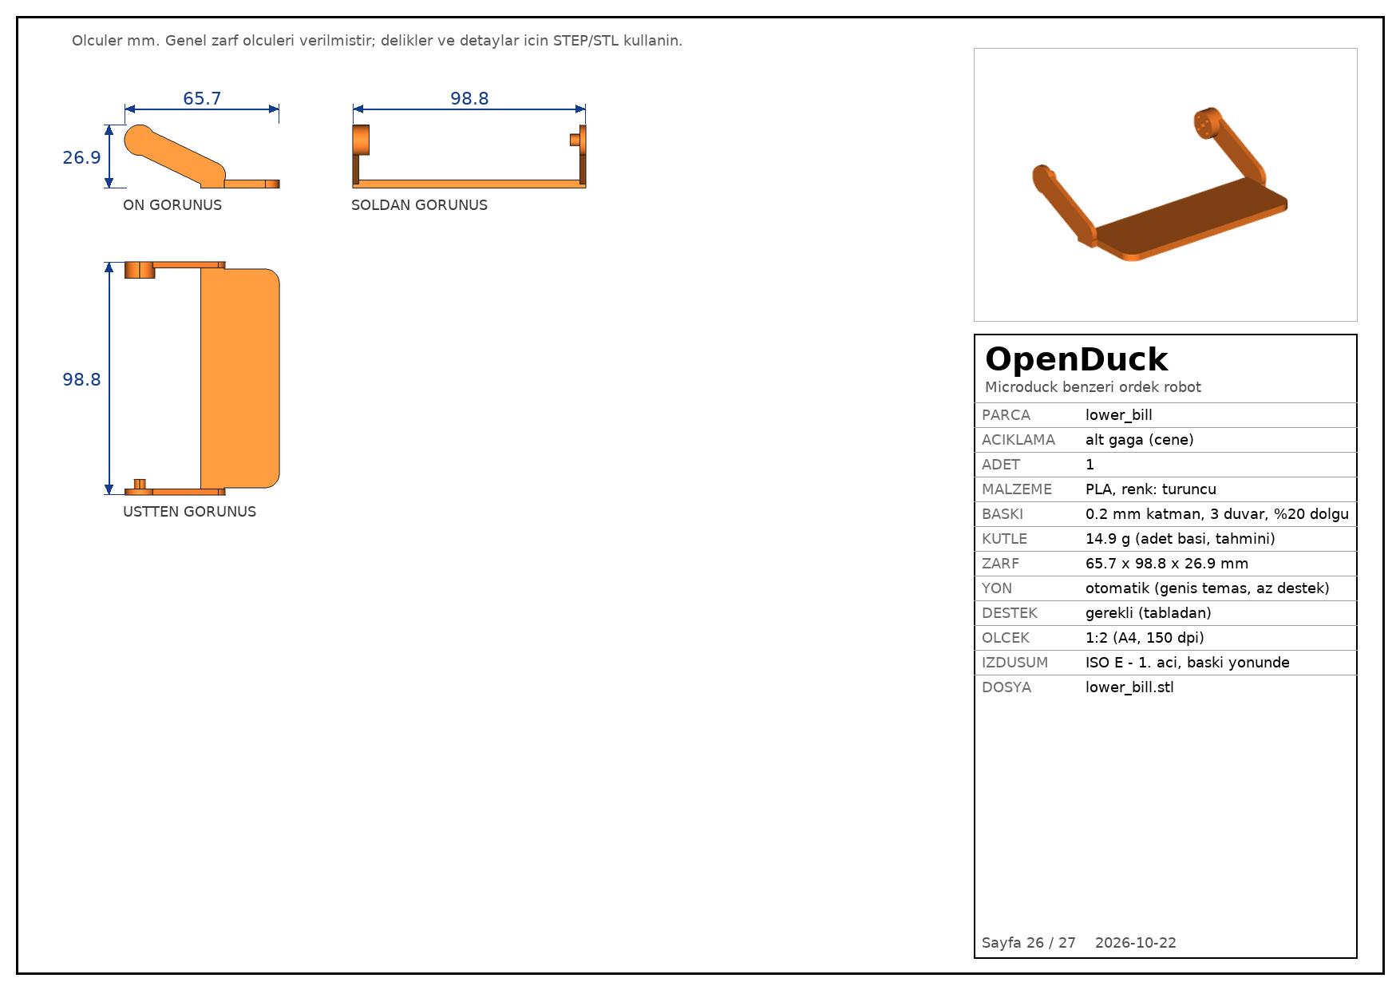
build/docs/sheet_26_lower_bill.png
