Kubudak90/openduck-tr/build/img/back.png

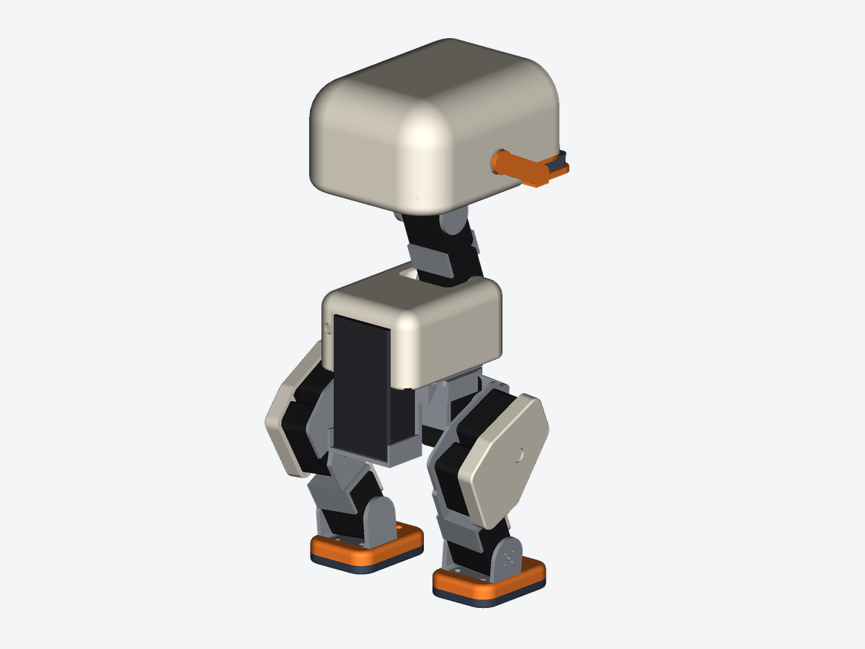
build/img/back.png
