Kubudak90/openduck-tr/build/img/front.png

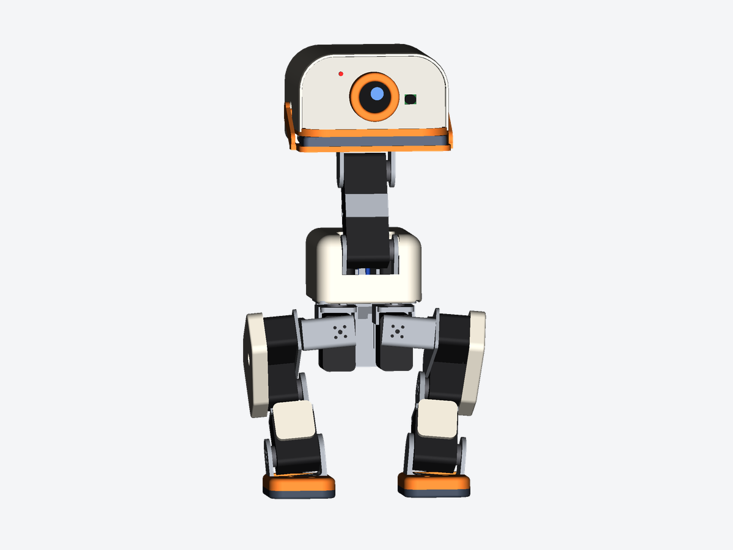
build/img/front.png
