Kubudak90/openduck-tr/build/img/side.png

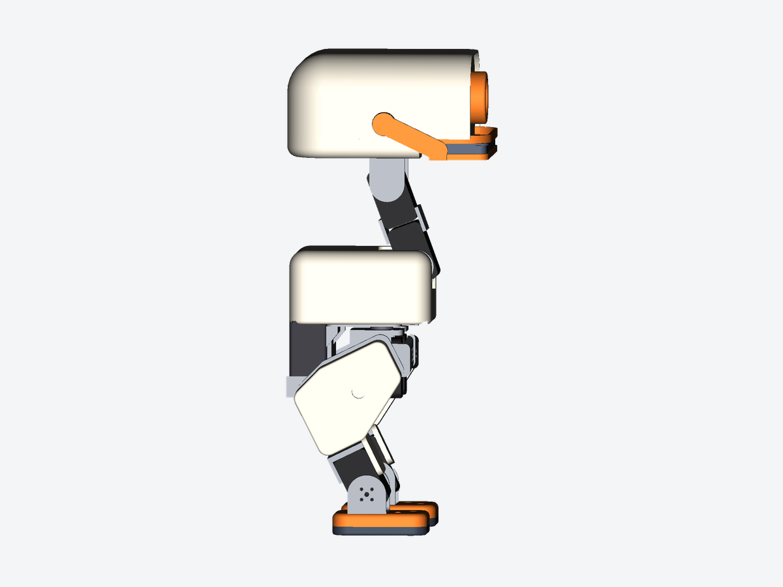
build/img/side.png
