Kubudak90/openduck-tr/(commit log)

2026-10-23 Start OpenDuck-TR from the Microduck-style OpenDuck (Kubudak90/openduck @ 1c8bc0c)
    CAD, simulation and RL pipeline copied as the starting point for a ~35 cm version built
    from parts in stock in Turkey (DS3230MG legs, ESP32-S3).
    Claude-Session: https://claude.ai/code/session_01TY9GgZ393urm7mHigq6ssd
    [battery_np_f550.stl, battery_tray.stl, camera_glass.stl, camera_holder.stl, camera_lens.stl, chassis.stl, eye_ring.stl, face_plate.stl]
2026-10-23 Parts research: Turkish in-stock servos/boards/materials, torque needs from the 27 cm sim, candidate builds
    Chosen build B2-ESP32 (DS3230MG legs with potentiometer feedback, ES3054/MG90S/SG90 light joints,
    ESP32-S3). Prices and stock checked 2026-10-23.
    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
2026-10-23 Spec v1 for OpenDuck-TR and design discovery reports
    Servo mechanics, CAD code map, power/electronics and RL change map, plus a completeness critique.
    Spec: 35 cm, DS32xx legs + neck, ES3054 hip yaw, MG90S head, SG90 beak, 4S LiPo, ESP32-S3; CAD + sim + RL scope.
    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
2026-10-23 Spec v2 after review round 1 (34 objections), review.md with decisions
    Budget ~25k TL with the cheapest DS32xx source (user), joint-limit and rail-current modelling,
    hip yaw turntable, packaging and mass bottom-up, IMU + attitude filter in the sensor model,
    head pots via ADS1115, Step-0 decision table, bench/sysID tools, xl330 regression stage,
    get-up feasibility gate and per-mode acceptance.
    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
2026-10-23 Spec v3 after review round 2, review decisions, and the v1 plan
    Round 2 criticals resolved by user decisions: budget ceiling 24.5k/27.5k TL, DS3235 as knee
    candidate with a two-way calibrated thermal limit and a G-ISIL gate. Majors folded in:
    limit metric on actuated joints only, +3 deg invariant, self-collision pairs, supply-current model,
    Wilson rules and N, get-up gate numbers, full required-range table, Step-0 decision rows.
    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
2026-10-23 P0: xl330_27 golden regression baseline for the CAD refactor
    Golden built on this Mac (FreeCAD 1.1.1, Darwin arm64) with the current
    pre-refactor code; the committed Linux build/ differs by float noise
    (~1e-18..1e-22 in near-zero inertia terms) and by STL tessellation.
    - tests/golden/xl330_27/: sim/openduck.xml, sim/openduck.urdf,
    summary.json, BOM.md, interference.txt and meshes.json (sha256,
    triangle count, volume, bbox of all 74 sim mesh STLs).
    - tools/golden.py: headless build (build_gui.py + cad/check.py via
    freecadcmd, OPENDUCK_DOCS=0), STL manifest, byte compare with a
    numeric-diff summary, freeze to regenerate.
    - tests/golden/test_golden_xl330.py (slow): builds with OPENDUCK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
    [openduck.urdf]
2026-10-23 P1: servo-type registry, build configs xl330_27 and tr35_b2
    - cad/servos.py: SERVO_TYPES with XL330 (exact current geometry: body
    20x34x26, near 9.5, 3.5 fillet, cable slot, horn r6.5x3 with 4 x r0.8
    bolts at r4.2/45 deg, 17.5 g + 0.5 g horn, BAM actuator values, MJCF
    root class "openduck") and complete DS32XX, ES3054, MG90S, SG90
    envelope records from research/servo-mechanics.md (body, boss, spline,
    tabs, holes, cable exit, horn, mass, travel/PWM, electrical, actuator
    class ds32xx/es3054/mg90s/sg90 with spec 3.2.3 defaults; estimated
    fields listed per record). Servo geometry (canon, horn_bolt_holes,
    horn_bolt_cutters) imports FreeCAD lazily; only XL330 has an envelope
    gene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
2026-10-23 P1: split CAD builders into trunk/legs/head, model reads config, per-class MJCF actuators
    - cad/geom.py: geometry helpers moved verbatim from openduck.py
    (re-exported by openduck for macro/back-compat users).
    - cad/trunk.py, cad/legs.py, cad/head.py: _trunk, _leg_items/_legs and
    _neck_head moved verbatim as build_xl330(m, sv) with the servo envelope
    passed in (sv: joint key -> servos record); each module exposes
    GENERATORS = {"xl330_27": build_xl330}. The xl330 generators guard
    their preconditions (all XL330, scale 1) via servos.require.
    - cad/openduck.py: OpenDuck(params=None, config=None) loads the config
    (OPENDUCK_CONFIG, default xl330_27), scales LAYOUT_KEYS by "scale"
    (ide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
2026-10-23 P1: wrap long lines in build_config, legs, export (no behaviour change)
    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
2026-10-23 P4: tr35_b2 robot profile with servo actuator and sensor models (CPU + MJX)
    - config: ROBOT_PROFILE ("xl330_27" default, "tr35_b2"), selected by OPENDUCK_ROBOT;
    JOINT_RANGE_MARGIN_DEG. xl330 behaviour is unchanged.
    - rl/actuators.py (new): servo classes (DS32xx DSSERVO Blue 2.88 N.m / 5.72 rad/s /
    P-band 3 deg, ES3054, MG90S, SG90), joint->class map, spec 4 DR (tau_s, omega0,
    P-band log-uniform, dead band, armature, frictionloss, backlash, per-board delays),
    MjSpec application (kp = tau_s/P-band, forcerange, b = tau_s/omega0), optional series
    backlash joints on DS joints, the +3 deg range invariant, and xp-generic substep
    math: delayed target, PWM quantisation, dead band, MuJoCo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
2026-10-23 P4: tests for actuators, sensors and tr35 CPU/MJX lockstep parity
    - rl/tests/test_actuators.py: profile selection (env var, invalid value), xl330 model
    unchanged, class parameters, +3 deg invariant for every variant with and without
    backlash, backlash layout and expand_state, HOME open-loop stand 5 s, DR sampling
    ranges and delays, dead band / delay / PWM quantisation, position force == MuJoCo,
    supply current and CC scaling, CPU env substep loop == hand-written reference
    (bit-exact, DR on), limit metric (CPU and MJX, backlash joints excluded),
    workers == in-process, numpy == jax.
    - rl/tests/test_sensors.py: pot table, quantisation/RC/IIR, ADC1 latency and ADS1115
    mux lag on a r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
2026-10-23 P6: tools/sysid - Step 0 fitting pipeline with synthetic-servo tests
    - logio: firmware line protocol (S/E/H/D/B/P/R/END), RunRecorder shared by logger and synth, Run loader
    - model: single-joint servo (position actuator kp=tau_s/p_band, forcerange, damping tau_s/omega0, armature,
    frictionloss, play deadband, latency with exact command switching), interval-averaged supply current
    I = i_stall*|tau_act|*|tau_net|/tau_s^2 + i_idle, u-fit (parts-research, kappa), heat-cycle helpers
    - synth: Python mirror of every bench program (same commands, events, columns, prompts) with realistic pot/ADC,
    INA226, ADS1115, NTC and rail models
    - fit: pot/command maps (ratiometric when pot ends are wired),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
2026-10-23 P6: tools/bench - ESP32-S3 bench firmware and PC logger
    - bench_main.cpp/drivers.h (+ bench.ino entry for Arduino IDE): ESP32-S3-DevKitC-1 N16R8, PCA9685 at 50 / ~300 Hz
    (prescale from calibrated oscillator, osc auto via ch15->GPIO16 capture or measured Hz), ADC1 GPIO1-10 at 12 dB
    with oversampling, INA226 (configurable shunt, auto address), ADS1115 (case NTC, ADS wiper path, pot-low
    differential), ambient NTC, DUT pulse capture
    - programs: sweep, potcal, potprobe, deadband, step, chirp, speed, ramp, stall (lever + scale prompts, meter
    hold), curpts, track (300 Hz / 3.3 V acceptance), overshoot (20 kS/s rail burst), heat (0.9/1.05/1.15 N.m RMS,
    10 min, cooldown), noise (Wi-Fi off/o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
    [bench.ino, bench_main.cpp, drivers.h, logger.py]
2026-10-23 P6: docs/adim0-tezgah-testi.md - Turkish Step 0 bench guide
    Shopping list with research links and prices, wiring (pin map, 100k/47k + 100 nF dividers, 1 nF rail sense,
    INA226 shunt and address, star ground), opening a DS32xx and finding the pot wiper without soldering (no
    teardown known), safety (LiPo, buck setup, limits, E-stop), step-by-step procedure per servo, spec 7 decision
    table mapping, how to send the logs back, troubleshooting.
    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
2026-10-23 P6: fit only successful runs; logger aborts on a silent board
    - fit_servo skips runs whose END status is not ok (listed in servo.skipped); CLI skips servo folders without
    successful runs instead of failing
    - logger: if the bench sends nothing for 30 s outside a prompt, send E-stop and close the run (abort:sessiz)
    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
    [fit.py, logger.py, test_sysid_fit.py]
2026-10-23 P6: sysID dead band = error dead zone (matches rl/actuators.dead_band)
    model.simulate now applies the dead band the way the simulator does: after the
    latency, e = c - q, ctrl' = q + sign(e)*max(|e| - deadband/2, 0), evaluated every
    integration substep against the current q (zero P force inside the band). The
    play/backlash state on the command is gone, so the ceff0/ce_end/ce_dir plumbing
    is replaced by c_prev (command in effect before the first sample) and c_end.
    - fit: dynamic and friction-model windows start from the resting position
    averaged over the pre-command samples (_q_rest). With the dead zone, a resting
    servo can sit anywhere in the band, so one noisy sample shifted motion onse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
    [fit.py, model.py, synth.py, test_sysid_fit.py]
2026-10-23 P2-0: PWM servo envelopes, rear idler, turntable stack and geometry helpers
    servos.py: canonical envelopes for DS32XX, ES3054, MG90S and SG90 (origin on the
    shaft axis in the outer face of the horn actually used; XL330 keeps its legacy
    mid-stack origin). Body with corner radii, tabs with open-slot holes, boss and
    spline, cable gland, gear tower for the micro servos; horns: DS aluminium 25T
    arm (embedded, 2 bolt holes), ES3054 plastic single arm (coupler), MG90S/SG90
    plastic double arm. datums() gives every plane/point FreeCAD-free; idler_stack()
    and idler_parts() model the F623ZZ rear idler (cradle seat, bearing, U-link pin);
    horn_pocket(), arm_angle_deg(), turntable_stack(), bearing catalog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
2026-10-23 P2-0: model core module tracking, extended collision scans, envelope fit study
    openduck.py: link -> module map and Item.module (meta["modules"]), servo_parts()
    (body, horn turned toward a direction, DS idler seat/bearing/pin), per-kind
    effective density from params.print, EXTRA_KINDS ("harness") exported only when
    used, generator-set collision_links/action_pose kept. export.py writes the
    material list through material_kinds(). build_config: optional "check" section.
    check.py: config-driven TR-35 scans (single joint over limits as before, adjacent
    parent-child pairs on a pair_steps grid with pair_scope "module"|"all", leg-leg
    with hip_roll/hip_yaw inward extremes and hip_pitch/knee extremes,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
    [build_config.py, check.py, openduck.py]
2026-10-23 P2-0: frozen TR-35 layout and placeholder trunk/legs/head generators
    configs/tr35_b2.json: frozen joint origins, servo_face/servo_dir for all 10 keys,
    HOME, limits (= required except hip_pitch -70..90, head_yaw +-80), turntable
    (6800ZZ, spacing 22, mating plane z -3), idler, harness crossings, module
    envelopes (trunk keep-in, head-module keep-ins) and the module sections
    params.legs / params.trunk / params.head. Sagittal points are the 27 cm ones x
    1.282; yaw axes y +-12, roll axes y +-26, DS stacks along their own axes.
    Head top at the stand keyframe 350.45 mm.
    Stub generators trunk/legs/head.GENERATORS["tr35_b2"]: servo/horn/idler
    envelopes at their frames, turntable shaft/bearings/housin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
    [electronics.py, head.py, legs.py, test_model_fc.py, test_tr35_stub_fc.py, trunk.py]
2026-10-23 P2-0: interface contract for P2a/P2b/P2c and plan row
    docs/workflow/openduck-tr/p2-interface.md: frozen items and owners, servo envelope
    convention, joint datum table, HOME numbers, hip (turntable) and neck module
    boundaries, trunk and head-module keep-ins with the swept-volume rule, pair-grid
    scope decision, fit study results, harness convention and crossing table, shared
    dict keys, mass/COM budget, trunk volume budget, config sections, check usage and
    the open decisions (pair scope, leg-leg feet, knee/ankle fold, HOME COM).
    plan.md: P2-0 row before P2a and the note that P2a-c start from P2-0.
    Claude-Session: https://cla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
2026-10-23 P2-0: modelled contact pairs (spec v3.1) in pair and leg-leg scans
    The three open P2-0 decisions are resolved. The pair grid stays
    module-scoped. The leg-leg feet pose and the knee +65 / ankle -45 fold
    are now modelled MJCF self-collision pairs. They are configured in
    check.contact_pairs: links without the side prefix, a same or cross
    side rule, and the sections they apply to. Matches are listed but not
    counted. Harness items always count, and single-joint scans have no
    exceptions. The tr35 stub now reports 0 counted collisions in every
    section, with 14 pose-pairs listed as modelled contacts.
    The spec moves to v3.1: the 3.2.2 pair list gains head<->trunk and
    same-leg foot<->thigh/hip_cradle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
    [check.py, test_check_contacts.py]
2026-10-23 Add open-items list handed over to P3, G-CAD, P5 and G-BENCH
    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
2026-10-23 P5a-derive: tools/derive_posture.py and rl/derived/tr35_b2.json (schema 1)
    One command regenerates every geometry-dependent tr35 constant from an MJCF:
    python tools/derive_posture.py derive --scene S --out rl/derived/tr35_b2.json [--stub] [--home auto|keyframe|family]
    python tools/derive_posture.py check --scene S [--derived P] (0 fresh, 3 MJCF/mesh sha differs, 1 invalid)
    python tools/derive_posture.py caps-scan --scene S [--derived P] [--json out] (A8 voxel sweeps, for P5b)
    - family3 port (flat foot, max COM margin, min |pitch| within 2 mm; tr35 tie-break: closest height), HOME rule
    (COM budget -17..+3 mm, family HOME at the keyframe height), H_HOME by a 2 s MuJoCo settle, hei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
2026-10-23 P5a-core: tr35_b2 task profile (derived-file config, tr35 rewards, models, banks, getup_head)
    - rl/config.py: SCENE_PATHS/SCENE_PATH (OPENDUCK_SCENE), DERIVED_PATHS/DERIVED_PATH (OPENDUCK_DERIVED),
    load_derived (schema 1 validation), tr35_constants (Froude S = 1.282, KAPPA / OPENDUCK_KAPPA), new names with
    xl330 values, OPENDUCK_BANK_N; tr35 process loads the derived JSON at import (RuntimeError if missing/invalid).
    - rl/tasks.py: tr35 TaskSpecs (actor 256-128-64, critic 512-256-128, MJX solver 8/8/16, getup 12 s), getup head
    action scale cap, getup_head_mode().
    - rl/task_math.py: MOVING_EPS, seat-pitch pitch_ref, stand_gz/seat_gz split, tr35 torque_ratio / limit_torque /
    rail_demand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
2026-10-23 P2b: TR-35 trunk and electronics at real envelopes, volume budget
    - cad/trunk.py: build_tr35_b2 replaces the P2-0 stub. PETG trunk_base
    (1.5 mm floor, fused 6800ZZ turntable housings, ES3054 cage plate with
    M3 nut traps on a bracket behind the rotor zone, neck DS cradle frame
    on the horn side of the tabs with nut traps, battery tunnel whose roof
    is the buck tray, stops, shelves, posts), buck_hood (top grille, rear
    battery/XT30 ports and buck window, side intakes), belly_duct (open
    XL4015 duct), PLA shells at constant wall (left/right, top, deck), TPU
    battery strap, modelled M3 servo fasteners, trunk wire channels for
    both hips, the neck and the battery lead. Neck idler seat V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
    [electronics.py, test_trunk_data.py, test_trunk_fc.py, trunk.py]
2026-10-23 P5a deploy: tr35 eval (spec 6 A4-A8), C export, tr35 meta, trainer and launcher plumbing
    - rl/export_c.py (new): ONNX (torch ELU / brax swish) -> C99 float32 with the
    observation normalisation folded into layer 1; policy_weights.h, policy.h,
    policy.c, obs_layout.h, export_c.json (sha256, sizes, MACs, ESP32-S3
    estimate); --check N compiles a harness with cc -O2 -std=c99
    -ffp-contract=off and compares against onnxruntime (exit 1 if > 1e-5).
    - rl/policy_meta.py: tr35_b2 meta adds robot, actuators (actuator_table
    columns, classes, rails, i_cc, boards), sensors (POT, IMU, pot table),
    delays, derived_source, kappa, network, getup_head and
    posture_ref.seat_pitch_deg; scene_path / robo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
2026-10-23 P2c: TR-35 neck + head generator (U-link, MG90S passive supports, bumper, shells, jaw)
    Replaces build_tr35_stub with build_tr35 (GENERATORS["tr35_b2"]):
    - neck: U-link (DS 25T arm embedded, idler pin), bridge under the head_pitch
    MG90S, cradle (tabs on the horn side, 2 x M2 from the rear), thrust faces on
    both sides of the head_tilt rotor disc, chin/forehead bumper (TPU pad with
    collision_box) on a stem in front of the bridge.
    - head_tilt: rotor disc + yaw table; head_turn: yaw tab frame, thrust ring on
    the yaw table, roll horn plate, roll pin into the head-frame front bushing.
    - head: frame (ring deck, roll/SG90 tab plates, roll thrust ring, chin block),
    constant-wall PLA hood and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
    [head.py, test_head_params.py, test_head_tr35_fc.py]
2026-10-23 P2c: bumper load path and MG90S shaft load note (p2c-tampon.md)
    Contact sequence (chin block of the head frame lands on the TPU pad at
    head_pitch 76, head_tilt 1.33 mm away), load path into the neck U-link and the
    DS32xx, per-joint MG90S/SG90 shaft load check with the passive supports, derived
    joint limits, mass against the 202 g budget (200.2 g), check.py results, harness
    routing, interface change requests (neck stem envelope, jaw envelope, jaw-neck
    contact pair) and print notes.
    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
2026-10-23 P5a integration: core loads the derived file, eval/meta/C export read the new constants
    - rl/config.py: load_derived uses derive_posture.validate's height order (H_DEEP >= ...,
    SEAT_Z < Z_SIT; Z_SIT < H_DEEP is a derive warning - the stub sit is 0.5 mm above the
    deep crouch), so the committed rl/derived/tr35_b2.json loads; RuntimeError names the
    exact regenerate command.
    - rl/actuators.py: apply_to_spec compiles a spec copy for the play-joint addresses
    (physics_model(textures=False) + backlash failed with "texture 'grid' not found").
    - rl/task_math.py: tr35_penalties() (same formulas as the reward terms, profile-free).
    - rl/eval_tasks.py: TorqueAcc reports the tr35 training penalties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
2026-10-23 P2a: DS cradle, U-link, idler and thrust helpers in servos.py
    Stator (ds_stator: ear shelves with M3 tap / nut-trap holes, F623ZZ seat,
    body and gland cutters for Y or side insertion), rotor cutters
    (ds_rotor_cuts: embedded Al arm pocket, M2.5 taps, centre screw access,
    leg B nut trap), the idler M3 pin with nut and brass spacer that presses
    only the inner race (ds_idler_screw), and the leg A thrust sleeve that
    puts axial load on the servo case, not the shaft (ds_thrust_sleeve).
    Fasteners are absolute M3 sizes.
    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
2026-10-23 P2a: TR-35 leg generator (turntable shaft, DS cradles and U-links, foot, harness routing)
    Replaces the P2-0 legs stub (GENERATORS["tr35_b2"] = build_tr35):
    - hip: Al d10 turntable shaft through both 6800ZZ inner races (M3 cross
    screw in the boss, countersunk M3 + key at the top), pin/slot coupler
    around the ES3054 single arm (torque only: side, radial and axial
    float), yaw boss r 8.5 with the lower inner-race shoulder, roll DS
    cradle with F623ZZ seat, swept yaw-harness slot.
    - hip_cradle: roll and pitch U-links (embedded Al 25T arms, legs B on the
    idler pins, I-section roll bridge, thrust sleeves, windows).
    - thigh: hip_pitch and knee cradles (ear frames tied to the bars, idler
    s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
    [legs.py]
2026-10-23 P2a: leg joint limits from the CAD single-joint scan
    Limits = collision-free single-joint range (1 deg steps, harnesses
    included, P2-0 trunk/head stubs and module envelopes) intersected with
    servo travel, minus the 3 deg RL range margin, with the leg harnesses
    kept out of the trunk keep-in and the ES3054 arm inside the frozen hip
    rotor zone; never narrower than the required ranges:
    hip_yaw -10..21, hip_roll -20..20, hip_pitch -70..90 (spec), knee
    -84..77, ankle -65..64. Derivation in params.legs._limits and
    p2a-el-hesabi.md.
    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
2026-10-23 P2a: leg hand calculation, print report and notes (p2a-el-hesabi.md)
    legs.load_report(m): stance (W + 0.2 W, pressure centre anywhere on the
    sole) and drop (2 W + 0.3 x 2 W) on one foot at HOME; per DS joint the
    axial force, axis torque, bending moment and the U-link support
    reactions at the spline (A) and the F623ZZ idler (B, 48.45 mm away),
    the remaining spline-overhang moment vs. the no-idler moment; turntable
    6800ZZ reactions, shaft, boss, cross screw; tab and arm screws, idler
    pin, PETG bearing and U-link leg B / knee post stresses. Lowest safety
    factor 1.4 (PETG hip boss, drop). legs.print_report(m) + PRINT_NOTES:
    size, single solid, print orientation and overhang per part.
    The note a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
2026-10-23 P2a: leg tests (config/limits and FreeCAD build checks)
    test_legs_params (no FreeCAD): leg limits contain the required ranges
    and stay inside servo travel with the 3 deg RL margin, horn directions
    perpendicular to the horn axes, absolute M3 fasteners, turntable shaft /
    coupler dimensions, harness route joins, idler support span.
    test_legs_tr35_fc (freecadcmd): parts in their links (sign rule),
    harness tubes per crossing, same-link 0, valid and mirrored parts, print
    parts single solid within the bed, leg mass budget, idler coaxiality,
    turntable shaft and coupler zone, hand-calc safety factors and idler
    moment reduction, no collisions at the left-leg limit ends.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
    [test_legs_params.py, test_legs_tr35_fc.py]
2026-10-23 P2 integration: accepted change requests and cross-module fixes
    Config (orchestrator decisions, p2-entegrasyon.md):
    - K_T: ICR-1 neck idler seat tie box and ICR-2 battery door box appended
    - neck envelope: bumper stem box; jaw envelope replaced as filed by P2c
    - harness hip_pitch in-point z -10 -> -13.5 (P2a change request)
    Trunk (cad/trunk.py):
    - neck_pitch_idler_seat gets a PETG tie (arm, web, foot) clamped by the
    front-left ES3054 tab screw (M3 x 8); replaces the VHB pad
    - battery_door: 2 mm PETG cover with 4 locating tabs in the battery port
    - shells: core side wall and right chin strip were loose solids; the
    shoulder now runs under the wall and the left chin face spans the strip
    -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
    [head.py, test_tr35_integration_fc.py, test_trunk_fc.py, trunk.py]
2026-10-23 P2 integration: p2-entegrasyon.md and spec v3.2 (jaw to neck/trunk pair)
    p2-entegrasyon.md (Turkish): merges, change-request decisions, integration
    fixes, full check.py numbers with the modelled and module-external contact
    lists, height, itemised mass and HOME COM, MJCF facts, tests, and open
    items for P3, G-CAD and P5b (two marked ORCHESTRATOR DECISION NEEDED).
    spec.md: header v3.2 with a one-line note; the section 3.2.2 pair list
    adds "cene - boyun/trunk".
    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
2026-10-24 P2 dogrulama: servo mili eksenel yuk yollari + uyluk kablo guzergahi
    - legs._coupler: yarik halka ustunun 0.02 altina kadar kesilir; ES3054 kolunun
    altinda catal tabani kalmaz (en az 0.5 mm eksenel bosluk, yalniz tork).
    - legs._shin: thigh_keep kesicisi diz baski kovanini kesmez; dort DS ekleminde
    kovan ile servo ust yuzu arasi 0.200 mm.
    - head._neck: bacaklarla ayni idler mili (servos.ds_idler_screw: M3 F623ZZ
    icinden, somun + pirinc ara halka) ve A kolu baski kovani (r 8.2..11.5,
    trunk_base besik duvarlarina 0.2 mm); params.head.neck.thrust_r / thrust_y1.
    ICR-3: boyun idler mili yolu boyun zarfina eklenir, K_T'den cikarilir.
    - params.legs.harness_route: uyluk kablosu orta yaricap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
2026-10-24 p2-entegrasyon: Dogrulama duzeltmeleri (bolum 9)
    Dort engelleyici bulgunun duzeltmesi, yeniden kosulan tam check.py, tests/cad ve
    altin sonuclari; kalan modul disi kablo temaslari (roll +-20 x pitch +-50 yalniz
    kablo, roll +-10/+-20 x pitch +-90 yapi temasli) ORCHESTRATOR DECISION NEEDED.
    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
2026-10-24 Spec addendum K: voice-command layer (DF2301Q), two review rounds, plan rows
    The user chose (2026-10-24): an on-robot DF2301Q voice module, "gel"
    walking straight ahead, 12 commands, simulation only this round, and a
    budget ceiling raised to 25.8k / 28.8k TL.
    Addendum K v3 defines:
    - the head placement, acoustics, ESP32 LED, harness ICR and BOM lines;
    - the ID table;
    - the commands.py supervisor with its full state x event table and
    golden traces;
    - the training changes (gesture function, command atoms);
    - acceptance A10 and the G-SES-a bench gate.
    Review: round 1 had 43 objections (2 critical), round 2 had 27 (none
    critical); every decision is recorded in review-komut.md. The main spec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
2026-10-24 P6e: G-SES-a bench additions (DF2301Q UART, noise program, sync tick, awake log, voice_report, guide 10)
    Firmware (bench-2):
    - df2301q.h: DF2301Q UART frame build/parse (same format and checksum as DFRobot_DF2301Q v1.0.1),
    Arduino-free; bad/unknown frames returned with raw bytes.
    - bench_main.cpp: UART1 9600 8N1 on GPIO12 (RX, 1k) / GPIO11 (TX); head LED GPIO13; bench-only
    piezo GPIO7 and phototransistor GPIO6 (pin_ldr). Every frame is logged with its own us timestamp
    (asr, notify, ack, vframe, vbad, vjunk, vrx, vtx). Mute + wake 15 s at every boot and on the
    power-on NOTIFY; setWakeTime refresh; learning mode on a 2 s BOOT press (unmute, 200-208 and new
    IDs flagged, re-mute on exi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
    [bench_main.cpp, df2301q.h, logger.py, voice_report.py]
2026-10-24 P5k: voice command layer (rl/commands.py, gesture channel, command atoms, A10 harness)
    Addendum K5-K7 on the P5a stub:
    - rl/commands.py: K5 supervisor as a data table (state x event), float32 numpy; ID table
    (configs/komut_kimlik.json, example), wake/LED, queue depth 1, T1/T2 completion from IMU,
    failed stand/sit rules, fall detection by posture (O/M/K seat-compatible), getup handover,
    BEKLE ramp, gyro bias from a stillness window.
    - task_math: one xp-generic gesture function (Tukey envelope, cut fade, start gate, seated
    beak limit) used by env_cpu, env_mjx and commands.py; command atoms and the pre-sit hold
    segment in sample_segment (same uniforms; CPU/MJX lockstep).
    - eval_tasks: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
2026-10-24 check: same-crossing exception only near the crossing, structure-first rule, exit code
    Verification round 2 decisions (orchestrator D2, D4, D5; spec A1 v3.2):
    - D5: the two tubes of one harness crossing may overlap only around the crossing point:
    disjoint pieces of their intersection whose centre of mass lies within 2 d of the crossing
    (parent frame; right leg mirrored) are not counted, the rest is.
    - D2 (adjacent-pair grid, scope module): a module-external harness contact is not counted
    when the limb's own structure also enters the other module in that pose and, on the linear
    HOME -> pose joint path in 1 degree steps of the largest change, the first module-external
    contact is stru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
2026-10-24 head: head_yaw axial retention (retainer arcs over a ring flange)
    Verification round 2 (orchestrator D3): the head_turn ring only bore on the yaw table (0.3 mm), so
    any upward load on the head (inverted head in getup or after a fall, impacts) and the lifting side
    of the tipping moment went into the MG90S output shaft through the horn screw.
    - head_turn ring gets an outer flange (r 13.5, 1.2 mm; trimmed at +x to stay in the frozen
    head_turn envelope x <= 46).
    - head_tilt gets two PETG retainer arcs on the yaw table (+-y, 80 deg, r 12..17, 2 x M2 each
    into the table, heads sunk); their 1.3 mm lips hold the flange from above with 0.3 mm.
    Lip top 0.3 mm under the MG90S tower (z 134.81); al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
    [head.py, test_head_tr35_fc.py]
2026-10-24 legs: knee harness crossing on the outer (idler) side, filleted routes
    Verification round 2 (orchestrator D1, interface change approved): the frozen knee crossing at
    y 44.5 sat inside the trunk at roll +-20 x pitch +-50 (cable-only contacts) and at pitch 90 no
    inboard route can be contact-free.
    - params.harness.crossings.knee: cross (-40.768, 114.5, -50.639) on the knee axis outside the
    idler M3 head (y 111.8); in/out radial in that plane.
    - params.legs.harness_route: thigh cable climbs from the y 53 layer between the two servos
    (y 61.75), over the thigh top (z 14) to the outer side and down to the knee axis; shin side
    from the crossing radially to a window between the foot and thigh s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
2026-10-24 spec v3.2: A1 harness rules (2 d crossing sphere, structure first, exit code), head <-> hip pair, A2 ceiling
    - A1: the two tubes of one crossing may touch only within 2 d of the crossing point; in the
    adjacent-pair grid a cable contact is not counted when the limb structure touches the other
    module first on the HOME -> pose path; check.py exits 1 on any counted collision.
    - 3.2.2: head <-> hip / hip_cradle self-collision pair (upper bill vs hip cradle at neck -90,
    head_pitch 60; already in addendum K6.4's RL pair list).
    - A2: budget ceilings follow addendum K10 (25.8k / 28.8k TL), as sections 1 and 4 already do.
    Claude-Session: h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
2026-10-24 tests: leg route corners may carry a fillet radius; leg budget line for the outer knee route
    - test_legs_params: route points are [x, y, z] or [x, y, z, r] (route.fillet radius, D1).
    - test_leg_mass_budget: 913.2 -> 916.5 g; the outer knee cable adds 3.1 g (916.3 g). Taken from
    the trunk's slack (trunk measured 653.9 g vs 733.6 g); robot 1776 g x 1.05 = 1865 g <= 1950 g.
    Claude-Session: https://claude.ai/code/session_01DbPtRaJQvPx2ehWht3BtLD
2026-10-24 head: retainer arcs clear of the head_frame deck under head_roll
    The mesh voxel scan (derive_posture caps-scan) flagged the D3 retainer arcs against head_frame at
    head_roll -14 / +13; exact BRep distance was 0 at +16 (the limit): the deck's inner edge comes down
    onto the arcs' outer top. Arcs narrowed to +-25 deg (screws +-15 deg, 0.96 mm from the horn
    pocket) and their outer top edge chamfered (r 15.2 -> 17, 2 mm): 0.85 mm at the +16 limit, 0.05 mm
    at 18, 0.28 mm3 at 19 (MJCF range end, below the A8 1 mm3 threshold); -20 / -23: 3.5 mm. Yaw sweep
    unchanged (>= 0.3 mm to head_turn parts). Test: roll-limit clearance > 0.5 mm.
    Claude-Sess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
    [head.py, test_head_tr35_fc.py]
2026-10-24 p2-entegrasyon: verification round 2 (section 10), open items, plan rows
    Decisions D1-D5 and their implementation, full check.py result after D1 (only the head_yaw
    crossing counts), the head_yaw crossing analysis handed to P2d, the D3 retainer, the check.py
    rules, budgets, current results. acik-konular: P2d and P3 items from round 2, real G-CAD mass.
    plan: P2a/P2b/P2c merged rows.
    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
2026-10-24 P5b-on: tr35 MJCF from the wave-2 CAD, constants re-derived, tests on the real scene
    Fast path to the P7 pre-release trainings (user decision): P5b items 1-3 on the current CAD
    before P2d/P3 (head +30 g and the P3 MJCF pairs re-derive later).
    - build/tr35_b2/sim: openduck.xml, scene.xml, meshes from main (C.SCENE_PATHS, launcher
    TR35_FILES).
    - rl/derived/tr35_b2.json from it (derive + check 0): HOME family (keyframe COM 19.8 mm behind
    the feet), H_HOME 0.1519, seat pitch -47.5 (hp 85 / kn 71 / an 33.5), HEAD_SIT neck -102 /
    head_pitch -22, KNEE cap 77, 46 self-collision pairs.
    - derive_posture.candidate_pairs: spec 3.2.2 v3.2 pairs (jaw <-> neck, head <-> hip / hip_cradle).
    - Tests use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
    [ads1115_1.stl, ads1115_2.stl, aux_bus_cap.stl, battery_4s_lipo.stl, battery_door.stl, battery_lead_wiring.stl, battery_strap.stl, belly_duct.stl]
2026-10-24 P5b-on: CPU/MJX gesture+atom lockstep separates PWM rounding ties and contact mismatches; notes
    test_tr35_lockstep_cpu_mjx_gestures_atoms on the real CAD diverged at single env-steps:
    - quantize_pwm (round(ctrl / res)): a value at a rounding boundary within float32 precision rounds
    one PWM count apart in CPU (float64) and MJX (float32), e.g. 0.072 deg on a DS (23 vs 24 counts);
    - contact transitions where the two engines end the step with different active contact counts.
    Gesture state, segment and ctrl stay exact every step; ties (<= 4, seen 3) and contact mismatches
    (<= 28 of 280, seen 1) are counted and their env-step skipped for reward/obs; elsewhere reward
    3.5e-5 and critic 1.4e-4.
    doc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
2026-10-24 RunPod launcher: --datacenter and --min-download-mbps (REST v1)
    Pods can be pinned to nearby datacenters in priority order and to hosts
    with a minimum download speed. REST v2 has no such fields, so either
    option switches the request to v1 (dataCenterIds, dataCenterPriority
    custom, minDownloadMbps). Request bodies without them are unchanged.
    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
2026-10-24 P7 tuning hook: OPENDUCK_TUNE reward overrides, launcher --env
    The first P7 walk run (2e8 steps) learned a 3 Hz bang-bang tremor with
    leg servos at stall a third of the time, and main pinned both hip
    yaw/roll servos at stall. The tr35 torque weights are documented as
    initial values to be tuned in P7. OPENDUCK_TUNE (JSON, per task) now
    overrides named reward weights so variants can be trained in parallel
    without code changes; the values used are recorded as TUNE in the run's
    config.json. Unknown tasks or terms raise. The launcher passes extra pod
    environment variables with --env KEY=VALUE.
    Claude-Session: https://claude.ai/code/session_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
2026-10-24 P7 notes: main probe result (sit/stand learned, no forward walk, hip yaw co-contraction)
    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
2026-11-06 Colab GPU training tools + first getup run notes (failed: action blow-up)
    tools/colab/: setup (repo + pinned MJX venv), blocking re-runnable supervisor cell,
    keeper (Colab reclaims the VM ~18-20 min after the last connected kernel client),
    checkpoint sync. G4 (RTX PRO 6000): walk 197k SPS, getup 25.3k SPS.
    docs p7-colab.md: getup 1e9 on G4 learned nothing (success 0, servo saturation
    ~99% of steps). Raw policy actions reach 1e2-1e6 with action_clip 1.0, so every
    action is clipped (bang-bang); the same magnitudes explain the ONNX diff growing
    from 2e-6 to 0.48. Fix pending (raw-action penalty / tanh / mean bound).
